koffja/Beanlens/docs/hardware/revision-v4.11/README.md

# BeanLens V4.11：MVP对射与电源选型、连续PP槽体

2026-10-17。用户确认：**前壁连续，铝闸片从后方关闭，闭合前缘进入前壁内侧承接槽**。本次在V4.10机械方案上改用DFRobot SEN0503对射和YU2405主适配器；保留5V侧TPS5450候选与6V侧UBEC5A/6V。它是样机结构方案，尚未实物或电气验收。

## 文件与版本

- [六页图和闸片开合演示](beanlens-hopper-gate-v4.11.html)：固定、板厚、连续前壁/槽内刷、TPS比较、接线拓扑。
- [采购表](../procurement-v4.11/beanlens-procurement-v4.11.html) / [改动物料尺寸](changed-cuts-v4.11.csv) / [结构数据](design-v4.11.json)。
- [六页A3图册](../../../output/pdf/beanlens-hopper-gate-v4.11-20261017.pdf)。
- 原V4.8机架、9木板与双屏位置不变。V4.9四片主斗外面尺寸、Z440上口和Z298.3底口不变；新增刷孔/分道片，旧V4.8八片模板仍不可混用。V4.9的POM下座被本版PP连续槽体主方案替换。

## 本次MVP选型（2026-10-17）

- **PH01改DFRobot SEN0503，50cm对射，一组收发对**。原厂3–5V，50cm是在5V下的距离，3.3V下标称20cm；本机取5V供电。外形20×10×9、线250mm、响应约2ms。国内官方商城参考15元/对（检索日2026-10-17），不是用户成交价。
- 输出原厂写NPN常开；没有完整内部输出图和本机实测，**遮挡有效电平暂记null**，不能照搬原2167的遮挡LOW。按NPN下拉接口拟定10k上拉3.3V、1k串GPIO20；先断开GPIO，测A节点两状态，确认在3.3V输入域并记录极性后再接板。若出现5V，停止接板、核查实际输出，1k不是降压器。
- **A07改YU2405，24V/5A/120W**，按用户指定为MVP主方案。厂牌、批次、插头/极性、交流入口/线是否随附、认证与保护实效尚无对应实物资料。不同卖家的同名型号不能互相替代证明，不把航嘉/明纬资料套到YU2405；不填虚构尺寸、证书或价格。5.5×2.5mm仅作P03母座候选，实际核后配。
- 不扩大工作范围：5V TPS5450整板仍待SKU，6V舵机仍为UBEC5A/6V；功率预算持续56.5W/短峰71.5W是按原负载和保守效率计算，24V容量相同所以数值不变，不等于YU2405已试载。
- 机械仍沿用V4.10，SEN0503头部外形资料更新；安装朝向/光轴、支架孔位与Z277光束仍需实物。不能仅按9mm厚度宣称光电/侧封片无干涉。
- 图6补逐线连接，图5更新主适配器和传感器标注。原Adafruit/Huntkey只留历史，不列当前主采购。

### TB端子对应

TB-A的1/2/3分别给灯、5V降压、6V UBEC正输入，各经过对应保险；3位桥只连1–2–3。4/5/6是其返回端，另一段3位桥只连4–5–6。TB-B的1=5V+、2=5V返回、3=6V+、4=6V返回、5/6空，不装桥。相邻格本来不通，同一格上下螺钉才通；不能6位整条短接。C6信号地共参考，舵机大电流仍从独立6V返回，不能经过C6板针。

## TPS5450是否比XL4016合理

**优先审核TPS5450成品板是合理的，不能只按芯片名字直接定型。** TPS5450推荐5.5–36V、芯片5A连续/6A峰值、500kHz，原厂明确软启动、欠压、过流、过压及过温保护。XL4016现行Rev1.6推荐8–36V、180kHz，列12A芯片能力及过流/短路/过温等。两者40V都是绝对上限，不是允许长期工作电压。TPS5450不是因为型号而自动具备更大输出电流，500kHz也不等于实际板的纹波必然更低。

逻辑侧需要24→5V、4A连续预算；TPS5450芯片理论范围覆盖，整板温升和压降必须过关。**舵机侧已由用户确认用UBEC5A/6V，不再列TPS5450为主方案。** 推荐可核原厂型号：好盈HOBBYWING UBEC5A / 30607000 / 2–8S版，50×17×10mm，原厂标称持续5A，设置6.0V。24V在2–8S锂电池对应电压范围内；核所购标签一致，不能换成仅支持2–3S的同名BEC。实际负载仍按6V/3A持续目标、5A短峰预算验收，不因原厂15A瞬间标称提高本机预算。TPS的5A能力不能替代外置二极管、电感、电容、铜皮与PowerPAD散热焊接的设计。按TI简化公式及典型0.11Ω导通参数，24→5V/4A芯片损耗约1.57W，尚未算外部损耗；小板密闭安装不能套用参考板热阻。计算为4²×0.11×5/24 +24×4×0.01 +24×0.01≈1.57W，不是实测。

TPS的OVP主要通过关闭高侧开关限制正常调节过程的过冲；如果功率开关本身短路，它不是一道独立断开故障电压的屏障。不能承诺“TPS一定不烧主板”。两个方案都是非隔离降压。反接保护、保险、接地与接口区分按整板和外部接线检查。没有模块原理图、完整型号和测试数据前，A08标为**5V TPS5450优选候选/暂缓整板定型**；A17主方案改为**UBEC5A/6V，好盈30607000候选**；XL4016另列备选。主适配器按本次MVP改YU2405，24V容量与保险（主4A、灯2A、5V输入2A、6V输入3A）、分路返回与信号电压不变。

采购询问模板（仅5V逻辑板）：需要成品TPS5450模块一块，输入24V，输出5.00V、4A连续预算；请提供整板品牌/SKU、输出设定方式、尺寸与孔位、24V输入工况温升及纹波、负载阶跃、芯片来源和保护说明。不要购买裸TPS5450DDA芯片代替模块。新电源总价待5V板及UBEC报价，旧200–370估价不直接沿用。

UBEC接法：TB-A 3经3A输入保险 → UBEC IN+；TB-A 6 → UBEC IN−。UBEC OUT+/OUT− → TB-B 3/4 → 舵机6V/GND；舵机PWM仍来自C6 GPIO2。先断电，按原厂说明把远离电容的两插针用跳帽设为6.0V，上电实测再接舵机；此跳帽位置只适用该好盈型号，其他型号不能照抄。不得选7.4V；UBEC输出插头是供电，不是PWM，不能接GPIO或5V主板电源。原厂线径与插头额定另外核对，新增0.75mm²线段不能证明原线/触点已能承载全5A；不要用杜邦线作舵机电源转接。

UBEC具有过流、输出短路及过温保护，金属罩有助散热/降低干扰；保护恢复会重新供电，不等于硬件急停或保证关闸。仍与称重/相机线分开布线，按空载舵机、带载压降/温升与实际动作测试验收。原厂5A与15A分别为持续/瞬间标称，不是用户这只MG996R的实测电流。

## 料斗到底如何固定

四只F13金属角片先用M5/T螺母锁在顶框内侧槽。顶PP3托环外形176×196、136方孔，位置X22/Y22/Z440；PP2斗的四边顶端与托环下侧焊为一体。将整组从上方放到四托片上，托环底Z440，顶Z443；再用4颗M3×12、φ9大垫片和螺母固定，另2套备用。

四支承为25×25×2角铝裁宽20，竖外脚22、横外脚14；全局支承起点(20,75,438)/(20,145,438)/(186,75,438)/(186,145,438)。PP长孔中心(28.5,85)/(28.5,155)/(191.5,85)/(191.5,155)，孔3.5×7沿X。根部圆角按实物检查，PP支点处局部2×2倒角沿20长避R仅是候选修配，不能任意削薄大面积。

受力：上斗 → PP焊缝 → PP3托环 → 四金属托片 → M5/T螺母 → 黑2020；下方固定槽体还由G21接G11定位，不能假定所有重量只走顶托环。先把下槽盒/导轨共用底座装平，再让顶环坐实并锁紧，不能用上下螺钉硬拉焊件找平。托片竖脚M5孔建议5.5×8竖长孔，孔中心相对竖脚底12mm（名义Z450），约±1.25mm调节；M5加φ12大垫片，4用2备，按实物槽型核螺钉长度。木板不是料斗承力支座。PP2与PP3厚薄焊先试片；托环平整、焊缝拉脱、长期蠕变与托片单螺钉转动需静载验证。1kg为原载荷目标，不等于现有约1.22L料斗能装1kg生豆；用实际豆样验证容量，不能用板厚代替容量计算。

## “法向板厚”是什么

“法向”只是**垂直于板面**的方向。2mm PP板就是卡尺夹住两面读到2mm。板斜放后，从机器水平方向横着量，两面的截距会大于2mm；本斗前后壁约2.183mm。板没有变厚，只是量的方向变了。外口尺寸用实际板厚换算，不能在内口每边任意加2mm就把斜壁外形算对。图中的示意线加粗不代表购买更厚板。

## 为什么原来用了POM；现在改哪里

POM有较好的滑动、耐磨、刚性和加工稳定性，原来作为可拆滑座有理由。10mm指一块板沿落豆方向的厚度，5个14×12孔贯通这10mm，不是每槽宽10mm。厚板让孔缘有支承、容易加工，不等于更容易逐粒送料；原方案没有充分安排刷排。

连续焊接前壁优先采用PP-H固定槽体：上座仍PP6 140×30，下座改PP10 140×24，前脸均Y105，孔起点局部Y9。下座后端Y129，保持不碰从Y132起的导轨。两端隔距条10×24×2.3；前封片140×18.3×2位于Y103–105，跨过Z280–298.3；两侧封片32×15.3×2位于X38–40和180–182，Z283–298.3；底边高于原光电头名义顶Z282，仍按实物留间隙。固定件焊成前面/两侧连续的U形封闭体，只向后留闸片进出口。

关闭时闸片前缘Y112.5，进入Y105–114的前承接位，覆盖孔前缘1.5mm；打开时前缘Y127.5，退过孔尾126再多1.5mm。整片前缘同时横跨5槽。不能靠撞前壁当限位。闸片Z290–292，闸缝Z290–292.3，名义总隙0.3；按实物厚度和平整度试配。焊接固定件时闸片、滑轨和PBT都拆下，用量规控制间隙，冷却后才装。薄PP封片焊到PP10须先练厚薄件，防薄壁烧穿和上座翘曲。

PP滑动/磨损性能不能直接按POM算；先手推测阻，再空载舵机。手推不顺先修平整和间隙，不加大舵机力。POM保留为另一个可拆螺接槽盒版本备选，不能热风焊进当前PP框替换。固定槽体整体焊接后，可从后方退闸片清理孔与前盲承接位；若积屑不能彻底清除，应改为可拆槽盒再带豆联调。

## PBT刷：在闸片上方的五槽入口安装

保留原主斗形状，在斗底内加4片PP3短分道片，Z298.3–318.3，YZ面梯形上深29.502/下深12/高20，X厚3，起点X83/100/117/134。下端分别焊在五孔上座的4条肋上，前后端配斜斗面。这样五槽入口向上延伸20mm，不缩短主斗；上方外侧两槽随斗面略张开，孔口仍为14×12。

每槽前后各一段PBT，共10段；从原“左右塞进薄隔肋”的含糊表述改为**前后两排刷盒**。基条候选PP12×6×3，毛簇有效宽10，PBT丝径0.10–0.15，自由毛长14mm，向水平下方30°。毛根Z315，毛尖Z308，距闸缝顶约15.7mm。毛尖在各自Z高度的斜斗内面侵入先取1.5mm，不是把14mm毛长全塞进12mm孔深。

初始前毛根Y约99.13、后毛根Y约140.87，前后可调±2mm。前后斗面各5个11×4圆角毛槽，中心X76/93/110/127/144，装机中心Z310；4mm按斜面量。毛束实际散开、角度、PP厚度和焊筋需要样件修孔，不能凭尺寸直接批量开孔。圆角去毛刺，检查来回摩擦不刮断PBT。不能把裸毛直接粘在PP上或对着已安装刷毛热焊。

两条PP3载条110×10、两条PP2压条110×8夹持成品植毛小段，段间及两端设12块4×6×3 PP垫块（每排6），压条开5个11×3出毛窗；窗心X同毛簇，Z约314.4，孔口去毛刺，不夹死毛根。载条在基条背面，压条在出毛面；14mm毛长包含经窗穿出的部分。每排6个M2候选夹持点X59/84.5/101.5/118.5/135.5/161；M2×12起点，12用4备，实量堆叠后定。4只外置PP小托架给前后调节。刷盒外侧加可拆PP防豆背罩，候选包络110×20×16每排一只，按斜面纸样配形；螺母、端头、可能的植毛锚固均在豆路外且封闭。刷盒和盖的孔位不是已冻结加工图，先询价成品样刷再定。

先无刷通过豆样，再逐步加刷验证；取低侵入量，观察正常豆、碎豆、灰屑是否架桥、脱毛或增加破损。关闸扫过的平面不能碰到任何PBT毛尖。刷子不保证单豆分离，不能据此推导计数准确率或五槽吞吐量。

## 验证边界

本包有尺寸和几何一致性检查、网页与PDF排版检查，未做负载、焊接、脱毛、带豆、称重或光学实测。G10球头耳实际高度、G20后退片罩与后刷盒的窗口及全行程仍需纸样/实物联合试配；不要把简单方罩直接扣在球头上。原IR光束Z277与脚座避让仍未验收；此次刷排位于Z308以上，不以随意下移光电来腾位置。仍按无执行器→空载→单槽→五槽顺序验收，卡豆超时不持续加力。

## 原厂资料

- [TI TPS5450，Rev.E](https://www.ti.com/lit/ds/symlink/tps5450.pdf)：5A/6A、保护、布局及损耗简化公式；不是淘宝整板证明。
- [XLSEMI XL4016，Rev1.6](https://www.xlsemi.com/datasheet/XL4016-EN.pdf)：推荐8–36V、180kHz、芯片12A条目；整板另验。
- [好盈UBEC5A原厂中文说明书](https://oss.hobbywing.com/pdf/pdfcn/UBEC5Acn.pdf)：2–8S、5/6/7.4V设置、持续5A及保护；本机选6V档。
- [Ensinger材料目录](https://www.ensingerplastics.com/-/media/Ensinger/Files/Document%20Teaser%20Files/Brochures/Shapes/Stock%20Shapes-catalog-en-2024)：POM滑动、耐磨和加工特性。所购PP/POM/PBT的食品接触资料必须对应具体牌号，不能由材料简称推定。
