koffja/Beanlens/docs/hardware/PROCUREMENT-AUDIT-20261012.md

# V4.5采购核查与计算修订

2026-10-12。已核查原V4.4的35项采购记录，拆分为83项可查物料/备选；不是83项全部要买。当前状态仍是拟定选型，未采购、加工或实物验收。

主入口：[可筛选采购表](procurement-v4.5/beanlens-procurement-v4.5.html) · [CSV](procurement-v4.5/beanlens-bom-v4.5.csv) · [JSON数据源](procurement-v4.5/beanlens-bom-v4.5.json)。页面末尾有旧35项逐项处理与新编号对照。只改JSON，再运行同目录生成器即可同步HTML/CSV。

## 本次明确的修正

- 原对射器记录为用户提供的山大斯 **B3F-20C1**，不猜其输出。主方案推荐 **Adafruit 2167**，5V供电、10kΩ信号上拉3.3V；工业光耦路径列为互斥备选。详见[对射说明](BEAM-SENSOR-20261012.md)。
- 相机记录为用户提供的 **GC2093-M12-90度无畸变**。这还不是已核对的PCB完整料号；BOX兼容性、排线针数/方向、90°定义、近焦及IR-cut需确认，不能随意补一个排线型号。
- 称重候选改为 **Autoda HJ-AZ4-3kg、103元**。输出类型、内部敏感元件和包装内支架/平台未知，保留用户型号，不用猜测代替图纸。旧55元裸件/105元带架报价由此替代。
- 旧B09“薄POM闸片/M3连杆”改为2mm铝闸片、M4双球头、双导轨与封闭槽盒。**新增120×30×3mm滑架转接板**：10×10角铝的10mm脚宽无法覆盖MGN9H参考16mm前后孔距，不能独自完成滑块安装。角铝保留为加强及闸片连接件。
- 旧配电、灯罩、支架、限位、滤波和紧固件打包行拆开。给出实际厂商型号或可采购的材料/尺寸标准；PCB孔位、灯带SKU等未知项明确暂缓，避免“补齐型号”反而买错。

## 闸门复算

### 运动几何

舵臂半径r=16mm、球心距L=60mm。居中共面机构的滑块坐标为：

`b(θ)=r·sinθ+sqrt(L²−r²·cos²θ)`。

端点取±asin(15/32)=**±27.9531869°**，两端sqrt项相同，因此行程恰为15mm。总相对转角55.906°；这不是舵机PWM的绝对命令角。12mm净豆路＋关端1.5mm覆盖＋开端1.5mm退让＝15mm。槽深、防漏间隙及退片袋仍需纸样定型。

两只球头的球心至螺纹入口暂按h=24.4mm、30mm牙条：L=2h+30−2e，调到L60得到**每端旋入e=9.4mm、外露11.2mm**；小于参考13mm螺纹深。两个普通M4六角并紧螺母约需6.4mm，名义可容纳。网页标题24.1与图24.4不同，实际以收到批次量测，不能把60mm球心距误买成60mm牙条。

MGN9H参考长39.9mm；15mm行程、两端各10mm端部余量，最低几何轨长39.9+15+20=**74.9mm**，选择100mm。滑块孔距参考15×16mm、每块四孔，两轨各一块，勿重复另买两块。120×30×3mm转接毛坯可覆盖孔阵列，轨中心距约90mm起试。具体端孔、螺纹深、螺钉啮合与润滑隔离按供货图核验。

### 1kg装豆与板材

按全部1kg豆形成约9.81N竖向静载，闸片110×45×2mm，密度2700kg/m³、弹性模量70GPa（沿用配件文材料参考值）。把110mm跨度简化成宽45mm、厚2mm简支梁，I=bt³/12=30mm⁴：均布载荷挠度约**0.081mm**；跨中集中梁载挠度约**0.130mm**、名义弯曲应力约**9.0MPa**。板自重约**26.73g**。

这是名义梁模型，未计孔、装配翘曲、局部豆接触、动态冲击与夹豆。它支持“2mm铝板作首样候选”，不能作为整机承重合格证明。固定槽盒与POM支承框承担竖向支承，滑架约束偏摆；舵机、球头和牙条负责水平推拉，不悬吊料斗。总豆重乘摩擦系数不能代表夹豆推力，亦不能用MG996R堵转扭矩证明关闸一定成功。

MG996R先保留，50Hz下逐步改变目标脉宽，关闸2–4秒作为试样起点。更换高扭矩舵机仍不能解决左右偏摆或夹豆。若样机需要可确认的位置与阻力控制，再评估带反馈、限流的直线执行器；单用更强舵机可能更容易夹坏豆。详见[槽内缓关说明](GATE-ENCLOSED-SLOW-CLOSE-20261012.md)。

## 称重与电源纠错

[Zemic L6J1原厂表](https://www.zemiceurope.com/media/Documentation/L6J1_Datasheet.pdf)为0.9±0.1mV/V、推荐激励5–10V，C2综合误差±0.028%FS。1kg对应±0.28g，不能直接保证本项目净0–500g±0.1g目标；也不能把旧2mV/V、3V示例套此型号。NAU7802的24位只是转换分辨率，不是秤的误差证明。

当前拟定3.3V供电、内部VDDA约3.0V的ADC路径与L6J1推荐激励不一致，暂停把两件当作已匹配采购组合。也不要自行给桥接5V：必须同时核对ADC输入范围、参考和模块原理图。HJ-AZ4若是数字称重组件，可能不需要NAU7802；若是裸桥则还需核输出与激励，暂不重复下单。

料斗1kg装豆量、原称台1kg**毛载荷**、净500g误差验收是三个数。1kg豆＋平台/盒会超过1kg传感器额定容量。若改3kg称台，可容纳这部分重量但不能沿用1kg灵敏度或±0.1g结论；一次收1kg也超出当前净500g验收范围。暂按分批收集，容量和精度选择待组件资料确定。

170×180×2mm铝活动台板名义165.24g，若活动件总目标≤250g，只留约84.8g给盒与连接件，实物须称。参考砝码补100/200/50/500g四件，350g由前三件的校准质量组合，组合参考不确定度建议≤0.03g；不能用待测秤给砝码自证质量。

电源候选具体化为GST120A24-P1M（24V5A120W）、Pololu D36V50F5（#4091，5V）与D36V50F6（#4092，6V）。功率预算仍为灯8W＋传感器预留1W＋20W/0.85＋18W/0.85＝**53.7W**；舵机短时5A时约**67.8W**。2167在5V支路内，1W另保留作保守余量，不重复声称实际耗电。模块持续电流受输入压差、散热影响，4A/3A/短时5A目标未测；120W适配器不证明下游模块达标。

## 采购和加工顺序

1. 先买/核验板卡、相机、舵机及参考标准件，收到后量花键、球头、导轨孔位和排线。
2. 用1:1纸样摆放五槽、转接板、两轨、连杆、舵机支架，同时核后摄视锥。槽宽合计5×14=70mm，四隔板若3mm另占12mm，外宽110mm剩28mm分配侧壁/结构区；旧6mm两侧边不能直接闭合此尺寸链。
3. 纸样通过后加工毛坯轮廓、槽缝与孔位。板材尺寸是毛坯，不是最终开孔图；导轨底座不能整片挡住落豆口，封闭退片袋须留可拆清洁结构。
4. 手推全行程应顺滑，再空载舵机、单槽带豆、五槽联调。验证1kg载荷变形、缓关卡豆、限位超时及失联撤销送料，记录证据。无法顺滑则先调平行/支承，不能用舵机硬拉矫正。

型材18段净长合计4.4m，未含锯缝/损耗。紧固件数量为首样估量，孔位冻结后再核。

## 金额与版本

只保留三项用户已报价：BOX257元＋两套相机114.32元＋MG996R15.58元＝**386.90元**，不表示已经付款或收货。Autoda候选103元另列；若最终选它，已知报价合计489.90元，仍缺大量报价。

旧790.90元混合了旧打包规划额度，**不作为新方案总价**。未知价格保持空值，不能当0元；也未按海外美元报价折算人民币。新增导轨、加工、转接板、封闭槽盒、运费工具等均需询价，因此新总价未确定。

旧PDF、独立SVG/PNG、V4.4 BOM和ZIP保留为历史快照；当前手册、基线、动画与V4.5采购入口已同步新增决定，不能按旧图直接下单加工。

## 本次文档检查

已检查83行JSON/CSV一致、35项旧表映射、报价小计、计算复算和本地链接；浏览器验证采购搜索/筛选/重置、手机横向滚动、手册主题/组装勾选/图纸放大、动画开关端点/恒定杆长/模拟故障。结果见[验证记录](procurement-v4.5/validation-20261012.json)。这是文档与浏览器检查，没有上板、加工或带豆验收。

## 2026-10-13 装配图增量

原83项记录是2026-10-12快照，当前新增F08后为84项。装配图保留18段/4.40m型材与一张600方海洋板，补F02为28角码使用、32购买含备；F03有净裁切排版、托耳修为40×30×6；F06明确三片托板毛坯；F07明确遮光底板；G08轨距94为布局提案。新增F08面板/托耳穿板螺钉及小角片，详见[图册与说明](assembly-v4.5/README.md)。旧验证记录仅覆盖记录时的旧字节，新图检查另留记录。
