koffja/Beanlens/docs/hardware/frame-v4.6/IMAGE-PROMPT-BLACK.md

# 黑色欧标效果图生成记录

2026-10-15，内置 image_gen。结构参考是由同一套坐标生成的[成品/裸框对照](black-frame-comparison-v4.6.svg)，不再使用原银色概念图作为比例依据。

输出：[黑色外观参考](beanlens-frame-v4.6-black-concept.png)。AI图用于材料与外观，准确尺寸、料斗高度及梁数由共享模型和尺寸图控制。旧银色图保留为历史参考，当前页面已撤下。

```text
Use case: sketch-to-render / industrial product mockup. The attached engineering comparison is the STRUCTURAL AUTHORITY, not a loose style reference. Create a refined studio 3D materials rendering of these exact TWO views side-by-side: left the assembled BeanLens device, right its bare extrusion frame. CRITICAL: preserve the same camera, identical model scale, overall silhouettes, vertical beam levels, and top/bottom alignment from the reference. Do not independently resize the two machines. This image is intended to correct a previous image whose paired views were inconsistent.

Geometry in millimeters: outer frame220 wide240 deep460 high, four UNINTERRUPTED black anodized European2020 T-slot vertical posts fromZ0 to460. Top horizontal rails Z440..460, bottom railsZ0..20, intermediate hopper frameZ304..324, two camera support crossbarsZ221.25..241.25.18 extrusion members exactly. Black compact standard INTERNAL90degree L brackets only, not corner cubes. Frame-only view must show these same exact rail heights and should keep a subtle amber dashed transparent box marking the hopper footprint154×154 and its height110 fromZ330 to440 (this box is a reference outline, not extra beams). Hopper support relation: midbeam top324 +6mm plywood ears =hopperbottom330, hopperheight110 =top440, then20mm upper extrusion reaches460. Do not show a hopper130/150mm tall or an enlarged top compartment. Both left and right show the same Z440 and Z324 locations.

Assembled machine: follow the reference's actual exterior6mm marine plywood panel construction. ONE uninterrupted pale birch front fascia fromZ200 to440 and ONE right panel same heights; these exterior panels overlay the front/right post faces in that height region. NO invented horizontal black bar across the front wooden fascia at midframe height: that midbeam is INSIDE behind the panel. Do not invent a separate upper wooden band or taller hopper. The154mm square wood hopper is inset within the outer frame, PP liner top opening140 square atZ440, leaving small gaps around the hopper. Small amount of green coffee beans only inside white PP liner; do not fill entire220×240 frame top with beans. Small black2.4inch front screen case64mmwide centered atZ370, two16mm round silver buttons centeredZ310, small side black status display. Lower open bay has translucent PP collection bin160×170×125 atZ45 on a thin independently supported metal weighing plate; no bathroom scale. Four very short black rubber feet outside the460mm frame height may be shown; match both views. Fine black T-slot channels visible, natural pale plywood grain, accurate fitted appearance, warm-neutral off-white studio background. Realistic engineering product rendering, similar orthographic isometric projection as reference, not dramatic perspective. Minimal labels only 'BeanLens' and 'V4.6 / BLACK2020'. Preserve background whitespace and machine size/alignment of reference. No dimensions added or fake measurement readouts. No image reference title/footer text needs to be reproduced.
```
