koffja/Beanlens/docs/handoff/HANDOFF-20261012.md

> **2026-10-22增量：H3-P4打印件整机装配**。新增`docs/hardware/hackathon-h3/assembly-p4/`整机组装／爆炸／14连接特写、10页A3 PDF、78行BOM／采购／紧固／裁切／孔位CSV、18份1:1 SVG、机械参考STEP和独立P4基线。9打印实体及P3切片不变；顶环／底板用平片，底板Z22，屏承板Y20，角铝分别连接木板／柱槽；保留P2后梁与承托避让窗。前U片贴盖外缘，去旧上PP管；遮光片开木条槽，右侧／后背景避舵机。13段型材库存足够，M3总79／M5总60，M2相机／开关另列；原料、加工子件和备件不重购。425旧文件哈希保留，未改固件、训练、用户Excel或提交推送。当前比赛机械优先P4，电气GPIO／供电沿用H3；实物孔、承载、限位和双摄仍未验收。

> **2026-10-22增量：H3拓竹专用打印P3**。用户确认A1／X2D／X1 Carbon／P2S／H2D，0.4mm标准喷嘴、Bambu PETG HF、纹理PEI。新增`printing-bambu-p3/`离线选盘总览、30个实际切片`.gcode.3mf`（5机型×6盘）、排产／估时／用料CSV、配置／源与日志、原P1/P2 ZIP。9主件＋试片尺寸不变，优化摆盘、5–6墙、速度／10mm³/s流量、下斗外侧贴合普通支撑、舵机架承梁支撑；00先试配，分机交叉试插。Studio 02.08.02.61主机检查，未实际打印／目标固件验证，也未发送或启动设备。P1/P2共148文件哈希保留；P2承托片／铝板／后横梁装配修订仍必需；未动固件、训练环境或提交推送。

> **2026-10-22增量：H3-P2支架打印与装配修订**。新增`docs/hardware/hackathon-h3/printing-p2/`：舵机架、双摄座、开关限位座5件＋小旗片1件，STL/3MF/STEP、CAD源、1:1孔图、采购修配差异与离线3D预览。实体检查发现旧铝板碰后立柱、旧承托片穿舵机；P2将60方铝板移至X153/Y159，承托片改PP3 68×80并开20×30移动紧固件窗，新增180mm黑2020后横梁（可裁库存400余料），后闸盒螺栓候选M3×25。舵机轴心与双摄光轴不变；旗片替换旧件，SS-01GL按原厂9.5孔距配M2。实物舵机耳孔／PCB孔距／开关触发仍待纸样与手动实配；CAD检查不代表实打／承载。H3/P1原件保留，未动固件、训练环境、用户bringup或提交推送。

> **2026-10-22增量：H3-P1漏斗打印文件**。用户要求上/下漏斗3D打印，确认平台220×220mm或更大。新增`docs/hardware/hackathon-h3/printing-p1/`：上斗身、上接座、下接豆斗3件STL/3MF/STEP，试配片、参数化CadQuery源、装配STEP与预览/ZIP。保留原H3滑闸、下短管及相机位置；P1仅新增可拆安装，见README孔位/紧固件差异。仅主机CAD/网格检查，未实打；CAD依赖安装在/tmp独立环境，未动用户训练环境/固件或PP焊接版原件。

> **2026-10-21增量：H3恢复原豆路**。用户否定H2上下摄透片方向，要求顶入豆、水平相向双摄，只简化五槽和闸门。新增`docs/hardware/hackathon-h3/`独立拟真运行/整机/拆解HTML、剖面、36组BOM/差异/裁切、接线、`config/hardware-hackathon-h3.json`。单槽铝抽拉闸29.4×82×2，R16单舵臂＋50mm球心距双球头杆；仍人工单颗，先采集再开闸，下方落豆窗抓拍。短曝光/双流/漏拍/配对均待实机；本轮只改设计资料。H1/H2/完整版保留，用户firmware/k230d/bringup不动。入口与验收见H3 README，旧PDF不称H3图册。

> **2026-10-21 增量：双摄比赛版H2**：用户要求另给双摄版本，新增 `docs/hardware/hackathon-h2/`（拟真离线HTML/GIF、中线光路剖面、接线SVG、34组BOM/16组差异、裁切表、设计数据）及独立H2基线。保留单槽/人工单颗/静拍/BOX控制MG996R，无C6/称重/IR/PBT/第二屏。PP短导豆口＋可拆7101玻璃托片，上下垂直两摄，工作板/PP底座开窗；出口后接豆斜槽与防撞片避开下摄。静止先A后B绑定一颗cycle_id，不宣称同步或全表面。型材仍足够，灯2增4，49.25W持续/64.25W短峰为预算。20项设计/18项浏览器检查通过，H1及完整版字节保留；真实透片成像、像素密度、双CSI运行/内存/配对模型/机械/供电未验。没有改固件、训练、用户bringup或提交推送。

> **2026-10-21 增量：H1拟真教学动画**：新增 `docs/hardware/hackathon-h1/beanlens-realistic-h1.html`（离线单文件）与 `realistic/` 源文件，按可辨认外形重建MG996R、25T直臂、PP槽/挡片、GC2093、BOX、黑2020及木平台；有特写/整机/分件、时间轴与动画预览。外形不是厂商CAD，关限位示意移到舵机侧避开ROI，转接板叠放及垫片示意避免重合；这些孔位/触发接触仍待实配，未更新旧加工图或采购项。预设分类/时长不代表实机，未改固件或用户bringup，未提交推送。

> **2026-10-19 增量：比赛精简版H1**：用户确认单摄/单槽/单K230D BOX，人工逐颗、停豆拍照、MG996R开闸放走。另建`docs/hardware/hackathon-h1/`：30组精简BOM/CSV、裁切表、50对象交互爆炸、6页接线/尺寸PDF及HTML流程动画。采用短固定PP斜槽＋轻侧摆挡片，删长滑闸/导轨/球头杆；无C6/称重/IR/PBT/第二屏/网络。新`config/hardware-hackathon-h1.json`从BOX原理图核候选GPIO25/PWM5（J10-1）、GPIO24/23限位、GPIO22经NPN控AHCT125使能；KEY0/1为34/35。供电保留YU2405/TPS5V候选/UBEC6V，5V单向缓冲与舵机独立回流。完整版目录/基线保留原样；新用户`firmware/k230d/bringup/`未修改。资料与模拟不代表模型上板、固件或机械验收；未提交推送。先做固定ROI真实kmodel推理，再空载与10次手投循环。

> **2026-10-17 增量 V4.12（当前整机入口）**：新增`docs/hardware/assembly-v4.12/`整机组装/爆炸109对象、12页A3 PDF、型材/木板CSV与完整流程`beanlens-operation-v4.12.html`。整机移除V4.8旧小过渡斗/双法兰/叠片，集成V4.11连续PP/PBT、SEN0503、机外YU2405及低压配电盒；双屏固定/9木板/黑框保留。双屏净空用连续斗重算前15.44/侧14.44名义mm。BOM仍V4.11共114项，无新增采购。流程含握手/人工放盒去皮/有限GRANT/开闸/双摄配对去重/缓关/尾流/静态称重/本地记录及停止、卡豆、失联未完成分支；示例24颗/4.8g和时长不代表实测。旧整机入口加最新链接；未修改固件、用户Excel或厂商原件，未提交推送。

> **2026-10-17 增量 V4.11（优先于下文旧选型）**：用户为MVP指定DFRobot 50cm对射，核对为SEN0503（50cm@5V/20cm@3.3V），主电源改YU2405 24V5A/120W。新版[六页图/接线](../hardware/revision-v4.11/beanlens-hopper-gate-v4.11.html)、[114项BOM](../hardware/procurement-v4.11/beanlens-procurement-v4.11.html)及CSV/A3 PDF已更新；基线、对射指南、BRINGUP同步。SEN0503供5V，拟10k上拉3.3V/1k串GPIO20；遮挡电平暂null，先断开GPIO测两状态，不能沿用2167的LOW。YU2405厂牌/插头/极性/随附AC线待实物，不套航嘉认证/尺寸。5V TPS整板候选、6V UBEC5A/6V及原机械/框架/双屏保留；未电气或实物验收，未提交/推送。

> **2026-10-16 增量 V4.10（优先于下文V4.9）**：用户确认“前壁连续、闸片从后方关闭”，并重申6V舵机已选UBEC5A/6V。已新增 `docs/hardware/revision-v4.10/beanlens-hopper-gate-v4.10.html` 五页图/开合演示、README/数据/改动CSV，`procurement-v4.10` 114项BOM与A3图册。顶部PP3环坐4只F13金属角片锁黑2020。PP6上座保留，PP10下座140×24/Y105–129，加PP2前封片140×18.3、两侧32×15.3/Z283起，固定焊成连续U槽，前缘闭合覆盖1.5。主斗外形不变，4片PP3分道向上延20；前后10段PBT毛长14/向下30°初试，毛尖Z308距闸缝15.7，外置可拆夹盒/出毛窗/防豆罩，先样刷再定孔。5V TPS5450整板仍待SKU；6V推荐可核好盈UBEC5A 30607000/2–8S/跳帽6.0V，原厂持续5A，不扩大本机3A持续/5A短峰预算。所有连接/焊接/脱毛/温升未实测；G10/G20/后刷盒窗口和光束/底脚仍需试配。机架/木板/双屏沿用V4.8，未提交/推送，用户Excel不改。

> **2026-10-16 增量 V4.9**：用户要求电源便宜易购、给出电力接线图，并简化PP叠片/双法兰。已新增 `docs/hardware/revision-v4.9/beanlens-power-and-feed-v4.9.html`（四页可放大接线/端子/连续斗/电源盒）、同目录README与数据、`procurement-v4.9` 107项BOM、`output/pdf/beanlens-power-and-feed-v4.9-20261016.pdf`。航嘉HKA12024050-7B 24V5A＋两XL4016 CC/CV（5V/6V），TB1506两条，独立200×150×80低压盒；原进口电源件保留备选。PP2四片连续斗内136方→82×12/H141.7，焊PP6上座；POM10下座140×18，可拆闸片2mm/间隙2.3/行程15。取消中间双法兰和PP五窗叠层。框架、9木片、双屏位置沿用V4.8，旧PP模板不可混用。前/侧名义净空15.4/14.4（含外焊筋横向4）。未实物验收；G10/G20/光束Z277避让、CNC/PP焊接、模块整板SKU/热性能/线端压降仍待试配。V4.9是替换包，没有重画完整十页整机图。电源估价约200–370非报价，不含工具/运费/可选风扇。未提交/推送；用户Excel保留。

# BeanLens 双板固件开发交接

日期：2026-10-12（Asia/Shanghai）。用户指定新项目根目录`~/Projects/Beanlens`，要求把之前规划放到这里并准备K230D BOX与ESP32-C6两套固件。本交接按用户指定保存在项目内。

## 下一会话先做什么

先读根`AGENTS.md`和`docs/README.md`。硬件设计、尺寸、采购、流程与信息流都已在`docs/hardware/v4.4/`，不要重新从头选题或重复整套研究。分阶段开发按`docs/firmware/BRINGUP.md`推进。

本次只配置文档和目录入口；没有写产品固件、安装ESP-IDF、升级环境、刷机或发起新训练。用户尚未指定串口设备或确认实机固件版本。

## 会话形成的方向

- 主题确定为豆鉴BeanLens：可复核的咖啡生豆可见瑕疵初筛，与已有杯测项目关联。目标是独立机器运行，不依赖现场电脑。
- 目前采用五槽重力送料、MG996R控制滑闸、短落差前后双摄；刷条与光电不保证逐粒分离/计数，硬同步和稳定五槽吞吐均未实测。
- 两板分工固定：BOX负责视觉、模型、证据和正面主屏；已有C6负责机械、称重、侧面小屏和联网。最新引脚与电气起点见`config/hardware-baseline.json`，全部仍待上板核验。
- YOLO26是用户希望采用的训练方向。分类路径优先，YOLO11n作对照；新版本不自动代表更高实际准确率。
- 视觉结果不替代完整SCA等级或杯测；拒判不能算正常，总质量不能推算每类瑕疵质量。比赛价值以真实问题、运行原型和可复核证据为主，不给无依据获奖概率。

## 最新用户选择与未决项

已选硬件、报价、灯带6000K/Ra98判断、1kg称重目标与旧55/105元Autoda候选曾在V4.4手册/BOM；现以后续V4.5采购增量为准，不在这里重复明细。上一版外伸BOX、堵豆路灰板、低价称重估价已经修正；不能拿V4.3图纸重新实施。

最先消除的未知项：BOX实际CanMV/nncase版本与双摄兼容；C6官方ESP-IDF/显示组件版本；实际灯型号/功率/切点与短曝光；传感器型号、接口、激励和±0.1g验收；舵机PWM门槛、实测电流、限位与失联动作。

## 新目录的既有工作，必须保留

这里不是空项目：用户已经放入数据集、训练脚本、`.venv`、YOLO权重/ONNX、两次训练run及完整正点原子资料盘。详情和观察到的环境版本见`docs/ml/TRAINING-BASELINE.md`；厂商资料位置见`docs/README.md`。

两次run各有100行训练结果和best.pt，本次未重算指标，也未证明能部署到KPU。资料盘含CanMV v1.3/nncase2.9.0镜像，但设备当前版本未知。训练环境与转换环境应分开。

## 本次已准备

- 根`AGENTS.md`与两套固件目录规则、README。
- 硬件基线、协议v0.1草案、分阶段验收路线和训练现状。
- V4.4全套文件与历史研究/审查的迁入副本，清单见`MIGRATION-20261012.json`。
- `.gitignore`、`.cbmignore`避免把巨量数据、SDK和产物当作源码。没有初始化Git或提交。

协议草案仍需字段表、测试向量、超时标定与双方实现；不要把GRANT等示例当作已有稳定通信。

## 验证边界

原V4.4验证了网页交互、预算计算、12张图的文本边界、28页手册PDF和12页图纸PDF；不是硬件测试。迁移验证记录见本目录清单。实际固件构建、双摄、KPU、闸门、称重、供电与网络仍待完成。

后续先让两块板各自显示、UART握手与限位模拟，再空载舵机、静态模型对照和单槽；不要一次把模型、五槽、称重和网络全部接入。

## 2026-10-12 后续增量：五槽滑闸

用户提出靠近舵机的槽可能先开合，希望水平同步。核对V4.4后，明确原文字已要求前后平移，但第03图没有完整说明居中推力与防偏转导向。新增建议：[五槽同步滑闸修正](../hardware/GATE-REVISION-20261012.md)：先保留一个MG996R，通过居中连杆推拉后部刚性横梁，左右导向约束整片平移；不把闸片直接固定在舵盘上旋转，不沿槽列左右抽拉。手册第03章及硬件基线已注明建议与待核验状态。原轴高/23mm偏置、±37°与15mm行程须联合复核；未加工、未上板、未验收，未指定替换电机。PDF/PNG/SVG/ZIP及原验证记录仍为旧快照。下一步先做全宽导向手推样板，验证中途偏转，再空载舵机、单槽和五槽。

用户随后补充料斗最多1kg豆量并要求配件型号，新增 [滑闸配件建议](../hardware/GATE-PARTS-20261012.md)：核对25T舵臂、M4双金属球头/30mm牙条组成约60mm球心距短杆，建议2mm6061-T6闸片、后角铝横梁及两套100mm MGN9H导向。原厂参考型号、尺寸图差异和简化挠度计算见该文。16mm力臂改用约±28°相对角起点；未采购、未冻结支架孔位、未验1kg承载/带豆开合，不将1kg装豆量等同原称重系统1kg毛载荷。

## 2026-10-12 后续增量：槽内缓关动画

用户看不懂静态示意，要求HTML/JavaScript动画，明确挡豆位置须在沟槽内、希望缓关。新增[离线动画](../hardware/illustrations/beanlens-gate-motion-20261012.html)与[结构/控制说明](../hardware/GATE-ENCLOSED-SLOW-CLOSE-20261012.md)：16mm曲柄、60mm球心距、15mm平移，俯视与单槽侧剖面同步；后壁窄缝＋封闭退片袋＋前壁接收槽，下方沿用z292至z280约12mm围挡起点。缓关拟由固定50Hz PWM下逐步改变目标实现，2–4秒仅实验范围；慢关不能当作限力或无夹豆保证，真实检测/卸力、上电位置、超时/授权预算和尾流均待验证。动画不连接硬件、未写固件；手册/基线/验收路线同步，旧图及PDF快照未重绘。

## 2026-10-12 后续增量：采购与对射核查

当前采购入口改为[可筛选V4.5采购表](../hardware/procurement-v4.5/beanlens-procurement-v4.5.html)，对应CSV/JSON同目录；旧35项逐项映射到83项（含备选、已有及加工件，不全部购买）。用户补充B3F-20C1、GC2093-M12-90度无畸变、Autoda HJ-AZ4-3kg/103元已录入。确切B3F输出、HJ内部元件/接口及包含支架仍未知，未据型号猜接线。

[对射说明](../hardware/BEAM-SENSOR-20261012.md)建议Adafruit2167低压方案，5V供电、输出10kΩ上拉3.3V至GPIO20路径，无需工业光耦；它仅作豆流提示。工业接口作为互斥备选。闸门新增120×30×3mm转接板，解决10mm角铝脚宽无法覆盖MGN9H前后孔距的问题；动画、手册、配件文和基线已同步。

[复核说明](../hardware/PROCUREMENT-AUDIT-20261012.md)记录15mm/±27.953°、60mm球心距/30mm牙条、1kg载荷挠度和电源复算。旧L6J1为0.9mV/V、推荐5–10V，不按现拟定3V激励默认采购；HJ-3kg有容量余量但精度未验。1kg装豆与1kg毛载荷不能混同。旧790.90不作新总价；三项用户报价386.90，103候选另列，新物料价待询。新表仍需花键/供货图/纸样后冻结孔位，无采购、加工、固件或上板验收；PDF/独立SVG/PNG/ZIP保留历史快照。

本轮文档/浏览器检查见[采购验证记录](../hardware/procurement-v4.5/validation-20261012.json)：83行与35项映射、复算、本地链接、采购筛选/手机、手册交互及更新动画检查通过；不代表实物验收。

## 2026-10-13 后续增量：尺寸爆炸图与组装图

用户要求对照BOM装配铝型材、海洋板和各部件。新增[尺寸图册](../hardware/assembly-v4.5/beanlens-assembly-v4.5.html)、[装配说明](../hardware/assembly-v4.5/README.md)、裁切CSV/布局JSON/七张SVG及[7页A3 PDF](../../output/pdf/beanlens-assembly-v4.5-20261013.pdf)。交互可切换组装/爆炸、分组、隐藏外壳、点零件看BOM；PDF含整机、型材、木板排版、滑闸、光学称重、装配顺序、连接放大图。

18段型材净长4.40m不变；明确T01–T18位置，海洋板600方一张可按3mm间隔提案排10片。布局补料斗中框顶Z324＋托耳6到Z330，托耳由旧约25宽修40宽；外壳P01/P02 220×240、P03/P04 240×240，厚6，下部开放。F02角码28用/32购，新增F08穿板及木壳固定件，当前BOM84项；F06/F07细化托板/遮光底板，G08轨距94提案。主手册、索引和基线已同步，原快照不重绘。

新尺寸均保持拟定/未实物状态：HJ-AZ4外形/孔距/高度未知，PCB、舵机共面高度、视锥/行程净空、槽盒缺口和最终孔位需收到标准件后纸样。未采购、加工、烧录或验硬件。

新装配图文档/几何/浏览器/PDF检查见[验证记录](../hardware/assembly-v4.5/validation-20261013.json)，仅图纸层面通过，未实物验收。

## 2026-10-15 后续增量：可采购连接件与现有型材优化

用户指出旧效果图角部方块无对应可确认四通件，提供已有460mm×7、400mm×2。新增[V4.6机架页面](../hardware/frame-v4.6/beanlens-frame-v4.6.html)及[说明](../hardware/frame-v4.6/README.md)：四根连续460立柱，上下横梁夹柱间，宽深仍220×240、总高460；用常规两孔内角码，不依赖三通/四通块。成品460×4、200×6、180×8，净4480mm；按每刀3mm，现有四根460留整、另三根各切200+200、两根400各切180+180，只补购180成品四根。锯屑30、余料230，逐根配料见CSV/JSON。中框宽梁继续向内缩20，避免改到前面后碰按钮。

内置image_gen生成[新概念效果图](../hardware/frame-v4.6/beanlens-frame-v4.6-concept.png)，另有按数值绘制的尺寸SVG；渲染不作孔位/数量依据。F01/F02、硬件基线、主手册与索引同步；新增F09顶端盖/F10外套橡胶脚套，当前采购86项。角码仍用28/购32，具体螺钉长度与T螺母按用户现有槽型匹配；item槽5套件仅原厂参照，非盲购适配承诺。W06称台固定底板四角约25×25为净空核对区；紧凑角码在梁宽内可不切角，按实物/固定孔决定，不冻结缺口、不改变称台高度硬凑。

V4.5图册及原PDF保留440高历史快照，并标注新入口；木板净尺寸和内部Z高度暂沿用。未采购、切料、实装、承重或验收称重。文档检查见V4.6目录validation-20261015.json；未提交或推送本轮变更。

## 2026-10-15 后续增量：黑色欧标与完整三项交付更新

用户指出AI成品/裸框比例和料斗高度不一致，并确认已有460×7、400×2均为黑色欧标2020。现已用同一份frame-plan-v4.6.json统一18根型材与料斗坐标；中框顶324＋托耳6＝斗底330，斗高110到440，顶框440→460。新增[同尺寸对照](../hardware/frame-v4.6/black-frame-comparison-v4.6.svg)及[黑色外观参考](../hardware/frame-v4.6/beanlens-frame-v4.6-black-concept.png)，精确对照只水平平移750px，两图不分别缩放。AI外观只作材质参考。

用户指定的[交互组装/爆炸HTML](../hardware/assembly-v4.5/beanlens-assembly-v4.5.html)、[7页A3 PDF](../../output/pdf/beanlens-assembly-v4.5-20261013.pdf)、[型材/海洋板CSV](../hardware/assembly-v4.5/cut-list-v4.5.csv)均在原路径更新为V4.6-black，旧文件名为兼容链接；不再把这三项称作440高历史快照。独立七张SVG、布局JSON、PNG和README同时更新，V4.4 PDF/ZIP仍不动。交互在隐藏外壳/切骨架时锁定尺度；18根共享投影逐面检查一致。BOM/主手册/基线/索引同步黑色欧标，仍补同规格黑色180四根；槽宽未凭“欧标”擅填，撤下item槽5作为默认采购参照。

检查见[本版记录](../hardware/assembly-v4.5/validation-20261015.json)与[browser-check](../hardware/assembly-v4.5/browser-check-20261015.json)：图纸及浏览器/PDF检查，不是角码实配、刚度、带豆动作或称重验收。未提交/推送本轮改动。

## 2026-10-16 后续增量：PP热焊制作与三面内嵌板下延

用户要求详细F04/五槽制作，并指出下部三面应有木板、型材应外露；确认有可控温热风焊枪。新增[V4.7图文指南](../hardware/fabrication-v4.7/beanlens-fabrication-v4.7.html)及六页A4内面控制模板（非免试装坡口刀模）、PP/木料裁片表。主斗改PP-H2，净136方→110×30、高110；木壳外158方内146，平口圈158方顶442。焊材须配可焊性/食品接触资料，先废料试焊；工业300–340°C不能当任意枪的固定配方。

五槽不再用50高整隔板横穿闸片：下PP3×2（280–286）＋POM4（286–290）＋2.3闸缝＋上PP3×2（292.3–298.3），以28.7高小过渡110×30→82×12接3mm环到330。140宽五窗X29/46/63/80/97，各14×12；隔距在闸片110扫掠外侧。后防护G13/G20仍须避开10mm加强角梁、滑架及润滑区，未完成纸样不带豆电动，不能把延长平盖当完整封闭袋。

外板改9块内嵌，左/右/后三面下延到Z22，前下开放；按中腰梁/后相机梁分块，板面约内凹1、边缝2，F11角片/隔距背托。中框前后180梁移到Y0/220外露，按钮中心改Z273。后电控托板移Y207、Z50–180，盒向前5mm留后间隙约7；模块朝后厚度目标≤21，实物高件须重排。灯槽移X24/182避槽盒和底座。型材切长/补购仍不变：补黑色欧标180×4。

F03主排版800×600×6一张；已买600方可追加一张用双板备选，不重复买800。F04/F05/G12/F08/F07更新，新增F11/F12/G21，BOM89项。原交互HTML、七页A3 PDF和裁切CSV继续原路径更新为V4.7，配置、主手册、索引同步；V4.4原独立PDF/ZIP仍历史。图纸/浏览器/PDF检查见20261016记录；无实物焊接/强度/刚度/带豆/称重验收，未提交/推送本轮变更。

## suggested skills

- `handoff`：结束阶段时更新交接，只写增量并引用主文档。路径：`~/.agents/skills/handoff/SKILL.md`。
- `debug`：双摄、内存、串口、时序或模型转换失败时按证据排查。路径：`~/.codex/skills/debug/SKILL.md`。
- `code-quality-review`：固件形成后检查协议、状态机、边界和资源释放。路径：`~/.codex/skills/code-quality-review/SKILL.md`。
- `deep-research`：只有具体硬件/SDK兼容性仍缺资料时，核对原厂证据；不重复全量研究。路径：`~/.codex/skills/deep-research/SKILL.md`。
- `html`：需要更新图文手册时，保留离线、深色模式和交互。路径：`~/.agents/skills/html/SKILL.md`。

调用前先读对应SKILL.md；用户本会话对交接保存位置的明确要求优先于技能默认临时目录。

## 2026-10-16 后续增量：V4.8板厚、双屏和料斗支承

当前入口改为[assembly-v4.8](../hardware/assembly-v4.8/beanlens-assembly-v4.8.html)与[fabrication-v4.8](../hardware/fabrication-v4.8/beanlens-fabrication-v4.8.html)，独立版本保存，旧V4.7模板历史保留。取消H01–H06木斗壳/托耳，PP3顶法兰176×196由4金属托片挂顶框；外面9片木板仍三面下延，现600方一张即可。两屏拆出整机、内置显示面、外压框、后承托与接线腔，按原厂BOX64.3×47.6×15.4、C6非Touch板20.32×36.37/包深7.6重画。扣PP法向2mm板厚及水平4mm焊筋储备后，服务腔名义最小净空前17.09、右10.49；插线/天线/散热仍需实物。

主斗内口不变，外上口140.028×140.440；角部对称斜接离直切43.540°，端面水平，8个闭合STL/外面模板取代旧内面刀模。双法兰146×66各PP3＋1mm硅胶名义压0.8，占6.8；小过渡斗改高24.9，连同五窗/闸缝18.3保持总高50。主要外焊但必须检查根部熔合与内面；未实焊。G09角梁/G10耳单独画，G20后防护仍为待纸样接口，不误称封闭罩验收。

当前采购[94项V4.8](../hardware/procurement-v4.8/beanlens-procurement-v4.8.html)，新增F13–F17，F08旧木斗件0件不采购；相机/称重/电源模块实际尺寸与孔仍待核。型材仍补同槽型黑色180成品四根。硬件基线/索引/手册入口同步，无固件/训练/采购/加工/上板/承重验收，不提交或推送。
