koffja/Beanlens/docs/hardware/illustrations/beanlens-gate-motion-20261012.html

当前完整运作见V4.12整机流程动画；本页保留早期滑闸原理演示。

BEANLENS / MECHANISM STUDY 01

# 舵机转动，闸片怎样平着开关？

先点「开闸」，再点「缓关」。左图看传动，右图看同一时刻的槽内剖面。橙色只转动，蓝色连杆推拉，绿色闸片只前后平移。

开闸 · 1 秒缓关暂停

半开 · 等待操作

网页演示无电机连接；打开页面不会自动播放。

完整 15 mm 行程的关闸时间3.0 秒

0.5 秒5 秒

关闸运动

手动拖动开度 · 可观察球头 A / B50%

全关：闸片向前插入全开：闸片向后退回

01 / 俯视

## 用导轨把“转”变成“滑”

从上往下看；五个落豆槽的位置固定，绿色前缘不旋转。

小屏可在图内横向滑动，查看完整机构。

舵臂转动短杆推拉滑架＋闸片平移

0°舵臂相对横向角度

7.5 mm从全开位置向前推进

60 mmA ↔ B 球心距恒定

02 / 单槽侧剖面

## 挡豆前缘在沟槽里面

局部放大；后方在左、前方在右。槽壁剖开给你看内部。

小屏可在图内横向滑动，查看完整机构。

豆子只标示豆路，不做碰撞仿真。闸门位于原规划 z292，出口 z280；下方约 12 mm 围挡需联合豆形、尾流和视野验证。

6.0 mm每槽前后方向剩余开口

槽内闸片工作前缘的位置

15 mm含两端各 1.5 mm 余量

① 舵臂绕 O 转舵机固定在机架上，输出轴竖直。用舵臂离轴 16 mm 的孔连接球头 A。 ② 双球头允许杆子摆角A 随舵臂走圆弧，B 连接横梁中心。球头让两端转角，60 mm 短杆传递推、拉力。 ③ 导轨决定闸片只能平移B 不能跟着绕圈。左右滑块＋转接板/横梁限制偏转，带着整片闸片前后滑动。

## 你要的缓关：可以做，开与关分别设时间

建议先从全程 3 秒试起。本页可设 0.5–5 秒；有豆实验先用 2–4 秒范围，观察残流、夹豆和温升。中途开始的动作按剩余行程缩短时间；本次运动开始后使用当时的时间设置。

“轻启，末段更慢”让闸片先柔和启动，再慢慢接近关闭位置。这个曲线是拟定指令轨迹，实际舵机可能因齿隙、死区或摩擦出现小跳。

慢关有利于降低冲击，但不等于自动找豆缝。被夹住的豆子仍可能承受较大的力。前缘应平直、去毛刺、钝边，不能靠刀口或增大扭矩硬剪。

槽内关闸时，豆路四周仍有槽壁和下游围挡。外部连杆、导轨与润滑区要隔开；壁缝和退片袋仍需验证碎屑回带、清洁与夹豆。

模拟收到卡豆信号清除模拟故障

点此只演示“停止继续推进、保留未完成”，不会自动退让。MG996R自身没有给控制板提供夹豆检测；真实系统需要验证阻力或位移检测、超时和卸力策略。两端限位不能识别所有中途卡豆，暂停 PWM 也不保证立即卸力。

控制原理、候选配件与演示边界

控制板保持拟定 50 Hz PWM 周期，通过逐步改变脉宽来给出连续的小目标位置，例如每 20 ms 更新一次轨迹目标。这样放慢指令；不用降低 PWM 频率或供电电压。实际脉宽端点、3.3V信号兼容性和动作超时需要空载实测标定。舵机没有外部位置反馈，动画位置不代表实际到位。上电位置未知时也不能直接保证首个动作缓慢。

本页几何：曲柄半径 r=16 mm，连杆球心距 L=60 mm；居中、共面曲柄滑块，角度范围约 ±27.953°，行程恰为 15 mm。θ 按闸片位移反解，连杆长度保持不变。相对角度不是舵机 PWM 命令角；旧轴高与闸片的 23 mm 偏置需重做支架/连接耳复核。

候选：goBILDA 1900-0025-0104 舵臂（使用 16 mm 孔）＋2913-0004-0241 球头两只＋2808-0004-0030 牙条一只，调到约 60 mm 球心距；6061-T6 闸片 110×45×2 mm，120×30×3 mm 滑架转接板＋10×10×2 mm 后角铝加强梁，左右 MGN9H＋100 mm 导轨。形状与安装包络为教学示意，最终支架、封闭结构与加工孔位未冻结。

当前采购表 · 完整配件与承重计算 · 槽内关闸与缓关说明 · Pololu：逐步改变舵机目标与速度限制原理 (https://www.pololu.com/docs/0J40/5.e) · TowerPro MG996R 原厂参数 (https://towerpro.com.tw/product/mg996r/)

上述 Pololu 资料用于解释脉宽变化限速的原则；本项目拟由 ESP32-C6 生成轨迹，无需因此增购该控制器。本页不是固件，也没有模拟真实受力、豆子碰撞、实际流量或无损关闸。

2026-10-12 · 机构与控制建议，待样机验证。此文件完全离线运行，无第三方脚本；浏览器菜单可直接保存。已独立于旧生成式示意图重画。
