koffja/Beanlens/shared/protocol/README.md

# 两板协议入口

共同契约主源：[PROTOCOL-v0.1-DRAFT.md](../../docs/firmware/PROTOCOL-v0.1-DRAFT.md)。

当前为草案，没有共享编解码器或已通过的双方实现。今后放置与硬件无关的消息样例、协议测试向量和版本化 schema；修改契约时两端同步验证。
