koffja/Beanlens/docs/hardware/hackathon-h2/README.md

# BeanLens 比赛双摄版 H2 · 2026-10-21

用户要求在比赛精简版保留双摄。本版仍为单槽、人工逐颗、停豆拍照、MG996R开闸；K230D BOX负责识别/显示/控制，不装C6、称重、红外、PBT、第二屏或联网。单摄H1和完整版保留。本次为设计/动画，未改固件或用户bringup。

## 先看这些

- [拟真三维动画](beanlens-realistic-h2.html)：上下两摄、透明托片、短导豆口、后接豆斜槽；可看整机/光路/分件，含预设A/B主屏。
- [GIF直接预览](realistic/beanlens-h2-motion.gif)：同一模型导出，右侧显示两摄预设图；三维HTML可自行旋转/缩放。
- [中线剖面与光路图](side-section-h2.svg)：最容易理解下相机为什么需要开窗、接豆斗为什么要往后放。
- [接线示意](wiring-h2.svg)、[34组完整BOM](bom-h2.html)、[完整CSV](bom-h2.csv)、[相对H1改动CSV](delta-h1-to-h2.csv)、[裁切CSV](cut-list-h2.csv)。
- [结构数据](design-h2.json)、[独立电气基线](../../../config/hardware-hackathon-h2.json)。[保留的单摄H1](../hackathon-h1/beanlens-realistic-h1.html)。

## 为什么这样改漏斗

| 方案 | 拍照条件 | 比赛取舍 |
|---|---|---|
| 上下相机＋透明托片（本版） | 豆停稳，两次拍摄共享同一颗豆 | 机械改动小，不抓落豆瞬间；要处理玻璃反光、豆屑和接触区遮挡 |
| 两侧相机＋窄支承/夹持 | 可静拍，但豆姿态、夹持点影响可见面 | 无玻璃透拍；需要额外定位，不能承诺正反大面都看清 |
| 开放落豆窗＋两侧相机 | 自由落体连续取帧 | 无托片遮挡；增加短曝光/照明、时间窗、配对、漏拍与重拍难度 |

本版保留已确认的静拍流程。将原来的不透明PP槽底替换为可抽出的玻璃片，PP只做侧壁、边托和底座框。上相机垂直向下，下相机垂直向上透过玻璃。相机不用在豆滑落时追拍，也不增加翻豆机构。

**料斗分成三段，不包成一个封闭斗：**

1. 前端短导豆口，45mm宽入口收至25.8mm，人工一次放一颗，不承储豆载荷。
2. 中段玻璃拍摄槽，底下必须通光。两侧PP支承与玻璃边托固定；挡片仍从侧面摆开。
3. 出口后方独立接豆斜槽，把豆引向Y165，再落进同一杯。下相机前方另有防撞挡板；不能把相机放在豆的直接落点。

## 名义尺寸与配合

单位mm，坐标沿用H1：X左右、Y前后、Z向上。所有孔位及摄影质量仍待实配，并非加工放行图。

- 框架仍220×240×460；460×4、180×4、200×4。已有460×7和400×2足够，不增加型材订货。
- 工作海洋板176×196×6：通孔改为70×110，全局X75/Y55，距板左前角53/33。板外圈与四个固定点保留；可以在H1工作板上扩孔。
- PP3底座框100×130，起点X60/Y50/Z186；开48×105孔，起点X86/Y60。下摄光轴穿过孔，孔上方不能留PP底板。
- 玻璃指定25.4×76.2×1.0–1.2，绘图按1.1。内宽25.8，玻璃两侧各约0.2余隙；每侧承托宽3，中央名义通光约19.8。它只承单颗豆，不作为储豆漏斗底，不承手按压力。
- 玻璃板面76.2、坡35°：水平长62.419、高差43.707。下游Y124/Z220；上游Y61.581/Z263.707。两PP侧支承底Z189，上游高88.707、下游高45；边壁高于玻璃约14。
- 原图的侧支承底部落在底座开口内，必须用两只向外的角铝支脚落到实体边框，螺钉中心参考X80/140。不能把侧支承悬在孔里。
- 玻璃边托位于玻璃下面外缘，4只可拆压扣固定在外侧。压扣不压住中央拍摄带；松开后从前端抽出清洁/更换，不把玻璃粘死，不向玻璃施作PP焊接。买到实物后再定夹持厚度，普通7101也有25×75/26×76，不能混规格。
- 停豆中心起试X110/Y116.5/Z228.05。上镜头Z318.05朝下，下镜头Z138.05朝上，名义工作距离各90。试调80–110，根据实际近焦与豆粒像素密度决定，不保证原90°镜头可直接拍清细小瑕疵。
- 上下相机垂直对看，玻璃倾35°，因此下摄透玻璃有折射/反光；两摄分别调焦、曝光/白平衡、ROI和必要的几何校正，不照抄上摄参数。不要靠把低像素豆图放大到224来冒充有效细节。
- 上、下灯都从侧面斜照豆，避免灯带直接射入对面的镜头。镜头周围可用黑PP背景片遮掉杂乱反射，但不能堵住相机孔或两条视线。
- 下相机PCB按40方占位、最靠后Y136.5；防撞板Y145，名义间隙8.5。相机PP3载板60×40，起点X80/Y96.5/Z111.5，后缘Y136.5，距防撞板8.5。**这些名义间隙仍是样机必须实配的点**：如实物板/接头/螺母更大，应把下支架往前移并复核光路，不能硬塞。
- 后接豆底板内宽46，斜面长63.286，水平33、下降54；起点Y132/Z197，末端Y165/Z143，边高18。防撞片PP2 60×55，X80–140/Y145/Z110–165。出口投影进入杯口Y95–195；需手放实豆试不反弹、不积豆、不碰下相机。
- 挡片仍PP3 46×18，舵机竖轴目标X140/Y126/Z240，开0→90°仅为几何。仍只有一只25T直臂。长舵臂尾端、角片、旗片必须避开上摄ROI；动画不能代替实际视场检查。

## 怎样先拼样机

1. 先买玻璃实物并量宽、长、厚。拿一颗豆、两相机和常亮灯做台面样：上面能拍清、下面透玻璃也能拍清后再裁大板。下视图若被反光覆盖或近焦失败，先调灯角、遮光与镜头；无法解决则保留H1，不用动画预设图冒充通过。
2. 工作板扩孔，底座开窗，暂用可拆支架装侧壁与边托。先纸样核玻璃、挡片和两镜头视线；玻璃先拿开，再练PP焊缝，不在玻璃旁直接热风焊。
3. 固定上下相机，先不装舵机挡片，用标尺检查ROI、豆粒原始像素和对焦。支架承重，排线留弯曲余量，不能穿过挡片扫掠区。
4. 放回玻璃，仅轻夹边缘；装一只舵臂与挡片，舵机6V断开先手动确认全行程。关限位放舵机侧，避开拍摄带。连接角片防转孔位按实物处理。
5. 装后接豆斜槽、防撞板和杯，手动放豆观察路径。下相机用纸板占位先试，确认豆不撞纸板后才装镜头。再空载通电标定限位与舵机脉宽，最后逐颗联调。

## 运行与失败处理

两摄先连续预览；启动不自动开闸。关位明确、两路图像可用后，人工放一颗并按KEY0。停稳后依次取A上视和B透托片图，两图绑定同一cycle_id，检查是否新帧、对焦/曝光可用，再推理/保存。无需宣称硬件同步；帧新鲜度阈值尚待标定。

任何一路缺图、模糊或低置信，整颗记拒判/待复核，不算正常。任一有效视图疑似，整颗标疑似；两路均有效且满足正常门槛才报正常。两张图只计一颗豆，不能报告两摄覆盖全部表面。图像、模型或保存失败时不自动放走；人工确认/处理后再操作。

结果与两图保存完成，开闸放豆；通过空槽图像＋人工可见确认后缓关，关位确认再允许下一颗。限位矛盾、卡豆/超时先停止新增动作，不持续加力；KEY1是软件停止，非硬急停，断电不保证自动关闸。H2动画中的结果、曝光提示和时长都是预设演示。

## 电源与接线变化

- 主电源YU2405 24V5A保留；BOX仍由TPS5450候选成品板供5V，MG996R仍独立好盈UBEC5A设6V。H1缓冲/限位/按键引脚原样保留，不借用C6引脚。
- 两只GC2093分别接BOX的CSI1/CSI2兼容口，排线方向按实物核。CSI供电来自板卡，不能给摄像头接24V/6V。
- 灯从2段增至4段，按每段100有效长/≤20W每米起算8W。持续预算5×3/0.8＋6×3/0.8＋8=49.25W；舵机短峰按5A为64.25W。只是预算，双摄主板5V电流/纹波/温升、灯亮度和保险仍须实测，不因此宣布供电验收。
- BOX官方说明确有两个GC2093 CSI接口；具体CanMV版本、Sensor(id)映射、双摄＋显示＋KPU内存尚未在本机验证。先双路低分辨率预览确认，再按需要验证原分辨率裁图与内存上限，不套别家K230例程的引脚或镜像。

## 原厂参考

- [BOX两CSI接口及外形](https://wiki.alientek.com/docs/Boards/Kendryte/DNK230D/start-guide/k230d-box-introduction/)。
- [CanMV双摄示例（开发分支）](https://www.kendryte.com/k230_canmv/en/main/example/media/sensor.html)：只作API参考，不证明BOX现有固件兼容；不照搬HDMI显示配置。
- [HINOTEK 7101磨边普通载玻片规格](https://www.hinotek.com/lab/microscope-slide/)：25.4×76.2，厚1.0–1.2等变体，买前核完整规格。

## 验证状态

2026-10-21：20项设计资料检查通过（含H1及68份完整版文件字节保留），18项离线浏览器检查通过（含上下中心视线无遮挡、A/B期间同一豆静止、后导豆/空槽缓关、无网络请求、手机布局）。结果见`validation-h2.json`与`realistic/browser-check.json`。中心线检查不等于整个镜头视场无遮挡，更不能证明实际光学质量。

摄影可用性、玻璃洁净与眩光、近焦/像素密度、豆路防撞、夹持/支架、双摄固件/模型与供电均未实机验收。没有新训练、刷机、提交或推送。
