koffja/Beanlens/docs/research/coffee-industry-hardware-primary-sources-20261008.md

# 咖啡产业 AI 硬件方向：第一手需求与竞争证据

核查日期：2026-10-08。为 TasterMatrix 四天黑客松选题做只读外部研究。事实、厂商产品主张与方案推断分开；不估算需求发生频率、节省金额或获奖概率。产品存在不等于已证明新团队能接入其设备协议，也不等于证明市场尚未满足。

## 1. 杯测实验室：杯位、操作条件与结果一起追溯

**具体用户/问题。** 样品烘焙师、杯测主持人需知道某条感官记录对应哪一实际杯、哪一阶段，以及制样是否可比。SCA 当前官方 102-2024 要求控制制样与品尝操作：逐杯称量、独立研磨，同规格容器；破渣前静置 3–5 分钟；约 70°C 开始品尝，随冷却至少三轮。它区分 affective 每样五杯和 descriptive 杯测每样三至五杯。由此可提出的可验证痛点是：数字评分有样品代码，却可能缺少实际杯位与操作时刻的对应证据。**“现场经常拿错杯”尚无本轮第一手数据，必须访谈验证，不能当作已证实高频问题。** [SCA-102 官方 PDF，§5.2、§5.3、§6.2、§6.3](https://sca.coffee/s/AW_SCA-102_Sample-Preparation_281024_Secured.pdf)

**已有解决方案。** Cropster 双盲流程已有不可更改的样品 ID、代码标签和揭盲结果；其流程需要两人分工，从样品 ID 标签换成盲码标签。因此“二维码＋盲测表单”已有成熟竞争者，不能宣称是新发明。[Cropster 双盲设置官方说明](https://help.cropster.com/en_US/how-to-set-up-a-double-blind-cupping-session)

**建议概念：CupTrace 过程证据杯测桌（方案推断）。** 杯底耐水盲码／固定杯位标记→摄像头读码或 NFC 识别→称重杯垫检测杯子移走、放回和注水时刻→一支可清洁食品接触温度探头记录一处温度→口语感官记录绑定样品、杯位和轮次→TasterMatrix 表单/复测分析。AI 将“第二杯冷后变酸”拆成待确认记录，并追问是感知强度还是喜好；杯号映射、时间和重量由确定性逻辑处理。杯壁/杯垫温度不能未经标定就冒充液体温度。

**四天边界。** 做三个杯位的过程辅助演示、一个实际温度测点、拿走/换位/放回三种状态、盲测后记录核对；完整 affective 测试须扩至每样五杯，否则明确是技术演示。不要用取杯动作推断“已经品尝”，需口语或按钮确认。摄像头只识别杯位标签，不凭画面自动断言破渣完成。验收可让主持人故意换位，检查记录是否仍对应原杯；两次同样注水测试确认时间记录；录入口语后逐项核对，防 AI 偷改评分。主问题是过程可追溯，AI 是减少输入负担的辅助。

## 2. 门店冲煮：将本杯实测与本杯感官连接成一次可验证调整

**具体用户/问题。** 值班咖啡师和门店品质负责人需要同时判断配方是否执行，以及客人/团队实际怎么评价。SCA 发布的冲煮研究指出，描述性属性与消费者喜好应分开，不能用一个“理想萃取区”代替每个人的喜好；TDS、萃取率与感官不是同一件事。故硬件不能只凭重量/流速宣布“这杯好喝”。[SCA 冲煮研究说明，由研究者解释](https://sca.coffee/sca-news/25/issue-13/towards-a-new-brewing-chart-xpj8t)

**已有解决方案。** Cropster Cafe 已经监测配方参数区间，并把 brew score 与门店反馈连接到烘焙团队；Acaia Lunar 已有重量、流量指示及蓝牙，Brewmaster 能自动保存冲煮曲线。基础遥测、曲线及反馈闭环均有强竞争者。[Cropster Cafe Intelligence](https://www.cropster.com/solutions/cafe-intelligence/)／[Acaia Lunar](https://acaia.co/collections/coffee-scales/products/lunar_2021)／[Acaia 官方 Apps](https://acaia.co/pages/apps)

**建议概念：ShiftDial 班次试冲助手（方案推断）。** 在不改咖啡机内部的前提下，以现有秤或自制负载传感器得到时间—出液重量→扫码关联豆批/当班目标配方→咖啡师按键说“今天这杯偏薄、尾段干”→AI 整理为待确认的感官项→显示相同豆批最近记录→提出一项人工确认的对照试冲任务→第二杯实测及盲评录入 TasterMatrix。AI 可生成试验候选、询问缺失信息，不能把一个传感器偏差自动解释成研磨/烘焙原因。消费者喜好和咖啡师描述分字段保存。

**四天边界。** 一台机器、一个豆批、一个班次；优先把自有秤/自制称重模块联通，不把兼容所有蓝牙秤作为目标。只采出液重量与时间；粉量手动或称量输入；没有折射仪就不显示 TDS/萃取率。完成基线杯→人为改变一个配方变量→第二杯→盲评差异与原始曲线并排，证明记录和建议链路，而不是证明自动诊断有效。先验证咖啡师愿不愿在忙班说一句话、是否能正确绑定本杯，以及对照任务有无用处。不要自动修改咖啡机设定。

**差异化边界。** 厂商资料已经覆盖“机器数据＋感官反馈”。潜在区别只能收窄到低接入成本、口语/脚踏免手操作、个人判断核对和可执行对照任务；是否有购买价值需店方验证。若仅做 AI 总结＋曲线仪表盘，竞争定位薄弱。

## 3. 咖啡发酵：把连续过程证据绑定到最终杯测样本

**具体用户/问题。** 处理厂、庄园试验负责人需记录批次过程并与后续杯测对应。一项作者原始实验每 12 小时测温度/pH，随后干燥、烘焙并由五位 Q Grader 杯测；作者观察到环境温度影响反应器，提出需进一步研究温控条件。这支持“过程变量值得测与对齐”，不证明单靠 pH 就能预测精品评分。[Araújo 等：Temperature and pH Monitoring during the Coffee Fermenting Process，作者全文](https://proceedings.science/sites/default/files/callforpapers/fulltext_file/submission-146208-1194812-field_submission_fulltext_file1.pdf)

**已有解决方案。** Lallemand 的 LalCafe Tool 已有成熟度、Brix、pH、温度等批次记录和基于输入的终止建议。Cafelium/Nebula 厂商提供温度、pH、ORP 等连续传感及过程记录，明确面向批间复现。[Lallemand 官方工具公告](https://www.lalcafebylallemand.com/en/about-us/news/your-new-fermentation-companion-new-tool-available/)／[Cafelium 咖啡产品页](https://www.cafelium.com/en/cafe)。Cafelium 页面下方收益与评分案例明确标成 illustrative projection，本研究不把它们当作真实客户结果，也不采用它的价格提升/ROI 数字。

**建议概念：FermentLink 批次记录夹（方案推断）。** 批次二维码→带校准记录的 pH 探头＋温度探头→ESP32 连续采集与本地缓存→人工记录加菌/搅动/开罐事件→AI 将口述事件结构化，生成“哪些测量/事件需要核对”的报告→干燥样/烘焙样继承批次 ID→TasterMatrix 杯测结果回连原过程。AI 优先做事件记录、比较与不确定性解释，终止建议必须由处理厂既有规则和人工确认约束。传感器测到的 pH 不等于感知酸度，不能替代最终杯测。

**四天边界。** 只做开放/泄压的小规模记录示范与探头校准、断网缓存、批次样品关联；不造耐压自动发酵罐、不承诺食品生产用途。必须提前有生咖啡果/处理厂伙伴及已有杯测样；仅四天一般无法覆盖发酵→干燥→烘焙→风味验证。若无可用原料，展示活体记录硬件和明确标为模拟的曲线回放，不能宣称验证了咖啡品质改善。pH 校准液切换与热水降温可以检查测量链路，但不代表咖啡发酵验证。至少比较一个已知温度点及两点 pH 校准，记录探头漂移与清洗；廉价探头耐用性/食品接触材料、真实产区网络及维护仍待验证。

## 选题取舍提示

- 最接近 TasterMatrix 现有专业感官资产的是 CupTrace：硬件解决过程对应，现有表单承担结果；产业痛点有标准依据，但发生频率仍需实验室用户访谈。
- 门店 ShiftDial 最容易形成短时现场演示、店方易理解；成熟競争者较多，需把免手交互与单变量对照做实。
- FermentLink 与真实处理厂合作后产业深度强；原料、时间及风味验证限制最大。没有伙伴时应降低优先级。

以上排序是研究推断，不是商业需求强度或获奖概率统计。TasterMatrix 的现有实现由主代理单独核对，本文件没有把拟新增的硬件或 AI 功能描述成已存在能力。

## 主代理综合：五个具体参赛概念

以下为产品提案，不是已实现功能。综合产业场景、项目关联与四天可验证性排序：

| 优先级 | 概念与具体问题 | 实体原型 | AI 与 TasterMatrix 增量 | 现场验证 |
| --- | --- | --- | --- | --- |
| 1 | 杯证 CupProof：批次验收有分歧，怎样安排一次条件可比的复测？ | 带杯身份、称重与实际液温测点的三杯试验托盘 | 根据已提交感官记录提出复测问题；人确认测试方案；杯位/条件/结果关联原验收记录 | 改变杯位或注水量仍正确对应；完成一次盲测并保存结果 |
| 2 | 焙镜 RoastMirror：同款咖啡的新批次，是否出现值得复杯的焙后变化？ | 固定光箱、相机、色参照块、批次标签 | 把相对色差/分布、ArtisanZ 曲线和实际杯测并列；建议人工确认的复测，不自动判废 | 重复装样检验测量稳定性；比较参照样与偏离样 |
| 3 | 首杯 BrewFix：值班咖啡师如何把本杯实测、口语反馈和下一次试冲连起来？ | 秤、计时、按钮/脚踏输入；实际温度测量可选  | 感官输入经确认后归档；只提出一项对照调整；记录第二杯结果 | 同一豆批两次试冲，完整追踪变量和反馈 |
| 4 | 磨准 GrindCheck：不同磨豆机/不同天的刻度，是否产生可比的研磨结果？ | 固定时长筛分台、可称量分级收集盘、ESP32 | 实际筛分质量比例与杯测关联；提出试验候选，积累每豆批经验 | 同一咖啡不同研磨设置，重复筛分并检查回收质量 |
| 5 | 酵记 FermentLink：发酵记录如何可靠对应到最后被杯测的样品？ | 温度/pH 批次记录模块 | 时间事件与样品继承关系、后续杯测关联 | 校准/连续记录/断网恢复；完整风味验证须后续进行 |

CupProof 的三杯可演示差异复测，不等于完整 SCA affective 杯测。选测试法需先确认业务问题；[ISO 4120:2021 官方摘要](https://www.iso.org/standard/76666.html)说明三角测试用于可感知差异/相似，不能说明差异方向、大小或优劣。未检出显著差异不自动等于相同；统计规则和样本量须预先确定。

RoastMirror、GrindCheck 已有测量设备竞争者：[Lighttells CM-200](https://lighttells.com/CM200.html)提供焙度/均匀度/粒度功能，[KRUVE Sifter](https://www.kruveinc.com/products/sifter-base)提供筛分。RGB 原型先报告同设备同条件下的相对变化，不能未经参考仪器标定就显示 Agtron。图像颗粒的数量分布与筛分质量比例是不同指标，不可直接互换。上述原型价值须落到操作成本与复测工作流，不能只靠测量看板或 AI 文案。

主代理已按项目索引定位并读取 `vps-backend/src/services/tm-artisanz/roast-profile-normalizer.ts`、`roast-sync-service.ts`：现有逻辑处理 ArtisanZ profile、BT/ET/RoR 曲线、烘焙事件与批次同步，支持 RoastMirror 作为拟新增业务接入点。这是代码层证据，不是本轮远端生产状态或硬件接入验收。图谱未返回相关符号，降级到 TM-Index 已定位路径的直接源码核对；覆盖元数据为 metadata_match/no_recorded_issue。

总体建议：项目结合与四天可完成性优先选 CupProof；能取得真实烘焙批次与参照设备时选 RoastMirror；面向普通评委的即时可体验性优先 BrewFix。BeanLens 仍是强候选，不因为增加新方向就降低其价值。最终选题须由目标用户愿意共同测试、实际可取得设备/样本来决定。
