koffja/Beanlens/docs/research/wtcc-2026-tastermatrix-ai-hardware-strategy.md

# TasterMatrix × WTCC 2026：AI 硬件参赛选题建议

研究日期：2026-10-08。依据用户提供的五张赛事海报、当前仓库的图索引及源码、公开赛事资料和第一手获奖案例。本文是选题与验证规划，不是实施授权、器件报价或获奖概率预测。本次未重新运行产品、核实生产开关或开展真机验收。

## 1. 建议结论

建议参加，首选 LIVE 赛道，主题为 **TasteBridge 味觉搭子——让每个人都能说出自己喝到的风味**。参赛作品聚焦一套桌面风味学习装置，TasterMatrix 提供专业词汇、记录、练习与结果分析。

先用香气瓶完成“盲闻—描述—反馈—下一次练习”，再接入咖啡或茶的真实品鉴。硬件负责呈现实物、检测拿取、引导操作；AI 负责理解口语、追问和安排练习；人负责真实感知。设备不宣称测出主观风味，也不替代专业评委。

如果更重视现有专业业务，选 **Cupping Copilot 无手操作评测桌**；如果现场观察发现银发用户的明确兴趣与操作障碍，可调整为 **茶友桌**。不建议同时开发多赛道作品。

## 2. 赛事要求及其对选题的影响

用户海报明确：10 月 22—25 日四天；首日观察真实场景后选题；允许已有设备、代码、设计或半成品；需要可运行、可触摸、能接受现场测试的实体原型。四赛道各产生一个 Track Winner，再进入 Grand Prize 总评。

评审关注真实问题、核心功能运行、AI/硬件/交互完整体验、赛中有效增量和继续验证价值。因此，已有软件能减少基础开发，但必须如实说明赛前完成范围，把参赛贡献放在新装置、新交互和用户验证上。四天内应验证一个具体问题。

公开报名正文/FAQ 补充每队 2—4 人、可个人报名后组队、已有原型须披露。成熟产品评奖资格仍保留正式规则口径。页面显示报名截止 10 月 17 日 15:59，未标时区；确切路演分钟数与核心器件清单未核到。以上细节报名时以正式通知确认。[公开活动资料](https://ai.builderlab.cn/)

## 3. 项目当前能力：哪些可复用，哪些要新增

| 能力 | 本次证据 | 对参赛的价值与边界 |
| --- | --- | --- |
| 多类专业杯测表、记录、活动与导出 | `.planning/PROJECT.md` 的产品基线；本次进一步核查三角测试与事件分析代码 | 可复用专业工作流，不能把旧里程碑文字当作当前所有平台运行证明 |
| CATA 风味词汇及本体 | CATA 服务图索引、FlavorQuizzz 的 PG-CATA 题库来源 | 能将自然语言反馈连接到可解释的风味词汇；具体素材使用范围需按现有授权 |
| 三角测试 | `pages/forms-tool/composables/useTriangleTest.ts`，包含编码、选择答案、差异笔记和保存 | 已有真实盲测流程，可扩展实物操作 |
| FlavorQuizzz | `quiz-generator-service.ts:805`，基于节点和关系生成题目 | 可复用题库和练习；该函数是规则/数据驱动出题，不能称为已具备大模型自适应教练 |
| 多人统计及复测信号 | `event-workspace-service.ts:250/336/390`，离散程度、ICC/alpha、覆盖缺口和复测项 | 可为教师/主持人提供客观统计；统计分析本身不等于生成式 AI |
| 实际生成式 AI 接口 | `coffee-copy-service.ts:104/173`，MiniMax 文案生成；入站调用经 `coffee-copy` 路由与路由注册链 | 已有模型接入与计量框架；目前核实的是基于品鉴资料生成文案，不是已经运行的实体教练 |
| Cotrix / ArtisanZ 数据连接 | `roast-sync-service.ts:222`，同步烘焙参数与 profile | 说明能连接生产过程与品鉴记录；不能据此声称已有现场设备实时控制 |
| 硬件及语音闭环 | 本次未定位到可直接复用的成品接入流程 | 作为新增工作估算；这是有限范围查询结果，不是全仓不存在硬件代码的证明 |

源码证据：

- [产品基线](../../.planning/PROJECT.md)
- [三角测试](../../pages/forms-tool/composables/useTriangleTest.ts)
- [词库出题](../../vps-backend/src/services/flavor-quizzz/quiz-generator-service.ts)
- [事件分析](../../vps-backend/src/services/event-analytics/event-workspace-service.ts)
- [AI 文案](../../vps-backend/src/services/ai/coffee-copy-service.ts)
- [ArtisanZ 同步](../../vps-backend/src/services/tm-artisanz/roast-sync-service.ts)

以上代码路径已通过图索引覆盖检查，无记录缺口，仍是 best-effort 信号。业务定位补充使用 TM-Index，未对大范围检索作穷尽结论。

## 4. 五个可选主题

下列排序是结合本项目复用程度、四天实现与赛事体验要求的判断，不是客观评分或预测获奖率。

| 顺位 / 主题 | 赛道与具体用户 | 硬件与 AI 的分工 | 现场演示 | 商业延续与主要不确定性 |
| --- | --- | --- | --- | --- |
| 1. TasteBridge 味觉搭子 | LIVE：第一次学品鉴的成年人、咖啡/茶兴趣用户 | 三槽盲闻底座、拿取检测、灯光和按钮；AI 将口语对应到词汇候选并给反馈、选择下一次对比 | 评委拿起三个瓶子、盲选、说出感受；提交后 AI 解释，装置指向下一组练习 | 先验证培训机构、门店体验；表达困难与付费需求仍需实测 |
| 2. Cupping Copilot 无手操作评测桌 | LIVE：培训教师、杯测主持人与专业评测人员 | 采样/温度模块、脚踏或桌面确认键、话筒；AI 将口述变为待确认记录，解释已有复测统计 | 用户持杯口述，核对后入表；主持人看到哪组样品需要复测 | 与现有业务最接近；展馆噪音和样品归属识别是实现重点 |
| 3. 茶友桌 | BLOOM：退休后参加茶社与兴趣学习的老人 | 大按钮、杯位检测、明确语音反馈；AI 把生活化描述变成交流与学习内容 | 不操作手机，拿杯、说“像小时候的炒米”、完成一次同桌比较 | 社区茶社和活动机构试点；需要真实银发用户参与，定位兴趣和社交，不宣称治疗 |
| 4. 风味记忆馆 | BEYOND：想保存家庭饮食记忆的人 | 带标识的实体茶罐/香气盒、读卡底座、扬声器；AI 整理本人授权的访谈、风味描述和故事 | 放上一罐茶，播放本人录音与经确认的故事，再记录后辈反馈 | 茶文化、家庭档案或展陈；硬件与原始感官评测的联系较弱，不能声称重建本人味觉或人格 |
| 5. 小小风味探险家 | BEGIN：亲子科普与嗅觉词汇学习 | 盲闻盒、图案按钮、拿取检测；AI 用年龄适合的语言生成分类/比较问题 | 比较柑橘、可可等样品，用生活词描述，再点选图案 | 科普馆与亲子机构；儿童材料与授权需求增加，现有成人咖啡产品复用较少 |

如果没有硬件队友，首选三个固定槽位的被动香气瓶装置。不要把自动配香、机械臂、电子鼻识别和语音教练一起塞进 MVP。有工程师时，可用低速舵机翻盖让系统实际呈现下一份样本；先验证气味串扰和机构重复性，再决定是否作为正式 Demo。

## 5. 首选方案具体设计

### 5.1 一句话问题

**第一次参加品鉴的人，能感到区别，却常常不知道如何表达，也不知道下一步该练什么。** 这是待验证的用户假设。赛前访谈与首日观察必须检验它，不能把它当作已证明的普遍需求。

### 5.2 最小装置

- 三个外观相同、编号随机的香气瓶，槽位固定。
- ESP32-S3 或现成同类开发板，槽位拿取检测，提示灯，确认按钮。
- 手机/电脑承担语音采集、显示与模型调用；装置承担实物状态检测和操作反馈。
- 有硬件队友时选做舵机开盖；温度、称重、RFID 为后续扩展，不全部加入首版。
- 电子与外壳预算先预留约 500—1500 元，属于规划估算，未核供应商报价；专业香气样品、手机和电脑另计。采购以具体清单为准。

ESP32-S3 的 Wi-Fi/BLE 能力可用于通信；称重扩展可参考 HX711 的现有模块和校准流程。[Espressif 官方资料](https://documentation.espressif.com/esp32-s3_datasheet_en.html)、[SparkFun 接线与校准资料](https://learn.sparkfun.com/tutorials/load-cell-amplifier-hx711-breakout-hookup-guide/all/)

比赛中允许 API 接入模型，因此无需为了概念把完整大模型塞进开发板。建议先验证开发板经网络发送事件、后端处理、灯光反馈的最短链路，再按实际终端决定 BLE；不能假定 H5 原生支持所有设备通信方式。量产端侧推理属于后续成本与隐私评估。

### 5.3 AI 的实际责任

1. 用户说“像果酱，但不知道叫什么”，AI 给出词库内的候选和追问；用户确认后入库，保留原话。
2. 在提交盲测答案后，结合真实答案和用户回答给出简短比较说明。
3. 在当下可用样本、已完成练习和混淆记录范围内，选择下一组练习并解释原因。
4. 输出允许的动作，如提示某槽位或请求下一组样本；确定性程序检查状态后执行。

设备是否拿起、瓶号和正确答案由传感器/试题配置确定。阈值提醒、统计量和正确率由程序计算。AI 不改写原始评分，不在盲测前泄露答案，不把无证据词汇作为测得事实。不确定时允许回答“还不能确定”。

偏好表达没有统一正确答案；三角测试只核对哪份样本不同；标准香气样本练习可以核对材料身份，但不能把一次差异归为用户能力缺陷。

### 5.4 两到三分钟展示脚本

这是建议排练时长，非赛事规定。

1. 20 秒：说明新手的表达困难，请评委尝试一组三份实物。
2. 40 秒：评委拿起样品，硬件检测拿取；评委盲选并确认。
3. 30 秒：评委说出自己的感觉，AI 整理词汇候选并由其确认。
4. 30 秒：提交后揭晓差异，解释本轮可证实的结果。
5. 30 秒：针对这一轮的混淆，系统选择下一组练习，装置提示目标槽位；操作者按明确流程更换材料。
6. 20 秒：展示已保存记录、用户验证结果和清晰的赛中增量。

需要人工更换样品就明示人工更换，不包装成自动配香。现场网络失败时可继续完成规则型盲测并保存；模型反馈标为暂不可用。备用录像展示真实运行，不把缓存或预录内容称为实时模型结果。

## 6. 获奖案例能支持什么判断

| 第一手案例 | 已核奖项与做法 | 可借鉴点 |
| --- | --- | --- |
| [A Printer… for Smell](https://devpost.com/software/a-printer-for-smell-ai-scent-songs) | 2025 OpenAI Open Model Hackathon：Best in Robotics；文字转配方/时序，硬件投料与释放气味 | 感官主题有清晰的硬件表现空间；受限计划与实体体验相连。VOC/气流闭环在作者未来计划中 |
| [RoboChef](https://devpost.com/software/robochef-gpt-oss-powered-kitchen-assistant) | 同赛事 Best Overall；模型规划、机械臂执行、界面显示进展 | 下一步决策必须被实际执行，状态反馈清楚 |
| [Steam Print](https://devpost.com/software/steam-deck-3d-printing) | 同赛事 Weirdest Hardware；语音输入、已有掌机和实体打印机 | 可以重组成熟硬件；整体体验比是否自研电路更有参考价值 |
| [AdventureX 2025 的 BeYourEyes](https://www.minimax.cn/news/adventurex-2025minimax%E5%92%8C44%E6%94%AF%E5%B9%B4%E8%BD%BB%E9%98%9F%E4%BC%8D%E5%BA%A6%E8%BF%87%E6%9C%80%E7%96%AF%E7%8B%82%E7%9A%84%E4%B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) | MiniMax 官方列为该赛道七组优胜项目之一；具体人群、颈挂设备、语音与灯光 | 国内案例也支持“具体人群＋具体障碍＋实体交互”的选题；没有核到总冠军或独立名次 |

奖项由赛事平台标识或赛道赞助方公告核实；工程表现来自作者描述，未独立复现。以上是少量案例，不能证明某类主题统计上更容易获奖，更不能推导 WTCC 的获奖概率。

结合本赛公开评审，我的判断是：明确用户问题、评委亲自完成核心流程、AI 引起可见的下一步变化、可信的小规模用户证据，会比功能清单更有说服力。硬件复杂度只有在有助于体验且稳定运行时才有价值。

## 7. 不建议作为主线的方向

- 仅做“蓝牙秤＋App 曲线＋AI 推荐”。已有 [Beanconqueror](https://beanconqueror.com/) 支持智能秤、温度设备与冲煮记录；这类接入本身不足以解释项目的差异。可以复用成熟设备，但优势应放在感官表达与后续练习。
- 低价 VOC 模块直接识别“蓝莓、花香、坚果”。[Sensirion 官方资料](https://sensirion.com/media/documents/A6D12AD4/61644979/Sensirion_Gas_Sensors_Datasheet_GAS_AN_SGP40_VOC_Index_for_Experts_D.pdf)指出 SGP40 不能区分不同 VOC。特定样本分类需要独立采样、校准、跨批次验证，不能把人工标签或提示词当作传感器测量。
- AI 给咖啡自动打专业分。当前真实优势是帮助人记录、理解和复测。大模型文本能力不构成专业评分效度证据。
- 用银发叙事宣称改善认知或治疗嗅觉障碍。若选择茶友桌，本次验证兴趣参与、操作与交流；健康效果是另外一类验证问题。
- 四天完成复杂自动配香。清洗、残留、材料稳定性会占据时间；学习装置先用独立香气瓶更可控。

## 8. 赛前两周和现场四天

从 10 月 8 日到 10 月 22 日开赛约两周。以下是假设能组到硬件协作者的安排；具体以报名规则和现场观察调整。

| 日期 | 交付 / 验证 |
| --- | --- |
| 10/9—10/12  | 访谈 5—8 位新手与 2—3 位教师/门店人员；测试一轮现有软件品鉴，记录卡点；敲定团队和主线  |
| 10/13—10/17 | 完成报名、披露现有能力；确认规则及设备支持；准备关键器件和样品，验证单槽拿取检测与联网 |
| 10/18—10/21 | 固化赛前代码/原型快照与演示；列出赛中新增清单，准备备用器件、独立网络与样品更换流程 |
| 10/22 | 现场观察后确认用户问题，确定唯一主流程与可验证指标，必要时调整主题 |
| 10/23 | 完成实体事件→记录→AI 反馈→下一步提示闭环 |
| 10/24 | 邀请 8—12 名目标用户体验；修复失败点，做第二版；记录每次测试条件 |
| 10/25 | 连续演练与故障恢复，准备增量证据、用户观察与路演 |

建议团队三人：你负责领域与软件；一位硬件/Maker 负责结构、传感和联调；一位交互/用户研究成员负责现场测试和路演。2—4 人是公开 FAQ 口径，最终规则需确认。

至少记录首次独立完成率、完成时间、人工干预次数、用户对 AI 整理结果的修改/确认、是否愿意再体验。目标可设“多数用户能在三分钟内完成且无需代操作”；是待检验门槛，不是既成成绩。对照需使用相当难度的不同样本，简单平衡先后顺序，避免把熟悉流程的效果算成 AI 增益。小样本只支持继续验证，不支持长期学习效果。

赛中增量表必须区分：已有软件、赛前器件实验、赛中真正完成内容、仍未完成内容。用提交记录、装置视频和用户观察支持。

## 9. 赛后前景及验证顺序

最值得验证的商业假设是“专业感官数据与教学内容，能否通过实物交互成为可复制的培训体验”。TasterMatrix 已有词汇、样品、评价与多人分析的结构基础，比重新做一个通用语音玩具更容易持续迭代。

建议客户顺序：咖啡/茶培训机构 → 门店体验活动 → 组织内质量/评委校准。先争取一个愿意反复试用的机构，核算单次布置时间、维护成本、教师省下的工作和愿付价格，再决定卖设备、租赁或订阅组合。消费者硬件、银发机构和数字记忆属于另行验证的扩展，不因参赛成功就自动成立。

数据积累只有在正确答案/材料身份可核查、用户表达可追溯、授权明确、跨人群验证有效时才形成持续优势。当前代码规模和数据模型可以支撑这个方向，但本次没有用户量、留存或收入证据，不能声称商业模式已经验证。
