koffja/Beanlens/docs/research/beanlens-patent-screen-20261013.md

# BeanLens设计公开专利初筛

日期：2026-10-13（Asia/Shanghai）。范围假定为中国大陆制造、使用和销售；境外权利单独提示。依据当前V4.4设计、V4.5采购修订和槽内滑闸补充文件。技术方案尚未冻结、固件未完整实现。

结论：本次公开检索未发现足以认定当前BeanLens方案已落入某件专利权利要求的证据，也未形成排除侵权的结论。可以继续样机验证；商业制造、提供检测服务或销售前，应按最终结构和算法做中国有效权利及同族的自由实施分析（FTO）。本记录是技术比对线索，不是律师或专利代理师出具的法律意见。

## 被比较的当前方案

- 五槽重力送料，固定槽盒；一个MG996R通过曲柄、M4双球头杆和导向滑架，驱动全宽闸片前后平移。
- 闸片工作前缘在沟槽内，后壁窄缝、封闭退片袋、前壁接收槽；PWM逐步目标缓关，尚无实测限力功能。
- 前后两摄观察短距离自由落豆，当前固定色温白光；相机连续采集，单组光电只作经过提示。
- 图像候选跟踪、裁图、分类、双面配对及证据/批次记录；当前不做逐豆物理剔除，不设分类转盘。
- 单个收豆盒称总质量，不对瑕疵各类实物分别称重。称重误差目标未验。

## 判断规则

判断对象是具体权利要求的全部技术特征及可能的等同特征，不是专利标题、摘要或“都用了相机/舵机”。功能相似也不自动等于侵权。增加屏幕、换控制板、改连杆尺寸或独立开发，都不能单独作为排除侵权的依据。[最高法院2023年案件中对全面覆盖与等同的说明](https://ipc.court.gov.cn/zh-cn/news/view-4248.html)。

专利法第11条涉及生产经营目的的制造、使用、许诺销售、销售、进口等；第64条规定权利要求确定保护范围。第75条有专为科学研究和实验的例外，不能仅凭“样机”“比赛”“开源”标签判定适用。[国家知识产权局：专利法2020年修正](https://www.cnipa.gov.cn/art/2020/11/23/art_97_155167.html)。

以下中国B/U号是已公布的授权文本，不等于本次已经核实其当前有效性。Google Patents的Active/Withdrawn等仅作检索线索；年费、无效、终止、恢复、权利转移与现行权利要求未通过官方登记簿核验。境外公开号不自动构成中国大陆排他权，同族和分案仍需检索。

## 已读权利要求的相关文献

| 文献与阅读范围 | 与本项目的关联 | 当前重要差异及后续触发点 |
|---|---|---|
| [CN103917305B：利用交替侧向照明的检查仪](https://patents.google.com/patent/CN103917305B/zh)，权利要求1–11 | 自由飞行产品流、两侧照明及扫描；属于本次较值得关注的通用检测组合，不限咖啡 | 权利要求1还限定交替扫描和随输入电流变化的光谱/幅值安排。当前固定白光未采用该时序。将来为了抑制对侧灯干扰而改交替闪光/多光谱，应重新逐项核查；不能只拿“自由落豆”判断 |
| [CN112474387B：一种原粮不完善粒的图像识别和自动分拣装置](https://patents.google.com/patent/CN112474387B/zh)，授权权利要求1 | 双侧摄像、CNN识别、通道内控制粮粒 | 授权项包含振动筛、透明玻璃通道、上下阀针联杆及七格分类转盘等限制。当前全宽平移闸片、自由落豆和单盒收集存在多处差异。将来加入双针逐豆截留及分类转盘时优先复核；不能用其申请公开时的宽摘要代替授权项 |
| [CN109261527B：一种咖啡豆分级机及分级方法](https://patents.google.com/patent/CN109261527B/zh)，权利要求1–9 | 咖啡豆多路送料、摄像判断与分级 | 装置项限定振动筛分、S形轨道、透明分级板及气吹等组合；方法项依赖所述装置。当前没有这一整套结构。若增加气吹与振动分级，需复核，不能认为“换成咖啡生豆”就有区别 |
| [CN222968399U：一种磨豆机豆箱组件](https://patents.google.com/patent/CN222968399U/zh)，权利要求1–8 | 出豆口滑动门封及导向结构，与闸门外观概念相近 | 独立项还要求豆箱底座相对筒体可转动，并由底座牵引门封。当前固定槽盒、独立舵机曲柄驱动不是同一组合。未来设计旋转快拆豆箱联动关门时重新核查；此对比并未覆盖全部槽内密封/防夹豆专利 |
| [TWI796111B：咖啡瑕疵豆筛选机及其筛选方法](https://patents.google.com/patent/TWI796111B/zh)，权利要求1–10 | 双面拍照、匹配、裁图、CNN分类，视觉流程接近 | 方法及装置包含透明输送带与分选器等限制；当前自由落豆且无物理分选器。公开页面本次仅列台湾地区，但不能据此断言不存在其他申请。出口台湾地区时需核当地有效权利 |
| [TWI818865B：咖啡生豆辨识方法以及系统](https://patents.google.com/patent/TWI818865B/zh)，独立项1、8及相关从属项 | 说明纯识别算法/系统也可能有权利，不必附带物理剔除 | 核心为色灰阶均值、标准差、加权评分及阈值判断，与当前拟定神经网络分类有区别。页面还列美国相关文献US12561786B2；国外范围未开展正式分析。不能以“无分拣器”排除所有算法权利 |
| [EP4517320A2：Automatic food inspection device](https://patents.google.com/patent/EP4517320A2/en)，公开权利要求1–7 | 食物双侧摄像、双侧照明 | 独立项包含输送装置和分离的透明轨道；当前自由落豆没有该透明轨道。是申请公开文本，页面状态及同族不能当有效权利结论。将来改透明斜滑道稳定姿态时重新核查 |
| [CN111940305A：具有转盘的咖啡豆筛选系统](https://patents.google.com/patent/CN111940305A/zh)，公开权利要求1–16 | 咖啡豆识别与双面成像相关背景 | 公开独立项包含旋转转盘和剔除机构，当前不采用。未成功取得相应授权文本或核实本案现行状态，不能把A号当成有效授权范围 |

上述差异是技术初筛结果，未完成等同、功能性特征解释或审查档案分析。并非“只要缺这个零件就一定安全”的法律结论。

## 对当前设计的建议

1. 继续验证现有固定槽盒、全宽平移闸片、固定白光、连续成像和单盒收集，无充分依据为了专利问题先更换MG996R或放弃双摄。
2. 不复制其他产品的具体机构、外壳造型或专利算法细节。独立设计记录有助于解释开发来源，但不自动排除专利侵权。
3. 双面配对/计数、槽内封闭退片结构及缓关/异常处理仍需专项检索；本轮未证明它们不存在有效权利。通用球头、导轨与舵机采购也不等于整机组合获得许可。
4. 商业化前冻结CAD和控制流程，再由熟悉机械与视觉算法的专利代理师/律师，对中国有效独立权利要求、同族、分案与等同做逐项表格。增加透明输送带、透明斜道、双针截留、交替光源、气吹或分类转盘时，更新检索。

## “能自己申请”是另一个问题

现有文献已经涉及双面咖啡豆识别、CNN分类与粮粒视觉检测，因此“相机＋AI＋称重”不能直接认定为可获专利的创新。槽内防飞豆、可清洁退片结构、异常控制或证据配对的具体改进可以成为进一步评估对象，但要有区别特征和实验依据，不能预判授权。

自己取得专利也不自动获得实施别人在先基础专利的许可。若计划申请，公开比赛、视频或开源详细结构前先安排申请；专利法第24条的六个月不丧失新颖性情形有特定条件，不是任何比赛或自发公开均适用。依据仍为上述专利法第22、24条。

## 检索边界与待核事项

检索了咖啡豆/粮粒缺陷检测、双面取像、自由落体、滑动出豆门、舵机连杆、称重及通用光学分选关键词，并阅读以上文献列明的权利要求。专利原文通过Google Patents转载检索；未依赖商品宣传或AI生成摘要认定保护范围。

没有访问完整付费专利数据库、没有完成分类号/申请人全量检索，没有官方法律状态证明，也没有覆盖尚未公开的申请。CN120525807A（孪生神经网络咖啡豆检测）仅找到检索线索、未取得可核原始权利要求，未据摘要给出侵权结论；CN109513640相关原粮检测线索亦待核。

本文件不修改硬件基线、不意味着“专利检索通过”的产品门禁或许可。最终制造/销售地点、用途、结构和代码决定后续分析范围。
