koffja/Beanlens/docs/research/beanlens-local-training-primary-sources-20261009.md

# BeanLens：M5 MacBook Pro 本地训练路线与一手资料

核对日期：2026-10-09。范围为固定槽位、逐颗生豆的外观瑕疵分类。这里是资料核对与实施建议，尚未安装训练环境、下载数据或在用户设备上训练；本次主代理读取到设备为 Apple M5、32GB 内存，实际可用内存、训练速度与运行兼容性仍需实测。

## 建议结论

首选 **固定相机与光源 → 网格定位 → 每格裁出一颗豆 → MobileNetV3-Small 迁移学习 → 人工复核低把握结果 → 确定性统计计数**。EfficientNet-B0 作为第二个对照。先使用 ImageNet 预训练权重，再用用户自己拍摄、专家确认的生豆图片调整分类器。

这条路线适合几天内形成可检验的模型原型。固定槽位已提供位置，第一版无须额外训练目标检测器。一个格子有多颗豆、空格、遮挡或模糊时应先拒绝分类并要求重拍；“模型不确定”应是处理状态，不必当作一个视觉缺陷类别训练。软件计数针对独立 bean_id，同一颗豆翻面、重拍不能增加统计样本数。

## 官方确认的训练能力

| 路线 | 核实内容 | 对本次项目的意义 |
| --- | --- | --- |
| PyTorch MPS | 官方说明可把 Tensor 和 Module 移到 `mps`；提供 `is_available()` 与 `is_built()` 检查 | 在 Apple silicon 本机使用 GPU 训练的基础；先通过环境检查与一个小批次的训练/验证冒烟测试 |
| torchvision MobileNetV3-Small | 官方提供 ImageNet 预训练权重，约 254 万参数 | 首个轻量迁移学习基线；“轻量”并不意味着能直接塞进 ESP32 |
| torchvision EfficientNet-B0 | 官方提供 ImageNet 权重，约 529 万参数 | 用相同独立测试集比较细小瑕疵的识别表现 |
| Ultralytics classification | 官方支持图片分类训练；训练文档支持 `device="mps"`；默认裁剪变换可能丢掉图像边缘 | 更少训练代码的备选，须保证整颗豆保留；部署前核对官方 AGPL/Enterprise 许可选项 |
| MLX-VLM Qwen3-VL | 项目维护者提供 Qwen3-VL-2B LoRA 与 4bit QLoRA 示例；也列出训练视觉模块的配置 | Mac 可以探索 VLM 微调；但当前没有本项目/M5/32GB 的速度与内存测试，不能保证几天内获得更好的分类器 |

来源：[PyTorch MPS](https://docs.pytorch.org/docs/stable/notes/mps.html)、[MobileNetV3-Small](https://docs.pytorch.org/vision/stable/models/generated/torchvision.models.mobilenet_v3_small.html)、[EfficientNet-B0](https://docs.pytorch.org/vision/stable/models/generated/torchvision.models.efficientnet_b0.html)、[Ultralytics 分类](https://docs.ultralytics.com/tasks/classify/)、[MPS 训练](https://docs.ultralytics.com/modes/train/)、[Ultralytics 许可选项](https://www.ultralytics.com/license)、[MLX-VLM LoRA 文档](https://github.com/Blaizzy/mlx-vlm/blob/main/mlx_vlm/LORA.MD)。

MLX-VLM 文档中的普通 LoRA 示例使用 `train_vision=False`，不能把“已运行 LoRA”直接等同于“视觉编码器已学会新的细微瑕疵”。即使对视觉模块训练，也仍须依靠独立样本证明改进。此处建议优先小型分类模型，是项目成本与可验证性的选择，并非声称大模型不能训练。

## 数据应该怎样准备

先选真正能通过现有相机观察、且能得到专家可靠标签的 4–6 类。例如正常、黑豆、可见虫蛀、破损/切伤、壳豆，以及实际能收集到且定义明确的其他类。酸豆、霉菌损伤等需要分清“可见外观疑似”与已经人工确认的专业标签，不能从模型输出推导气味、内部状态或食品安全结论。一颗豆可能同时有多个瑕疵，第一版可以限定为专家裁决的主类别，并保留其他标签；扩展时再采用多标签分类。

建议目标为每类 100–200 颗独立实物豆，多个批次/来源，并拍摄两面；这是几天原型的数据采集目标，不是保证准确率的最低门槛。稀有瑕疵若只有十几颗，不应通过反复旋转图片宣称样本已经足够。正常豆也应覆盖不同颜色、品种、处理法和批次，避免模型把正常批次差异当瑕疵。

为每张图保存 bean_id、lot_id、capture_session、side/view、expert_label 和来源。先按独立豆、最好按批次划分训练/验证/测试，再做增强。同一豆的正反面、旋转、重拍、同一原图裁剪都必须留在同一分组。小数据可先用约 70/15/15 的分组比例，但应优先保证每类测试有足够独立豆；另留一批从未用于调参的新批次检查泛化。

增强优先小角度旋转、翻转、有限位置变化。颜色是识别信号，强色偏、灰度转换或大幅色彩抖动需要特别谨慎。裁图应把完整豆体加少量背景装进方形画布，避免切掉虫孔或破损边缘。建议先以 224×224 跑基线，再对细小虫孔比较更高分辨率；放大低分辨率原图不会增加细节。

## 可参考的咖啡数据：用途与边界

| 数据/论文 | 已核实事实 | 对 BeanLens 的用途与限制 |
| --- | --- | --- |
| Thai Arabica 17 defects，Arwatchananukul 等，2024 | 作者论文记录 979 张原始图，经旋转扩展至 6,853；比较多种 CNN，包含 MobileNetV3；未见数据测试准确率为 88.63% | 与瑕疵类型较接近。论文正文提供作者 Kaggle 数据链接，但本次 Kaggle 详情页未能打开，数据许可、下载可用性和原始实体数量尚未确认。先核对，再决定是否用来预训练；不能把增强后图片数当独立豆数 |
| USK-Coffee，作者 cvitlab 仓库 | 四类：peaberry、longberry、defect、premium；README 描述共 8,000 张，每类 2,000 张 | 类别更偏品种/形态与粗质量分类，不等同完整 SCA 瑕疵。仓库页面未显示明确数据许可，不能假定可用于商业产品 |
| Swin-HSSAM，Jiao 等，2025 | PLOS 论文提供作者代码/数据仓库链接，并说明自建与公开数据集 | 可作为后续研究线索；本次未逐个下载检查文件、标签及数据许可证，不能承诺是可立即使用的 SCA 分类数据包 |
| RoastedCoffeeDefectDataset，作者仓库 | 2,786 张，Apache-2.0；包含烘焙后豆的破片、quaker、烧焦等标签 | 主要是熟豆，领域与标签明显不同，不建议直接混入生豆分类训练后报告生豆准确率 |

一手来源：[Thai Arabica 论文](https://www.sciencedirect.com/science/article/pii/S2772375524002855)、[作者数据地址](https://www.kaggle.com/datasets/sujitraarw/coffee-green-bean-with-17defects-original)、[USK-Coffee 作者仓库](https://github.com/cvitlab/USK-COFFEE-DATASET-A-multi-class-dataset-composed-of-the-various-green-bean-arabica)、[Swin-HSSAM 论文](https://journals.plos.org/plosone/article?id=10.1371/journal.pone.0322198)、[Swin-HSSAM 作者仓库](https://github.com/tonyalice77/Papers-related-to-swin-transformer-improvements)、[熟豆数据作者仓库](https://github.com/dont-text-me/RoastedCoffeeDefectDataset)。

上述高交叉验证准确率并不直接证明本项目能复现。对经过旋转增强的数据，若增强图跨分组会发生泄漏；这是一项需要审计的风险，本次未检查论文代码，不能断言作者已经泄漏。用户设备与公开图的背景、镜头、光源、豆来源不同，也会产生领域偏移。因此外部数据宜辅助训练，最终验收必须使用自己装置拍摄的独立测试样本。

## 四日实施计划

1. **第 1 日：定义和采集。** 固定光源、曝光、白平衡与焦点；人工确认 4–6 类标签，收集独立豆并赋 ID。拍正反面，制作同源分组。用少量图验证每格裁剪、空格与双豆拒绝规则；先不追求自动翻面结构。
2. **第 2 日：本地基线。** 安装原生 arm64 Python 与匹配的 PyTorch/torchvision，确认 MPS。加载 MobileNetV3-Small 权重，替换分类头，先冻结主体训练头，再小学习率解冻末端。以 batch 16/32、224 像素、小规模短训练作为起点；具体批量与轮数按显存、验证曲线调整，不预设“跑满多少轮就成功”。
3. **第 3 日：检查错误与补样。** 与 EfficientNet-B0 对照；看逐类召回率、精确率、混淆矩阵、正常豆误报率，报告自动覆盖率与人工复核率。只从训练来源补样；验证集定阈值，测试集不能用于反复调参。给“疑似缺陷”保留人工复核流程，概率分数不应直接称为经校准的置信度。
4. **第 4 日：完整盲测。** 选未进入训练的新豆/新批次，整盘拍摄、翻面、合并同一豆证据、人工复核、计数、输出批次记录。记录真实每盘时间、换盘时间、网络/本地推理时间和失败率。抽样误差与识别误差分开呈现，模型测试准确率不能直接当成瑕疵率估计精度。

四天的可交付目标是“在限定类型和固定装置条件下运行、能展示真实独立测试结果的原型”，不是完整专业分级仪。若还没收集到足够、可信的实物标签，优先交付人工确认驱动的标注与计数闭环，同时保留 API few-shot 对照；这比用公开图片得到漂亮但不可迁移的准确率更有验证价值。

## 本次核对方法与未完成事项

仅使用框架官方文档、项目维护者仓库、原始论文与作者数据仓库。完成了能力与来源核对；未实际检查原始数据许可证文件、同豆/增强图分组、图像分辨率、模型训练耗时、MPS 算子兼容性、分类准确率及跨批次表现。这些必须由实施阶段完成。
