koffja/Beanlens/docs/hardware/hackathon-h1/beanlens-realistic-h1.html

BeanLens 豆鉴H1 比赛原型 ／ 拟真教学动画对照采购表 ↗

机构特写整机装配部件拆解

恢复视角 ↺

正在准备三维模型…

槽体固定 · 只有一只舵臂带挡片转动

＋−

拖动旋转 · 滚轮缩放 · 点击部件看说明

0°挡片相对打开角

元件名称 显示遮光片 线束走向沿用 H1 相对尺寸

▶ 播放演示↺ 重播速度 00.0 / 18.0 s

演示进度

01 / 06预设流程演示

# 等你放入一颗豆

人工从短槽上方放入一颗生豆。这里没有大料斗，也没有自动逐豆送料器。

K230D BOX 主屏画面示意

H03 · H10 · H11 · H12

## 先看清这四件东西

黑色舵机机身锁在固定支架上；银色直舵臂套在输出轴上，再经小L角片带动白色PP挡片。固定架不转，舵臂只用一只。

聚焦舵机与挡片 →

外形重建 ≠ 原厂CAD。相机板、支架孔位及防转连接待实配；动画时长与角度不代表实测。

本页显示了什么？

黑2020框架、三层海洋板、单GC2093、两条常亮灯、MG996R、固定架、单舵臂、L角片、PP单槽/挡片、两个限位、BOX与收豆杯。机外电源沿用原接线图。

特写隐藏上部框架和相机平台，以便看清内部。展示的分类为预设结果；自动播放代演人工投豆与按KEY0。真实机器须先确认关位，再允许投豆。

外形依据与验证范围 ↗ · 信号接线 ↗

单摄 / 单槽 / 人工逐颗 / 静止拍照 / 侧摆放走H1 · 2026.10.21
