koffja/Beanlens/docs/hardware/hackathon-h2/beanlens-realistic-h2.html

BeanLens 豆鉴H2 比赛原型 ／ 拟真教学动画对照采购表 ↗

双摄光路整机装配部件拆解

恢复视角 ↺

正在准备三维模型…

槽体固定 · 只有一只舵臂带挡片转动

＋−

拖动旋转 · 滚轮缩放 · 点击部件看说明

0°挡片相对打开角

元件名称 显示遮光片 线束走向 透视侧壁沿用 H2 相对尺寸

▶ 播放演示↺ 重播速度 00.0 / 18.0 s

演示进度

01 / 06预设流程演示

# 等你放入一颗豆

人工从短槽上方放入一颗生豆。这里没有大料斗，也没有自动逐豆送料器。

K230D BOX 主屏画面示意

H02 ×2 · H31 · H33

## 为什么下面必须留空？

上相机直接拍上面，下相机透过玻璃拍另一面。PP只托玻璃边缘；后接豆斜槽把豆引到镜头后方。两张图配成一颗豆，仍只用一只舵臂。

查看中线剖面 →

外形重建 ≠ 原厂CAD。透明托片光学质量、两摄近焦/像素密度、净空与触发位置待实配；分类与时间为预设。

双摄怎样保留比赛简化？

上下两只GC2093、可拆透明托片、短PP导豆口、后接豆斜槽、下摄防撞板，及黑框/木平台、BOX、舵机与同一收豆杯。上下各两条常亮灯。

光路视图暂隐木台与遮光片；整机模式恢复木台。展示的分类为预设结果；自动播放代演人工投豆与按KEY0。真实机器须先确认关位，再允许投豆。

外形依据与验证范围 ↗ · 信号接线 ↗

双摄 / 透明托片 / 单槽 / 静止配对 / 侧摆放走H2 · 2026.10.21
