koffja/Beanlens/docs/hardware/hackathon-h3/beanlens-realistic-h3.html

BeanLens 豆鉴H3 比赛原型 ／ 拟真教学动画对照采购表 ↗

豆路与双摄整机装配部件拆解

恢复视角 ↺

正在准备三维模型…

顶入豆 → 单槽抽拉闸 → 水平双摄 → 下接豆斗

＋−

拖动旋转 · 滚轮缩放 · 点击部件看说明

0°闸片后退行程

元件名称 显示遮光片 线束走向 透视斗壁落豆段慢放12× · 非实测速度

▶ 播放演示↺ 重播速度 00.0 / 18.0 s

演示进度

01 / 06预设流程演示

# 从上方放入一颗豆

保留原本竖直豆路与水平双摄，只将五槽缩成单槽、长闸片改成小抽拉片。比赛仍人工一次一颗。

K230D BOX 主屏画面示意

H11 ×1 · H37 ×1 · H36

## 一只舵臂，怎样拉直线？

固定MG996R带一只R16直臂；两颗球头和一根50mm球心距短杆，拉动铝闸片后退约20mm。两块PP盖板与侧垫条导向，前方外壳封闭。

聚焦抽拉闸与双球头 →

外形重建 ≠ 原厂CAD。连杆、支架、短曝光和漏拍均待实测；落豆段慢放12×，分类画面为预设。

先看原豆路与H3差异

黑2020框架、顶入豆PP斗、单槽小抽拉闸、水平前后两摄、两面常亮灯、下接豆斗、主屏与普通杯。没有透明托片；不做自动逐豆送料、称重或分选。

相机先采集，闸门再放豆，不能等豆落进窗内才启动相机。局部视图隐藏框架便于看豆路；整机恢复框架和支承。自动播放代演人工动作。

豆路 / 闸门剖面 ↗ · 外形依据与验证范围 ↗ · 电源与信号接线 ↗

顶入豆 / 单槽抽拉闸 / 水平双摄 / 人工单颗 / 落豆抓拍H3 · 2026.10.21
