koffja/Beanlens/docs/hardware/revision-v4.11/beanlens-hopper-gate-v4.11.html

最新整机装配与运作演示：V4.12。 整机组装／爆炸及12页接线图 · 整个运作流程动画。本页保留历史参考，旧小过渡斗、双法兰和叠片不用于当前装配。BEANLENS · V4.11 · 2026-10-17

# 让固定方式、连续前壁和刷排都看得清楚

本版MVP改为DFRobot SEN0503 50cm对射及YU2405 24V5A主适配器。机械沿用V4.10：前壁和两侧固定封闭，闸片从后方进出。刷排位于闸片上方的五槽入口；固定槽体改PP，POM保留可拆版本备选。

5V逻辑侧TPS5450优先审核整板；6V舵机已选UBEC5A/6V，好盈30607000为可核候选。刷盒、后退片罩和球头仍需样件联合试配；这里的名义尺寸不能代替实物承重、焊接、脱毛与电气验收。机架、9块木板、双屏和四片主斗外形保留原尺寸。

闸片开度 关闭 · 前缘Y112.5缓慢开关放大 100%复原看固定看关闸看刷盒

## “法向”就是垂直板面

## 料斗怎样固定

## 连续前壁 / 开合演示

## PBT刷盒

## TPS5450 与 XL4016

## 电源接线候选

## SEN0503与YU2405 MVP接线

原厂资料：TI TPS5450 (https://www.ti.com/lit/ds/symlink/tps5450.pdf) · XL4016 (https://www.xlsemi.com/datasheet/XL4016-EN.pdf) · 好盈UBEC5A (https://oss.hobbywing.com/pdf/pdfcn/UBEC5Acn.pdf) · Ensinger材料目录 (https://www.ensingerplastics.com/-/media/Ensinger/Files/Document%20Teaser%20Files/Brochures/Shapes/Stock%20Shapes-catalog-en-2024) · DFRobot SEN0503 (https://www.dfrobot.com.cn/goods-3274.html)。资料比较不等于所购整板、PP/PBT牌号已经认证或通过验收。
