koffja/Beanlens/output/pdf/beanlens-pp-templates-v4.8-20261016.pdf

## A 主斗前/后：外面实料1:1

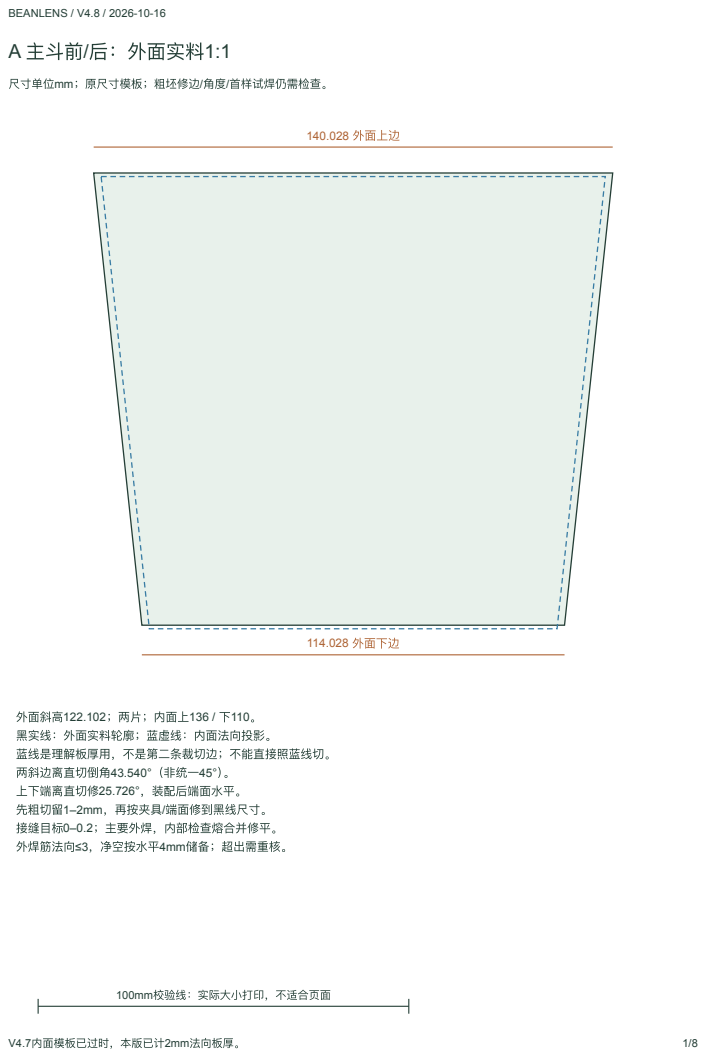
[picture p2: page 1]
BEANLENS / V4.8 / 2026-10-16; 140.028 外面上边; 114.028 外面下边; 100mm校验线：实际大小打印，不适合页面; V4.7内面模板已过时，本版已计2mm法向板厚。

尺寸单位mm；原尺寸模板；粗坯修边/角度/首样试焊仍需检查。

外面斜高122.102；两片；内面上136 / 下110。
黑实线：外面实料轮廓；蓝虚线：内面法向投影。
蓝线是理解板厚用，不是第二条裁切边；不能直接照蓝线切。
两斜边离直切倒角43.540°（非统一45°）。
上下端离直切修25.726°，装配后端面水平。
先粗切留1–2mm，再按夹具/端面修到黑线尺寸。
接缝目标0–0.2；主要外焊，内部检查熔合并修平。
外焊筋法向≤3，净空按水平4mm储备；超出需重核。

## B 主斗左/右：外面实料1:1

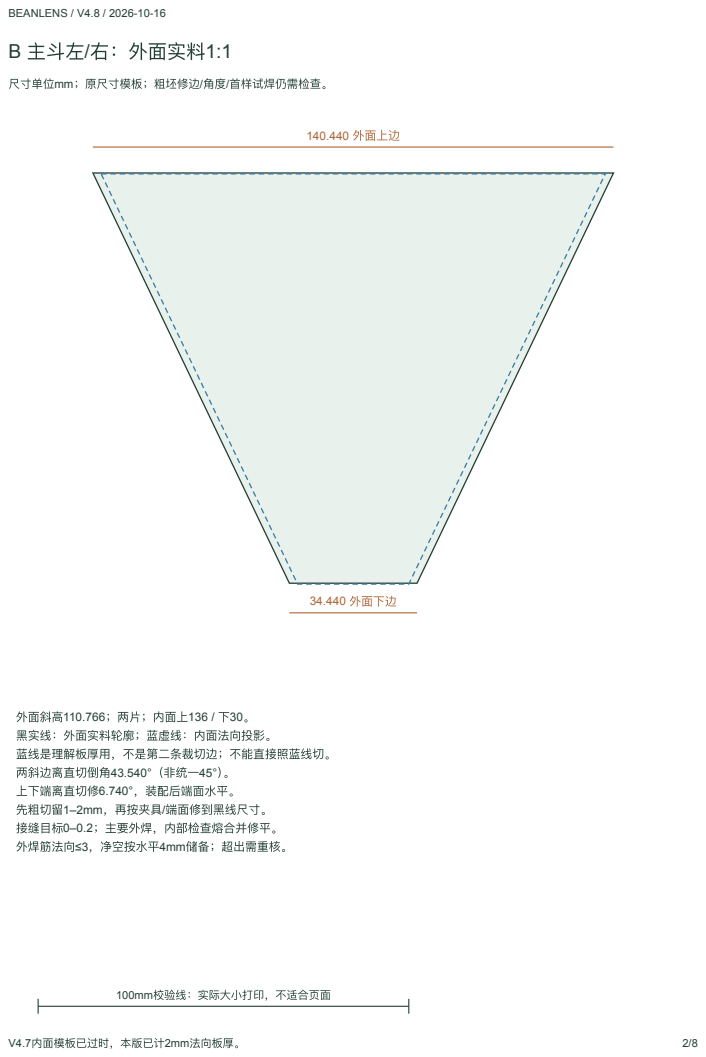
[picture p3: page 2]
140.440 外面上边; 34.440 外面下边

尺寸单位mm；原尺寸模板；粗坯修边/角度/首样试焊仍需检查。

外面斜高110.766；两片；内面上136 / 下30。
黑实线：外面实料轮廓；蓝虚线：内面法向投影。
蓝线是理解板厚用，不是第二条裁切边；不能直接照蓝线切。
两斜边离直切倒角43.540°（非统一45°）。
上下端离直切修6.740°，装配后端面水平。
先粗切留1–2mm，再按夹具/端面修到黑线尺寸。
接缝目标0–0.2；主要外焊，内部检查熔合并修平。
外焊筋法向≤3，净空按水平4mm储备；超出需重核。

## C/D 小过渡斗：2mm实料外面

尺寸单位mm；原尺寸模板；粗坯修边/角度/首样试焊仍需检查。

C 外上114.589

C 外上114.589

D 外上34.253 | D 外上34.253

C外斜高26.477；D外斜高28.566，各两片。 侧边倒角40.205°；端部C 19.872° / D 29.347°。 内口110×30→82×12；垂直高24.9，不能用旧28.7模板。
黑线只控制外面；端面和斜接须先试夹，STL含完整名义实体。

## 顶部承托法兰：PP3 / 1:1

尺寸单位mm；原尺寸模板；粗坯修边/角度/首样试焊仍需检查。

### PP3：176×196，孔136方

槽孔3.5×7径向；金属脚圆孔3.5，脚顶Z440。 孔中心全局X28.5/191.5、Y85/155；法兰顶443。
橙虚线带仅底面2×2倒角避角铝根R，不切穿。
25×25×2角铝修竖外脚22/横14，宽20，先试配。

## 可拆双法兰与密封圈：1:1

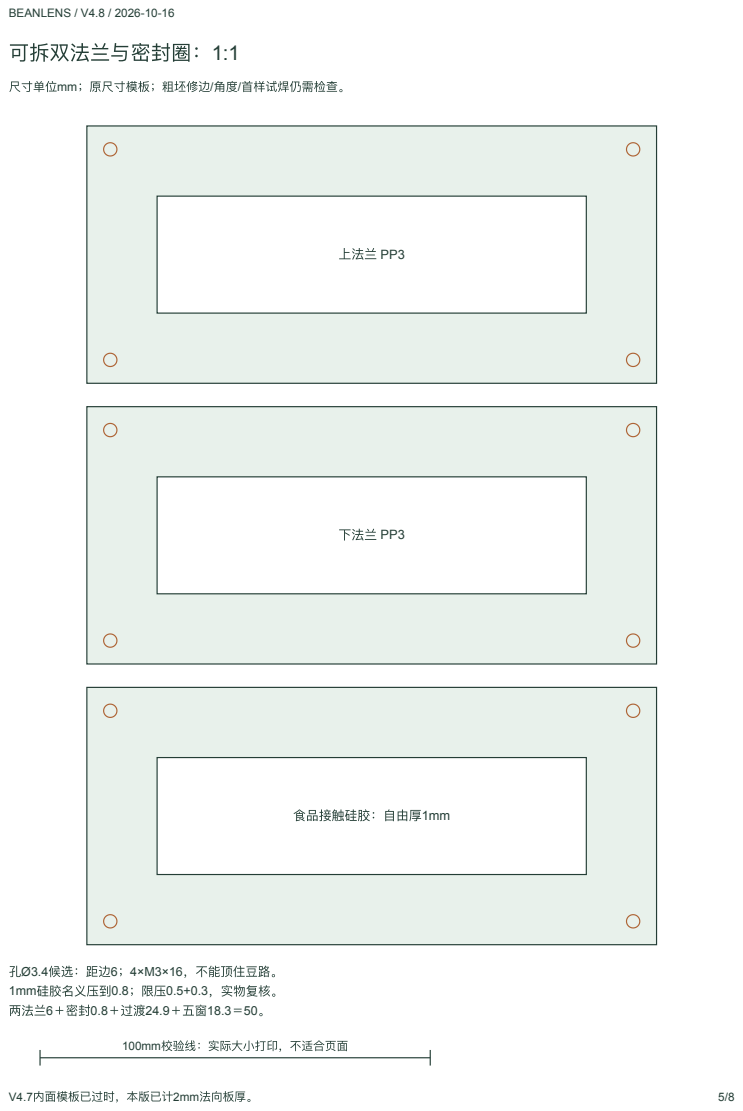
[picture p4: page 5]
上法兰 PP3; 下法兰 PP3; 食品接触硅胶：自由厚1mm; 孔Ø3.4候选：距边6；4×M3×16，不能顶住豆路。 1mm硅胶名义压到0.8；限压0.5+0.3，实物复核。 两法兰6＋密封0.8＋过渡24.9＋五窗18.3＝50。

尺寸单位mm；原尺寸模板；粗坯修边/角度/首样试焊仍需检查。

## 五窗叠片：PP3 / 1:1

尺寸单位mm；原尺寸模板；粗坯修边/角度/首样试焊仍需检查。

U1/U2：PP3，140×30，做两片

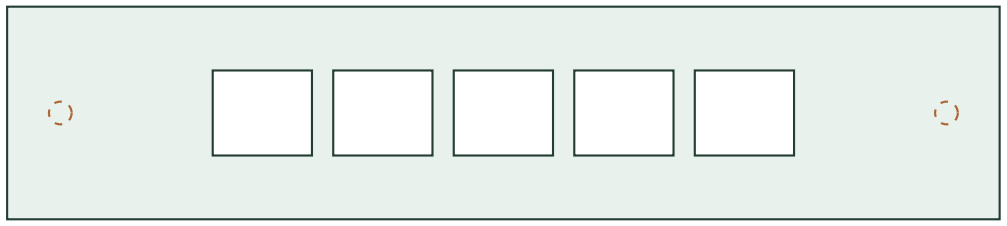
[picture p5: figure]

L1/L2：PP3，140×18，做两片

每窗14×12，筋3；X29/46/63/80/97。 上窗Y9，下窗Y3；装后全在全局Y114→126。
小斗先焊U2，完全冷却校平再叠装；不在闸片旁热焊。
红孔是候选，先量隔距与滑闸路径；做单槽再扩五槽。

## POM支承与隔距：1:1

尺寸单位mm；原尺寸模板；粗坯修边/角度/首样试焊仍需检查。

POM4：140×30，仅一 片，不焊PP

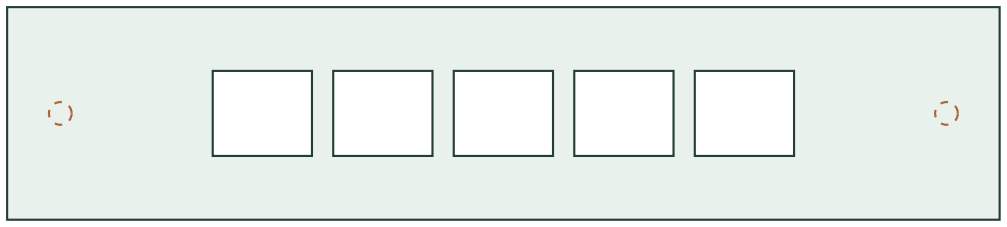
[picture p6: figure]

闸片110×45×2位于两侧隔距件之间；行程15。
名义缝2.3＝闸片2＋总余量0.3，按实测厚调。
隔距10×30×2两条＋0.3薄垫，放局部X0–10/130–140。
螺钉不穿闸片；手推不卡再接舵机；防护未冻结先不带豆。

## 双屏框/过件孔：装配参考1:1

尺寸单位mm；原尺寸模板；粗坯修边/角度/首样试焊仍需检查。

前框80×64×2

框视窗61×44候选

木板过件65.3×48.6

侧面木板过件孔40×24

外框56×38，孔先实配

前孔原点整机X77.35/Z345.7；主屏朝前。
侧孔原点整机Y68.185/Z348.16；小屏朝右，长边沿Y。
侧压框视窗33.4×18.4是候选，按有效区实物找正。
C6 M2参考孔距13.08×32；原图2.5H，不盲用M3。
这页不替代厂家孔位基准；先做纸面罩，不直接批量钻孔。
