koffja/Beanlens/docs/hardware/hackathon-h1/cut-list-h1.csv

BOM | 材料 | 裁切mm | 数量 | 说明
H14 | 黑欧标2020 | 460 | 4 | 原料460×4保留
H14 | 黑欧标2020 | 200 | 4 | 460×3各出1，400×1出1
H14 | 黑欧标2020 | 180 | 4 | 同上；另1根400不切
H16 | 海洋板6 | 176×196 | 3 | 工作台另开50×45孔
H13 | PP-H3 | 24×60 | 1 | 斜槽底板面尺寸，35°
H13 | PP-H3 | 梯形：底49.149/前高79.415/后高45 | 2 | 竖直侧支承，两片对称
H13 | PP-H3 | 80×110 | 1 | X75/Y65，开40×40落豆孔
H13 | PP-H3 | 46×18 | 1 | 侧摆挡片；厚3；圆角去毛刺
H13 | PP-H3 | 30×16 | 1 | 限位旗片毛坯，实配
H12 | 6061角铝20×20×2 | 宽12×1；宽15×2 | 3 | 挡片角件1＋固定槽底脚2
H18 | PP-H3 | 60×60 | 1 | 相机载板，孔实配
H20 | 黑PP2 | 120×100 | 2 | 侧遮光
H20 | 黑PP2 | 110×100 | 1 | 后遮光
H19 | 木/PP余料 | 176×112 | 1 | BOX固定承板，必要时裁88高
