koffja/Beanlens/docs/hardware/revision-v4.9/README.md

> 本文件为V4.9历史方案。当前连续前壁/槽内PBT/5V TPS候选与6V UBEC见 [V4.10](../revision-v4.10/README.md)，旧POM分离座不按当前主方案采购。

# BeanLens V4.9：低成本供电与连续 PP 豆路

2026-10-16，样机方案。此包替代 V4.8 的电源选型、主/过渡斗、双法兰及五窗叠片；机架、9 块木外壳、双屏及型材采购沿用 V4.8。不是整机已经完成实物验收的新加工图。

## 打开图纸

- [四页可放大接线/豆路示意](beanlens-power-and-feed-v4.9.html)
- [完整采购表](../procurement-v4.9/beanlens-procurement-v4.9.html)
- [PP 四片外面控制尺寸 CSV](pp-panel-cuts-v4.9.csv)
- [数据与验算基线](design-v4.9.json)
- [A3 打印图册](../../../output/pdf/beanlens-power-and-feed-v4.9-20261016.pdf)

## 电源推荐：常见器件，留出调试与散热空间

外置航嘉 HKA12024050-7B，24V/5A/120W。厂商已核电压电流，插头尺寸、极性、交流入口形式与包装电源线仍按所购 SKU 核实，不能从型号尾缀猜。优先购买正规全新、适用当地认证与成品电源线的完整适配器；电源自身的外壳不拆。

两块 XL4016E1 恒流恒压双散热降压板分别调 5.00V / 6.00V。XL4016E1 是芯片型号，淘宝整板没有统一型号；询价必须带工况、尺寸、散热与电容要求，而非只搜“8A”。选输入电容 50V、适配 24V 输入、端子接受 0.75mm² 铜线的板，采购包络先按每块不大于 65×55×30mm。卖家须确认连续目标 24→5V/4A 与 24→6V/3A；6V/5A 短峰另验。CC 电流限值必须依整板说明和负载测试设定，不能用舵机堵转当电子负载。

原 Pololu D36V50F5/F6 更紧凑、原厂规格更完整，可作已购/高预算备选。廉价大板需要独立低压电源盒；不按原机背 21mm 深度硬塞。建议 ABS 外形 200×150×80 起点、约 170×120 安装板，外形并不保证实际可用内腔；按到货盒柱、端子与线弯曲复核。预留通风，必要时 5V 40×40×10 风扇；风扇计入逻辑 4A 总预算。外置适配器也在机外。成品插排开关作总电源，取消默认购买 NKK S1A；这不是硬件急停，也不保证失电自闭。

P05 改德力西 TB-1506 / DHATB1506N 两条。每条 73.5×22×17.5mm，原厂载流规格 15A、导线 0.5–1.5mm²、M3 螺钉。TB-A 仅安装两段配套 3 位短接片：1–3 正、4–6 负；两个组之间不连。TB-B 不装桥，1=5V+、2=5V返回、3=6V+、4=6V返回、5/6空。每个负载回各自降压输出，不额外桥输出负极。两个非隔离模块已有共同参考，不能称电源隔离。不要在一个螺钉下堆三四根线。

TB 配 M3 叉形/环形压接端子（如 UT0.75-3 / OT0.75-3，按供货尺寸）；模块笼式端子用合适管形端头，两种端头不能混为一谈。24V 输入、降压、舵机回路用 0.75mm² 铜线起点。5V 被动配电板要有双 USB-A 与独立辅助 5V/GND 焊盘或端子；总承载至少 4A，不是 PD 诱骗模块。辅助口供低压对射，电容用配电焊盘，不能把无关电压正极并接。

保险：主 4A、灯支路 2A、5V 降压输入 2A、6V 降压输入 3A，均 MINI 32VDC 配匹配座；灯支路改2A以便统一常见规格，仍是保护0.75mm²线路。安装在正线靠近支路起点，保险和线材配合仍要试验，不负责舵机卡豆停止。1000µF/16V 电解在舵机近端，470µF/10V 在逻辑 5V 端，极性正确；100nF 作旁路。电源端 XT30 方向按实物保证导体不裸露。24V 灯线与 6V 舵机线用不同接口并贴电压标签。

图 2 的 W01–W17 是逐线端到端表。GPIO2 / 50Hz 来自项目拟定基线，3.3V PWM 接受能力待测；需要时用 O01 单向缓冲。舵机电流不经过 C6 地针、5V 引脚或杜邦线。称重 NAU7802 仍用 C6 的3.3V/GND（新增外设35mA预算待测），不接5V/6V；传感器激励从称重模块按原基线连接。两板 UART 仅 TX/RX/GND，绝不互接 5V；短信号地不是负载回流线。电脑调试时先断开该板外部 5V，避免两路 USB VBUS 并供。

预算按降压效率 80%：5V×4A /0.8 + 6V×3A /0.8 + 灯8W + 其他24V预留1W = 56.5W。舵机短峰 5A 时 71.5W，24V 输入约 2.98A。120W 适配器有预算余量，但廉价板的热性能、短峰、压降都未验收。输入保险 3A 与短峰时长及上电浪涌须配合实测，不能只凭计算宣布通过。

### 淘宝搜索与估价（非卖家报价）

|物料|搜索关键词|估价人民币|
|---|---|---|
|24V适配器|航嘉 HKA12024050-7B 24V5A|100–150|
|降压板×2|XL4016 恒流恒压 双散热 50V电容|共24–50|
|端子排×2及桥条|德力西 TB1506 配套3位短接片|共10–25|
|保险及座|32V MINI 插片保险座|15–25|
|电线/压接/接口|0.75平方铜线 UT0.75-3 XT30|15–35|
|5V配电/短USB线|双USB母座 被动配电 辅助焊盘|10–25|
|电容|1000uF16V 470uF10V 低ESR|2–6|
|盒/板/支柱|ABS接线盒 200 150 80|20–45|
|可选风扇|5V 4010|5–12|

总包粗估约 200–370，不含工具、运费及选购风扇，为逐项估价范围取整；不是已核实的淘宝购物车总价。BOM 未报价项仍为 null，不能按 0 元相加。若适配器不含交流线或需新购插排则另计。若已有明纬/Pololu 则优先复用，不能假定再买一套更省钱。

## PP：建议焊一个连续漏斗，闸门保持可拆

旧方案叠片是为了薄片易裁、分层调间隙，双法兰是为了分段制作/拆洗；都不是五槽结构的必需功能。若能获得 PP6 与 POM10 的 CNC 加工，建议上斗与小过渡斗合并，四片 PP2 连续斜板焊为一体，底端外侧围焊到一块 PP6 上座。取消中间双法兰、硅胶垫和连接螺栓。顶 PP3 承托法兰仍保留，它承担悬挂，不是多余的豆路接头。

新内口 136×136，Z440；底口 82×12，Z298.3；垂直高 141.7。法向板厚 2，外顶口 140.072×140.366，外底口 86.072×16.366。前后片外面梯形：上140.072/下86.072/斜高154.670，各1；左右片：上140.366/下16.366/斜高144.249，各1。CSV 是外面控制尺寸，不是四边直切后直接对接的净料模板。斜边需配合相邻面的坡口，端边切至水平端面；焊缝收缩不是通用固定加量。

先用边角料做相同2mm坡口试片，确认枪嘴、流量、温度和焊条相容性；采用同牌号 PP-H 焊条，温度以材料/焊枪资料和试片为准。用 136口/82×12底口及141.7高的胎具定位；对角点焊、复测两口和扭曲，再分段交替外焊。底部在同样定位下焊到 PP6 上座，冷却后量上座平整度，整组放入机框试配。避免内侧留焊瘤挂豆；焊枪显示温度不代表焊缝已熔合。没有试片与实测收缩前，不直接按 CSV 批量加工。V4.8 的八片 STL/A4 模板不再用于此连续斗。

PP6 上座外形 140×30×6，底Z292.3；POM10 下座140×18×10，顶Z290。两者各加工5个14×12通孔，隔肋3，内角R1.5暂定；全局孔起点X69/86/103/120/137，Y114。闸片110×45×2，15行程，拟定闸缝2.3。POM下座18深是为避开后导轨，不能随手改成30深的全厚矩形。下座、闸片、两条隔距块用螺栓可拆，不能把移动槽和润滑导向焊死；POM也不能直接与PP热风熔焊。

G21 两端隔距块先按10×18×2加0.3调垫；下支脚候选3mm。夹紧螺栓M3×30只是25.3mm名义堆叠的起点，孔位/螺母/垫片/脚座实量后定。PP6先焊后量平整，不能带着闸片焊。安装后须验证整段行程不夹紧、所有五孔同开同关；2.3mm是初试间隙，不是已验证公差。厚料CNC可能有最低加工费，减少零件不等于首台一定更便宜。

以原双屏服务包络与外焊筋横向4mm限界重算：前约15.4、侧约14.4mm。不是完整线缆碰撞审查。新斗名义容积约1.222L，实际1kg豆所需容积必须用用户豆样验证。大斗压向82×12五窗处仍可能架桥，先做单槽带豆样机，不依据空载动画宣布送料成功。

## 保留与未完成项

- 黑欧标2020仍460×4、200×6、180×8；已有460×7/400×2时仍补净长180×4。9片6mm木外壳、双屏安装位置沿用V4.8。
- G10连杆耳共面高度、G20退片全行程防护仍需实物试配。光束Z277与底座/下脚/螺栓避让仍未完成验收；不要据本页宣布无干涉。
- 本包不重新发布完整十页整机爆炸图；旧图中的电源/双斗/叠片按本包替换，框架与屏幕尺寸可继续查旧图。不得混用旧PP模板。
- 关闭速度可以由PWM目标角分步缓慢变化实现；缓关不等于限力。限位/超时/卡豆退出必须单独验证，不能持续堵转。

## 原厂资料

- [航嘉24V/5A型号](https://en.huntkey.com/erp-information/huntkey/hka12024050-6b-hka12024050-7b/)
- [XL4016数据手册](https://www.xlsemi.com/datasheet/XL4016-EN.pdf)：芯片资料，不是淘宝整板认证。
- [德力西TB端子目录](https://www.delixi-electric.com/u/cms/delixi/201805/09095528ac23.pdf)：TB-1506 / DHATB1506N。
- [TI缓冲器](https://www.ti.com/product/SN74AHCT1G125)
