koffja/Beanlens/docs/hardware/procurement-v4.5/beanlens-procurement-v4.5.html

历史版本：当前设计已升级V4.8。取消木斗壳、重算PP板厚/斜接并拆清双屏。打开V4.8组装与双屏净空；旧模板不作当前下料。

BEANLENS / PROCUREMENT REVISION · 2026-10-12

# 把规格写清，再下单

采购修订 V4.5：逐项复核旧表35项，拆出新闸门与接线小件。型号参照、用户报价、毛坯规格和未冻结孔位分别注明。它是样机询价/采购清单，不是已验收加工图。

## 2026-10-16：V4.7内嵌木板与可热焊PP料斗

左/右/后三面木板下延，板块内嵌，四角与腰线露出黑色2020。F03改800×600一张，或两张600方二选一；新增F11背托。F04改PP-H2，净136方到110×30；F05为小过渡斗和上下五窗，G12改POM140×30×4，新增F12焊材和G21隔距。型材补料仍为同规格黑色180×4。

详细裁切/热焊/五槽步骤与6页A4模板 · 完整组装与7页A3尺寸图。新孔位、焊缝和后罩仍需纸样/实物确认。

¥386.90主方案已知用户报价小计

¥103.00HJ-AZ4-3kg 候选报价，另列

89项全表含备选、已有与加工件

总价未定缺价未按0元计算；旧790.90不是新总价

### 红外：低压接口更简单

首样建议 Adafruit 2167 一组：5V供电，接收信号经10kΩ上拉至C6的3.3V，再接GPIO20。山大斯 B3F-20C1保留备选；未取得确切接线资料，不能按相似型号认定输出。

### 闸门：补齐完整滑架

16mm曲柄＋60mm双球头杆＋15mm行程；增加120×30×3滑架转接板，左右MGN9H、封闭槽盒、支承框和限位。10×10角铝作为加强/连接件，不能独自代替转接板。

### 称重：型号有了，适配还需确认

用户提供 HJ-AZ4-3kg、103元，列为待核候选。确认含哪些支架、实际敏感元件型号、输出与激励。原L6J1参考是0.9mV/V、推荐5–10V；不直接接现拟定3V激励。

## 完整采购明细

“主方案”表示本次建议的采购路径，不表示已购或验收；“暂缓下单”须先补齐对应资料。“标准规格待报价”也应先核供应商规格。所有数量为首台起点，紧固件含少量备件。图表可横向滚动。

清除筛选

编号 / 旧项 | 物料 / 方案 | 型号、规格与来源 | 数量 | 下单状态与核对事项 | 单价依据
A01旧：A01 | 视觉主套件板卡与相机 · 主方案 | 正点原子 DNK230D / K230D BOX BOX＋2.4英寸屏＋32GB TF；以257元订单包装为准 资料1 (https://wiki.alientek.com/docs/Boards/Kendryte/DNK230D/start-guide/k230d-box-introduction/) | 1 件 | 按订单核对 只买BOX套件；附送普通相机不抵扣另选双摄。 | ¥257.00用户报价：整套257元
E01旧：E01 | 控制板（已有）板卡与相机 · 已有 | Waveshare ESP32-C6-LCD-1.47 非Touch 已有1.47英寸LCD板，不能换成Touch/S3同名近似板 资料1 (https://www.waveshare.com/wiki/ESP32-C6-LCD-1.47) | 1 件 | 复用，不重复购买 | ¥0.00用户已有
E02旧：E02 | BOX屏幕与TF板卡与相机 · 套件包含 | 随A01套件 2.4英寸屏＋32GB TF，包含在A01中 资料1 (https://wiki.alientek.com/docs/Boards/Kendryte/DNK230D/start-guide/k230d-box-introduction/) | 1 件 | 确认套件包装 | ¥0.00计入A01，不代表已经收货
B01旧：B01 | 两只视觉相机板卡与相机 · 主方案 | GC2093-M12-90度无畸变（用户型号） 同批两只，M12镜头；90°定义、IR-cut、近焦及CSI线序未核 资料1 (https://wiki.alientek.com/docs/Boards/Kendryte/DNK230D/start-guide/k230d-box-introduction/) | 1 两套合包 | 兼容确认后下单 两套合计114.32元；传感器+镜头描述不是完整PCB料号。先让卖家确认BOX双路同时工作及约75mm近焦。 | ¥114.32用户报价：两套合计
B02旧：B02 | 双摄排线板卡与相机 · 主方案 | BOX专用CSI/MIPI排线（原厂配套） 150–200mm仅询价起点；针数、间距、同/异面、线序按BOX与模组图 资料1 (https://wiki.alientek.com/docs/Boards/Kendryte/DNK230D/start-guide/k230d-box-introduction/) | 2 件 | 暂缓：线序/长度待核 先纸样量实际路径；若B01含匹配线，取消本项，绝不凭通用15/22pin购买。 | 待询价待询价；不沿用旧打包额度
A03旧：A03 | 位置舵机滑闸标准件 · 主方案 | MG996R 角度/位置版 独立6.0V；原厂外形约40.7×19.7×42.9mm仅参照；兼容件实量 资料1 (https://towerpro.com.tw/product/mg996r/) | 1 件 | 花键/电流待试装 不要连续旋转版。25T舵臂必须和用户实物试装；禁止套原厂性能给廉价兼容件。 | ¥15.58用户报价
PH01旧：A04 | 首样红外对射光电与信号 · 主方案 | Adafruit 2167，3mm IR break-beam 3.3–5.5V；约250mm距离；响应<2ms；开集电极；每头约20×10×8mm；线230mm 资料1 (https://www.adafruit.com/product/2167) · 资料2 (https://learn.adafruit.com/ir-breakbeam-sensors/arduino) | 1 收发对 | 标准规格待报价 建议5V支路供电；信号单独上拉3.3V。用于豆流提示，不是逐豆计数；需测光束覆盖与IR干扰。 | 待询价待询价；不沿用旧打包额度
PH02旧：A15 | 对射信号上拉光电与信号 · 主方案 | 金属膜电阻10kΩ，1%，0.25W 一只使用、一只备用；信号节点拉到C6 3.3V 资料1 (https://www.adafruit.com/product/2167) | 2 件 | 标准规格待报价 不能按5V Arduino图把上拉接到红线5V。开集电极没有主动输出5V。 | 待询价待询价；不沿用旧打包额度
PH03旧：A15 | GPIO串联电阻光电与信号 · 主方案 | 金属膜电阻1kΩ，1%，0.25W 信号至GPIO20串联；与PH02同一3.3V输入节点 工程规格 / 用户输入 | 2 件 | 标准规格待报价 一只用一只备用；不是24V工业输出的降压替代。 | 待询价待询价；不沿用旧打包额度
PH04旧：B14 | 红外可调安装耳光电与信号 · 主方案 | 6061角铝30×20×2，切长30mm 两头各一只；安装孔按2167实物；带可调长孔/遮光罩 工程规格 / 用户输入 | 2 件 | 纸样后加工 放在出口下、主视野上方，主体避开相机视野；不能被五槽隔板挡住。 | 待询价待询价；不沿用旧打包额度
I01旧：A04 | 原工业对射器工业光电备选 · 备选 | 山大斯 B3F-20C1（用户提供，未核原厂资料） 旧商品图6–36V/M12×1/约52.5mm仅待复核；收发一组的组成待核 工程规格 / 用户输入 | 1 组 | 暂缓：确切接线资料缺失 不擅改成E3F或推断NPN/PNP/激光/红外。若已购可保留，接口确认后再选转换方案。 | 待询价待询价；不沿用旧打包额度
I02旧：A15 | 24V NPN转换光耦工业光电备选 · 备选 | LITEON LTV-817，DIP-4；分档按供货图 输入LED与24V限流电阻串联；输出集电极上拉3.3V、发射极接C6地 资料1 (https://optoelectronics.liteon.com/upload/download/ds-70-96-0016/ltv-8x7%20series%20201610%20.pdf) | 1 件 | 暂缓：先确认NPN低端输出 此为代焊小板用料，不是现成合格模块。PNP不能照接；漏电、动作逻辑、总延迟须台架测。 | 待询价待询价；不沿用旧打包额度
I03旧：A15 | 光耦输入限流工业光电备选 · 备选 | 4.7kΩ 1% 0.5W电阻 24V下约4.8mA，电阻约0.11W；按真实传感器残压/漏电复核 工程规格 / 用户输入 | 1 件 | 随I02接口复核 仅24V已确认NPN低端输入设计；不能拿GPIO上拉电阻代替。 | 待询价待询价；不沿用旧打包额度
I04旧：A15 | 光耦LED反向保护工业光电备选 · 备选 | 1N4148，DO-35 与光耦输入LED反并联 工程规格 / 用户输入 | 1 件 | 随I02代焊 极性和光耦引脚按所购器件数据表；输出上拉见I06、代焊绝缘安装见I07。 | 待询价待询价；不沿用旧打包额度
I05旧：B14 | 工业光电固定件工业光电备选 · 备选 | M12×1螺母＋可调L形支架 收发各1支架、每头2螺母；不与PH04重复 工程规格 / 用户输入 | 2 套 | 暂缓：安装尺寸待核 B3F-20C1标签、机身与出线尺寸核对后采购。 | 待询价待询价；不沿用旧打包额度
B03旧：B03 | 称重ADC模块称重 · 主方案 | SparkFun Qwiic Scale NAU7802，SEN-15242 3.3V模块；I²C地址0x2A；芯片24bit；拟定VDDA约3.0V/10SPS 资料1 (https://www.sparkfun.com/sparkfun-qwiic-scale-nau7802.html) | 1 件 | 暂缓：需与称重桥配套 不是把裸NAU7802芯片直接接线。若HJ-AZ4为数字输出，本项不买；若桥要求5V激励，需另审ADC参考/激励，不直接外接5V到此模块。 | 待询价待询价；不沿用旧打包额度
W01旧：B04, O05 | 用户提供称重候选称重 · 备选 | Autoda HJ-AZ4-3kg 额定3kg；103元；输出、敏感元件料号、支架/平台包含范围均待核 资料1 (https://www.autoda.com.cn/jishuzhich/) | 1 件 | 暂缓：接口/图纸待核 当前用户候选，不把3kg改称1kg。HJ-AZ4可能是组件/安装规格，需敏感元件铭牌；未查到可确认此SKU的原厂数据表，不能承诺±0.1g。 | ¥103.00用户最新报价103元；替代旧55/105元记录
W02旧：B04 | 旧1kg外形参照（不默认购买）称重 · 备选 | Zemic L6J1-C2-1kg 0.9±0.1mV/V；推荐5–10V；综合误差≤±0.028%FS 资料1 (https://www.zemiceurope.com/media/Documentation/L6J1_Datasheet.pdf) | 1 件 | 暂缓：激励与精度不匹配 原3V/2mV/V示例不能套此型号；0.028%×1kg=0.28g，不能据此保证±0.1g。1kg毛载荷也不能收1kg豆+平台。 | 待询价待询价；不沿用旧打包额度
W03旧：B05 | 参考砝码100g称重 · 主方案 | OIML R111 F1不锈钢，100g 有修正值/可核查证书；参考质量扩展不确定度≤0.03g 资料1 (https://www.oiml.org/en/files/pdf_r/r111-1-e04.pdf) | 1 件 | 标准规格待报价 等级标签不是校准证据；与500g分别询价。 | 待询价待询价；不沿用旧打包额度
W04旧：B05 | 参考砝码500g称重 · 主方案 | OIML R111 F1不锈钢，500g 与W03同要求；带盒/镊子或手套 资料1 (https://www.oiml.org/en/files/pdf_r/r111-1-e04.pdf) | 1 件 | 标准规格待报价 检查点0/100/350/500g；350g由W03、W08、W09的校准质量组合，不用待测秤证明参考质量。 | 待询价待询价；不沿用旧打包额度
W05旧：B06 | 轻称台板称重 · 主方案 | 6061-T6，170×180×2mm毛坯 约165.24g；载荷端连接孔按所选组件图 工程规格 / 用户输入 | 1 件 | 暂缓：称重组件定后加工 盒+活动支承总目标≤250g；本板留下约84.8g给盒与活动连接件。若HJ套件含合适平台，本项取消。 | 待询价待询价；不沿用旧打包额度
W06旧：B06 | 称台刚性底板称重 · 主方案 | 6061，180×190×4mm毛坯 固定到2020底梁；固定端孔距按称重件图 工程规格 / 用户输入 | 1 件 | 暂缓：称重组件定后加工 固定底板不计入秤的活动毛载荷；若套件包含合适底板，不重复购买。 V4.6先核底角码净空：四角约25×25mm为纸样核对区，紧凑角码完全在梁宽内可不切角；超出梁内缘再按固定孔决定避让，不是冻结缺口。不得顶住活动称台/传感器自由端。 | 待询价待询价；不沿用旧打包额度
W07旧：B06, O06 | 安装垫块/过载限位称重 · 主方案 | M4×20调节螺钉4只＋M4螺母8只；硬质垫块按图 限位正常不接触活动称台；间隙依传感器额定位移 工程规格 / 用户输入 | 1 组 | 暂缓：所购组件图待核 若103元套件已经含此结构则取消；旧另加50元差价作废，不推算103元包装内容。 | 待询价待询价；不沿用旧打包额度
A05旧：A05 | 同批固定色温灯带照明 · 主方案 | 用户普瑞Ra98灯带：完整SKU待提供 24V，6000K/Ra≥98询价目标；4×100mm有效段，总0.4m；≤20W/m预算 工程规格 / 用户输入 | 1 件 | 暂缓：功率/宽度/切点待核 普瑞/Ra98不是完整型号；要每米功率、实际PCB宽、切点及短曝光实拍。不可擅换5000K并沿用原色温记录。 | 待询价待询价；不沿用旧打包额度
L02旧：A06 | 灯铝散热槽照明 · 主方案 | 6063 U型铝槽，4×100mm起点 内宽≥实测灯带宽；候选外宽14×高8mm，带扩散片 工程规格 / 用户输入 | 4 件 | 灯带尺寸定后切割 100mm必须是灯带切点整数倍；如果需125mm段，先重算总长功率。扩散/遮光不能接触豆路。 V4.7灯槽X24/182候选，避开140宽槽盒/导轨底座，光向中心调整后复测。 | 待询价待询价；不沿用旧打包额度
L03旧：A06 | 遮光边与灯固定照明 · 主方案 | 0.5–1mm哑黑PP片＋M3夹持件 遮光条约100×15mm，4条纸样起点 工程规格 / 用户输入 | 1 组 | 按光路纸样加工 防止LED直射镜头；不靠木板给灯散热，胶/夹具不进入豆路。 | 待询价待询价；不沿用旧打包额度
A07旧：A07 | 外置主适配器电源与配电 · 主方案 | MEAN WELL GST120A24-P1M 24V/5A/120W；P1M 5.5外径×2.5内径×11mm，中心正 资料1 (https://www.meanwell.com/Upload/PDF/GST120A/GST120A-SPEC.PDF) | 1 件 | 接头/渠道核对后采购 满足原≥24V4A预算的具体候选，不是已购；必须配原厂图确认极性、插座DC额定。 | 待询价待询价；不沿用旧打包额度
P02旧：A07 | 适配器交流线电源与配电 · 主方案 | 中国三插→IEC C13成品电源线 3×0.75mm²或以上，1.5m起点，额定≥250V/10A 工程规格 / 用户输入 | 1 件 | 标准规格待报价 只接外置适配器，机箱内不布交流；若适配器已含则取消。 | 待询价待询价；不沿用旧打包额度
P03旧：A09 | 24V输入插座/转接线电源与配电 · 主方案 | 5.5×2.5mm母座，DC≥30V/5A 与P1M匹配；带0.75mm²短线，中心正 工程规格 / 用户输入 | 1 件 | 与A07接头配套 不能用5.5×2.1mm母座或仅标交流额定的小插座替代。 | 待询价待询价；不沿用旧打包额度
A08旧：A08 | 固定5V降压电源与配电 · 主方案 | Pololu D36V50F5，#4091 24V输入→5V；25.4×25.4×9.5mm；标称等级5.5A，实际按热曲线 资料1 (https://www.pololu.com/product/4091) | 1 件 | 标准规格待报价 首样目标带载4A；5V输出公差4%仍需测板端压降/瞬态。不能照旧18元XL4015额度核价。 | 待询价待询价；不沿用旧打包额度
A17旧：A17 | 固定6V舵机降压电源与配电 · 主方案 | Pololu D36V50F6，#4092 24V输入→6V；25.4×25.4×9.5mm；输出公差4% 资料1 (https://www.pololu.com/product/4092) | 1 件 | 标准规格待报价 持续3A/短时5A是验收预算；与5V模块不能插错，高电流直焊粗线不经面包板。 | 待询价待询价；不沿用旧打包额度
P04旧：A09 | 主低压开关电源与配电 · 主方案 | NKK S1A，SPST ON-OFF 原厂DC30V/20A等级；面板安装尺寸依原厂图 资料1 (https://www.nkkswitches.com/pdf/Toggles.pdf) | 1 件 | 标准规格待报价 只断24V低压正极；面板6mm需安装衬板/确认螺纹夹紧范围，不盲买开孔尺寸。 | 待询价待询价；不沿用旧打包额度
P05旧：A09 | 分线端子电源与配电 · 主方案 | WAGO 221-415 五路弹簧端子 0.75mm²铜线适配；24V+/返回、5V+/返回、6V+/返回各一组 资料1 (https://www.wago.com/global/installation-terminal-blocks-and-connectors/compact-splicing-connector/p/221-415) | 6 件 | 标准规格待报价 6组分别标电压与返回，不短接5V和6V；大电流回路星形，端子固定座另配。 | 待询价待询价；不沿用旧打包额度
P06旧：A09 | DC保险与座电源与配电 · 主方案 | MINI车用插片保险，32VDC；匹配保险座 主4A、灯1A、5V降压输入2A、6V降压输入3A各1；同规格各1备用 工程规格 / 用户输入 | 1 4座+8保险 | 标准规格待报价 DC额定≥32V，座/引线≥5A；按浪涌线径验后调整，不称夹豆保护，不沿用旧2.5A到不兼容规格。 | 待询价待询价；不沿用旧打包额度
P07旧：A09 | 电源铜线电源与配电 · 主方案 | 多股铜0.75mm²，红/黑 红3m＋黑3m起点；24V主回路和6V舵机回路 工程规格 / 用户输入 | 1 6m | 标准规格待报价 按实际裁切、留压接余量；不以杜邦信号线承载舵机电流。 | 待询价待询价；不沿用旧打包额度
P08旧：A09 | 压接/绝缘固定小件电源与配电 · 主方案 | 0.75mm²管形端头＋热缩管＋扎带/固定座 端头20只、φ3/φ6热缩各1m、扎带20只起点 工程规格 / 用户输入 | 1 组 | 标准规格待报价 端头口径按铜线与端子匹配；与电源采购不可漏列。 | 待询价待询价；不沿用旧打包额度
C01旧：A10 | 6V近端电容电源与配电 · 主方案 | 铝电解1000µF/16V，105℃低ESR 径向，优先直径≤10mm、高≤20mm；实际按供货图 工程规格 / 用户输入 | 1 件 | 标准规格待报价 并在6V/GND，极性正确；电容和降压启动稳定性需配套测试。 | 待询价待询价；不沿用旧打包额度
C02旧：A10 | 5V近端电容电源与配电 · 主方案 | 铝电解470µF/10V，105℃低ESR 实际封装/脚距按供货图；并在5V/GND 工程规格 / 用户输入 | 1 件 | 标准规格待报价 电容不补足电源容量，不接24V侧。 | 待询价待询价；不沿用旧打包额度
C03旧：A10 | 去耦电容电源与配电 · 主方案 | 100nF，X7R，≥50V，直插或带板焊接 10只小包；6V/5V近端、红外、可选缓冲按布局分配 工程规格 / 用户输入 | 10 件 | 标准规格待报价 数量是整机公用库存，其他模块不要再重复按包计价。 | 待询价待询价；不沿用旧打包额度
P09旧：A11 | USB供电转接电源与配电 · 主方案 | 双USB-A母口被动5V配电板 输入5V，铜线与端子总承载≥4A；每口至少所接板要求 工程规格 / 用户输入 | 1 件 | 暂缓：具体板/走线载流需核 不是24V车充/快充触发板。不能仅凭双口就宣称4A；也可用经确认的两条独立板卡电源线替代。 | 待询价待询价；不沿用旧打包额度
P10旧：A11 | 两板USB电源线电源与配电 · 主方案 | USB-A→USB-C成品短线 约0.3m、每线≥3A标称，实测压降；BOX与C6各1根 工程规格 / 用户输入 | 2 件 | 标准规格待报价 电脑调试时避免双电源反灌，保留原厂规定的供电口。 | 待询价待询价；不沿用旧打包额度
F01旧：B07 | 黑色欧标2020型材：连续立柱V4.6机架与外壳 · 主方案 | 黑色阳极氧化欧标2020，与已有型材同截面/槽型/壁厚 黑色欧标2020：最终460×4、200×6、180×8mm，18根净4.48m；已有黑色460×7/400×2，补购同规格黑色净长180×4 工程规格 / 用户输入 | 1 18段 | 量现有净长/槽型后配套下单 按frame-v4.6切料：460×4留整，460×3各切200+200，400×2各切180+180；每刀3mm时共锯屑30、余料230mm。只补180×4成品；或750原料切4×180二选一。旧440高切单废止，不混用。 用户已确认现有型材为黑色欧标2020；不要补银色或其他槽系。 | 待询价待询价；不沿用旧打包额度
F02旧：B07 | 型材连接件机架与外壳 · 主方案 | 欧标2020配套两孔90°带筋角码（黑色优先）＋配套M5螺钉/T螺母 28角码使用＋4备用＝32套；每套螺钉2/T螺母2，各64只；螺钉M5，长度按配套图 工程规格 / 用户输入 | 1 组 | 先核槽口与角码实物图 上下框16、中框8、相机梁4；内侧装，不需要三通/四通方块。配用户已有黑色欧标2020；槽宽/定位凸起实量，优先原卖家配成套。不要按此前item槽5参照盲买；M5长度按角码厚度/槽深确定。F08穿板件另列。 V4.7中框前后180梁改在外侧柱面Y0/220，按钮移到Z273；角码数量仍28用32购。 | 待询价待询价；不沿用旧打包额度
F03旧：B08, B10 | 木质支架与外壳板料机架与外壳 · 主方案 | 6mm海洋板，800×600mm主排版；或2张600×600 9片内嵌外壳：176×112×2、196×112×2、196×280×2、176×197×1、176×58×2；木斗158×110×2、146×110×2；托耳40×30×2，均厚6 工程规格 / 用户输入 | 1 件 | 暂缓：最终开孔未冻结 800×600一张有保守排版；若已买600方，追加一张600方走双板备选，不重复买800板。内嵌留边缝约2、板面内凹1；最终孔先角样。见制作V4.7/装配第03页。 | 待询价待询价；不沿用旧打包额度
F04旧：B08 | 热焊PP主斗与上口圈机架与外壳 · 主方案 | 自然色可焊PP-H，2mm，A3 297×420；食品接触资料可核 2张含试片；净上136×136、净下110×30、高110；前后上136下110斜高122.102×2；左右上136下30斜高110.766×2；口圈158方开136方孔 资料1 (https://www.simona.de/fileadmin/user_upload/Medien/Mediacenter/Verarbeitungshinweise/202310_SIM52001EN_WI_Schweissen_web.pdf) | 2 张 | 纸样后裁切 替代原0.5mm薄内衬，不以宽嘴热风枪直接吹薄片。模板是内面控制线，2mm坡口/焊筋先试夹。四片热焊，口圈坐木壁顶Z440、圈顶442；木壳改158方内146，给焊缝留量。 | 待询价待询价；不沿用旧打包额度
F05旧：B08 | 五窗叠片与小过渡斗板料机架与外壳 · 主方案 | 可焊PP-H3mm 300×300一张；PP2过渡片用F04余料 上五窗140×30×3两片；下五窗140×18×3两片；接环124×44×3开110×30；小过渡净110×30→82×12，高28.7，四片PP2 工程规格 / 用户输入 | 1 张 | 暂缓：新槽盒开缝定后加工 5×14＋4×3＝82；不是4条50mm高整隔板横穿闸片。窗口X29/46/63/80/97，宽14深12；上片Y9、下片Y3。先单片/单槽试装，焊接固定斗，叠片用螺栓；见V4.7原尺寸模板。 | 待询价待询价；不沿用旧打包额度
F06旧：B10 | 屏与板卡托架机架与外壳 · 主方案 | 6061板，200×200×2mm毛坯＋尼龙柱/外侧夹持件 同一毛坯裁电控160×130×2、BOX夹持板80×60×2、C6夹持板60×35×2各1；均先不钻孔 工程规格 / 用户输入 | 1 两套 | 暂缓：实物孔位待核 三个尺寸是托板毛坯，不是PCB孔距；后托板经绝缘柱装后检修木板，断电检修。BOX服务深度约35；C6避天线。按实物摆模块后冻结孔。 V4.7后电控托板移下部Y207、Z50→180，模块朝后高度目标≤21；实际超出先重排，不压豆盒。 | 待询价待询价；不沿用旧打包额度
F07旧：B10 | 遮光隔舱/快拆件机架与外壳 · 主方案 | 哑黑PP1mm 300×300mm＋M3手拧螺钉/嵌件 PP1mm 300×300一张：遮光底板180×200开130×50；余料做BOX背光罩，M3手拧4只及螺母4只；余料切前遮光条176×22×1，位置Z197→219，支点2另计F11 工程规格 / 用户输入 | 1 组 | 纸样后加工 底板顶Z195，孔与豆流对齐；背光罩分片拼装，不能放整块不透明背景板在前后相机之间。按纸样修边。 | 待询价待询价；不沿用旧打包额度
B11旧：B11 | 可拆轻刷（可选实验）机架与外壳 · 备选 | PBT软毛丝径0.10–0.15mm＋可拆夹座 每槽两侧轻触、侵入1–2mm起点，刷条总长按5槽纸样 工程规格 / 用户输入 | 1 件 | 无刷基线完成后再购 默认首样不装刷；不脱毛、不偏留碎豆且无新增破损才保留。 | 待询价待询价；不沿用旧打包额度
B12旧：B12 | 收豆盒称重 · 主方案 | 食品接触PP，外尺寸≤160×170×130mm 实际容量≥500g样本；轻量化，当前活动总重预算≤250g 工程规格 / 用户输入 | 1 件 | 实测容积/质量后下单 1kg整批收集必须另核容积和称台毛载荷；不把外形尺寸直接等于豆子容量。 V4.7盒向前移5mm至Y30，后留约7mm固定托板间隙，仍只压称台。 | 待询价待询价；不沿用旧打包额度
A14旧：A14 | 颜色/背景参考块板卡与相机 · 主方案 | 哑光中性灰，约30×30×1mm可换片 放在豆路两侧；配批次记录、光照重复性 工程规格 / 用户输入 | 1 件 | 标准规格待报价 只是重复性参照，不代替专业色卡校准；不放整块板挡落豆。 | 待询价待询价；不沿用旧打包额度
B13旧：B13 | 相机独立支架板卡与相机 · 主方案 | 6061角铝30×30×2，切长40mm；载板2mm 两套；每套30×30×2长40角铝＋40×40×2载板毛坯；配M5 T螺母2/螺钉2，尼龙柱按PCB孔 工程规格 / 用户输入 | 2 套 | 暂缓：相机PCB孔位待核 载板毛坯40×40mm仅起点；相机固定在独立型材梁，不由排线承重。 | 待询价待询价；不沿用旧打包额度
A16旧：A16 | 开始与停止按钮控制与接线 · 主方案 | φ16mm无灯金属，自复位，1NO1NC 两只；开始接NO、停止接NC；需低电平微负载触点 工程规格 / 用户输入 | 2 件 | 触点/夹紧范围核对后采购 需适配6mm面板或加薄衬板；未核具体厂家SKU，不买带灯锁定按钮。此为软件停止输入。 | 待询价待询价；不沿用旧打包额度
S01旧：A13 | 开/关滑架限位控制与接线 · 主方案 | OMRON SS-01GL 微负载金合金触点 每端1只；19.8×约6.4mm壳体、孔距9.5mm参照；端子COM/NO 资料1 (https://omronfs.omron.com/en_US/ecb/products/pdf/en-ss.pdf) | 2 件 | 安装/微负载验证后采购 不能用SS-5银触点的5A额定代替微负载要求。3.3V下动作可靠性须实测；装在滑架而非舵盘上。 | 待询价待询价；不沿用旧打包额度
S02旧：A13 | 限位/按键外上拉控制与接线 · 主方案 | 2.2kΩ金属膜，1%，0.25W GPIO0/1/3/23各1只，另2只备用；上拉3.3V 工程规格 / 用户输入 | 6 件 | 标准规格待报价 闭合电流约1.5mA；不自动宣称满足所有开关微负载规格，按所购触点资料与实测核验。 | 待询价待询价；不沿用旧打包额度
S03旧：A13 | BOX UART转接线控制与接线 · 主方案 | 匹配BOX PH2.0接口1的插壳/端子线 按原厂针数/顺序配；只连接TX、RX、GND，5V端独立绝缘 资料1 (https://wiki.alientek.com/docs/Boards/Kendryte/DNK230D/start-guide/k230d-box-introduction/) | 1 件 | 暂缓：原厂接口方向待核 PH2.0只表示间距系列；不能凭4针同外形认定线序。目标约200mm，实际走线定长。 | 待询价待询价；不沿用旧打包额度
S04旧：A13 | 控制信号线与端接控制与接线 · 主方案 | 多股铜0.14mm²（约AWG26）信号线 约2m总用量＋匹配2.54排针/插壳/热缩；短UART和开关信号 工程规格 / 用户输入 | 1 组 | 标准规格待报价 只用于信号；称重桥线按厂商屏蔽双绞要求，舵机大电流另走0.75mm²。 | 待询价待询价；不沿用旧打包额度
O01旧：O01 | 可选PWM单向缓冲控制与接线 · 备选 | TI SN74AHCT1G125DBVR＋SOT23-5转接板 5V VCC；/OE接GND，输入GPIO2，输出仅给舵机；旁路100nF取C03 资料1 (https://www.ti.com/product/SN74AHCT1G125) | 1 件 | 3.3V PWM不可靠才装 输入加10k下拉、输出串100Ω各1；绝不6V供电，绝不把5V输出回接C6。请代焊不手悬裸芯片。 | 待询价待询价；不沿用旧打包额度
O04旧：O04 | 可选独立3.3V模块控制与接线 · 备选 | Pololu D24V5F3，#2842，候选 24V→3.3V，典型500mA等级；按噪声/热需求核 资料1 (https://www.pololu.com/product/2842) | 1 件 | 余量/称重噪声不足再设计 不能与C6板载3.3V直接并联；须重审I²C供电先后和上拉，不默认购买。 | 待询价待询价；不沿用旧打包额度
G01旧：B09 | 25T金属舵臂滑闸标准件 · 主方案 | goBILDA 1900-0025-0104 H25T；厚4mm、φ4孔；8/16/24/32mm孔半径，使用16mm 资料1 (https://www.gobilda.com/1900-series-single-servo-arm-25-tooth-spline-32mm-length/) | 1 件 | 花键试装后下单 32mm是商品长度级别，不能当本设计力臂。仅匹配实物25T；中心螺钉用舵机匹配件。 | 待询价待询价；不沿用旧打包额度
G02旧：B09 | 双球头杆端滑闸标准件 · 主方案 | goBILDA 2913-0004-0241 M4×0.7内螺纹、球孔φ4；h约24.4mm、总长31.3mm、螺纹深13mm按图 资料1 (https://www.gobilda.com/2913-series-steel-ball-linkage-female-m4-x-0-7mm-24-1mm-length-2-pack/) | 2 件 | 标准规格待报价 两只=原厂1个2-pack，不重复买2包；网页标题24.1与图24.4不同，收到后量h。 | 待询价待询价；不沿用旧打包额度
G03旧：B09 | 连杆中间牙条滑闸标准件 · 主方案 | goBILDA 2808-0004-0030 / 等效不锈钢 M4×0.7、30mm长；与2球头组成约60mm球心距 资料1 (https://www.gobilda.com/2808-series-stainless-steel-threaded-rod-m4-x-0-7mm-30mm-length-2-pack/) | 1 件 | 标准规格待报价 一根使用，原厂2-pack另一根备用；不是60mm牙条。两端右牙，调长需拆一头。 | 待询价待询价；不沿用旧打包额度
G04旧：B09 | 杆端并紧螺母滑闸标准件 · 主方案 | ISO 4032 / GB6170 M4×0.7 两只用、两只备用，普通六角并紧螺母 工程规格 / 用户输入 | 4 件 | 标准规格待报价 裸露牙条11.2mm须装下两只螺母；不可把厚尼龙锁紧螺母当同尺寸。 | 待询价待询价；不沿用旧打包额度
G05旧：B09 | 球头轴与防松件滑闸标准件 · 主方案 | φ4光杆/肩轴段＋M4螺纹；M4防松螺母 两组；轴向堆叠=舵臂/耳板+球内圈+隔套+螺母；长度按实物 工程规格 / 用户输入 | 2 组 | 暂缓：球内圈/堆叠待量 夹持球内圈，不压外壳；不能直接指定M4×16而未知内圈宽度。带小径隔套，球头全角度不干涉。 | 待询价待询价；不沿用旧打包额度
G06旧：B09 | 左右直线导向滑闸标准件 · 主方案 | MGN9导轨100mm＋MGN9H长滑块 两轨各1块；HIWIN参考块高10、宽20、长39.9mm；孔距15×16mm参考 资料1 (https://www.hiwin.com/wp-content/uploads/Linear_Guideway-E-1.pdf) | 2 轨块套 | 供货图/纸样核对后采购 兼容件不继承原厂额定值；每套明确含轨和H块，不再重复列买2只滑块。两轨平行不强行夹紧。 | 待询价待询价；不沿用旧打包额度
G07旧：B09 | 全宽铝闸片滑闸加工件 · 主方案 | GATE-PLATE-01 / 6061-T6 110×45×2mm毛坯；直线钝前缘、去毛刺、平整 工程规格 / 用户输入 | 1 件 | 先纸样，后加工 封口边/螺孔由新槽盒定；不是0.8mm薄POM。载荷模型尚不覆盖局部接触/安装翘曲。 | 待询价待询价；不沿用旧打包额度
G08旧：B09 | 滑架转接板（本次补漏）滑闸加工件 · 主方案 | GATE-CARRIAGE-01 / 6061-T6 120×30×3mm毛坯；桥接左右MGN9H；轨中心距94mm布局提案（原约90起点） 工程规格 / 用户输入 | 1 件 | 暂缓：收到导轨后开孔 覆盖前后16mm孔距；10mm角铝脚宽不足以代替此板。参考四孔位置每块±7.5、±8mm；最终按供货图。 | 待询价待询价；不沿用旧打包额度
G09旧：B09 | 横梁加强/连接角铝滑闸加工件 · 主方案 | 6061/6063，10×10×2mm，长110mm 装在转接板/闸片后部、豆路外，至少两处间隔连接 工程规格 / 用户输入 | 1 件 | 纸样后加工 保留为加强与闸片连接件，不直接把两滑块只锁在10mm角铝脚上。 | 待询价待询价；不沿用旧打包额度
G10旧：B09 | 中心连接耳滑闸加工件 · 主方案 | GATE-EAR-01 / 6061，30×20×3mm毛坯 中心孔φ4.2mm起点；高度/折弯连接按舵臂平面设计 工程规格 / 用户输入 | 1 件 | 暂缓：共面高度待纸样 宽度中心居中；不沿用z315−z292=23mm直接钻孔。耳板/隔套必须避开连杆摆角。 | 待询价待询价；不沿用旧打包额度
G11旧：B09 | 共同导轨底座滑闸加工件 · 主方案 | GATE-BASE-01 / 6061，140×140×4mm毛坯 两轨在同一平面；近槽盒侧裁切/开缺口，不能遮挡落豆通口 工程规格 / 用户输入 | 1 件 | 暂缓：布置/视锥待纸样 assembly第04图给前豆路/后舵机避空方向；140×140是毛坯，最终缺口/螺孔须纸样。实际轨块总高、100轨端余量和视锥未验。 | 待询价待询价；不沿用旧打包额度
G12旧：B09 | 槽内低摩擦支承框滑闸加工件 · 主方案 | 食品接触资料可核POM，140×30×4mm 五通口14×12；X29/46/63/80/97、Y9；支承顶Z290，底286 工程规格 / 用户输入 | 1 件 | 暂缓：槽盒纸样后开口 代替原110×30×3。四毫米厚用于两层PP3下围挡280→286后接至290；不能与PP热焊。孔需与上下叠片对齐；隔距件在140宽两外翼，避开110宽闸片扫掠。 | 待询价待询价；不沿用旧打包额度
G13旧：B08, B09 | 封闭槽盒与退片袋板料滑闸加工件 · 主方案 | PP五窗叠层＋可拆后防护/缝口条 模块Z280→330；140宽五窗夹层＋110×30→82×12过渡；闸片通道290→292.3为初试值 工程规格 / 用户输入 | 1 组 | 暂缓：必须纸样定型 板料用F05，不重复买整张；报价为后/侧罩及缝口加工。后部10mm加强角梁/滑块需完整扫掠纸样；不能用延长平板作完整后罩或承诺已封闭验收。缝宽按闸片实测＋约0.3总隙起试，清洁可拆。 | 待询价待询价；不沿用旧打包额度
G14旧：B09 | 舵机固定支架滑闸加工件 · 主方案 | MG996R专用金属支架＋6061 3mm转接毛坯 毛坯约60×60×3mm；轴竖直，连杆与滑架连接点共面起点 工程规格 / 用户输入 | 1 件 | 暂缓：机身/高度待试装 支架与底座同一刚性机架；壳体/扫掠避后摄视锥，不将旧轴高当冻结孔位。 | 待询价待询价；不沿用旧打包额度
G15旧：B09, A13 | 滑块连接螺钉滑闸标准件 · 主方案 | M3×6内六角＋必要薄垫片 8只使用、2只备用；配3mm转接板 工程规格 / 用户输入 | 10 件 | 实际螺纹深度核对 先量块的有效螺纹深与板/垫片堆叠，既不顶底也不啮合不足；不按所有MGN9H兼容块同深度购买。 | 待询价待询价；不沿用旧打包额度
G16旧：B09 | 导轨底座连接螺钉滑闸标准件 · 主方案 | M3×8内六角＋M3螺母/底座螺纹 每轨按实际孔数，预留12只 工程规格 / 用户输入 | 12 件 | 导轨孔/底座堆叠核对 基座仅4mm厚，通孔+螺母或螺纹方案需先定；不得让下露螺杆顶框架。 | 待询价待询价；不沿用旧打包额度
G17旧：B09 | 闸片/横梁连接件滑闸标准件 · 主方案 | M3×10沉头＋M3螺母/压条 6只使用、2只备用；每连接层实量 工程规格 / 用户输入 | 8 件 | 纸样与板厚核对 2mm闸片不靠单孔受拉；豆路表面保持平顺，不留凸出螺帽。可把孔放后方完全避豆路。 | 待询价待询价；不沿用旧打包额度
G18旧：B09, A13 | 限位安装耳与保护挡块滑闸加工件 · 主方案 | 6061/POM毛坯，约20×15×3mm各件 两限位耳、两保护挡块；M2安装件按SS-01GL图 工程规格 / 用户输入 | 1 组 | 端点标定后定位 正常端点先触限位，机械挡块留在正常行程外；不能让舵机正常关闸时顶死。 | 待询价待询价；不沿用旧打包额度
G19旧：B08, B09 | 手动止料片滑闸加工件 · 主方案 | 食品接触PP/POM，110×40×1mm毛坯 独立可插入止料位置；片外保留手持区 工程规格 / 用户输入 | 1 件 | 槽盒纸样后制作 不作为自动急停或失电自闭。与运行中闸片不能干涉，取盒前先停料排空。 | 待询价待询价；不沿用旧打包额度
G20旧：B09 | 润滑区与豆路隔板滑闸加工件 · 主方案 | PP1mm毛坯140×110mm＋M3可拆固定 隔开轨块润滑、连杆与豆路；留检修清洁通道 工程规格 / 用户输入 | 1 件 | 纸样后裁切 薄片仅隔尘，不承担1kg豆重；不能在落豆口横跨挡豆。 | 待询价待询价；不沿用旧打包额度
I06旧：A15 | 光耦输出上拉工业光电备选 · 备选 | 4.7kΩ 1% 1/4W电阻 集电极至C6 3.3V；与24V输入限流I03不同 工程规格 / 用户输入 | 1 件 | 随I02接口复核 仅确认NPN后使用，输出不接24V或5V。 | 待询价待询价；不沿用旧打包额度
I07旧：A15 | 光耦代焊与绝缘安装工业光电备选 · 备选 | FR-4小板约30×20mm＋接线端子＋绝缘盒 输入/输出分区标识，禁止裸焊悬空 工程规格 / 用户输入 | 1 组 | 随I02代焊 报价含代焊和两侧端子；电路通断/极性/输出电压先台架核验。 | 待询价待询价；不沿用旧打包额度
W08旧：B05 | 350g检查用组合砝码之一称重 · 主方案 | OIML R111 F1不锈钢，200g 有修正值与可核查证书；和100g、50g组合参考 资料1 (https://www.oiml.org/en/files/pdf_r/r111-1-e04.pdf) | 1 件 | 标准规格待报价 三件实际修正质量相加，组合参考扩展不确定度≤0.03g；须考虑相关性，不能只复制单件证书数值。 | 待询价待询价；不沿用旧打包额度
W09旧：B05 | 350g检查用组合砝码之二称重 · 主方案 | OIML R111 F1不锈钢，50g 与W03 100g、W08 200g组成约350g独立检查点 资料1 (https://www.oiml.org/en/files/pdf_r/r111-1-e04.pdf) | 1 件 | 标准规格待报价 不依赖待测秤确定砝码质量；校准点与独立检查点分开使用。 | 待询价待询价；不沿用旧打包额度
F08旧：A09, B08, B10 | 料斗木壳与托耳固定件外壳固定 · 主方案 | M5×12/T螺母/垫片各4；小角片10；M3×12及螺母/垫片各28 托耳2点＋2备；木壳8小角片＋托耳2小角片；外面板固定独立移到F11 工程规格 / 用户输入 | 1 组 | 纸样后核板厚/孔深 M5×12穿6mm托耳按槽深试装；木壳内侧M3头齐平，不侵入PP/豆路。原外覆面板16点方案取消，不能重复按旧20套采购。 | 待询价新增材料待询价
F09旧：新增 | 上端防尘端盖机架与外壳 · 主方案 | 匹配已有黑色欧标2020端部的黑色塑料端盖 20×20型材用，4只；非承重连接件 工程规格 / 用户输入 | 4 只 | 核实2020端部后下单 按实物中心孔/槽型试配；端盖不承担框架连接。 | 待询价新增待询价
F10旧：新增 | 底部防滑脚套机架与外壳 · 主方案 | 黑色欧标2020端部外套式橡胶脚套 内腔匹配20×20端部，厚底≥3mm，4只；实物尺寸/硬度待核 工程规格 / 用户输入 | 4 只 | 核实2020端部后下单 无螺纹的外套式方案，不用把M5硬拧入型材中心孔。要求四点稳定；非调平脚、非已验承载件。若换调平脚另核安装座/攻牙。 | 待询价新增待询价
F11旧：新增 | 内嵌木面板背托套件外壳固定 · 主方案 | 20×20×2内角片＋配套M5/T螺母；M3×25黑沉头＋M3螺母/垫片＋隔距 购40套：木板32点、前黑PP条2点、6备；每套1角片/1M5/1T螺母/1M3螺栓螺母垫片/10mm尼龙隔套＋1mm调垫 工程规格 / 用户输入 | 1 组 | 先纸样/角样，后按实物下单 角片内侧背托。示意11mm隔距使6mm板面内凹1；按实物角片量，不盲买固定11。先做角样，32点不是沿用旧16点外覆直接穿T槽。 | 待询价V4.7新增待询价
F12旧：新增 | PP热焊耗材与上口压片料斗制作 · 主方案 | 同牌号PP-H焊条Ø2/Ø3；焊枪匹配4–5mm细嘴；20×10×1.5角铝压片 Ø2约5m、Ø3约2m含练习；细嘴1（已有匹配则不买）；角铝切长15×4；M3×12/螺母/外垫片各4 工程规格 / 用户输入 | 1 组 | 先纸样/角样，后按实物下单 2mm板先用废料练焊；工业参数有设备/风量/直径条件，不能当任意枪330°C配方。四压片只压158口圈外缘，长腿在木壁外，不伸入136口；角片孔按实物。 | 待询价V4.7新增待询价
G21旧：新增 | 五窗叠层隔距与夹紧件滑闸加工件 · 主方案 | 外翼隔距块10×30×2两条＋0.3mm薄垫；M3×35候选 2mm隔块×2、0.3薄垫×2；3mm下支承×2；M3×35/螺母/垫片各4（2用2备）；均先纸样 工程规格 / 用户输入 | 1 组 | 先纸样/角样，后按实物下单 隔片X0→10/130→140，避开闸片X15→125。间隙按板实厚＋约0.3总隙起试；不靠螺钉夹紧程度调滑动。后罩另按G13/G20避加强角梁，固定孔未冻结。 | 待询价V4.7新增待询价

## GPIO20 推荐连接

2167 发射红线 → 5V，黑线 → GND
2167 接收红线 → 5V，黑线 → C6 GND
接收白线信号节点 → 1kΩ串联 → GPIO20
白线信号节点 → 10kΩ → C6 3.3V

仅适用核验过的开集电极2167。信号上拉到3.3V，不接5V红线。原厂示例遮挡为低电平，仍要空载测量确认。廉价仿品若有内部5V上拉，须重新核验，不能照搬。

## 为什么不负责数豆？

一条光束只检测被遮挡：可以提示豆流出现、持续遮挡异常，并辅助核对关闸后的残流。五槽多颗豆同时经过会合并成一次遮挡，偏离光束也可能漏报。

相机仍连续采集，图像跟踪负责计数与双面配对。光电不能单独宣布“已空料”“卡豆”或“可以停相机”。第一阶段没有它也可做成像和空载闸门验证。

## 计算与装配要点

行程：12mm槽深＋1.5mm覆盖＋1.5mm退让＝15mm；r16mm对应±27.953°相对角。L60mm时两端球头入口至球心按24.4mm，每端牙条旋入9.4mm；裸露11.2mm。

板片：110×45×2mm的6061-T6毛坯约26.73g。全宽简支梁粗算，1kg均布挠度0.081mm，跨中集中梁载0.130mm；不代表局部接触/孔位/夹豆验收。

导轨：39.9mm滑块＋15mm行程＋两端各10mm余量＝74.9mm最低几何长度，100mm有余量；仍须按实际孔位、挡块、后摄视锥检查。120×30×3mm转接板给四孔安装留出空间。

电源：按灯8W、传感器1W、5V×4A与6V×3A、降压效率85%计算，持续预算53.71W；舵机短时5A时约67.82W。候选GST120A24-P1M为24V/5A/120W，尺寸、连接和温升仍需确认。

称重：原1kg毛载荷不能接收1kg豆＋盒＋平台；若全量一次收集，须采用经核验的更大量程组件。HJ-AZ4-3kg有容量余量但不自动满足±0.1g，且接口仍待核。新表没有默默改变原0–500g误差验收范围。

孔位：先买标准件和板料，再纸样试装，最后钻支架/槽盒孔。不能把动画或毛坯外形当最终开孔图。

旧BOM 35项如何处理（完整对照）

旧编号 | 旧名称 | 本次处理 | 新编号
A01 | 正点原子K230D BOX＋32GB TF卡 | 补材料/型号、数量与下单条件；打包规划金额不作新报价 | A01
E01 | ESP32-C6-LCD-1.47非Touch版 | 补材料/型号、数量与下单条件；打包规划金额不作新报价 | E01
E02 | BOX自带2.4英寸屏＋32GB TF | 套件内包含，不把尚未收到的套件标成已有 | E02
B01 | GC2093＋M12 90°无畸变镜头，两套 | 补用户GC2093-M12-90度描述，PCB/线序/近焦仍需核 | B01
B02 | BOX兼容MIPI排线，按实际路径 | 补材料/型号、数量与下单条件；打包规划金额不作新报价 | B02
A03 | MG996R位置舵机＋舵盘 | 补材料/型号、数量与下单条件；打包规划金额不作新报价 | A03
A04 | 山大斯M12对射收发一组 | 首样改低压2167建议，原B3F-20C1保留待核备选 | PH01, I01
B03 | NAU7802 I²C模块，3.3V兼容 | 补材料/型号、数量与下单条件；打包规划金额不作新报价 | B03
B04 | 1kg四线全桥、单点偏载补偿传感器 | 原1kg采购描述未闭合；用户3kg候选另列，L6J1不直接适配 | W01, W02
B05 | 100g/500g等可核查质量砝码 | 补材料/型号、数量与下单条件；打包规划金额不作新报价 | W03, W04, W08, W09
B06 | 轻平台＋刚性底座/支柱＋过载限位 | 补材料/型号、数量与下单条件；打包规划金额不作新报价 | W05, W06, W07
A05 | 24V普瑞Ra98同批固定色温灯带 | 补材料/型号、数量与下单条件；打包规划金额不作新报价 | A05
A06 | 4条铝散热槽＋扩散片＋遮光边 | 补材料/型号、数量与下单条件；打包规划金额不作新报价 | L02, L03
A07 | 24V/4A成品稳压适配器 | 补材料/型号、数量与下单条件；打包规划金额不作新报价 | A07, P02
A08 | XL4015类24V→5.0V带散热模块 | 补具体固定5V模块参考；旧18元不当新报价 | A08
A17 | 第二只24V→6.0V带散热模块 | 补具体固定6V模块参考；旧18元不当新报价 | A17
A09 | 24V DC开关、端子、保险座/保险、线材 | 补材料/型号、数量与下单条件；打包规划金额不作新报价 | P03, P04, P05, P06, P07, P08, F08
A10 | 1000µF16V＋470µF10V＋100nF | 补材料/型号、数量与下单条件；打包规划金额不作新报价 | C01, C02, C03
A11 | 双USB-A供电转接＋两根短A-to-C线 | 补材料/型号、数量与下单条件；打包规划金额不作新报价 | P09, P10
B07 | 2020银色型材4.40m＋角码/T螺母 | 核对净切割长度4.40m，连接件拆开 | F01, F02
B08 | 6mm海洋板支架＋0.5mm PP内衬/隔板 | 板料/槽盒展开拆分，宽度分配与开缝须纸样 | F03, F04, F05, G13, G19, F08
B09 | POM片＋导块/M3球头连杆＋MG996R金属支架 | 原25元打包行作废，拆分G01–G20；增加滑架转接板/封闭槽盒 | G01, G02, G03, G04, G05, G06, G07, G08, G09, G10, G11, G12, G13, G14, G15, G16, G17, G18, G19, G20
B10 | 6mm海洋板＋BOX内托架＋遮光隔舱/快拆 | 补材料/型号、数量与下单条件；打包规划金额不作新报价 | F03, F06, F07, F08
B11 | PBT软刷＋夹座 | 补材料/型号、数量与下单条件；打包规划金额不作新报价 | B11
A13 | 两限位＋PH2.0线/接头＋上拉 | 补材料/型号、数量与下单条件；打包规划金额不作新报价 | S01, S02, S03, S04, G15, G18
B12 | 食品接触PP盒，外≤160×170×130 | 补材料/型号、数量与下单条件；打包规划金额不作新报价 | B12
A14 | 哑光中性灰参考块 | 补材料/型号、数量与下单条件；打包规划金额不作新报价 | A14
B13 | 两套L架＋载板/尼龙柱＋固定夹 | 补材料/型号、数量与下单条件；打包规划金额不作新报价 | B13
A15 | 24V NPN输入→3.3V开集电极光耦模块 | 低压方案不用工业光耦；拆上拉/串阻，工业备选另列 | PH02, PH03, I02, I03, I04, I06, I07
B14 | M12可调L支架＋双螺母/遮光帽 | 补材料/型号、数量与下单条件；打包规划金额不作新报价 | PH04, I05
A16 | 16mm无灯金属自复位1NO1NC | 补材料/型号、数量与下单条件；打包规划金额不作新报价 | A16
O01 | 5V供电AHCT单向PWM缓冲 | 补材料/型号、数量与下单条件；打包规划金额不作新报价 | O01
O05 | 欧路达Autoda 3kg裸传感器（型号待核） | 更新用户型号HJ-AZ4-3kg与103元，不沿用55元 | W01
O06 | 欧路达配套铝支架增价 | 旧50元差价作废；103元是否含支架待核，避免重复买底座 | W07
O04 | 专用3.3V降压/低噪声后级 | 补材料/型号、数量与下单条件；打包规划金额不作新报价 | O04

价格均为人民币。国外原厂页面用于核规格，未按网页美元价折算，不含运费、工具和外协工时。旧V4.4 CSV/JSON/PDF/ZIP保留快照；本页为当前采购入口。尚未实物承重、带豆开合、电气联调或称重验收。
