koffja/Beanlens/docs/hardware/revision-v4.9/beanlens-power-and-feed-v4.9.html

当前送料/电源修订为V4.10。 打开连续前壁、固定与PBT刷盒图 · 114项新版BOM。6V舵机采用UBEC5A/6V；TPS5450只评估5V逻辑路。V4.9主斗外形、V4.8机架/木板/双屏保留，旧分离POM座和刷排表述已被替换。

最新整机装配与运作演示：V4.12。 整机组装／爆炸及12页接线图 · 整个运作流程动画。本页保留历史参考，旧小过渡斗、双法兰和叠片不用于当前装配。BEANLENS · 2026-10-16 · V4.9 样机修订

# 看清每条电线，减少豆路接缝

外置24V适配器 + 两块常见降压板。四片PP焊一个连续斗，五孔座与闸片保留拆洗。机架、三面木板与双屏沿用V4.8；这里替换旧版电源与料斗结构。

XL4016是芯片型号，不代表整板持续电流。先调电压、带负载检查，再接板卡与舵机。此包尚未实机/带豆验证，旧八片PP模板不可用于连续斗。

查看电路 放大 100%复原视图端子接哪格PP怎么简化

## 总接线

## 逐线端子表

## PP连续料斗 / 闸片分解

## 电源盒 / 上电顺序

原厂资料：航嘉 (https://en.huntkey.com/erp-information/huntkey/hka12024050-6b-hka12024050-7b/) · XLSEMI (https://www.xlsemi.com/datasheet/XL4016-EN.pdf) · 德力西 (https://www.delixi-electric.com/u/cms/delixi/201805/09095528ac23.pdf) · TI (https://www.ti.com/product/SN74AHCT1G125)。孔位、光束避让、退片全行程与带载温升仍待试配。
