koffja/Beanlens/output/pdf/beanlens-pp-templates-v4.7-20261016.pdf

BEANLENS / V4.7 / 2026-10-16

# A：主斗前后片 / 内面1:1

黑线为内表面控制线；外留修边量；先纸样，再试焊。

136

110

## A 前／后 ×2

122.10斜高

垂直高度110，不等于本片斜高。
下边相对上边每侧缩13；相邻斜接边约122.79。
本页打印两份。先在纸上闭合，确认底口110×30。
PP-H 2mm；控制线外留约1mm，试夹后刮修坡口。

100mm校验线：打印100%，关闭缩放

2mm板厚、坡口/焊筋/最终孔位须实物修配，非免试装刀模。 | 1/6

# B：主斗左右片 / 内面1:1

黑线为内表面控制线；外留修边量；先纸样，再试焊。

136

30

## B 左／右 ×2

110.77斜高

本片下边30，不是110；左右片与前后片不同。
每侧缩53，四片顶边均为136。
本页打印两份。用上下定位框维持垂直高度110。
角度由试夹得，不把所有接边统一切成45°。

## 口圈与下接环 / 平面1:1

黑线为内表面控制线；外留修边量；先纸样，再试焊。

## 口圈：PP2，外158 / 内136

158

口圈焊在斗顶；坐木壳Z440，上表面Z442。

### 接环：PP3 / 内110×30

接环在Z327→330；小过渡斗接其下方。

# 小过渡斗：四片 / 内面1:1

黑线为内表面控制线；外留修边量；先纸样，再试焊。

110

82

## C 前后片 ×2

110

82

## C 第二片

30

12

D

30

12

D

### C斜高30.08；D斜高31.93；均为PP-H2。 垂直高28.7，上110×30，下82×12，中心对齐。

上接环厚3另计，合计到主斗下口Z330。

# 五槽PP叠片 / 平面1:1

黑线为内表面控制线；外留修边量；先纸样，再试焊。

## U1/U2：PP3，140×30，做两片

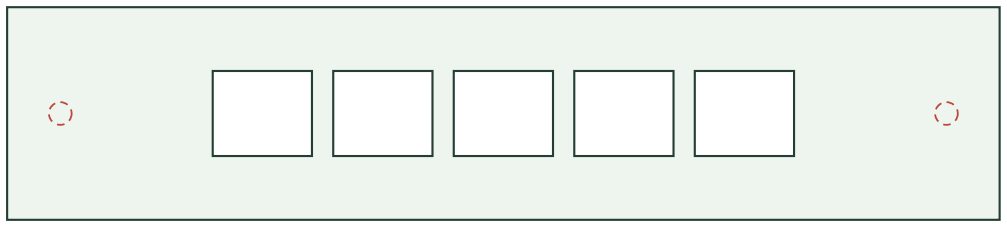
[picture p7: figure]

### 孔左边X＝29、46、63、80、97；每孔14×12。

上片孔Y9→21；后罩另做，不把平板伸到加强梁上方。

## L1/L2：PP3，140×18，做两片

### 下片孔Y3→15；装配后与上片同处整机Y114→126。

红圈Ø3.2只是候选安装孔，纸样避开滑轨后再钻。

本页打印两份，可分别转印上下两层。
3mm筋位于相邻窗口之间；不能把筋锯掉。
窗口先做一 片检查；同批CNC比手修更容易对齐。

# POM支承、隔距与闸片层次

黑线为内表面控制线；外留修边量；先纸样，再试焊。

## S：POM4，140×30，仅一 片

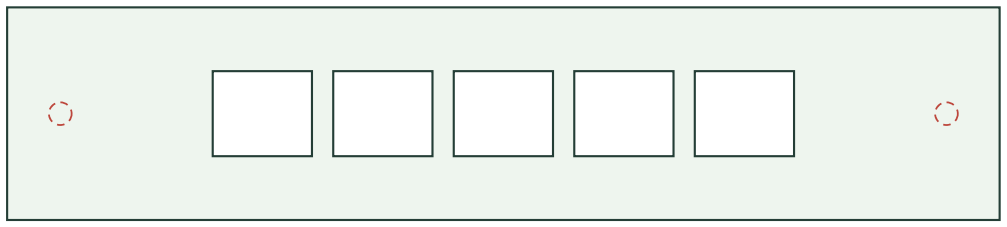
[picture p8: figure]

POM顶面Z290，上承闸片；五窗必须贯通。
不能与PP热焊；螺栓夹持在远离豆路的两翼。

### 隔片10×30，两处：2mm＋约0.3薄片

### 隔片在140宽板的X0→10、130→140。

闸片扫掠X15→125，不能被隔片或螺钉挡住。

上PP3＋PP3，Z292.3→298.3

间隙2.3：闸片实厚＋余量
POM4，Z286→290

下PP3＋PP3，Z280→286

剖面为2倍示意；只有上方平面和隔片为1:1。
上罩仍需配G13/G20后防护，不能直接加平底撞滑块。
