koffja/Beanlens/docs/hardware/assembly-v4.12/05-optics-weight.png

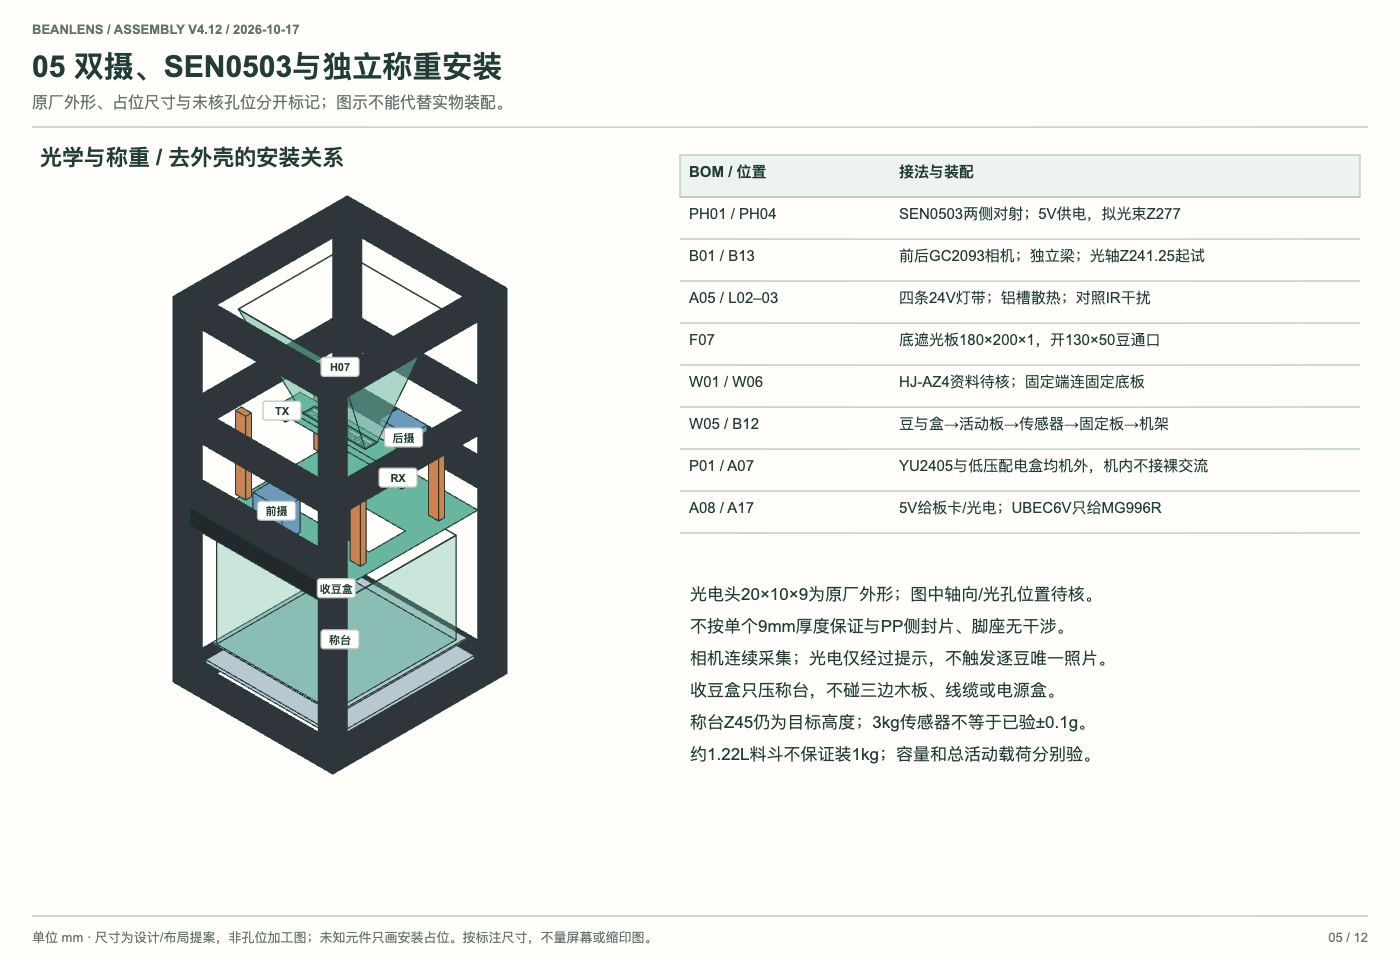
docs/hardware/assembly-v4.12/05-optics-weight.png
