koffja/Beanlens/docs/hardware/frame-v4.6/beanlens-frame-v4.6-concept.png

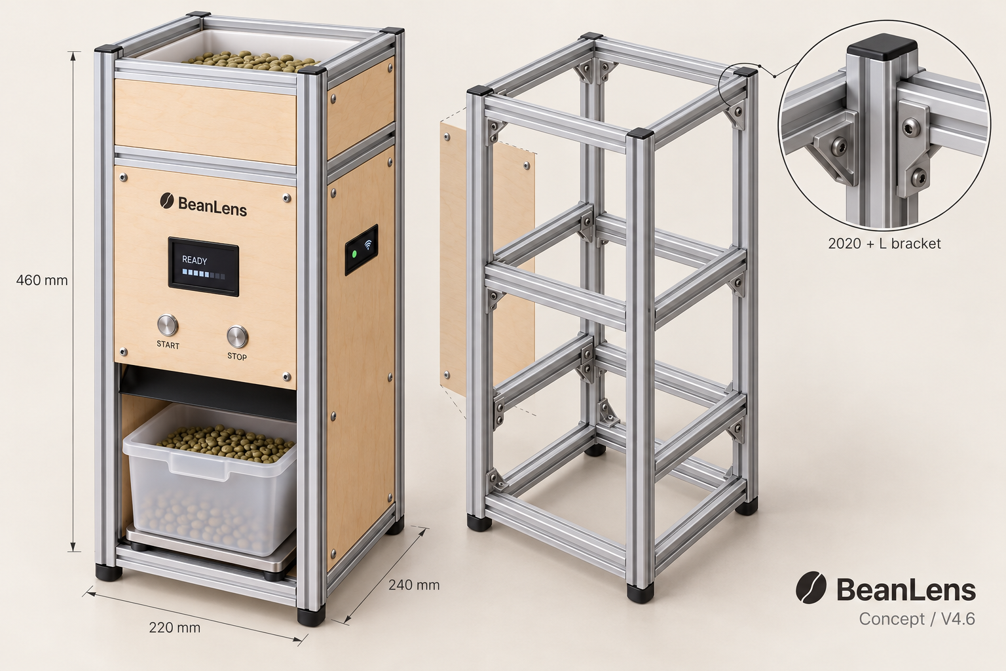
docs/hardware/frame-v4.6/beanlens-frame-v4.6-concept.png
