koffja/Beanlens/docs/hardware/frame-v4.6/black-frame-comparison-v4.6.png

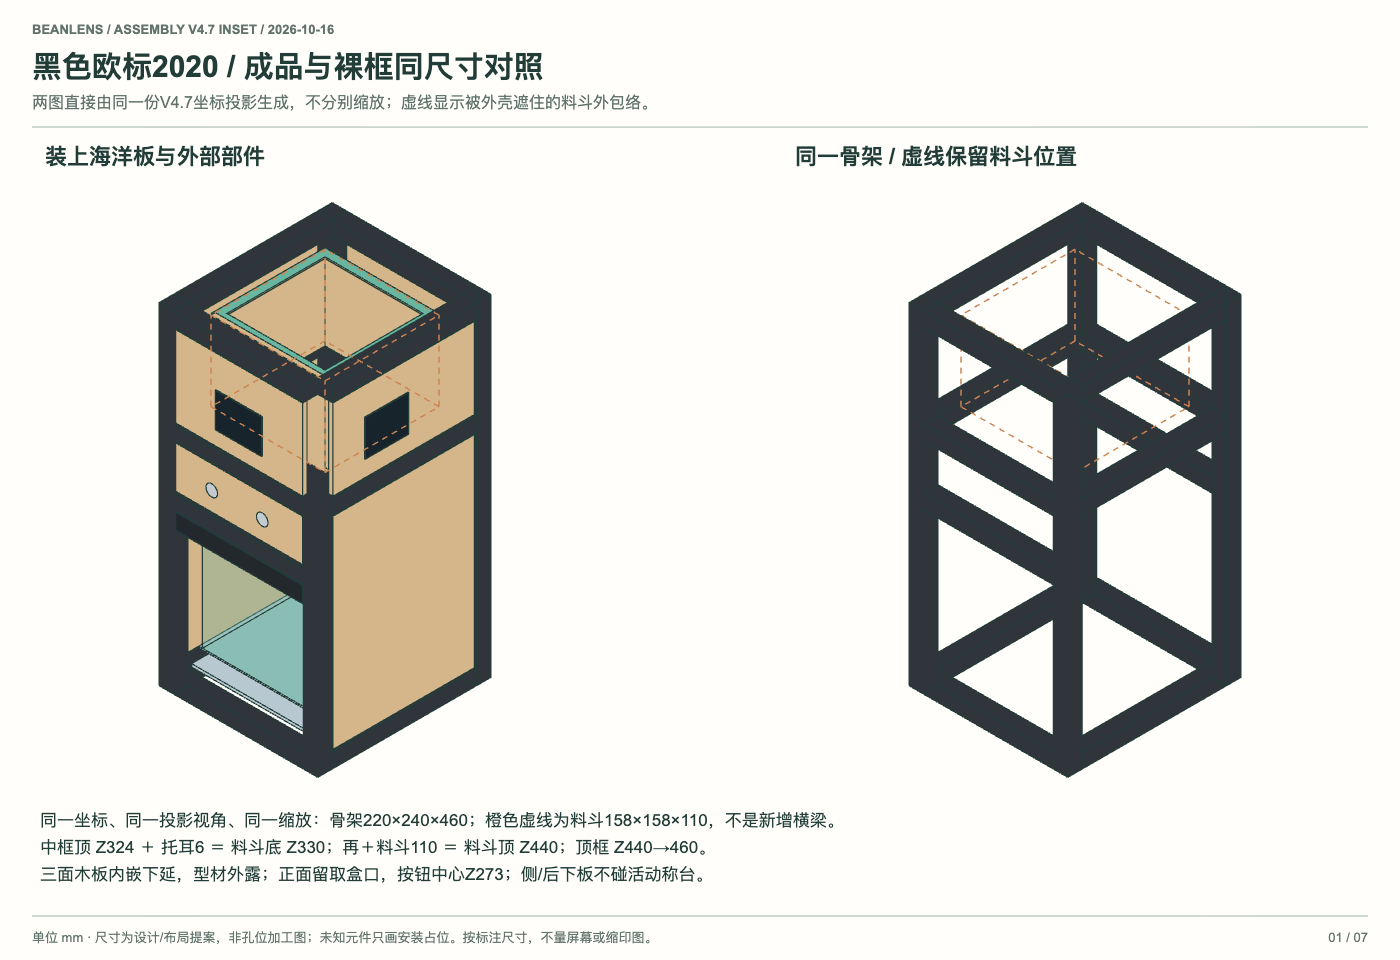
docs/hardware/frame-v4.6/black-frame-comparison-v4.6.png
