koffja/Beanlens/docs/hardware/frame-v4.6/page-dimensions-check.png

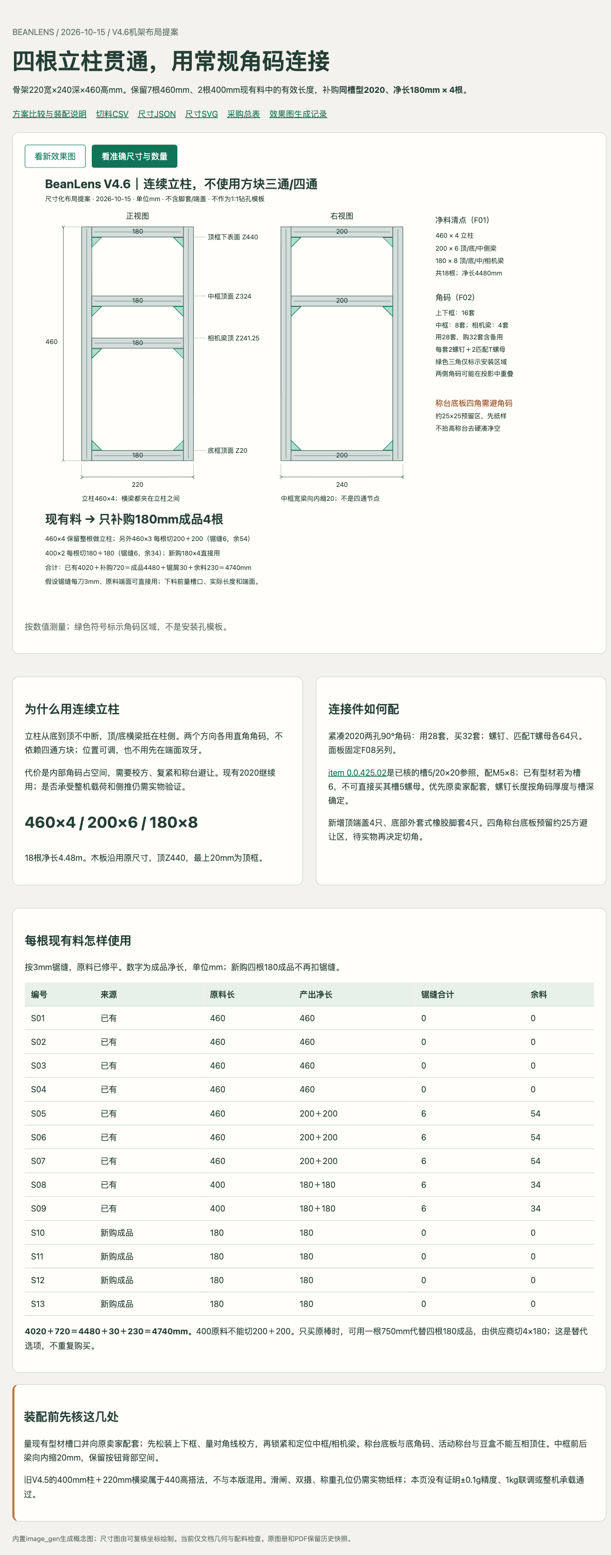
docs/hardware/frame-v4.6/page-dimensions-check.png
