koffja/Beanlens/docs/hardware/hackathon-h1/01-overall.png

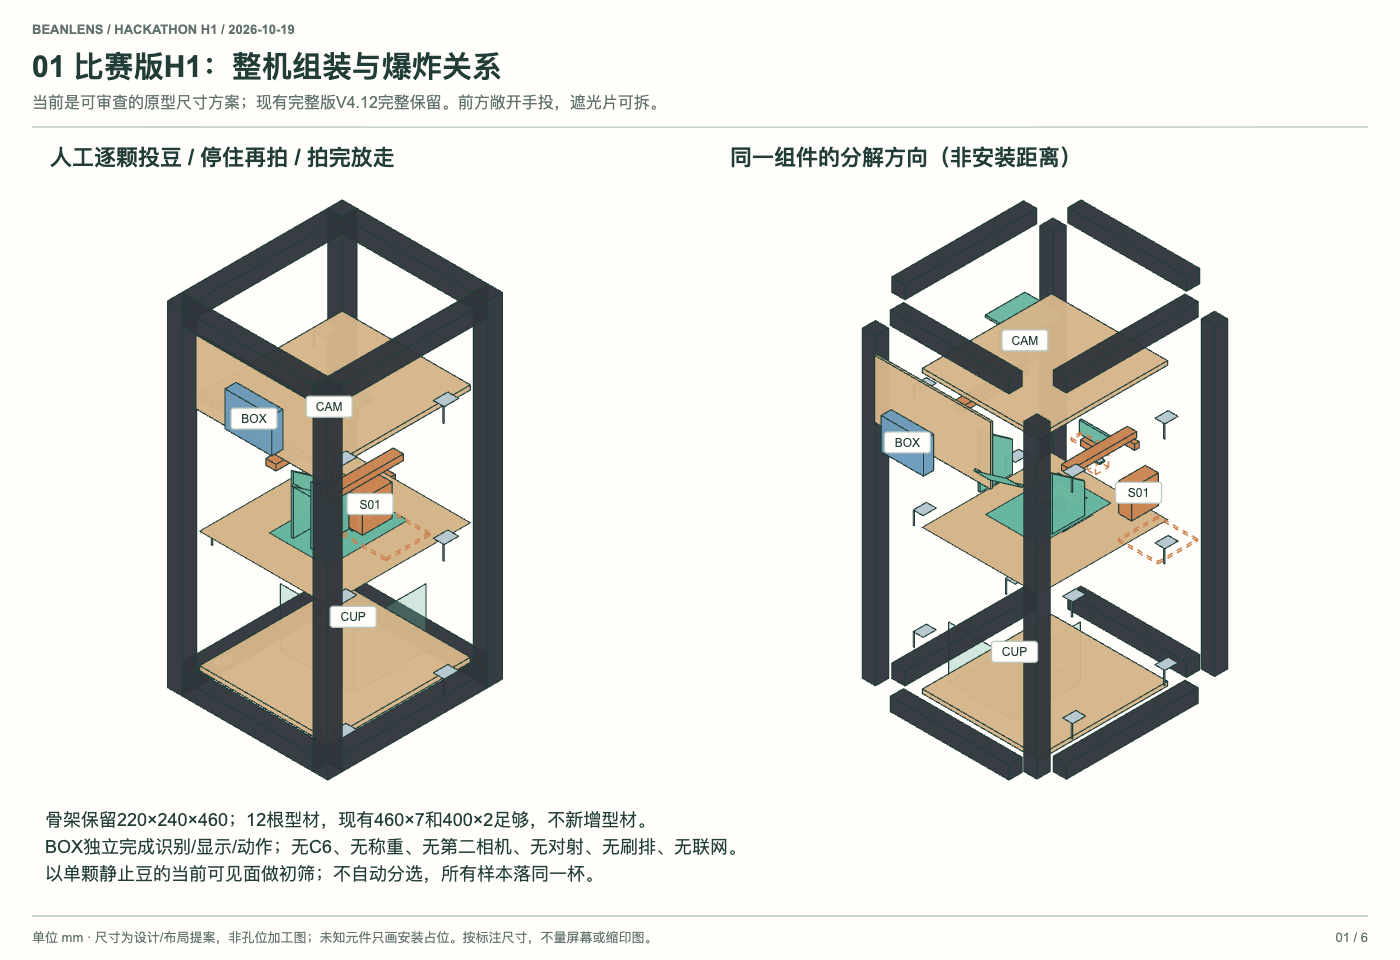
docs/hardware/hackathon-h1/01-overall.png
