koffja/Beanlens/docs/hardware/hackathon-h1/02-exploded.png

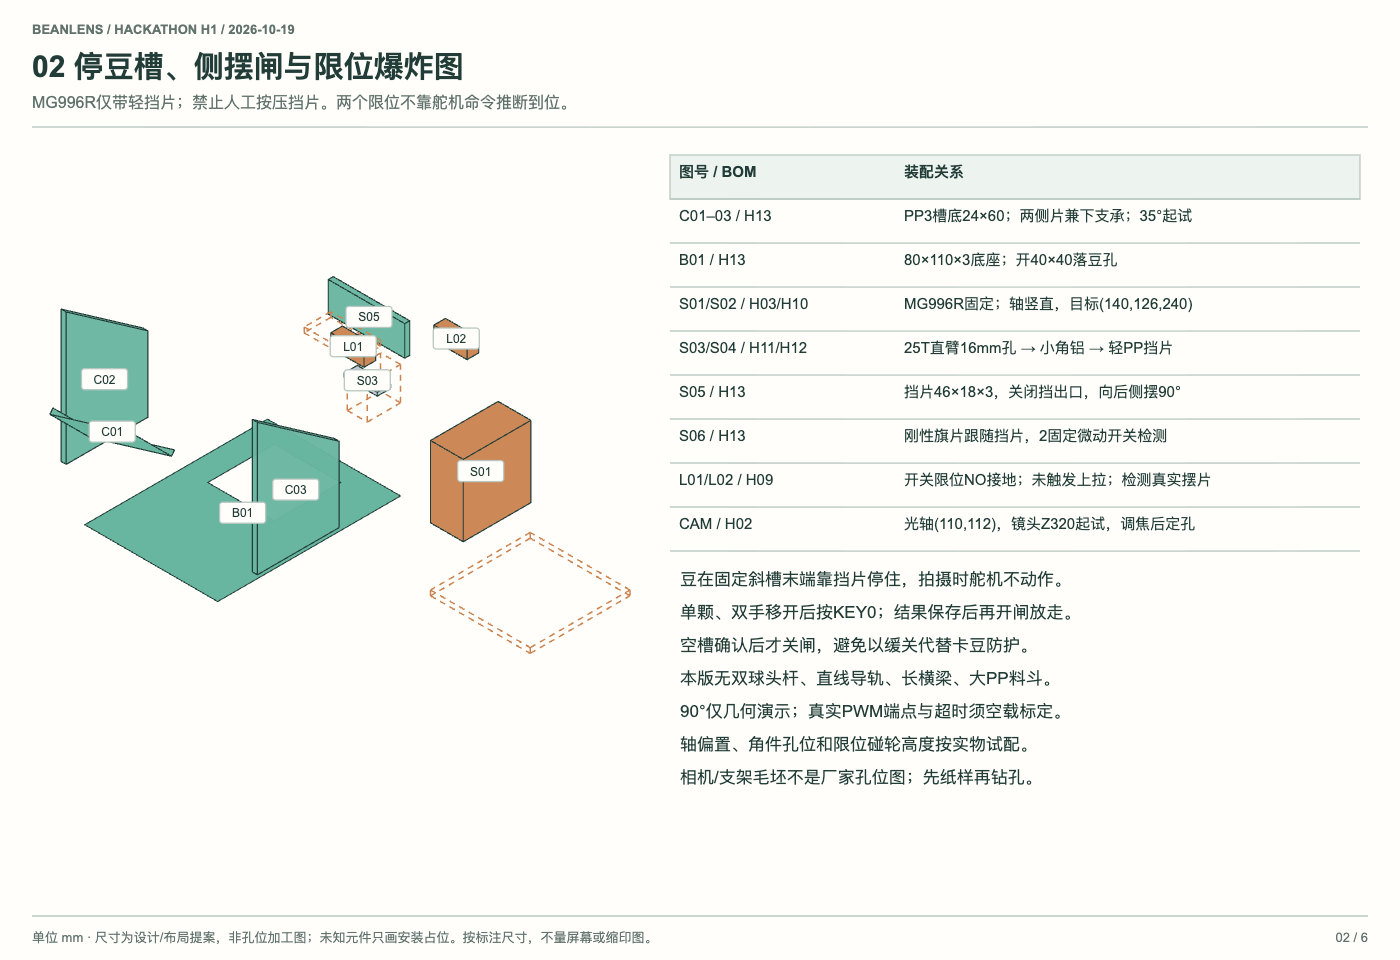
docs/hardware/hackathon-h1/02-exploded.png
