koffja/Beanlens/docs/hardware/hackathon-h1/03-cuts.png

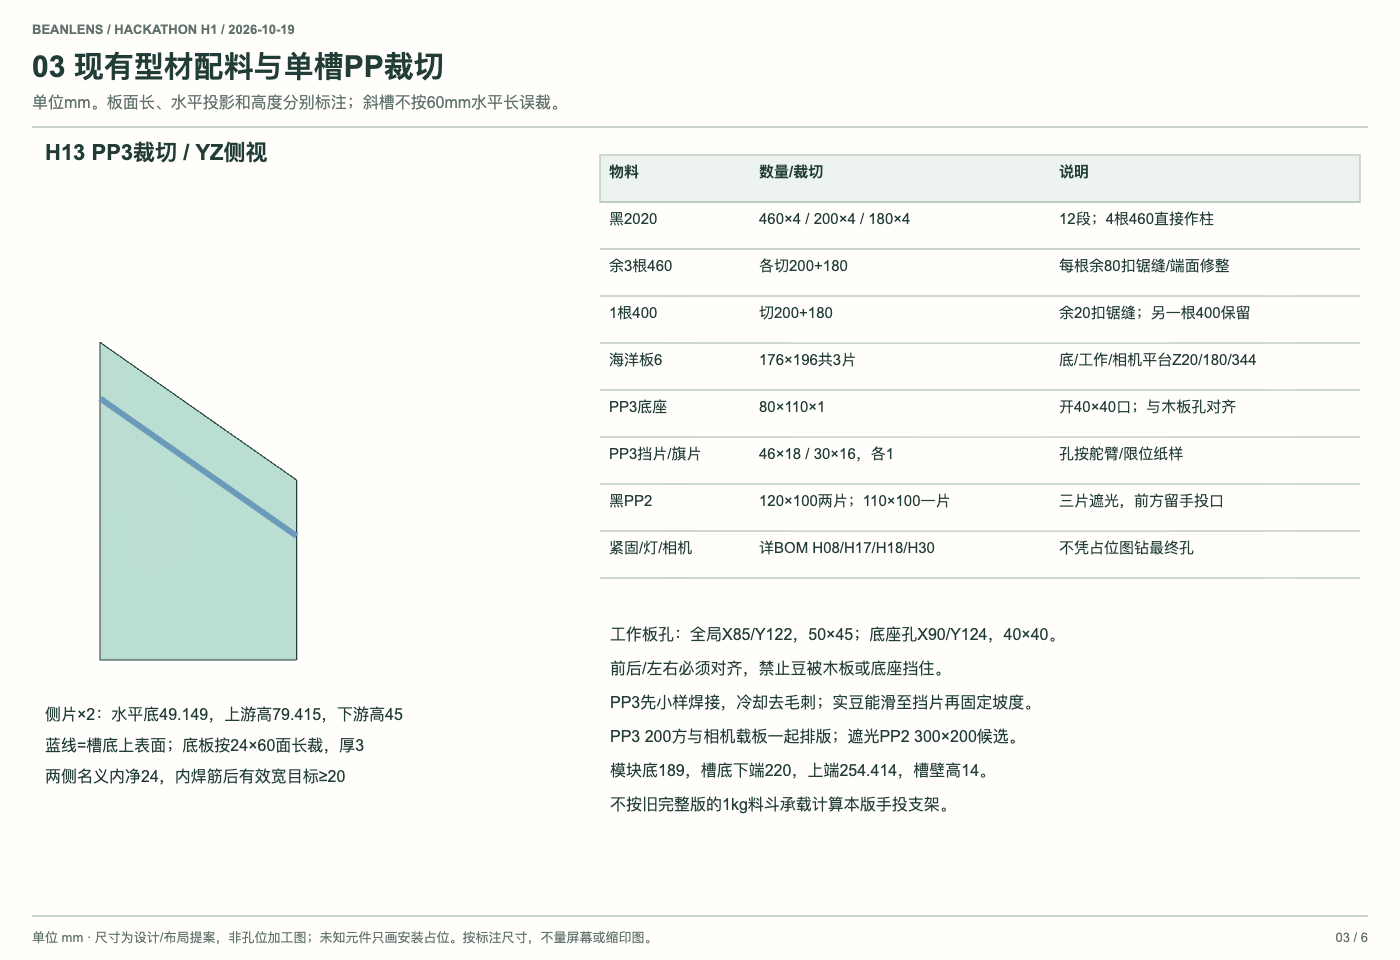
docs/hardware/hackathon-h1/03-cuts.png
