koffja/Beanlens/docs/hardware/hackathon-h1/04-power.png

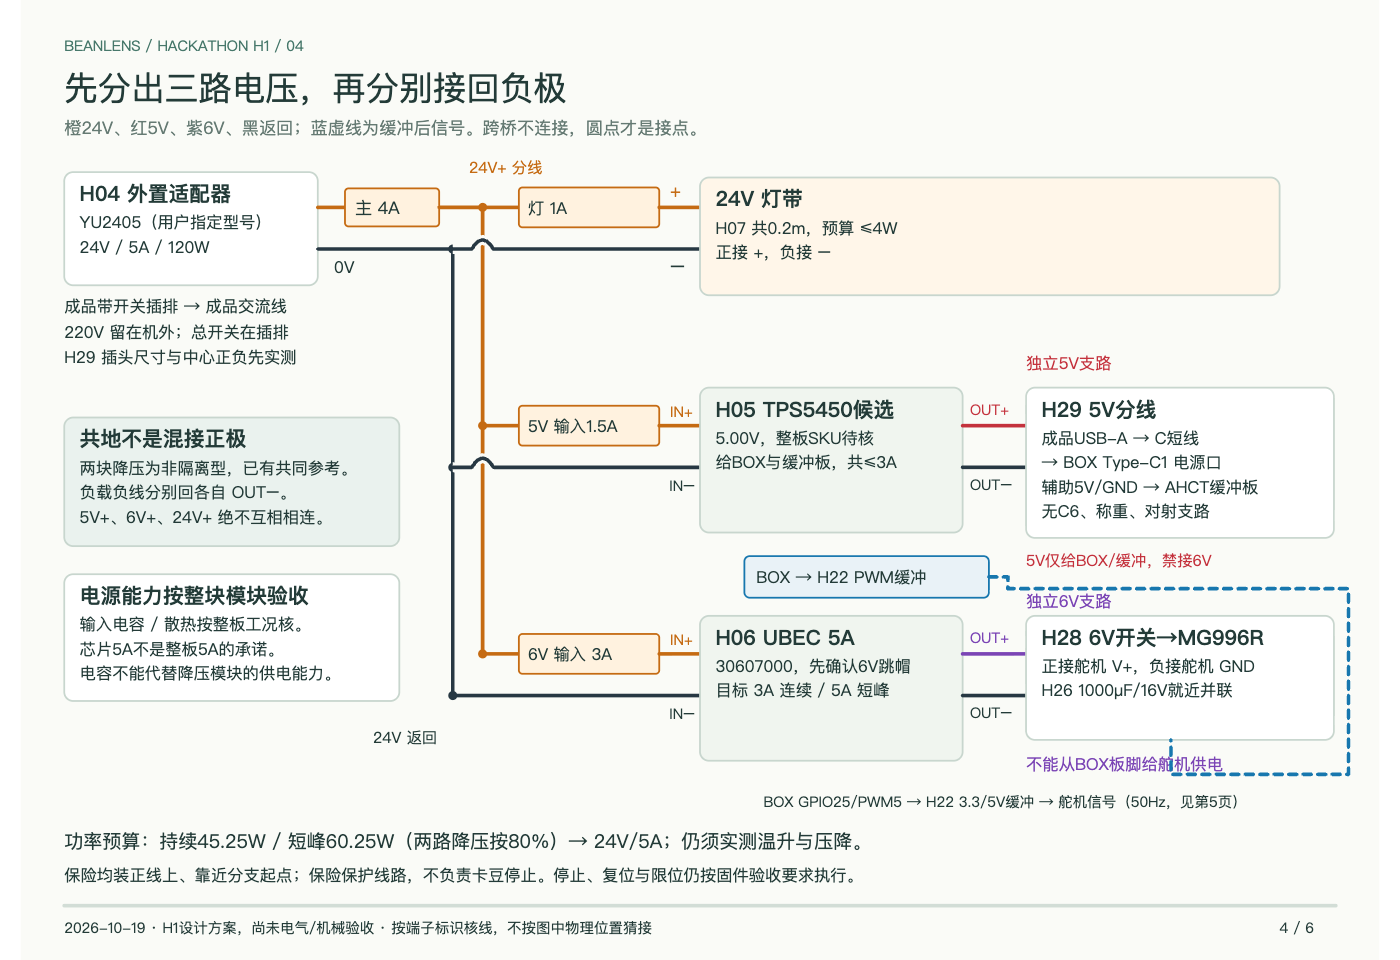
docs/hardware/hackathon-h1/04-power.png
