koffja/Beanlens/docs/hardware/hackathon-h1/05-signals.png

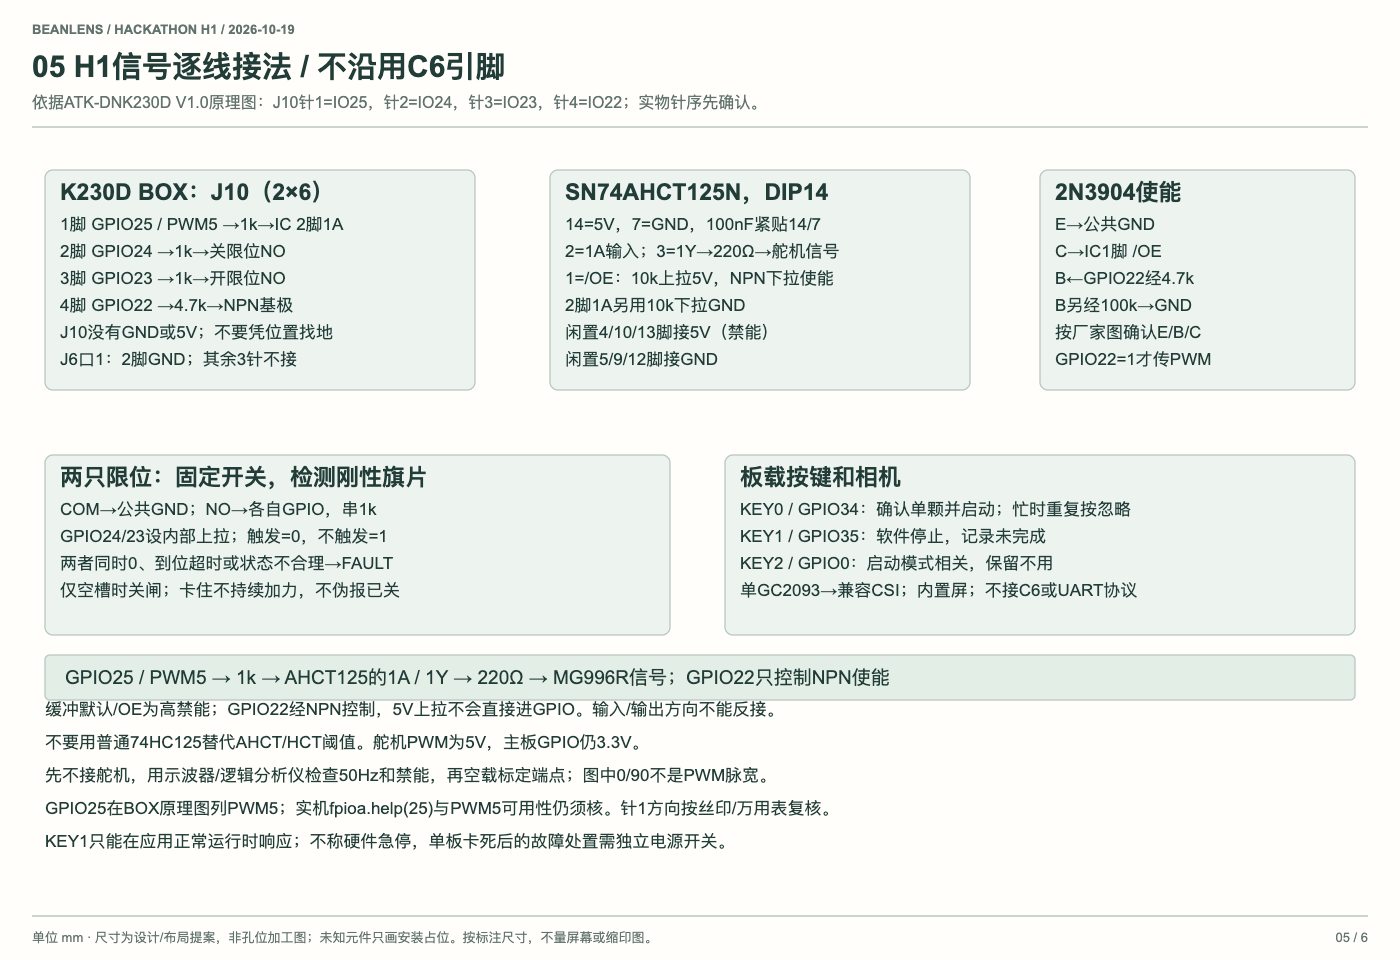
docs/hardware/hackathon-h1/05-signals.png
