koffja/Beanlens/docs/hardware/hackathon-h1/realistic/beanlens-h1-motion.gif

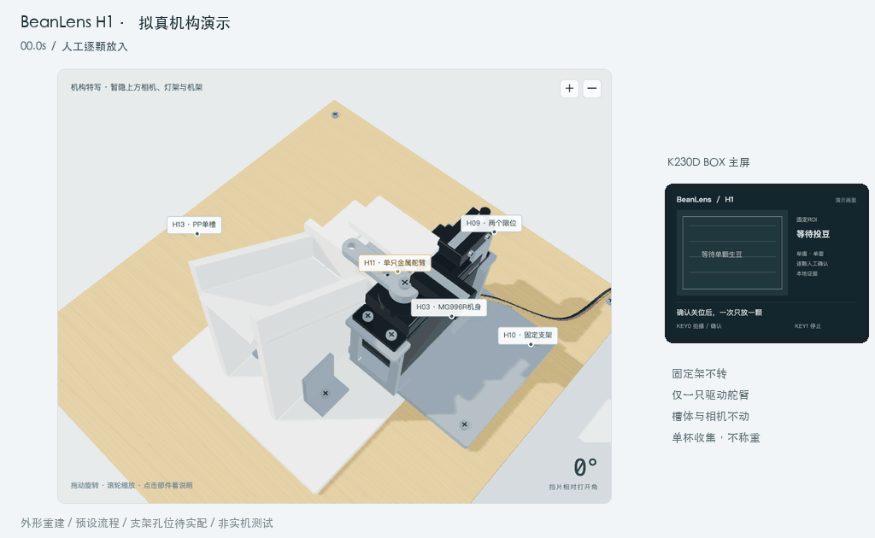
docs/hardware/hackathon-h1/realistic/beanlens-h1-motion.gif
