koffja/Beanlens/docs/hardware/hackathon-h1/realistic/preview-mechanism.png

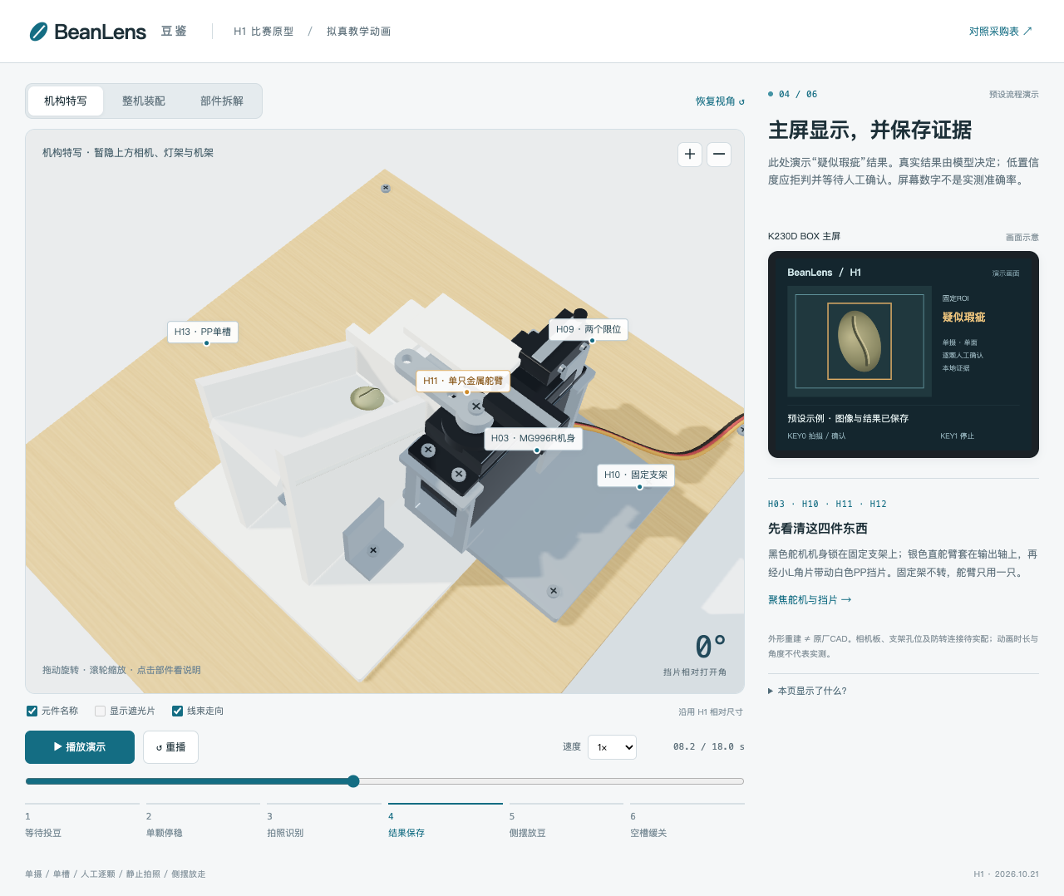
docs/hardware/hackathon-h1/realistic/preview-mechanism.png
