koffja/Beanlens/docs/hardware/hackathon-h1/realistic/preview-mobile.png

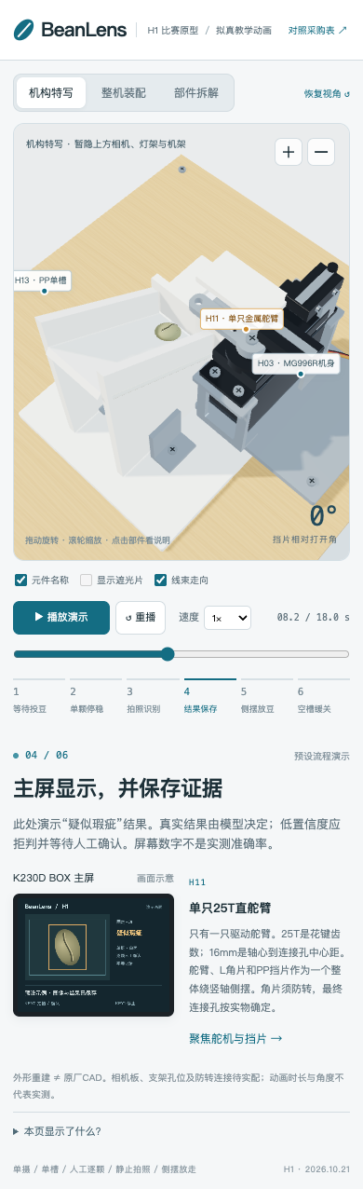
docs/hardware/hackathon-h1/realistic/preview-mobile.png
