koffja/Beanlens/docs/hardware/hackathon-h1/realistic/preview-whole.png

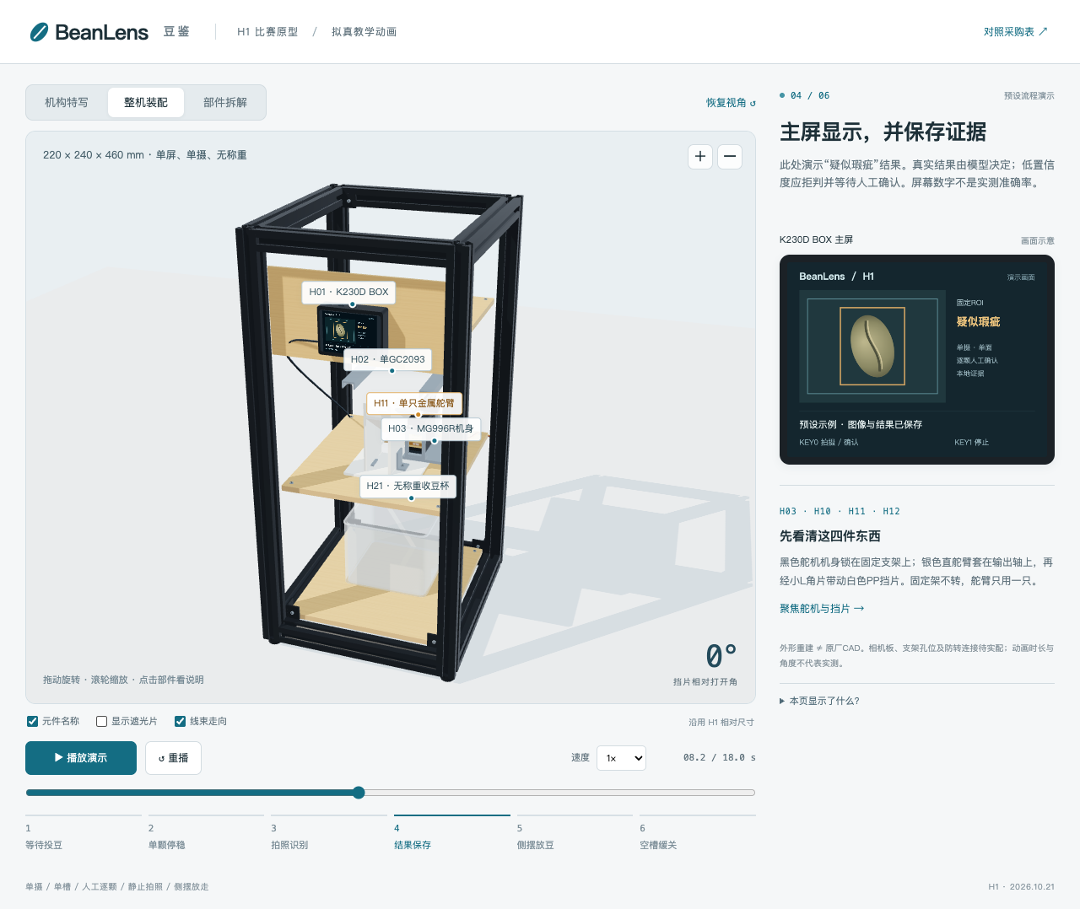
docs/hardware/hackathon-h1/realistic/preview-whole.png
