koffja/Beanlens/docs/hardware/hackathon-h2/realistic/beanlens-h2-motion.gif

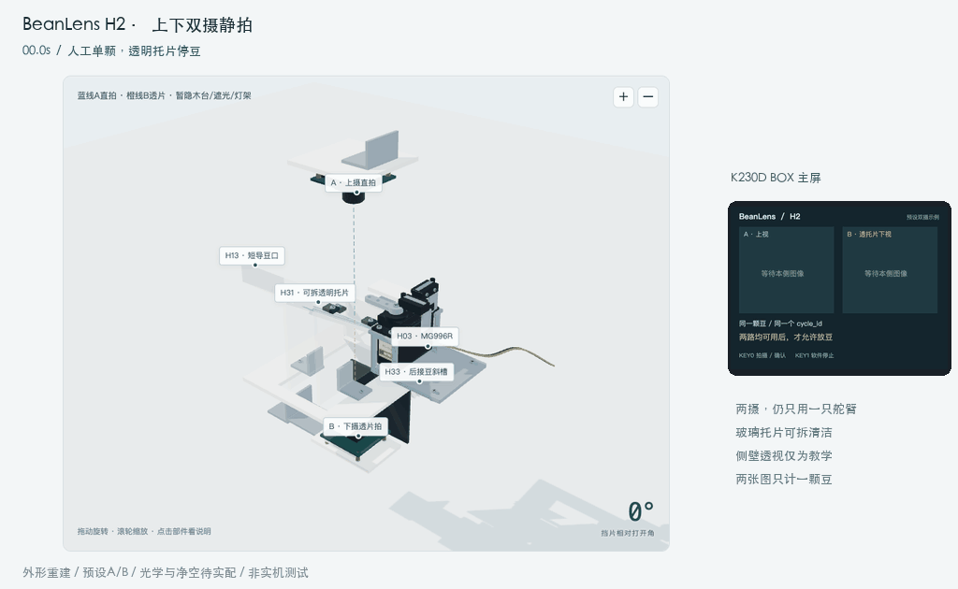
docs/hardware/hackathon-h2/realistic/beanlens-h2-motion.gif
