koffja/Beanlens/docs/hardware/hackathon-h2/realistic/preview-first.png

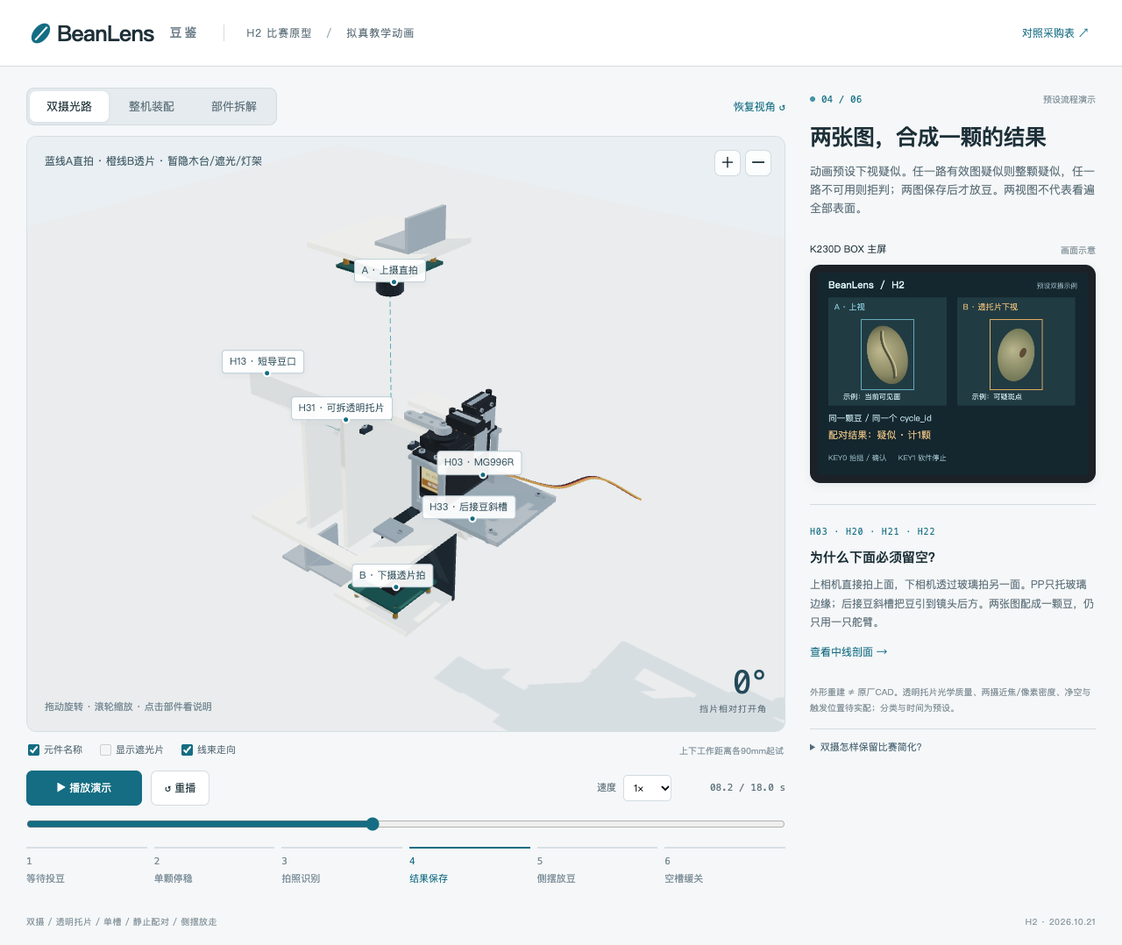
docs/hardware/hackathon-h2/realistic/preview-first.png
