koffja/Beanlens/docs/hardware/hackathon-h2/realistic/preview-mobile.png

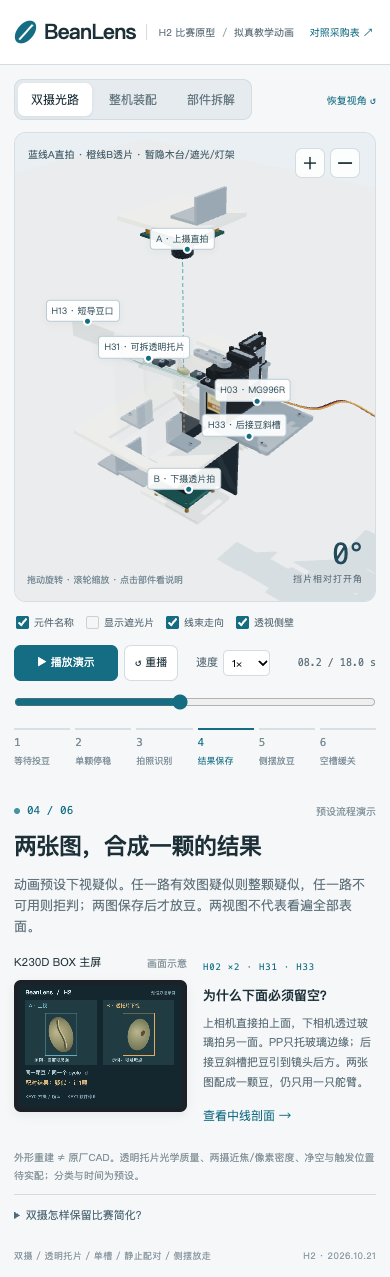
docs/hardware/hackathon-h2/realistic/preview-mobile.png
