koffja/Beanlens/docs/hardware/hackathon-h3/realistic/beanlens-h3-motion.gif

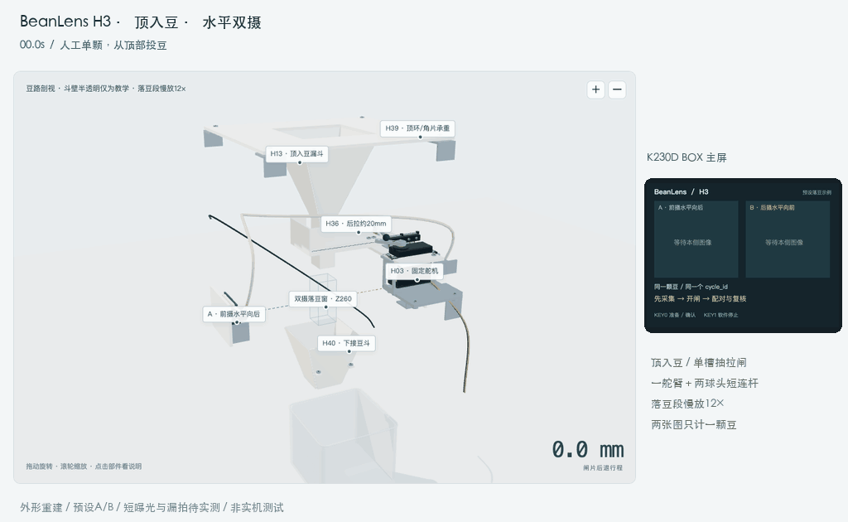
docs/hardware/hackathon-h3/realistic/beanlens-h3-motion.gif
