koffja/Beanlens/docs/hardware/hackathon-h3/realistic/preview-first.png

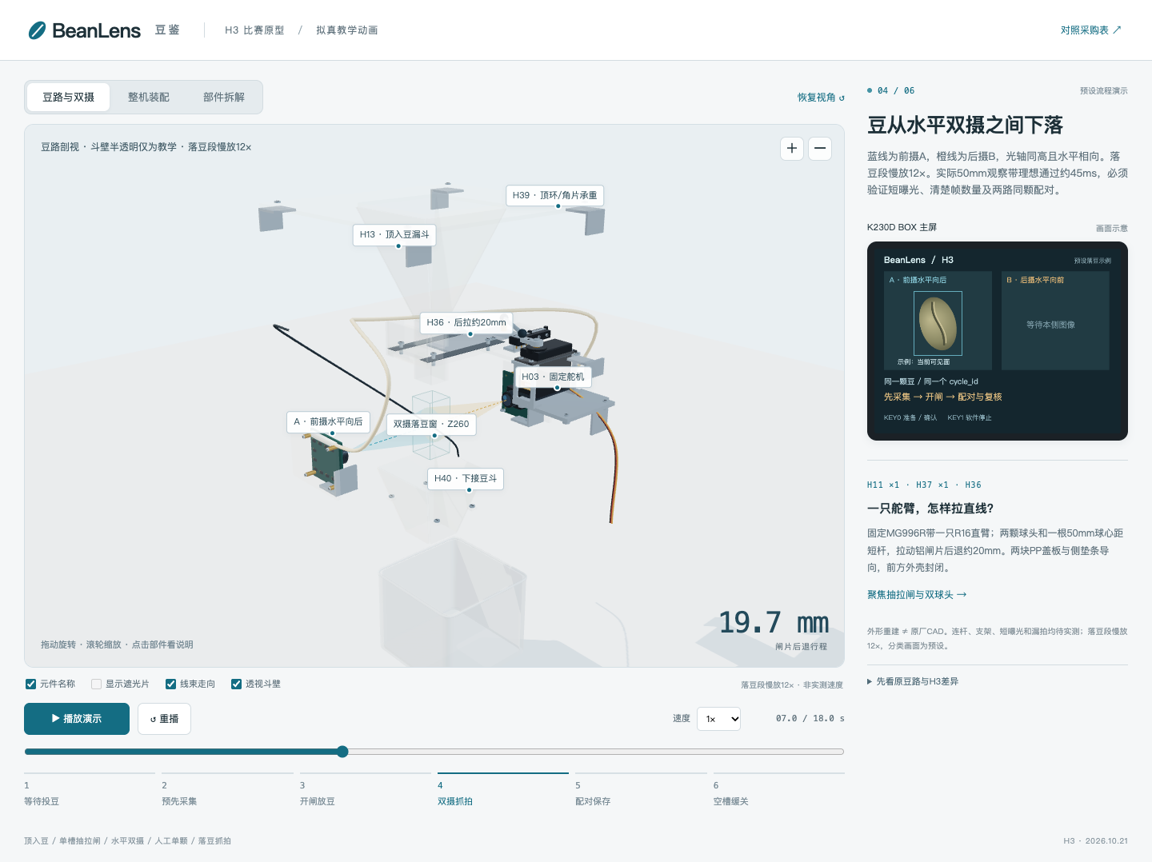
docs/hardware/hackathon-h3/realistic/preview-first.png
