koffja/Beanlens/docs/hardware/hackathon-h3/realistic/preview-gate.png

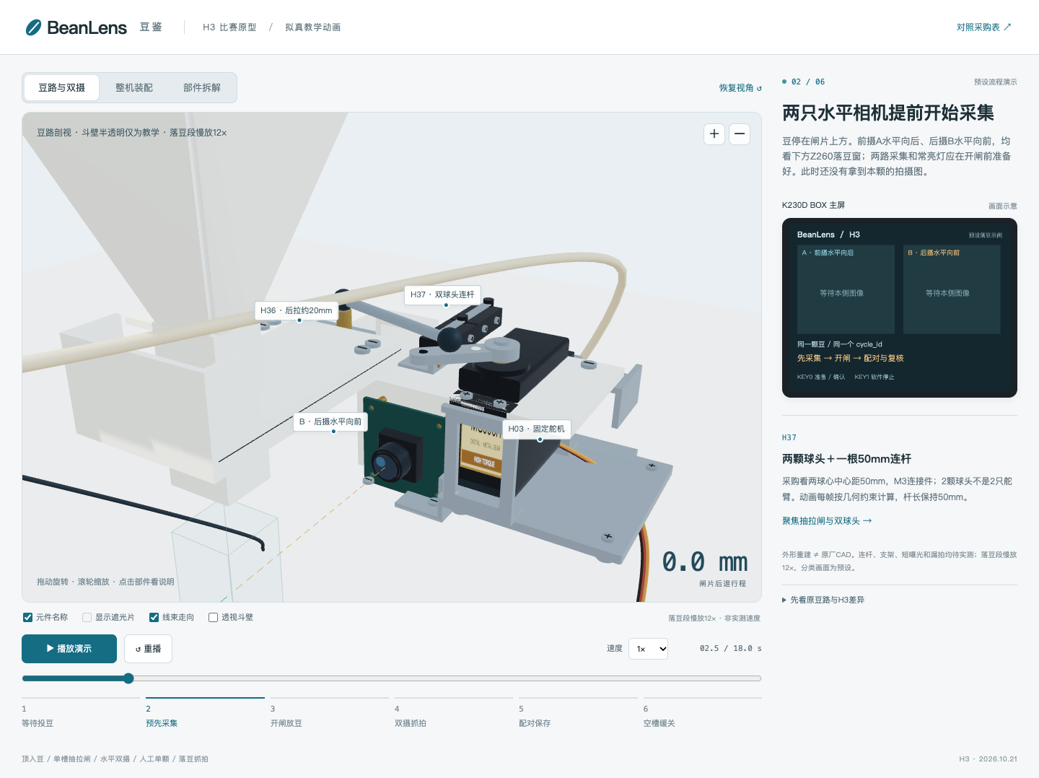
docs/hardware/hackathon-h3/realistic/preview-gate.png
