koffja/Beanlens/docs/hardware/hackathon-h3/realistic/preview-mobile.png

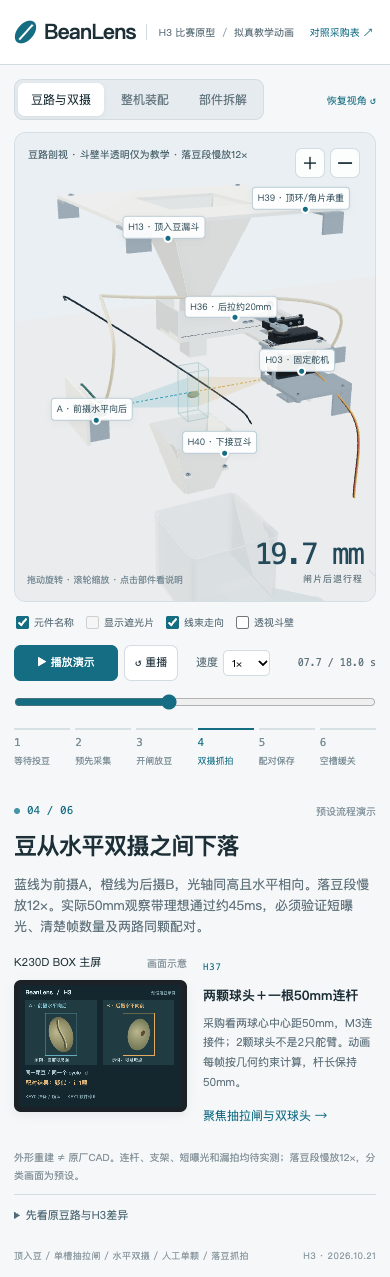
docs/hardware/hackathon-h3/realistic/preview-mobile.png
