koffja/Beanlens/docs/hardware/hackathon-h3/realistic/preview-whole.png

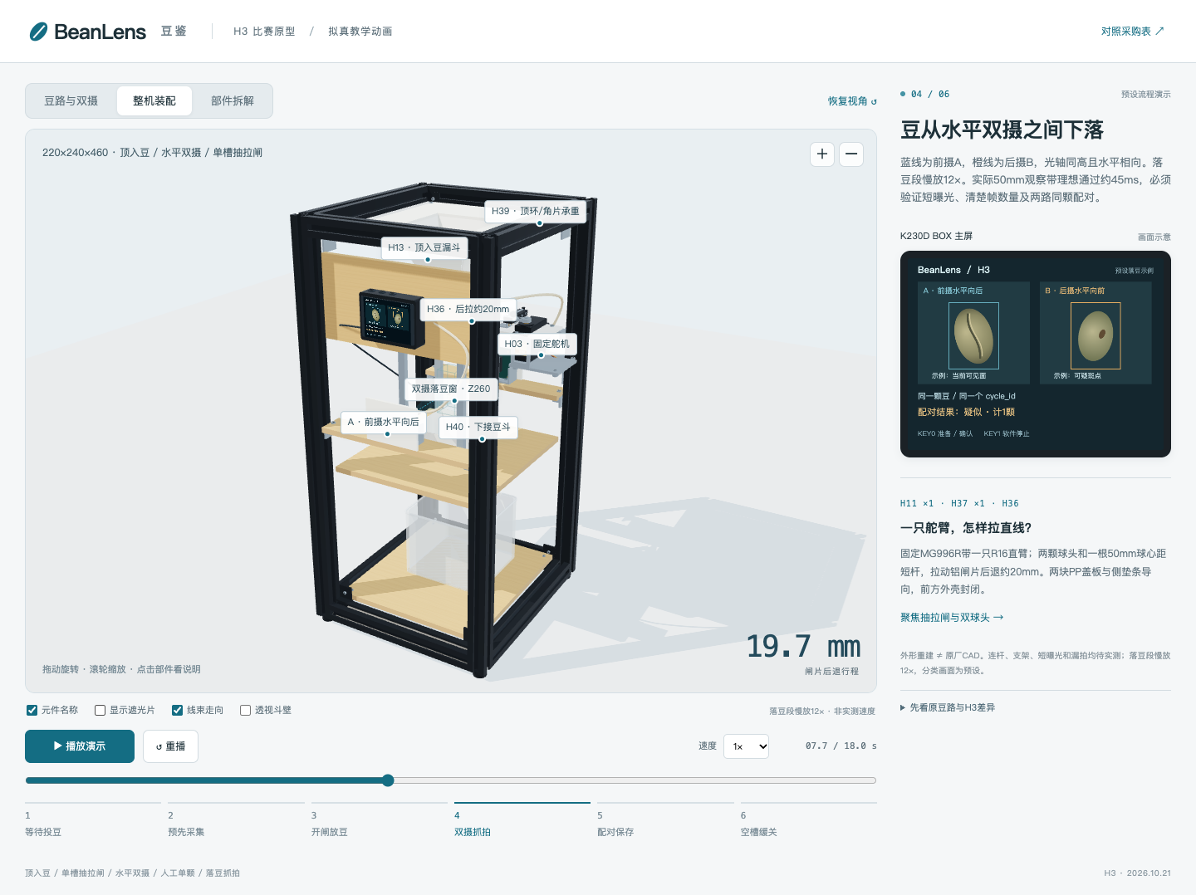
docs/hardware/hackathon-h3/realistic/preview-whole.png
