koffja/Beanlens/docs/hardware/hackathon-h3/side-section-h3.png

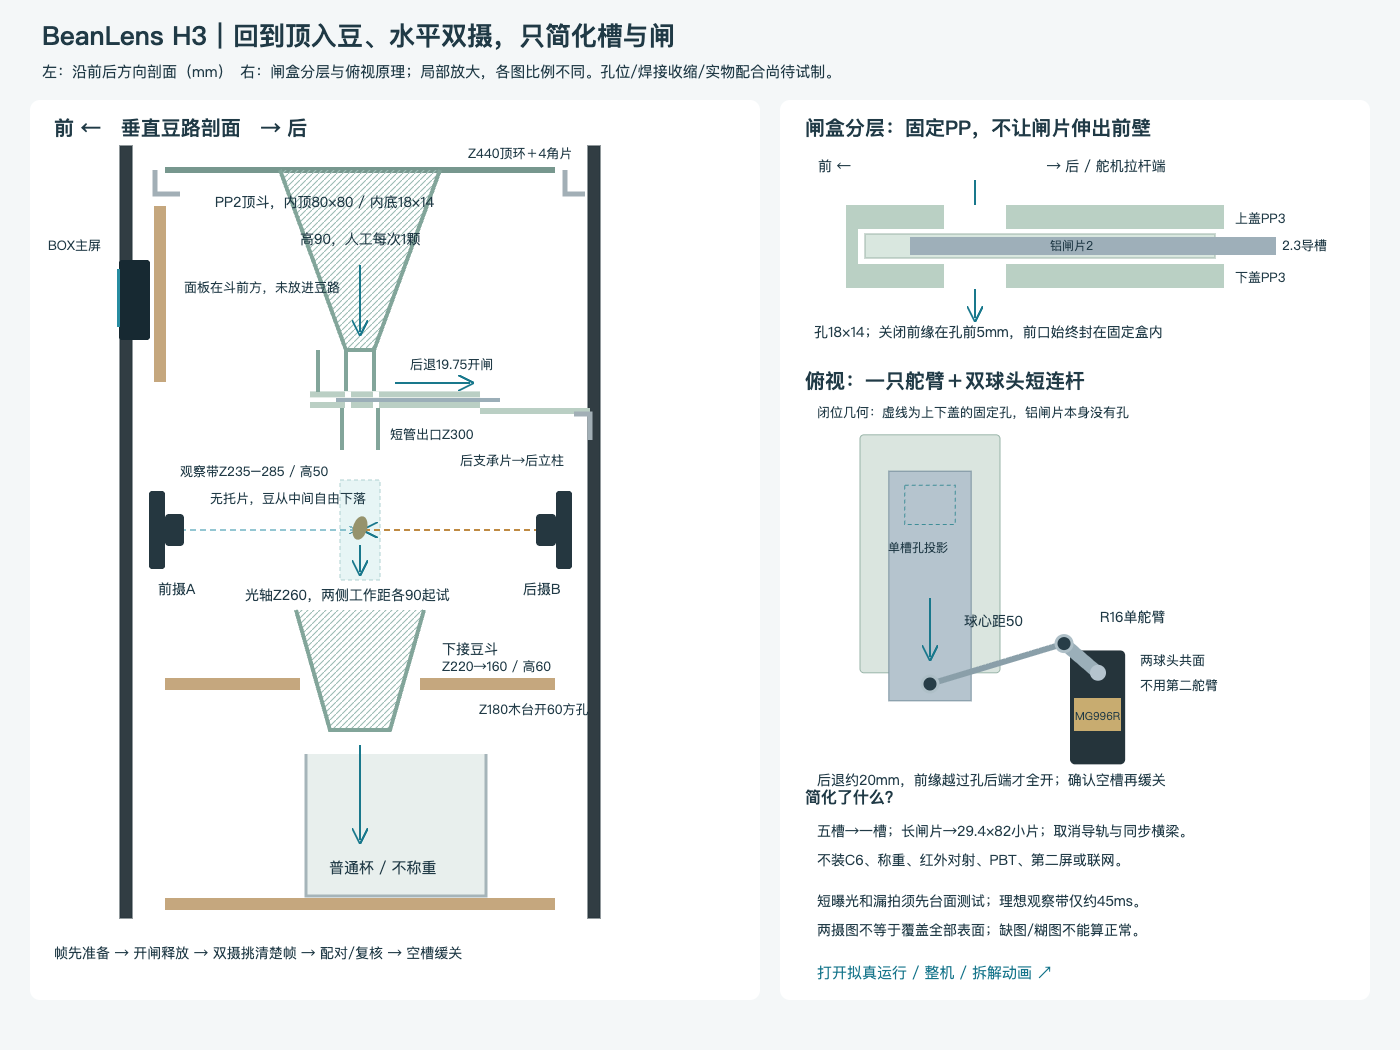
docs/hardware/hackathon-h3/side-section-h3.png
