koffja/Beanlens/docs/hardware/revision-v4.11/01-hopper-mount.png

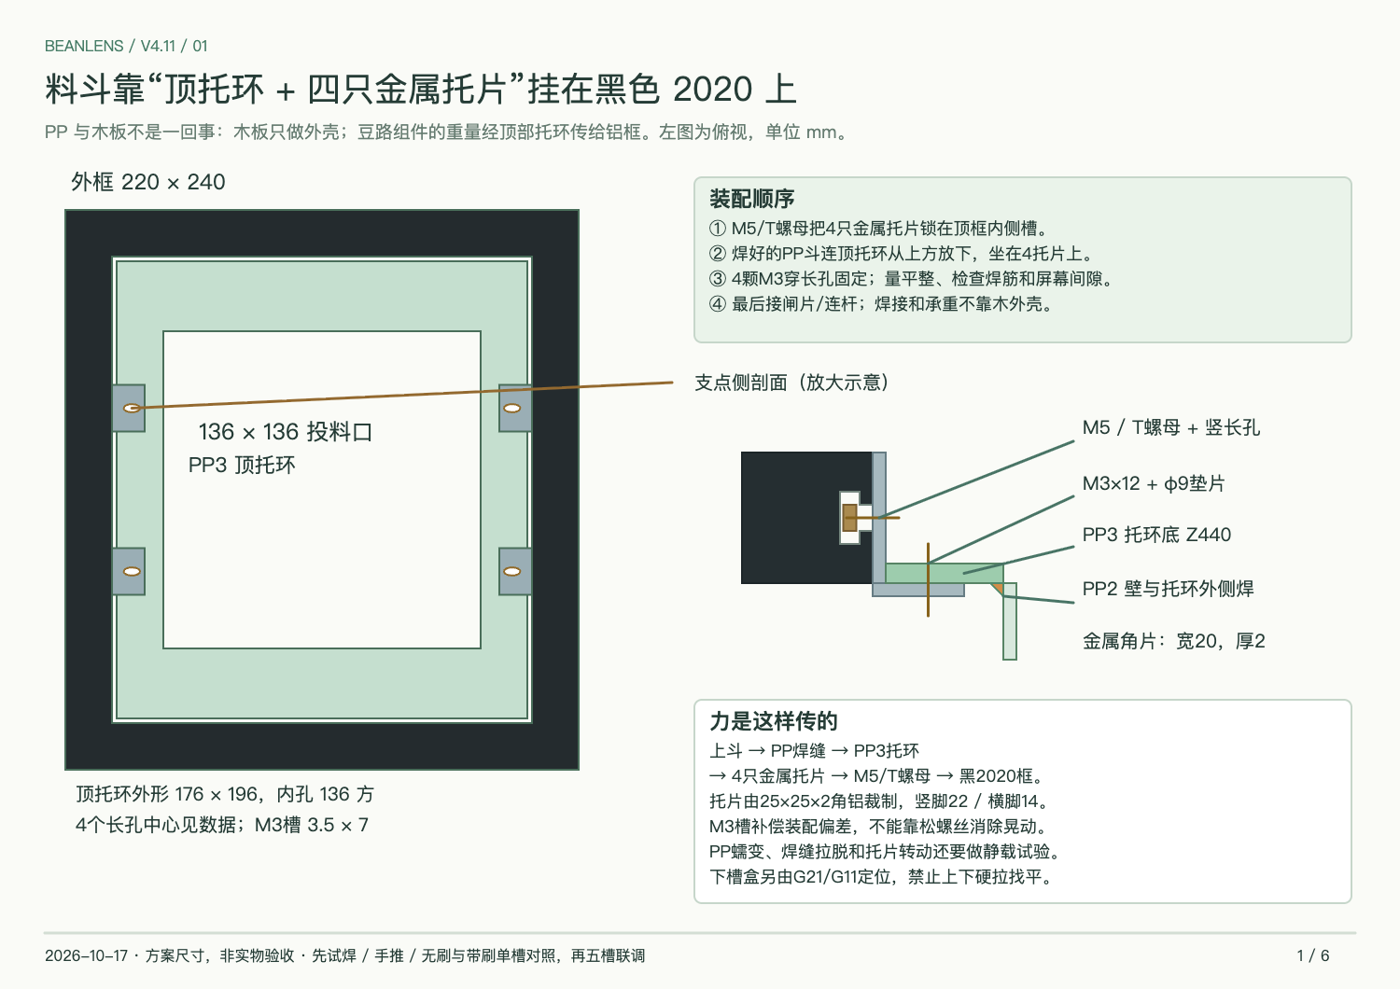
docs/hardware/revision-v4.11/01-hopper-mount.png
