koffja/Beanlens/docs/hardware/revision-v4.11/02-continuous-front-gate.png

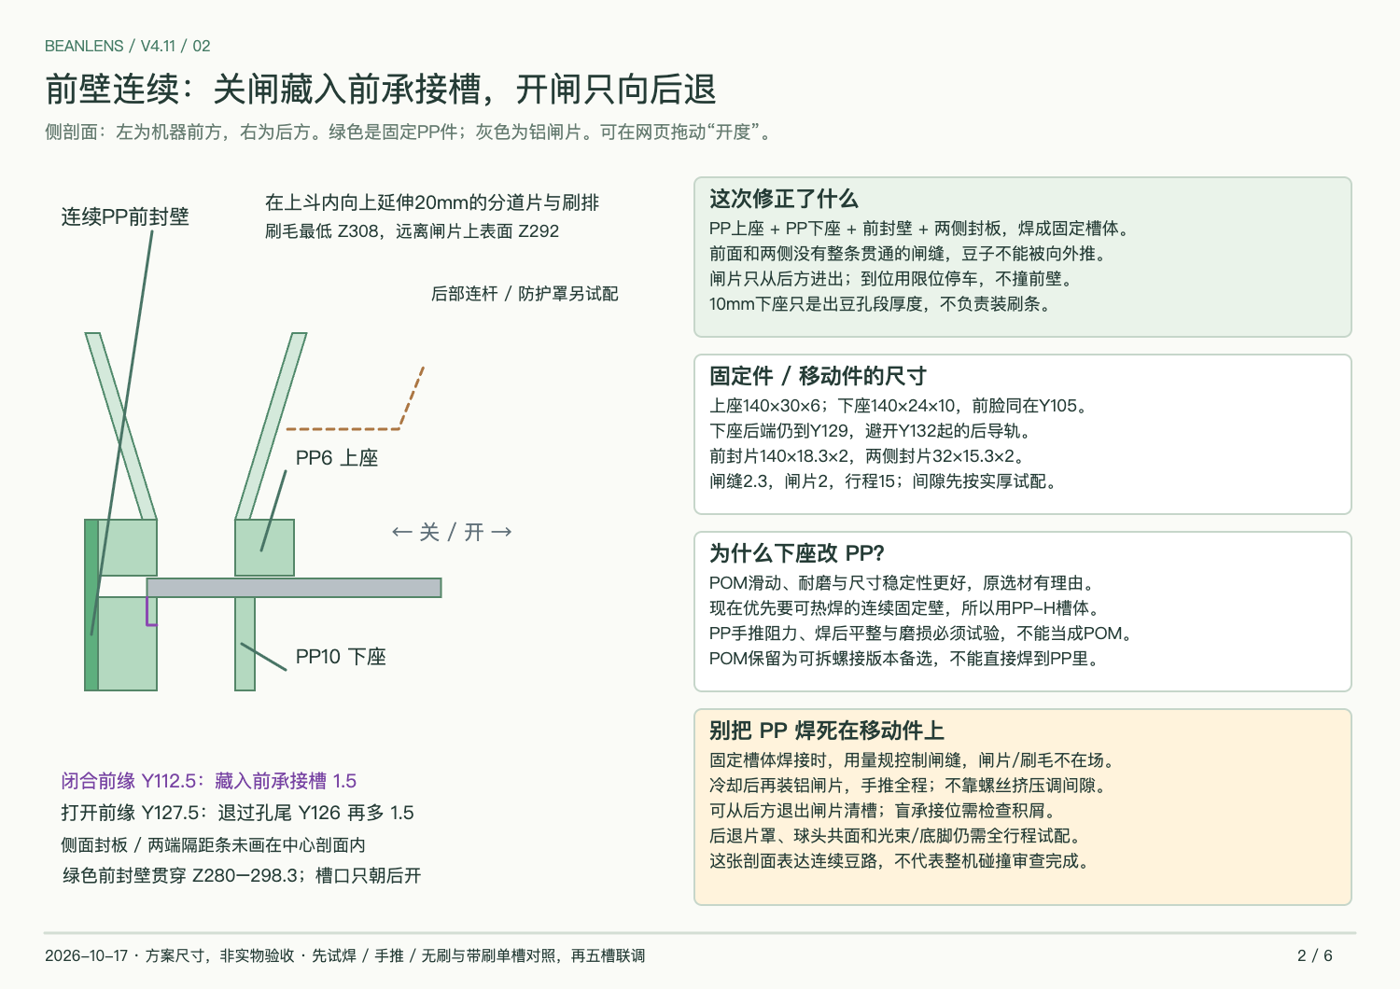
docs/hardware/revision-v4.11/02-continuous-front-gate.png
