koffja/Beanlens/docs/hardware/revision-v4.11/03-pbt-brush-cassette.png

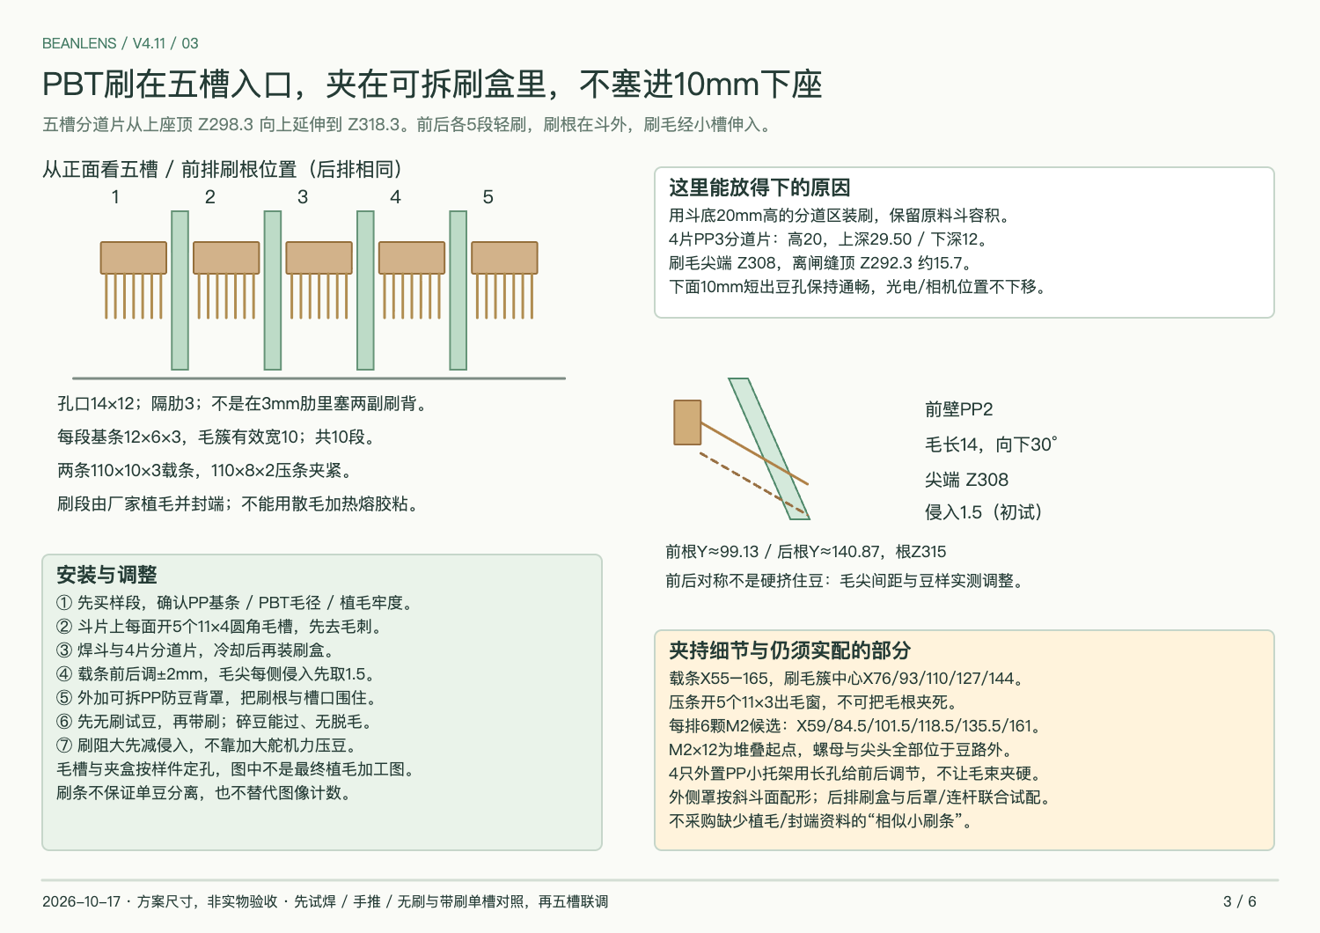
docs/hardware/revision-v4.11/03-pbt-brush-cassette.png
