koffja/Beanlens/docs/hardware/revision-v4.11/04-tps5450-comparison.png

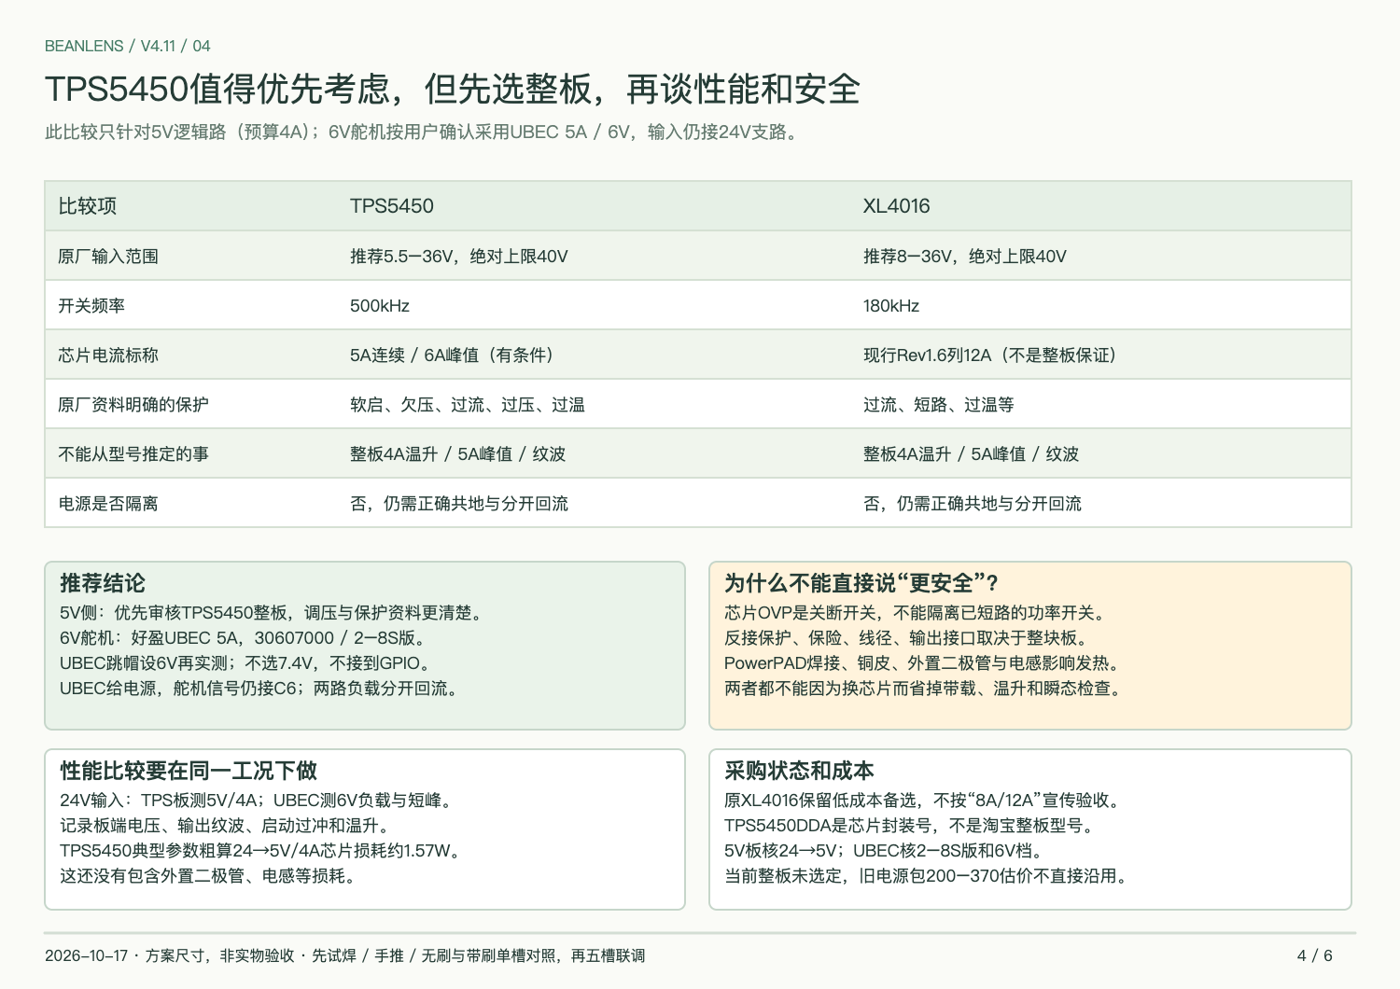
docs/hardware/revision-v4.11/04-tps5450-comparison.png
