koffja/Beanlens/docs/hardware/v4.4/beanlens-box-weighing-v4.4.png

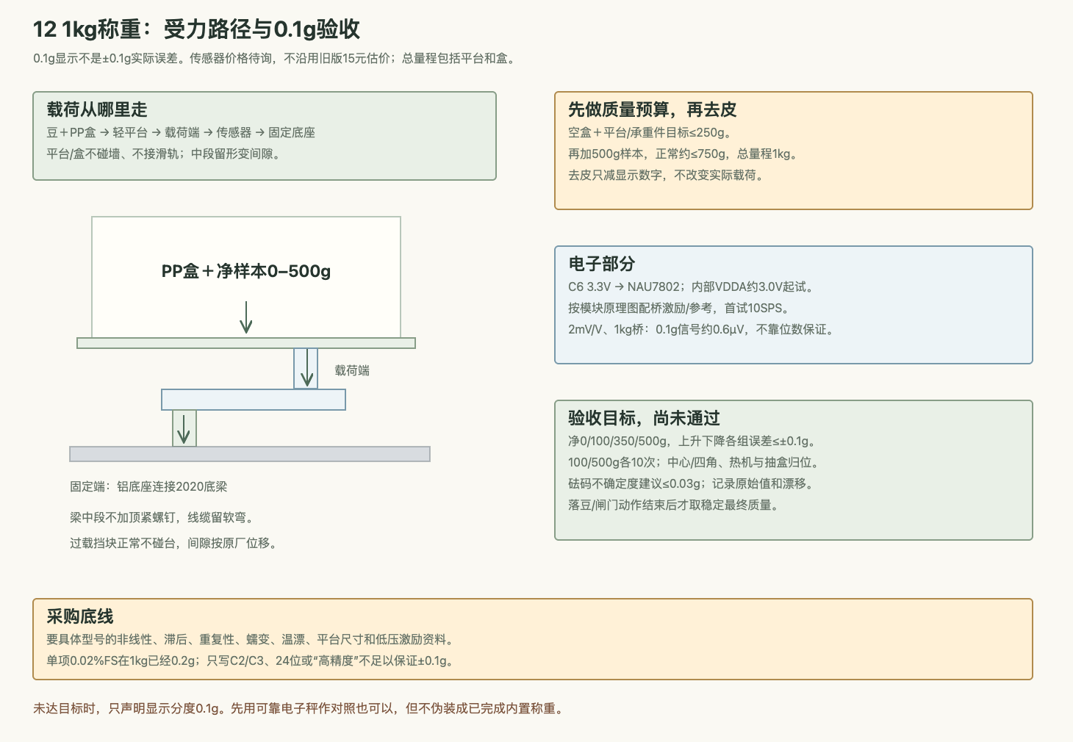
docs/hardware/v4.4/beanlens-box-weighing-v4.4.png
