koffja/Beanlens/docs/闸片改造-方案A-示意图.png

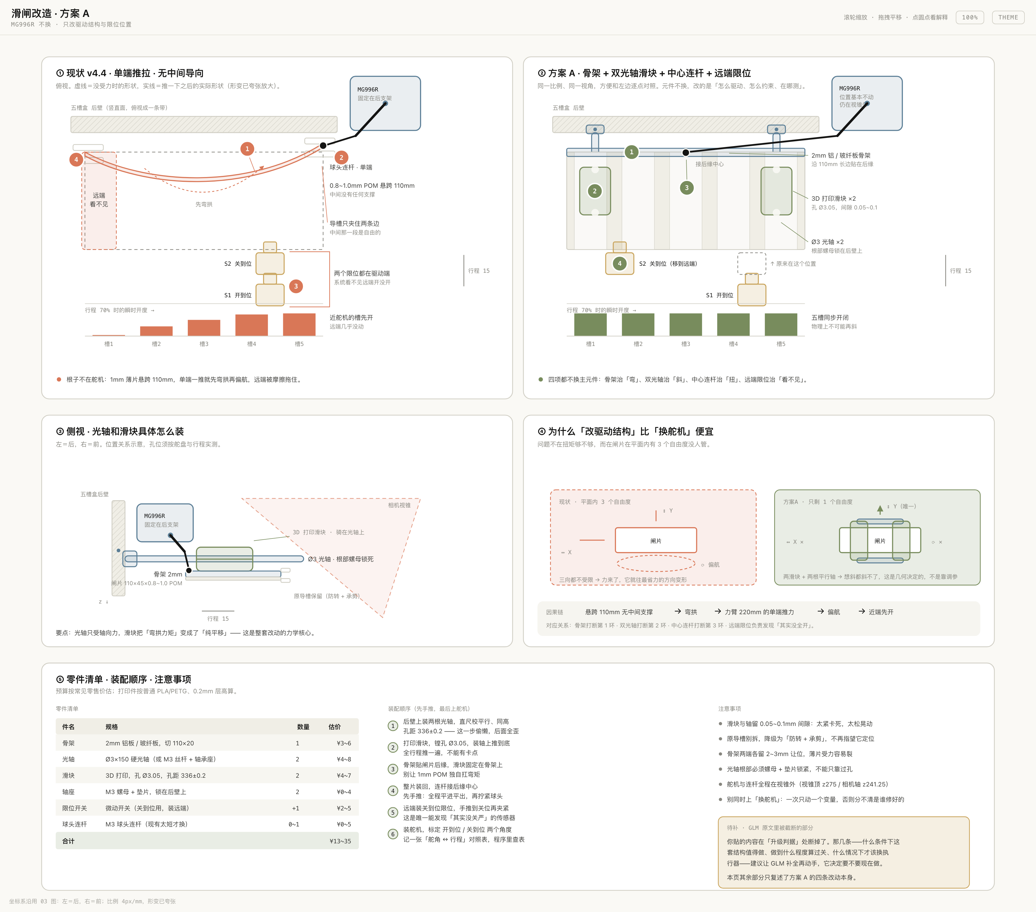
docs/闸片改造-方案A-示意图.png
