koffja/Beanlens/docs/闸片改造-现状vs方案A.png

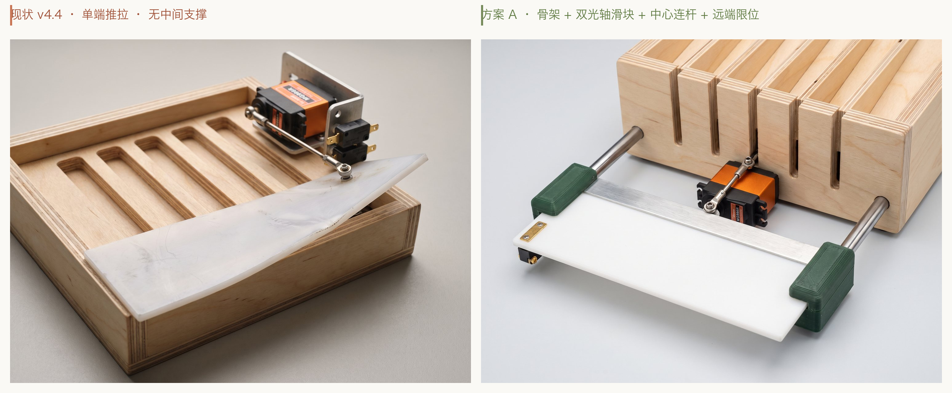
docs/闸片改造-现状vs方案A.png
