koffja/Beanlens/docs/闸片方案A-renders/01-现状-薄片单端推拉.png

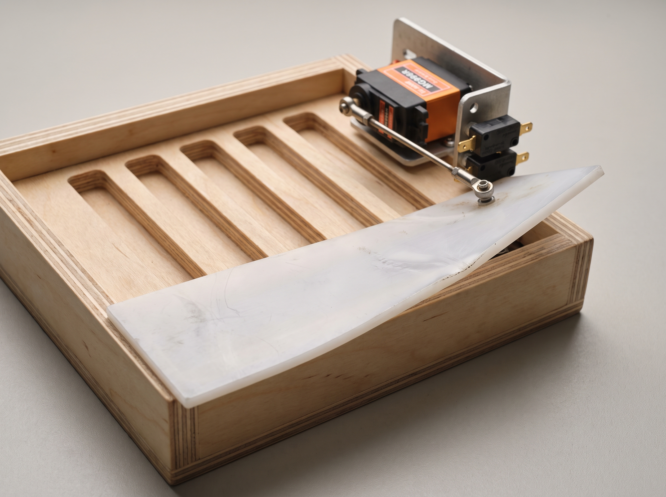
docs/闸片方案A-renders/01-现状-薄片单端推拉.png
