koffja/Beanlens/docs/闸片方案A-renders/02-方案A-双光轴.jpg

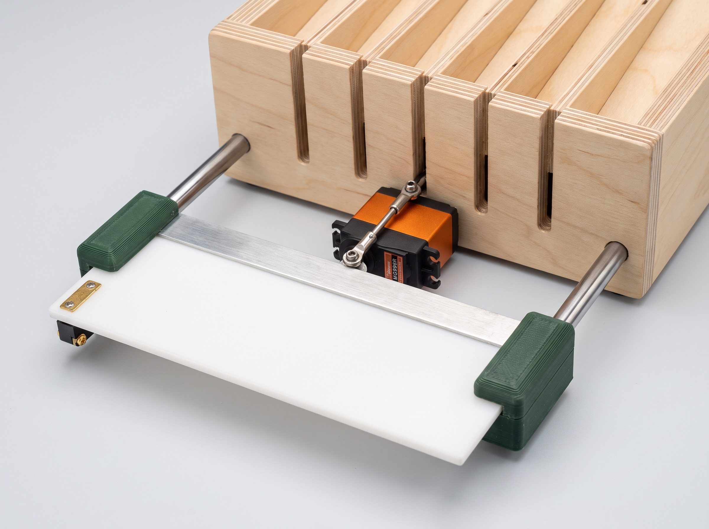
docs/闸片方案A-renders/02-方案A-双光轴.jpg
