koffja/Beanlens/docs/闸片方案A-renders/03-剖面-光轴悬臂.jpg

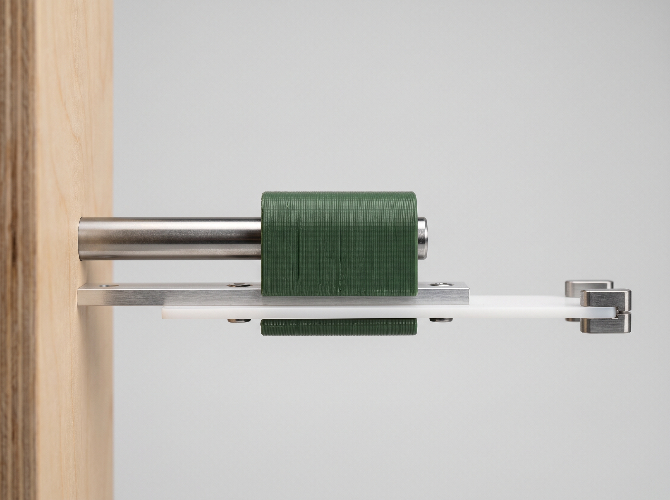
docs/闸片方案A-renders/03-剖面-光轴悬臂.jpg
