koffja/Beanlens/docs/闸片方案A-renders/04-特写-d1-spine.jpg

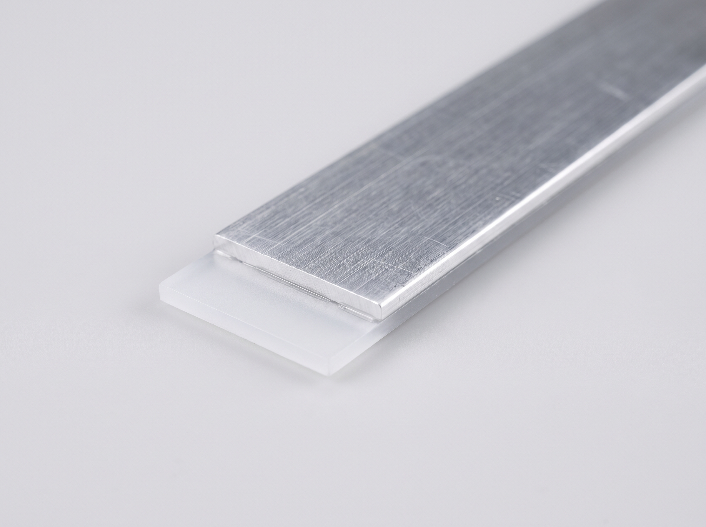
docs/闸片方案A-renders/04-特写-d1-spine.jpg
