koffja/Beanlens/docs/闸片方案A-renders/04-特写-d2-slider.jpg

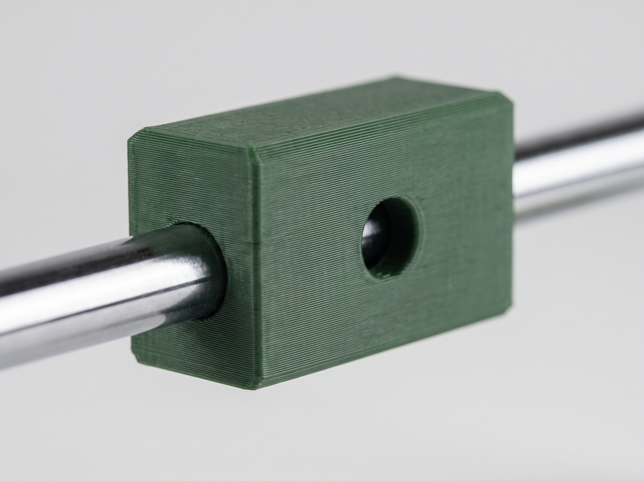
docs/闸片方案A-renders/04-特写-d2-slider.jpg
