koffja/Beanlens/docs/闸片方案A-renders/04-特写-d3-link.jpg

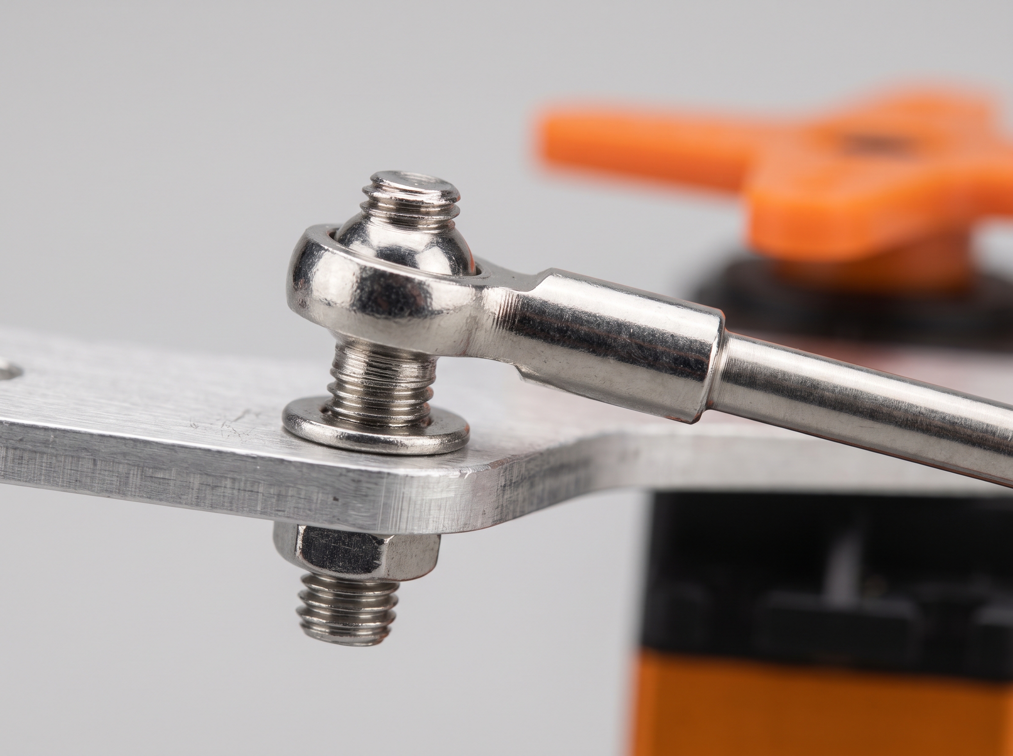
docs/闸片方案A-renders/04-特写-d3-link.jpg
