koffja/Beanlens/docs/闸片方案A-renders/04-特写-d4-limit.jpg

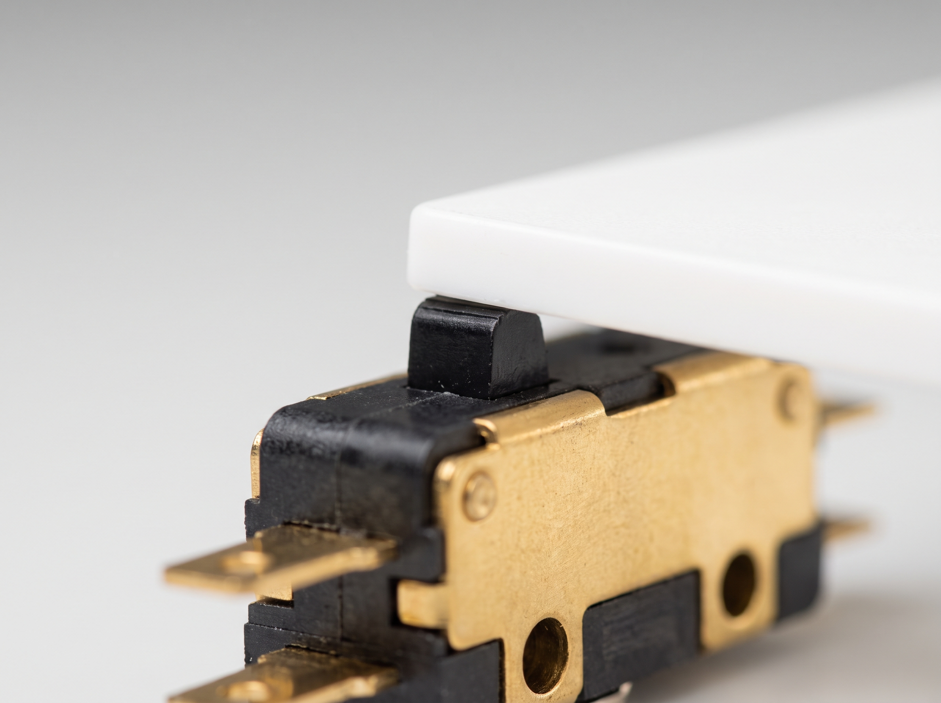
docs/闸片方案A-renders/04-特写-d4-limit.jpg
