koffja/Beanlens/docs/闸片方案A-图集/img/04b-滑块.jpg

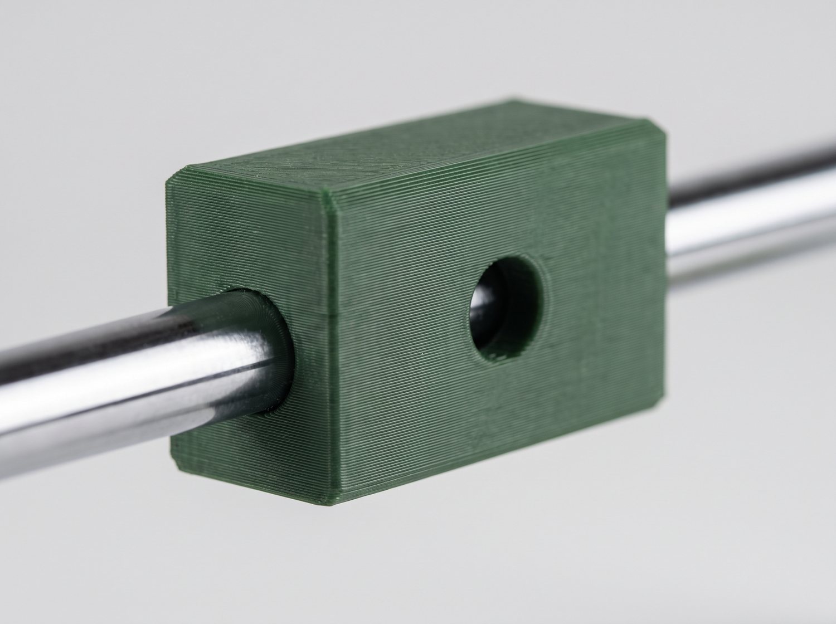
docs/闸片方案A-图集/img/04b-滑块.jpg
