koffja/Beanlens/docs/hardware/GATE-PARTS-20261012.md

> 当前机械入口已更新为[V4.8双屏/无木壳料斗/含板厚斜接](assembly-v4.8/beanlens-assembly-v4.8.html)。小过渡斗24.9mm＋可拆双法兰/密封6.8mm；旧V4.7等尺寸只作历史参考，控制原则另按实物标定。

# MG996R滑闸：1kg料斗载荷下的样机配件建议

> 2026-10-16更新：槽盒改为上下五窗叠层，G12为140×30×4 POM，模块总Z280→330；F04为PP-H2热焊136口主斗。详细尺寸与当前制作步骤见[V4.7制作指南](fabrication-v4.7/README.md)，采购以当前BOM为准。以下早期通用原理/试验计划仍有参考价值，不照旧支承毛坯下料。

日期：2026-10-12。状态：已核对下列原厂公开规格并做简化计算，尚未采购、加工、上板或实物承载验收。型号作为规格参照，未确认国内供应、报价或用户现有兼容MG996R的花键尺寸。机械总则见 [滑闸修正建议](GATE-REVISION-20261012.md)。

[装配概念示意图](illustrations/beanlens-gate-assembly-concept-20261012-v1.png)（生成式插图，非加工图；[生成说明与提示](illustrations/beanlens-gate-assembly-concept-20261012-v1.md)）。

后续用户明确槽内挡豆与缓关要求：优先看[俯视＋槽内侧剖面离线动画](illustrations/beanlens-gate-motion-20261012.html)及[补充设计说明](GATE-ENCLOSED-SLOW-CLOSE-20261012.md)。旧生成式图未表达完整封闭退片袋/接收槽，不作为该新结构的装配依据。

## 本次输入与推荐组合

用户补充：料斗最多装1kg生豆。按闸门可能承受全部约9.81N竖向静载考虑，不把料斗壁的分担当作必要前提。料斗/槽盒本体必须独立固定，不能一起压在闸片上。此处1kg是装豆量；没有据此改变原称重系统的1kg毛载荷、净0–500g目标。

推荐样机：一个MG996R → 25齿铝舵臂的16mm半径孔 → M4双球头短拉杆（约60mm球心距） → 居中连接耳 → 120×30×3mm滑架转接板＋110mm后角铝加强梁 → 2mm铝闸片。两侧直线导向维持平移，竖向重量由固定支承/导向传至机架。球头不负责左右同步。

| 配件 | 数量 | 可核验型号或加工规格 | 选用说明 |
|---|---:|---|---|
| 舵臂 | 1 | goBILDA **1900-0025-0104**；H25T花键、铝、厚4mm、φ4通孔，孔半径8/16/24/32mm | 选16mm孔；型号的32mm不是本设计力臂。原厂MG996R说适配Futaba舵臂，用户兼容件仍须量花键并试装，不能硬压 |
| 金属球头 | 2 | goBILDA **2913-0004-0241**；杆端M4×0.7内螺纹，球孔φ4，钢制、镀锌 | 网页标题24.1mm与当前示意图标注不同；现图球心至螺纹入口24.4mm、总长31.3mm、螺纹深13mm。以收到批次图纸/实测为准，不把商品标题长度当球心距 |
| 中间牙条 | 1 | goBILDA **2808-0004-0030**，M4×0.7、长30mm、不锈钢；可用同规格有质量保证的牙条 | 两端均右旋，调长需拆下一端旋转；不是免拆正反牙花篮螺杆 |
| 杆端锁紧螺母 | 2 | M4×0.7金属锁紧/并紧螺母 | 调好长度后分别锁住牙条与球头；不让球头随振动转松 |
| 球头安装 | 2组 | M4穿轴螺钉＋合适垫片/小径隔套＋防松螺母 | 长度按实际舵臂/连接耳厚度、球内圈宽度选；夹持球内圈，不能夹住外壳妨碍摆动。优先匹配φ4内孔的光杆/肩轴段 |
| 闸片 | 1 | **6061-T6铝板，110×45×2mm**，平板切割、去毛刺、平直前缘 | 名义尺寸供首样；支承、封口余量和实际槽盒决定最终外形。先不做锐利刃口，不用刀口硬剪豆 |
| 滑架转接板（补漏） | 1 | **6061-T6，120×30×3mm毛坯**，左右轨中心距约90mm起点 | 跨接两侧MGN9H，参考每块四孔15×16mm；收到导轨后按图开孔。10mm角铝脚宽不能代替此板 |
| 后横梁 | 1 | 6061/6063角铝，**10×10×2mm，切长约110mm** | 安装于闸片后端、豆路之外；用至少两处间隔固定点连接闸片；与转接板共同装配，不独自承担滑块四孔安装。不要把横梁放进5槽出口 |
| 中心连接耳 | 1 | **3mm厚铝耳板，φ4安装孔** | 孔位在宽度中心线；高度按舵臂运动平面定，竖向偏置力矩由导向承担。不可按旧23mm落差直接钻定 |
| 标准直线导向 | 2套 | **MGN9H滑块＋MGN9导轨，轨长100mm，每轨1滑块**；原厂参考HIWIN MGN9H-0/MGN9-0 | 左右对称、前后方向安装；HIWIN参考高10mm、块宽20mm、块长39.9mm，具体版本孔位按供货图纸。兼容件不自动继承原厂额定值 |
| 导向安装底座 | 1 | 平整铝底座，建议从**4mm厚**起试，外形/孔位按空间设计 | 两轨放在同一刚性平面，轨中心距约90mm作布局起点，滑块横跨总宽约110mm；长孔留给第二轨调整，手推顺后锁定 |
| 闸片下方低摩擦支承 | 1组 | 可拆POM支承条/带5个通口的支承框 | 布置在槽盒实体壁和侧边下方，通口与5槽对齐，不挡落豆。供垂直承载，兼顾排屑；金属导轨润滑不接触豆路 |

预算较紧时，导向可以改成可调POM导槽，但要加工和调间隙。若用户希望尽量用成品来保证平移，优先上述MGN9H两套；不是只买球头连杆就能省掉导向。

## 拉杆长度和运动匹配

采用当前goBILDA球头示意图的入口至球心h=24.4mm，牙条长a=30mm，两端各旋入e，则球心距：

`L = 2h + a − 2e`。

L=60mm时，每端约旋入9.4mm，小于公开13mm螺纹深度；中间露出的牙条约11.2mm，可容纳两只普通M4并紧螺母。约56–62mm可作为初调范围，但必须逐端确认有效啮合、不顶底和螺母占位。整根总外形长约74mm，不能把球心距、球头总长和牙条长度混用。

原厂图与标题存在长度差异，最终应根据收到的球头重新量h并计算。不要买“60mm牙条”来代替“60mm组装球心距”；否则连杆会明显过长。

采用16mm曲柄半径后，原±37°起点改为相对横向基准约±28°，理想共面居中机构行程：`2×16×sin28°≈15.02mm`。对于60mm连杆，整个行程无须接近共线死点。实际PWM端点仍用滑架限位标定，不能把±28°直接当舵机命令角。

杆件无需盲目加粗：钢M4短牙条适合这套小型机构的样机配置，中间自由段很短；其强度、螺纹、球头间隙和固定方式一起决定可靠性。若偏斜/摩擦造成推力过大，先处理导向与夹豆，不靠更粗牙条或更强舵机硬顶。

希望直接购买成套可调杆，可按以下规格询价：**双金属球头、杆端M4×0.7、球孔φ4、球心距约60mm且可调、带并紧螺母**。若选φ6mm铝合金主体＋M4端螺纹，也可作为备选，但须供应商提供完整球心距范围和螺纹啮合图；本次未核验某个成套国产SKU的载荷/间隙，不虚构型号。

工业备选为 **THK NHS4T**两只：M4×0.7内螺纹、φ4球孔、自润滑衬层；官方入口到球心24mm、整体长31mm。采用它时重新计算牙条长度和球心距，不沿用goBILDA的24.4mm。THK尺寸表给静径向载荷2250N，但这不是整套滑闸可用推力或舵机承载许可。

## 铝闸片是否适合1kg

建议2mm6061-T6作为样机起点，原因是刚度比原0.8–1.0mm薄POM更容易控制。厚度不能直接塞进原1.3–1.6mm导槽。若仍用POM槽，槽高先按**实测片厚＋总余隙0.2–0.4mm**试做，横向定位间隙另调；这不是最终验收公差。标准导轨方案也需设置防抬/封口余隙，避免把闸片刚性夹在两套约束之间。

用铝板作全宽简支梁粗算（跨度110mm、有效梁宽45mm、厚2mm、E=70GPa、总静载9.81N）：均布载荷挠度约0.081mm；以梁宽方向已分配的跨中集中载荷计算约0.130mm、弯曲应力约9.0MPa。板坯质量约26.7g。计算采用thyssenkrupp的材料参考数据，T6板材强度级别远高于该简化应力。

上述模型只说明全局弯曲的量级，**不是局部豆体点接触、边缘悬臂、螺孔、加工翘曲、安装应力或实物承重验收**。实际增加与槽壁对齐的下支承，可以减少悬空跨度；承重还受支承框、机架和固定件限制。3mm板不作为默认，先避免增加闸口台阶和改造空间。

表面要求：去毛刺、平直、无掉屑，滑动接触采用可拆POM支承；不让铝对铝干磨。可向加工商询问合适的清洁/表面处理，不用“铝合金”或“阳极氧化”名称自动宣称具体成品符合食品接触要求。

## 舵机适配与首样验证

1. 量用户MG996R输出花键并与所购25T舵臂对照，先不通电试装；保留与实际舵机匹配的中心固定螺钉。禁止套用其他舵机的中心螺钉长度或锁紧扭矩。
2. 将两轨固定在共同底座，装横梁/闸片，不接舵机。满行程手推不应卡滞；第二轨尚可调整时，让滑架自己找平行位置，再逐步锁紧。封闭/半开/全开分别量左右前缘差值。
3. 先空载，再0.25/0.5/1.0kg分级加载；载荷施加在实际豆路范围，检查挠曲、滑动阻力、封口和残流。用拉力计沿实际推拉方向量启动力和运动阻力。
4. 装60mm球心距短杆，检查全行程球头与舵臂、横梁、螺钉无干涉。独立6V供电，小角度标定，记录动作时间、电流和温升。
5. 原厂MG996R的6V堵转扭矩11kgf·cm不是连续工作扭矩，也不是用户兼容件能力证明。竖向重力9.81N不是所需水平驱动力；实际还包括支承摩擦、导向阻力与豆体挤压。仅凭1kg豆量不能宣布舵机已足够。卡豆时停机排障，不持续硬关。

纸样必须包含两套100mm导轨、约74mm拉杆总包络、舵机壳体与全行程扫掠，检查原后摄视锥；当前不冻结舵机支架高度和最终加工孔位。

## 原厂来源

- [goBILDA舵臂1900-0025-0104](https://www.gobilda.com/1900-series-single-servo-arm-25-tooth-spline-32mm-length/)；本次查看其REV1尺寸图：4mm厚、φ4通孔、8mm孔距、H25T。
- [goBILDA球头2913-0004-0241](https://www.gobilda.com/2913-series-steel-ball-linkage-female-m4-x-0-7mm-24-1mm-length-2-pack/)；查看页面原厂Schematic，记录标题与图纸差异。
- [goBILDA牙条2808-0004-0030](https://www.gobilda.com/2808-series-stainless-steel-threaded-rod-m4-x-0-7mm-30mm-length-2-pack/)。
- [THK NHS-T官方尺寸表](https://tech.thk.com/ct/products/pdf/tc_a23_006.pdf)，PDF第3–4页，NHS4T。
- [HIWIN MG系列官方尺寸表](https://www.hiwin.com/wp-content/uploads/Linear_Guideway-E-2.pdf)，MGN9H-0；型号/版本按供货图复核。
- [6061官方材料数据表（thyssenkrupp）](https://ucpcdn.thyssenkrupp.com/_legacy/UCPthyssenkruppBAMXUK/assets.files/material-data-sheets/aluminium/aluminium-6061.pdf)，T6板材、密度2.70g/cm³、E=70000MPa。
- [TowerPro MG996R](https://towerpro.com.tw/product/mg996r/)，原厂Futaba舵臂适配说明与堵转参数。

本次仅形成候选采购规格与计算。没有把国外标价计入BOM，不将兼容件称为原厂件，不改变既有总预算，不重绘V4.4 PDF/PNG/SVG/ZIP。

## 采购复核增量

[当前V4.5采购表](procurement-v4.5/beanlens-procurement-v4.5.html)已拆分G01–G20，明确两轨各含一块、不重复买块；新增转接板、封闭槽盒、底座、支承框、限位耳与紧固件。复算角度为±27.953°，均布挠度0.081mm、跨中集中梁载0.130mm，结论仍是首样候选。完整[采购核查与计算修订](PROCUREMENT-AUDIT-20261012.md)。毛坯不是最终孔位图。

## 2026-10-13 尺寸图增量

[装配图册第04页](assembly-v4.5/beanlens-assembly-v4.5.html#sheet4)将导轨中心距画为94mm（替代前述约90起点），给82mm净槽列与侧结构留布局量；不是验收公差。图示底座避空方向、轨块/转接板/闸片叠高，舵机与后视锥仍需实物纸样。其他原厂配件型号不变。
