koffja/Beanlens/docs/hardware/hackathon-h1/bom-h1.csv

编号 | 名称 | 型号 | 规格 | 数量 | 单位 | 采购状态 | 完整版对应 | 说明 | 单价CNY
H01 | 识别/显示/控制板 | 正点原子 K230D BOX | 含内置2.4屏/用户按键，64.3×47.6×15.4外壳参考；TF按原套件 | 1 | 件 | 复用优先，实物核对 | A01 | Type-C1供5V；Type-C2不供电，不拆原壳。已有套件257报价不重计。
H02 | 唯一相机 | GC2093-M12-90度无畸变（用户型号） | 单只兼容BOX CSI的完整模组＋配套排线；近焦/PCB孔距待核 | 1 | 件 | 复用优先，实物核对 | B01 | 从原双摄取一只；114.32为两套历史包价，不擅填单价。镜头到豆约80–140mm起试。
H03 | 舵机 | MG996R 位置版 | 1只，独立6V；外形40.7×19.7×42.9参考，轴竖直 | 1 | 件 | 复用优先，实物核对 | A03 | 非连续旋转版。输出轴只带轻挡片；不承人工按压力。
H04 | 主电源 | YU2405（用户指定） | 机外24V/5A/120W；实际厂牌/插头/极性/AC线另核 | 1 | 件 | 复用优先，实物核对 | A07
H05 | 逻辑降压 | TPS5450成品板候选，整板SKU未定 | 24V→5.00V；H1只给BOX和缓冲板，3A连续预算待验 | 1 | 件 | 复用优先，实物核对 | A08 | 不是裸DDA芯片；先空载量5V再接BOX，不选未证实供电板。
H06 | 舵机降压 | HOBBYWING UBEC5A / 30607000 / 2–8S | 设6.0V；原厂5A持续，本机3A持续/5A短峰预算 | 1 | 件 | 复用优先，实物核对 | A17 | 断电设跳帽，量6V后接舵机；不能给GPIO或主板。
H07 | 固定照明 | 复用原24V 6000K/Ra98灯带，完整SKU待核 | 2段各100mm有效长，合计0.2m；≤20W/m预算 | 2 | 段 | 复用优先，实物核对 | A05 | 100只是目标有效长，按实际切点改支架；选同批不混色温，不做PWM调光。
H08 | 灯铝槽 | U形铝槽，候选外14×8×100mm | 配实际灯带PCB宽，2条固定斜照 | 2 | 条 | 复用优先，实物核对 | L02 / L03
H09 | 开/关限位 | OMRON SS-01GL 微负载金合金触点 | 每端1只，COM/NO，低电平有效；19.8×6.4壳体/9.5孔距参考 | 2 | 件 | 复用优先，实物核对 | S01 | 限位检测挡片/支架旗片而非仅检测PWM命令；3.3V内部上拉条件实测接触可靠性。
H10 | 舵机专用安装件 | MG996R金属固定支架＋60×60×3铝转接毛坯 | 固定到工作台，轴心目标X140/Y126/Z240，长孔/垫高按实物 | 1 | 件 | 复用优先，实物核对 | G14 | 机身安装孔和输出轴偏置收到后定，不能凭包络钻最终孔。
H11 | 舵臂 | MG996R匹配25T金属直臂，16mm孔半径 | 只用16mm孔；孔径优先M3，若现有goBILDAφ4加适配套 | 1 | 件 | 复用优先，实物核对 | G01 | 中心紧固螺钉用舵机原配；兼容件先试25T，不能靠螺钉硬拉花键。
H12 | 挡片/槽脚角铝加工套件 | 6061角铝20×20×2，宽12×1、宽15×2 | 宽12接舵臂/PP挡片；宽15两只固定槽壁到底座 | 1 | 套 | 复用优先，实物核对 |  | 孔位按舵臂/挡片共面实配；两颗M3×8带防松，螺母在豆路外。
H13 | PP停豆槽/挡片/旗片 | PP-H 3mm 板，候选200×200mm一片 | 槽底24×60；侧支承梯形×2；底座80×110；挡片46×18；限位旗片30×16 | 1 | 片 | 复用优先，实物核对 |  | 详见cut-list-h1.csv。35°为起试坡度；焊筋后有效宽≥20，先实豆滑落测试；不再做大漏斗。 另含相机PP3 60×60载板，排版后核够料。
H14 | 机架型材 | 已有黑色欧标2020，同槽型 | 460×4立柱、180×4宽梁、200×4深梁；共12段 | 12 | 段 | 复用优先，实物核对 | F01 | 4根460留整；另3根460各切200+180；1根400切200+180；剩1根400保留。无需新增型材。
H15 | 框架角码/M5/T螺母 | 欧标2020配套两孔90°角码，黑色优先 | 16角码使用+4备用；M5螺钉/T螺母各40只 | 20 | 套 | 复用优先，实物核对 | F02 | 含4套备用，长度按槽型配；不使用三通/四通方块。
H16 | 固定木平台 | 6mm海洋板，按已有余料裁 | 176×196×6共3片：底座、工作台、相机平台 | 3 | 片 | 复用优先，实物核对 | F03 | 工作台Z180–186开50×45落豆孔，孔全局X85/Y122；其余平台不装称重。原有木件裁好则先排版再下刀。
H17 | 平台支承角片 | 2020配套内角片＋M5/T螺母＋M3×16/φ9垫片螺母 | 3平台×4点=12用，16套购含4备 | 16 | 套 | 复用优先，实物核对 | F11 | 承托底面Z20/180/344；松装找平，不能用螺钉拉弯木片。
H18 | 相机可调安装 | 30×30×2角铝长40＋PP3 60×60载板＋M2隔柱 | 单套，目标光轴X110/Y112、镜头Z320起试 | 1 | 件 | 复用优先，实物核对 | B13 | 相机40方只画占位；按实际模组孔距/排线定孔，镜头对准下游停豆位，先标尺调焦。
H19 | BOX固定框 | 复用80×64外压框/背托与软垫夹片 | 原壳整机固定在前框，保留KEY0/KEY1及TF/Type-C可达；配M5/T螺母4套与软垫夹片 | 1 | 件 | 复用优先，实物核对 | F15 | 不另买屏，不钻原壳；用一块176×112木余料或小PP承板，按原壳实配。
H20 | 局部遮光片 | 黑PP2板，候选300×200mm | 左右120×100各1，后110×100×1；前方敞开手投 | 3 | 片 | 复用优先，实物核对 | F07 | 左X65/右X175，后Y190；板底Z225/顶325；与摆片后扫掠保持名义≥18mm，实物另验。
H21 | 普通收豆杯 | PP杯/盒，约100×100×80mm | 固定底板上，覆盖出口下方；不装传感器 | 1 | 件 | 复用优先，实物核对 | B12 | 底Z26；不是称台，不显示质量。所有正常/疑似/拒判进入同一杯。
H22 | PWM缓冲板 | SN74AHCT125N（DIP14）＋2N3904，洞洞板30×50mm | 代焊一块3.3→5V单向缓冲，默认/OE拉高禁能 | 1 | 件 | 复用优先，实物核对 |  | 器件H23–H27为本板构成，不另买两套整板；完整引脚见接线页。避免用74HC125替代AHCT/HCT阈值。
H23 | 缓冲IC与插座 | TI SN74AHCT125N + DIP14插座 | VCC5V，TTL输入，使用通道1；闲置输入接地、/OE拉高 | 1 | 件 | 复用优先，实物核对 |  | H22构成件；5V不能反接BOX GPIO。
H24 | 使能三极管 | 2N3904 NPN TO-92 | E→GND，C→/OE1，B经4.7k到GPIO22 | 1 | 件 | 复用优先，实物核对 |  | H22构成件，按所购厂家引脚图确认E/B/C。
H25 | 电阻包 | 金属膜1% 0.25W | 10k×2，4.7k×1，100k×1，1k×3，220Ω×1；各备1 | 1 | 包 | 复用优先，实物核对 |  | 10k：/OE上拉5V、PWM输入下拉；1k：PWM输入串联及2限位串联；100k基极下拉。
H26 | 去耦与近端电容 | 100nF/50V X7R×1；1000µF/16V 105℃低ESR×1 | 100nF紧贴IC14/7；1000µF并舵机6V/GND | 1 | 包 | 复用优先，实物核对 | C01 | 核极性；不以电容替代足够的降压和线径。
H27 | 信号接线辅料 | 30×50洞洞板、端子、2.54插座、热缩/绝缘柱 | 缓冲板与J10短线，标注GPIO编号及针脚号 | 1 | 包 | 复用优先，实物核对 |  | J10只12个GPIO，没有地或电源；GND从原理图J6（PH2.0口1）的2脚GND引出，以实物1脚方向核针序；J6的1脚5V及3/4脚不接。
H28 | 配电/保险/开关包 | 绝缘低压分线端子；DC保险座；舵机支路电源开关 | 主4A、灯1A、5V输入1.5A、UBEC输入3A；6V开关DC≥12V/5A | 1 | 包 | 复用优先，实物核对 | P01–P14 | 保险位在24V正输入；手动6V开关用于装配/排障，不称自动硬件急停。盒保留机外，不接裸交流。
H29 | 电源线/接口 | 0.75mm²多股铜线、压接端子、5V USB-A→C成品短线 | 24V/6V电流不走杜邦；DC母座按YU2405实物匹配 | 1 | 包 | 复用优先，实物核对 | P03 / P09 / P14 | 5V接BOX Type-C1；USB调试时禁止另一路5V反灌/并联。信号地与UBEC参考地相连，舵机返回独立走线。
H30 | 小件紧固包 | 304 M3×8/12/16、M2×6/8、垫片、防松螺母 | M3各10套，M2各10套，尼龙隔柱按实物高度选；20mm魔术贴0.5m与M3/φ4适配套1只 | 1 | 包 | 复用优先，实物核对 |  | 先用纸样试孔；螺纹不得进入相机/舵机壳过深；舵机中心螺钉单独用原配。
