koffja/Beanlens/docs/hardware/hackathon-h2/bom-h2.csv

id | name | model | spec | qty | unit | status | notes | unit_price_cny
H01 | 识别/显示/控制板 | 正点原子 K230D BOX | 含内置2.4屏/用户按键，64.3×47.6×15.4外壳参考；TF按原套件 | 1 | 件 | 复用优先，实物核对 | Type-C1供5V；Type-C2不供电，不拆原壳。已有套件257报价不重计。
H02 | 上下两只相机 | GC2093-M12-90度无畸变（用户型号） | 两只同批GC2093完整模组＋各自兼容CSI排线；独立调焦 | 2 | 件 | 复用优先，实物核对 | 优先复用原双摄套件。BOX两CSI口分别接，物理口与Sensor(id)映射须实测；静止状态先A后B，两个视角共享一颗豆的cycle_id。
H03 | 舵机 | MG996R 位置版 | 1只，独立6V；外形40.7×19.7×42.9参考，轴竖直 | 1 | 件 | 复用优先，实物核对 | 非连续旋转版。输出轴只带轻挡片；不承人工按压力。
H04 | 主电源 | YU2405（用户指定） | 机外24V/5A/120W；实际厂牌/插头/极性/AC线另核 | 1 | 件 | 复用优先，实物核对
H05 | 逻辑降压 | TPS5450成品板候选，整板SKU未定 | 24V→5.00V；H1只给BOX和缓冲板，3A连续预算待验 | 1 | 件 | 复用优先，实物核对 | 不是裸DDA芯片；先空载量5V再接BOX，不选未证实供电板。
H06 | 舵机降压 | HOBBYWING UBEC5A / 30607000 / 2–8S | 设6.0V；原厂5A持续，本机3A持续/5A短峰预算 | 1 | 件 | 复用优先，实物核对 | 断电设跳帽，量6V后接舵机；不能给GPIO或主板。
H07 | 固定照明 | 复用原24V 6000K/Ra98灯带，完整SKU待核 | 上方2段＋下方2段，各100mm有效长，合计0.4m、≤8W预算 | 4 | 段 | 复用优先，实物核对 | 先核实际剪切点；上下独立摆角。下灯从木台开口内侧斜照，防止托条/板边遮挡，不以动画证明照明合格。
H08 | 灯铝槽 | U形铝槽，候选外14×8×100mm | 配实际灯带PCB宽；上下各两条，候选外14×8×100mm | 4 | 条 | 复用优先，实物核对
H09 | 开/关限位 | OMRON SS-01GL 微负载金合金触点 | 每端1只，COM/NO，低电平有效；19.8×6.4壳体/9.5孔距参考 | 2 | 件 | 复用优先，实物核对 | 限位检测挡片/支架旗片而非仅检测PWM命令；3.3V内部上拉条件实测接触可靠性。
H10 | 舵机专用安装件 | MG996R固定架＋6061铝板60×60×3；固定架/垫高待实配 | 竖轴目标X140/Y126/Z240，转接板向右让开玻璃托座 | 1 | 件 | 复用优先，实物核对 | 支架不是已放行成品图。铝板在PP底座上方叠放，外侧垫片找平；限位放舵机侧，避开两条拍摄轴线。
H11 | 舵臂 | MG996R匹配25T金属直臂，16mm孔半径 | 只用16mm孔；孔径优先M3，若现有goBILDAφ4加适配套 | 1 | 件 | 复用优先，实物核对 | 仍只用一只驱动舵臂；长度/长孔与上摄ROI手动核避让。中心螺钉用舵机原配；先试25T配合，不能硬拉花键。
H12 | 挡片/槽脚角铝加工套件 | 6061角铝20×20×2，宽12×1、宽15×2 | 宽12连接挡片；宽15两只向外伸出固定玻璃槽侧支承 | 1 | 套 | 复用优先，实物核对 | 侧支承脚位于PP底座开口内，必须用向外的角铝落到实体边框；螺栓中心参考X80/140，不可悬空。挡片角件防转孔位仍待实配。
H13 | PP停豆槽/挡片/旗片 | PP-H 3mm 板，候选300×300mm一片 | 开窗底座100×130、玻璃槽侧支承×2、承托条/压扣、短导豆口、后接豆斜槽；包含相机载板 | 1 | 片 | 复用优先，实物核对 | H32/H33为本板加工子件，不另买同样板材；按裁切表及样板排版。透明拍摄底为H31玻璃，禁止焊回不透明PP底。
H14 | 机架型材 | 已有黑色欧标2020，同槽型 | 460×4立柱、180×4宽梁、200×4深梁；共12段 | 12 | 段 | 复用优先，实物核对 | 4根460留整；另3根460各切200+180；1根400切200+180；剩1根400保留。无需新增型材。
H15 | 框架角码/M5/T螺母 | 欧标2020配套两孔90°角码，黑色优先 | 16角码使用+4备用；M5螺钉/T螺母各40只 | 20 | 套 | 复用优先，实物核对 | 含4套备用，长度按槽型配；不使用三通/四通方块。
H16 | 固定木平台 | 6mm海洋板，按已有余料裁 | 176×196×6共3片；工作板开70×110通孔，孔全局X75/Y55 | 3 | 片 | 复用优先，实物核对 | 其余两片尺寸保留；已有H1工作板可扩孔，先确认未削到安装点。孔相对板左前角53/33，不可沿用H1的50×45孔。
H17 | 平台支承角片 | 2020配套内角片＋M5/T螺母＋M3×16/φ9垫片螺母 | 3平台×4点=12用，16套购含4备 | 16 | 套 | 复用优先，实物核对 | 承托底面Z20/180/344；松装找平，不能用螺钉拉弯木片。
H18 | 相机可调安装 | 30×30×2角铝长40＋PP3 60×60载板＋M2隔柱 | 上相机1套，镜头目标X110/Y116.5/Z318.05，垂直向下 | 1 | 件 | 复用优先，实物核对 | 沿用上层支架实配。相机外形包络不是孔位；手转挡片和旗片，核ROI不被遮挡。
H19 | BOX固定框 | 复用80×64外压框/背托与软垫夹片 | 原壳整机固定在前框，保留KEY0/KEY1及TF/Type-C可达；配M5/T螺母4套与软垫夹片 | 1 | 件 | 复用优先，实物核对 | 不另买屏，不钻原壳；用一块176×112木余料或小PP承板，按原壳实配。
H20 | 局部遮光片 | 黑PP2，候选300×300mm | 侧/后可拆遮光片＋镜头周围背景片＋下相机防撞挡板60×55 | 3 | 片 | 复用优先，实物核对 | 取放口和两个镜头光路不能封住；下方防撞挡板位于Y145/Z110–165，名义距PCB边8.5mm，实际PCB/线缆尺寸变化要重核。
H21 | 普通收豆杯 | PP杯/盒，约100×100×80mm | 固定底板上，覆盖出口下方；不装传感器 | 1 | 件 | 复用优先，实物核对 | 原普通收豆杯复用；后斜槽出口Y165落入同一杯。下相机载板在杯口前半区上方，取杯前断6V，不得顶碰镜头。
H22 | PWM缓冲板 | SN74AHCT125N（DIP14）＋2N3904，洞洞板30×50mm | 代焊一块3.3→5V单向缓冲，默认/OE拉高禁能 | 1 | 件 | 复用优先，实物核对 | 器件H23–H27为本板构成，不另买两套整板；完整引脚见接线页。避免用74HC125替代AHCT/HCT阈值。
H23 | 缓冲IC与插座 | TI SN74AHCT125N + DIP14插座 | VCC5V，TTL输入，使用通道1；闲置输入接地、/OE拉高 | 1 | 件 | 复用优先，实物核对 | H22构成件；5V不能反接BOX GPIO。
H24 | 使能三极管 | 2N3904 NPN TO-92 | E→GND，C→/OE1，B经4.7k到GPIO22 | 1 | 件 | 复用优先，实物核对 | H22构成件，按所购厂家引脚图确认E/B/C。
H25 | 电阻包 | 金属膜1% 0.25W | 10k×2，4.7k×1，100k×1，1k×3，220Ω×1；各备1 | 1 | 包 | 复用优先，实物核对 | 10k：/OE上拉5V、PWM输入下拉；1k：PWM输入串联及2限位串联；100k基极下拉。
H26 | 去耦与近端电容 | 100nF/50V X7R×1；1000µF/16V 105℃低ESR×1 | 100nF紧贴IC14/7；1000µF并舵机6V/GND | 1 | 包 | 复用优先，实物核对 | 核极性；不以电容替代足够的降压和线径。
H27 | 信号接线辅料 | 30×50洞洞板、端子、2.54插座、热缩/绝缘柱 | 缓冲板与J10短线，标注GPIO编号及针脚号 | 1 | 包 | 复用优先，实物核对 | J10只12个GPIO，没有地或电源；GND从原理图J6（PH2.0口1）的2脚GND引出，以实物1脚方向核针序；J6的1脚5V及3/4脚不接。
H28 | 配电/保险/开关包 | 绝缘低压分线端子；DC保险座；舵机支路电源开关 | 主4A、灯1A、5V输入1.5A、UBEC输入3A；6V开关DC≥12V/5A | 1 | 包 | 复用优先，实物核对 | 保险位在24V正输入；手动6V开关用于装配/排障，不称自动硬件急停。盒保留机外，不接裸交流。
H29 | 电源线/接口 | 0.75mm²多股铜线、压接端子、5V USB-A→C成品短线 | 24V/6V电流不走杜邦；DC母座按YU2405实物匹配 | 1 | 包 | 复用优先，实物核对 | 5V接BOX Type-C1；USB调试时禁止另一路5V反灌/并联。信号地与UBEC参考地相连，舵机返回独立走线。
H30 | 小件紧固包 | 304 M3×8/12/16、M2×6/8、垫片、防松螺母 | 沿用M3/M2小件包；增加玻璃压扣用M2螺钉/垫片4套、下相机隔柱4套 | 1 | 包 | 复用优先，实物核对 | 玻璃夹持只防滑，不拧弯；豆路内无裸露螺纹。所需隔柱高度按相机和支架实物选；毛坯/孔位先纸样，非正式加工图。
H31 | 透明拍摄托片 | 7101普通无磨砂磨边载玻片（品牌/订单确认） | 指定25.4×76.2×1.0–1.2mm；模型1.1mm；不买盖玻片/磨砂/凹槽/粘附涂层 | 3 | 片 | 新增/改制，待实配 | 1用2备；店铺可能按50/72片一盒卖。不同7101存在25×75、26×76等规格，先量实物再定托座，不能只认7101号。不是承1kg料斗的底。
H32 | 玻璃托座与压扣加工 | H13的PP3子件＋H30的M2紧固件 | 内宽25.8起试；每侧3mm承托，中央约19.8mm通光；压扣4只 | 1 | 套 | 新增/改制，待实配 | 已计入H13板材/H30紧固件，不重复买板；上下两面均可擦拭，玻璃可从前端抽出，不粘死。厚度范围1.0–1.2，压扣高度按实物配。
H33 | 后接豆斜槽加工 | H13 PP3子件＋H20 PP2防撞挡板 | 内宽46，斜底33mm水平/54mm落差，面长63.29；两侧挡边18高 | 1 | 套 | 新增/改制，待实配 | 斜槽上沿Y132/Z197，出口Y165/Z143；防撞片Y145。与摄影托片分离，不把下相机包进封闭漏斗；内焊筋修平，手放实豆确认不反弹到镜头。
H34 | 下相机可调安装 | 30×30×2角铝长40＋PP3开框载板60×40＋M2隔柱 | 1套；镜头X110/Y116.5/Z138.05向上；载板候选Z111.5–114.5 | 1 | 套 | 新增/改制，待实配 | 新增第二套角铝/M2隔柱；PP板料在H13内。载板后缘Y136.5，防撞片Y145，名义8.5mm间隙须实配放大；不能靠CSI排线承重。
