koffja/Beanlens/docs/hardware/hackathon-h3/bom-h3.csv

id | name | model | spec | qty | unit | notes | status | full_bom | unit_price_cny
H01 | 识别/显示/控制板 | 正点原子 K230D BOX | 含内置2.4屏/用户按键，64.3×47.6×15.4外壳参考；TF按原套件 | 1 | 件 | Type-C1供5V；Type-C2不供电，不拆原壳。已有套件257报价不重计。 | 复用优先，实物核对 | A01
H02 | 水平相向双摄 | GC2093-M12-90度无畸变（用户型号） | GC2093-M12-90度无畸变，两只完整模组＋兼容BOX排线 | 2 | 件 | 前镜头(110,30,260)向后；后镜头(110,210,260)向前，各约90mm工作距起试。两CSI映射、近焦/像素密度与短曝光待实机核验。 | 复用优先，实物核对 | B01
H03 | 舵机 | MG996R 位置版 | 1只，独立6V；外形40.7×19.7×42.9参考，轴竖直 | 1 | 件 | 位置版，独立6V。机身固定，轴目标(170,180,331)；只推拉轻闸片，不能用标称扭矩证明不卡豆。 | 复用优先，实物核对 | A03
H04 | 主电源 | YU2405（用户指定） | 机外24V/5A/120W；实际厂牌/插头/极性/AC线另核 | 1 | 件 |  | 复用优先，实物核对 | A07
H05 | 逻辑降压 | TPS5450成品板候选，整板SKU未定 | 24V→5.00V成品板；BOX双摄＋缓冲，3A连续预算待验 | 1 | 件 | 不是裸DDA芯片；先空载量5V再接BOX，不选未证实供电板。 | 复用优先，实物核对 | A08
H06 | 舵机降压 | HOBBYWING UBEC5A / 30607000 / 2–8S | 设6.0V；原厂5A持续，本机3A持续/5A短峰预算 | 1 | 件 | 断电设跳帽，量6V后接舵机；不能给GPIO或主板。 | 复用优先，实物核对 | A17
H07 | 固定照明 | 复用原24V 6000K/Ra98灯带，完整SKU待核 | 4段各100mm有效长，合计0.4m；≤8W预算 | 4 | 段 | 两面各两条，侧向常亮；先核实际剪切点。100–200µs仅曝光试验起点，亮度是否够必须实拍。 | 复用优先，实物核对 | A05
H08 | 灯铝槽 | U形铝槽，候选外14×8×100mm | 配实际灯带PCB宽；候选外14×8×100mm，4条 | 4 | 条 |  | 复用优先，实物核对 | L02 / L03
H09 | 开/关限位 | OMRON SS-01GL 微负载金合金触点 | 每端1只，COM/NO，低电平有效；19.8×6.4壳体/9.5孔距参考 | 2 | 件 | 两只检测闸片尾部旗片，闭位/开位分别确认；装在豆路之外。座位、触发余量按实物调；不可只检测舵臂角度。 | 复用优先，实物核对 | S01
H10 | 舵机专用安装件 | MG996R金属固定架＋6061 60×60×3毛坯＋2020加强角码 | 右后立柱悬臂固定；角码候选40×40×4、宽20，两孔固定；轴(170,180,331) | 1 | 件 | 转接板目标Z280.2–283.2，固定架抬到安装耳约Z320。加强角码一侧用两颗M5/T螺母固定右后立柱，一侧托铝板；另配M3连接件。非最终钻孔图，先量舵机偏轴/支架。 | 复用优先，实物核对 | G14
H11 | 舵臂 | MG996R匹配25T金属直臂，16mm孔半径 | 只用16mm孔；孔径优先M3，若现有goBILDAφ4加适配套 | 1 | 件 | 只有一只25T直臂，使用R16孔接连杆球头；不是双舵臂。中心螺钉用舵机原配，孔径M3优先；几何角度不等于PWM标定。 | 复用优先，实物核对 | G01
H12 | 闸片球头垫高件 | M3×8六角隔柱＋M3球头螺柱/垫片 | 1套；使闸片球心与舵臂球心同高，名义Z337.5 | 1 | 套 | 8mm隔柱是候选，须扣除实际球头中心高度后配垫。球心共面后再连接，禁止靠拧紧掰弯连杆。球头本体计H37，不重复买。 | 复用优先，实物核对
H13 | 上下PP豆路与导向板材 | PP-H 2mm 300×300一片＋PP-H 3mm 300×300一片 | PP2做上斗/短管/下斗；PP3做顶环、导向盖、后支承片176×50、相机载板；导向条PP2+PET0.3 | 1 | 组 | H38/H39/H40为加工子件，PP板在本项统一购买。漏斗外侧焊、内部修平；导向区用螺栓拆装，不把铝闸片焊死。先纸样与试焊；斜面给毛坯而非已补偿焊接的CNC尺寸。 | 复用优先，实物核对
H14 | 机架型材 | 已有黑色欧标2020，同槽型 | 460×4立柱、180×4宽梁、200×4深梁；共12段 | 12 | 段 | 4根460留整；另3根460各切200+180；1根400切200+180；剩1根400保留。无需新增型材。 | 复用优先，实物核对 | F01
H15 | 框架角码/M5/T螺母 | 欧标2020配套两孔90°角码，黑色优先 | 16角码使用+4备用；M5螺钉/T螺母各40只 | 20 | 套 | 含4套备用，长度按槽型配；不使用三通/四通方块。 | 复用优先，实物核对 | F02
H16 | 木平台/相机横条/BOX面板 | 6mm海洋板，按已有余料裁 | 176×196×6两片；176×88×6一片；176×30×6两条 | 5 | 片 | 共5成品，由原3片176×196×6裁出；第三片切88+30+30，留锯缝余量。工作板60×60孔全局X80/Y90；不再装Z344整层相机板，以免挡豆路。 | 复用优先，实物核对 | F03
H17 | 平台支承角片 | 2020配套内角片＋M5/T螺母＋M3×16/φ9垫片螺母 | 底/工作板8点＋相机横条4点=12用，16套购含4备 | 16 | 套 | 底面Z20/180；相机横条Z234–240；BOX固定框H19另计。不可把屏面板装入漏斗内部。 | 复用优先，实物核对 | F11
H18 | 前相机可调安装 | 30×30×2角铝长40＋PP3 60×60载板＋M2隔柱 | 前镜头(110,30,260)，水平向后；1套 | 1 | 件 | 角铝/PP3载板/4只M2隔柱承重，固定到前木横条；不靠排线承重。实际孔距和镜头突出量收到后定。 | 复用优先，实物核对 | B13
H19 | BOX固定框 | 复用80×64外压框/背托与软垫夹片 | 原壳整机固定在前框，保留KEY0/KEY1及TF/Type-C可达；配M5/T螺母4套与软垫夹片 | 1 | 件 | BOX原壳固定前面176×88×6承板，Z334–422；背后与料斗外壁最小约60mm名义净空（不含线缆），按实物核接口与弯曲半径。 | 复用优先，实物核对 | F15
H20 | 局部遮光片 | 黑PP2板，候选300×200mm | 侧遮光片＋前/后带镜头孔背景片；黑PP2 300×300候选 | 3 | 片 | 不能保留H1封死后摄光路的整后片。镜头孔φ24起试，中心Z260/X110；侧片不可侵入拍摄窗，亮度/反光再实配。 | 复用优先，实物核对 | F07
H21 | 普通收豆杯 | PP杯/盒，约100×100×80mm | 固定底板上，覆盖出口下方；不装传感器 | 1 | 件 | 下斗直落同一普通杯，所有分类都进同一杯；无称重、无分选。杯位置可调，使中心落点(110,120)在杯内。 | 复用优先，实物核对 | B12
H22 | PWM缓冲板 | SN74AHCT125N（DIP14）＋2N3904，洞洞板30×50mm | 代焊一块3.3→5V单向缓冲，默认/OE拉高禁能 | 1 | 件 | 器件H23–H27为本板构成，不另买两套整板；完整引脚见接线页。避免用74HC125替代AHCT/HCT阈值。 | 复用优先，实物核对
H23 | 缓冲IC与插座 | TI SN74AHCT125N + DIP14插座 | VCC5V，TTL输入，使用通道1；闲置输入接地、/OE拉高 | 1 | 件 | H22构成件；5V不能反接BOX GPIO。 | 复用优先，实物核对
H24 | 使能三极管 | 2N3904 NPN TO-92 | E→GND，C→/OE1，B经4.7k到GPIO22 | 1 | 件 | H22构成件，按所购厂家引脚图确认E/B/C。 | 复用优先，实物核对
H25 | 电阻包 | 金属膜1% 0.25W | 10k×2，4.7k×1，100k×1，1k×3，220Ω×1；各备1 | 1 | 包 | 10k：/OE上拉5V、PWM输入下拉；1k：PWM输入串联及2限位串联；100k基极下拉。 | 复用优先，实物核对
H26 | 去耦与近端电容 | 100nF/50V X7R×1；1000µF/16V 105℃低ESR×1 | 100nF紧贴IC14/7；1000µF并舵机6V/GND | 1 | 包 | 核极性；不以电容替代足够的降压和线径。 | 复用优先，实物核对 | C01
H27 | 信号接线辅料 | 30×50洞洞板、端子、2.54插座、热缩/绝缘柱 | 缓冲板与J10短线，标注GPIO编号及针脚号 | 1 | 包 | J10只12个GPIO，没有地或电源；GND从原理图J6（PH2.0口1）的2脚GND引出，以实物1脚方向核针序；J6的1脚5V及3/4脚不接。 | 复用优先，实物核对
H28 | 配电/保险/开关包 | 绝缘低压分线端子；DC保险座；舵机支路电源开关 | 主4A、灯1A、5V输入1.5A、UBEC输入3A；6V开关DC≥12V/5A | 1 | 包 | 保险位在24V正输入；手动6V开关用于装配/排障，不称自动硬件急停。盒保留机外，不接裸交流。 | 复用优先，实物核对 | P01–P14
H29 | 电源线/接口 | 0.75mm²多股铜线、压接端子、5V USB-A→C成品短线 | 24V/6V电流不走杜邦；DC母座按YU2405实物匹配 | 1 | 包 | 5V接BOX Type-C1；USB调试时禁止另一路5V反灌/并联。信号地与UBEC参考地相连，舵机返回独立走线。 | 复用优先，实物核对 | P03 / P09 / P14
H30 | 小件紧固包 | 304 M3×8/12/16、M2×6/8、垫片、防松螺母 | M3×16盖板连接4套、M3连接/防松件；M2相机隔柱与螺钉各8套 | 1 | 包 | H37球头和H12隔柱不重复计。盖板螺栓在X90/130，Y105/165外侧，避开闸片轨道。螺钉长度按实际垫片/螺母复核。 | 复用优先，实物核对
H34 | 后相机可调安装 | 30×30×2角铝长40＋PP3 60×60载板＋M2隔柱 | 后镜头(110,210,260)，水平向前；1套 | 1 | 套 | 角铝/M2件增加第二套；PP3板料计H13。后横条承重，后摄与前摄独立调焦。 | 新增/改制，待实配
H36 | 单槽铝闸片 | 6061-T6 29.4×82×2mm | 两面平整、倒钝去毛刺；球头孔中心距前缘76mm，横向居中 | 1 | 片 | 先裁毛坯试配；M3孔径按连接件，正式孔待球头确认。关闭前缘Y108，打开前缘127.749，行程19.749。不要带豆强关。 | 新增/改制，待实配
H37 | 双球头短连杆 | RC模型M3球头连杆，球心距50mm，可调约±3mm | 1根杆＋2颗球头；M3连接螺柱/孔；要求卖家注明球心距 | 1 | 套 | 淘宝搜索：M3 球头连杆 球心距50mm。不是50mm裸螺杆；不接受球心距不明的套件。无已验证专属SKU，收到量中心距后重算端点。 | 新增/改制，待实配
H38 | 简易导向间隔条 | H13 PP2余料＋PET0.3mm垫片 | 10×85×2.3两条；PET可买20×100×0.3mm | 1 | 套 | PP2已计H13；仅新增PET片。上下PP3盖板50×85，槽高2.3容纳2mm闸片。PET不与PP焊，固定区螺栓夹紧。 | 新增/改制，待实配
H39 | 顶斗承重环/角片 | H13 PP3顶环＋25×25×2角铝宽20mm | 顶环176×196×3，开80×80口；顶环4只＋闸盒后支承2只使用，另2只备用 | 8 | 只角片 | PP顶环不重复购。8只角片配M5螺钉/T螺母16套、M3连接件8套（含备用），螺长实配；角片锁到顶部2020，再托住顶环；PP斗外缘焊到环口，载荷走顶环/角片/框架。仅单颗人工投豆，不宣称1kg验证。 | 新增/改制，待实配
H40 | 下接豆斗加工 | H13 PP2板材子件 | 内顶64×64/Z220；内底30×30/Z160；高60 | 1 | 套 | 不另买PP板；经工作台60×60孔穿过，用4只PP外焊小耳与M3固定。观察区下缘235距斗上口15mm，镜头中心260不被斗沿遮挡。 | 新增/改制，待实配
