koffja/Beanlens/docs/hardware/procurement-v4.11/beanlens-bom-v4.11.csv

编号 | 分组 | 物料 | 型号/材料 | 规格尺寸 | 数量 | 单位 | 方案 | 下单状态 | 人民币单价 | 报价依据 | 核对事项 | 资料来源
A01 | 板卡与相机 | 视觉主套件 | 正点原子 DNK230D / K230D BOX | BOX＋2.4英寸屏＋32GB TF；以257元订单包装为准 | 1 | 件 | 主方案 | 按订单核对 | 257 | 用户报价：整套257元 | 只买BOX套件；附送普通相机不抵扣另选双摄。 | https://wiki.alientek.com/docs/Boards/Kendryte/DNK230D/start-guide/k230d-box-introduction/
E01 | 板卡与相机 | 控制板（已有） | Waveshare ESP32-C6-LCD-1.47 非Touch | 已有1.47英寸LCD板，不能换成Touch/S3同名近似板 | 1 | 件 | 已有 | 复用，不重复购买 | 0 | 用户已有 |  | https://www.waveshare.com/wiki/ESP32-C6-LCD-1.47
E02 | 板卡与相机 | BOX屏幕与TF | 随A01套件 | 2.4英寸屏＋32GB TF，包含在A01中 | 1 | 件 | 套件包含 | 确认套件包装 | 0 | 计入A01，不代表已经收货 |  | https://wiki.alientek.com/docs/Boards/Kendryte/DNK230D/start-guide/k230d-box-introduction/
B01 | 板卡与相机 | 两只视觉相机 | GC2093-M12-90度无畸变（用户型号） | 同批两只，M12镜头；90°定义、IR-cut、近焦及CSI线序未核 | 1 | 两套合包 | 主方案 | 兼容确认后下单 | 114.32 | 用户报价：两套合计 | 两套合计114.32元；传感器+镜头描述不是完整PCB料号。先让卖家确认BOX双路同时工作及约75mm近焦。 | https://wiki.alientek.com/docs/Boards/Kendryte/DNK230D/start-guide/k230d-box-introduction/
B02 | 板卡与相机 | 双摄排线 | BOX专用CSI/MIPI排线（原厂配套） | 150–200mm仅询价起点；针数、间距、同/异面、线序按BOX与模组图 | 2 | 件 | 主方案 | 暂缓：线序/长度待核 |  | 待询价；不沿用旧打包额度 | 先纸样量实际路径；若B01含匹配线，取消本项，绝不凭通用15/22pin购买。 | https://wiki.alientek.com/docs/Boards/Kendryte/DNK230D/start-guide/k230d-box-introduction/
A03 | 滑闸标准件 | 位置舵机 | MG996R 角度/位置版 | 独立6.0V；原厂外形约40.7×19.7×42.9mm仅参照；兼容件实量 | 1 | 件 | 主方案 | 花键/电流待试装 | 15.58 | 用户报价 | 不要连续旋转版。25T舵臂必须和用户实物试装；禁止套原厂性能给廉价兼容件。 | https://towerpro.com.tw/product/mg996r/
PH01 | 光电与信号 | MVP红外对射（50cm） | DFRobot SEN0503，50cm IR Break Beam Sensor | DC3–5V，本机5.0V；50cm@5V/20cm@3.3V；响应约2ms；NPN常开；20×10×9mm，线250mm；收发一对 | 1 | 收发对 | 主方案 | 按SEN0503采购；到货测输出再接GPIO | 15 | DFRobot国内官方商城2026-10-17参考价15元/对；非用户成交价，运费另计 | 两头红5V/黑GND，接收白OUT；10k拟上拉3.3V，经1k到GPIO20。先不连GPIO测遮挡/无遮挡电压及极性；原厂未给内部上拉图，不套2167逻辑。只作经过提示。 | https://www.dfrobot.com.cn/goods-3274.html | https://www.dfrobot.com/product-2388.html | ../revision-v4.11/README.md
PH02 | 光电与信号 | 对射信号上拉 | 金属膜电阻10kΩ，1%，0.25W | 一只使用、一只备用；信号节点拉到C6 3.3V | 2 | 件 | 主方案 | 标准规格待报价 |  | 待询价；不沿用旧打包额度 | 拟用于SEN0503 NPN输出的3.3V上拉；先测是否内部上拉到5V。1k串阻不负责降压，高电平不合3.3V域先停接板。 | https://www.dfrobot.com.cn/goods-3274.html | https://www.dfrobot.com/product-2388.html | ../revision-v4.11/README.md
PH03 | 光电与信号 | GPIO串联电阻 | 金属膜电阻1kΩ，1%，0.25W | 信号至GPIO20串联；与PH02同一3.3V输入节点 | 2 | 件 | 主方案 | 标准规格待报价 |  | 待询价；不沿用旧打包额度 | 一只用一只备；不是把5V/24V信号降至3.3V的器件。先测接收输出，再接GPIO20。
PH04 | 光电与信号 | 红外可调安装耳 | 6061角铝30×20×2，切长30mm | 两头各1；按SEN0503实物孔位/光轴定孔；20×10×9外形参考，线250mm，带长孔与遮光 | 2 | 件 | 主方案 | 纸样后加工 |  | 待询价；不沿用旧打包额度 | 安装包络、朝向与原Z277光束位置均先试配；不能只改型号就宣称与侧封片/底座无干涉。 | https://www.dfrobot.com.cn/goods-3274.html | https://www.dfrobot.com/product-2388.html
I01 | 工业光电备选 | 原工业对射器 | 山大斯 B3F-20C1（用户提供，未核原厂资料） | 旧商品图6–36V/M12×1/约52.5mm仅待复核；收发一组的组成待核 | 1 | 组 | 备选 | 暂缓：确切接线资料缺失 |  | 待询价；不沿用旧打包额度 | 不擅改成E3F或推断NPN/PNP/激光/红外。若已购可保留，接口确认后再选转换方案。
I02 | 工业光电备选 | 24V NPN转换光耦 | LITEON LTV-817，DIP-4；分档按供货图 | 输入LED与24V限流电阻串联；输出集电极上拉3.3V、发射极接C6地 | 1 | 件 | 备选 | 暂缓：先确认NPN低端输出 |  | 待询价；不沿用旧打包额度 | 此为代焊小板用料，不是现成合格模块。PNP不能照接；漏电、动作逻辑、总延迟须台架测。 | https://optoelectronics.liteon.com/upload/download/ds-70-96-0016/ltv-8x7%20series%20201610%20.pdf
I03 | 工业光电备选 | 光耦输入限流 | 4.7kΩ 1% 0.5W电阻 | 24V下约4.8mA，电阻约0.11W；按真实传感器残压/漏电复核 | 1 | 件 | 备选 | 随I02接口复核 |  | 待询价；不沿用旧打包额度 | 仅24V已确认NPN低端输入设计；不能拿GPIO上拉电阻代替。
I04 | 工业光电备选 | 光耦LED反向保护 | 1N4148，DO-35 | 与光耦输入LED反并联 | 1 | 件 | 备选 | 随I02代焊 |  | 待询价；不沿用旧打包额度 | 极性和光耦引脚按所购器件数据表；输出上拉见I06、代焊绝缘安装见I07。
I05 | 工业光电备选 | 工业光电固定件 | M12×1螺母＋可调L形支架 | 收发各1支架、每头2螺母；不与PH04重复 | 2 | 套 | 备选 | 暂缓：安装尺寸待核 |  | 待询价；不沿用旧打包额度 | B3F-20C1标签、机身与出线尺寸核对后采购。
B03 | 称重 | 称重ADC模块 | SparkFun Qwiic Scale NAU7802，SEN-15242 | 3.3V模块；I²C地址0x2A；芯片24bit；拟定VDDA约3.0V/10SPS | 1 | 件 | 主方案 | 暂缓：需与称重桥配套 |  | 待询价；不沿用旧打包额度 | 不是把裸NAU7802芯片直接接线。若HJ-AZ4为数字输出，本项不买；若桥要求5V激励，需另审ADC参考/激励，不直接外接5V到此模块。 | https://www.sparkfun.com/sparkfun-qwiic-scale-nau7802.html
W01 | 称重 | 用户提供称重候选 | Autoda HJ-AZ4-3kg | 额定3kg；103元；输出、敏感元件料号、支架/平台包含范围均待核 | 1 | 件 | 备选 | 暂缓：接口/图纸待核 | 103 | 用户最新报价103元；替代旧55/105元记录 | 当前用户候选，不把3kg改称1kg。HJ-AZ4可能是组件/安装规格，需敏感元件铭牌；未查到可确认此SKU的原厂数据表，不能承诺±0.1g。 | https://www.autoda.com.cn/jishuzhich/
W02 | 称重 | 旧1kg外形参照（不默认购买） | Zemic L6J1-C2-1kg | 0.9±0.1mV/V；推荐5–10V；综合误差≤±0.028%FS | 1 | 件 | 备选 | 暂缓：激励与精度不匹配 |  | 待询价；不沿用旧打包额度 | 原3V/2mV/V示例不能套此型号；0.028%×1kg=0.28g，不能据此保证±0.1g。1kg毛载荷也不能收1kg豆+平台。 | https://www.zemiceurope.com/media/Documentation/L6J1_Datasheet.pdf
W03 | 称重 | 参考砝码100g | OIML R111 F1不锈钢，100g | 有修正值/可核查证书；参考质量扩展不确定度≤0.03g | 1 | 件 | 主方案 | 标准规格待报价 |  | 待询价；不沿用旧打包额度 | 等级标签不是校准证据；与500g分别询价。 | https://www.oiml.org/en/files/pdf_r/r111-1-e04.pdf
W04 | 称重 | 参考砝码500g | OIML R111 F1不锈钢，500g | 与W03同要求；带盒/镊子或手套 | 1 | 件 | 主方案 | 标准规格待报价 |  | 待询价；不沿用旧打包额度 | 检查点0/100/350/500g；350g由W03、W08、W09的校准质量组合，不用待测秤证明参考质量。 | https://www.oiml.org/en/files/pdf_r/r111-1-e04.pdf
W05 | 称重 | 轻称台板 | 6061-T6，170×180×2mm毛坯 | 约165.24g；载荷端连接孔按所选组件图 | 1 | 件 | 主方案 | 暂缓：称重组件定后加工 |  | 待询价；不沿用旧打包额度 | 盒+活动支承总目标≤250g；本板留下约84.8g给盒与活动连接件。若HJ套件含合适平台，本项取消。
W06 | 称重 | 称台刚性底板 | 6061，180×190×4mm毛坯 | 固定到2020底梁；固定端孔距按称重件图 | 1 | 件 | 主方案 | 暂缓：称重组件定后加工 |  | 待询价；不沿用旧打包额度 | 固定底板不计入秤的活动毛载荷；若套件包含合适底板，不重复购买。 V4.6先核底角码净空：四角约25×25mm为纸样核对区，紧凑角码完全在梁宽内可不切角；超出梁内缘再按固定孔决定避让，不是冻结缺口。不得顶住活动称台/传感器自由端。
W07 | 称重 | 安装垫块/过载限位 | M4×20调节螺钉4只＋M4螺母8只；硬质垫块按图 | 限位正常不接触活动称台；间隙依传感器额定位移 | 1 | 组 | 主方案 | 暂缓：所购组件图待核 |  | 待询价；不沿用旧打包额度 | 若103元套件已经含此结构则取消；旧另加50元差价作废，不推算103元包装内容。
A05 | 照明 | 同批固定色温灯带 | 用户普瑞Ra98灯带：完整SKU待提供 | 24V，6000K/Ra≥98询价目标；4×100mm有效段，总0.4m；≤20W/m预算 | 1 | 件 | 主方案 | 暂缓：功率/宽度/切点待核 |  | 待询价；不沿用旧打包额度 | 普瑞/Ra98不是完整型号；要每米功率、实际PCB宽、切点及短曝光实拍。不可擅换5000K并沿用原色温记录。
L02 | 照明 | 灯铝散热槽 | 6063 U型铝槽，4×100mm起点 | 内宽≥实测灯带宽；候选外宽14×高8mm，带扩散片 | 4 | 件 | 主方案 | 灯带尺寸定后切割 |  | 待询价；不沿用旧打包额度 | 100mm必须是灯带切点整数倍；如果需125mm段，先重算总长功率。扩散/遮光不能接触豆路。 V4.7灯槽X24/182候选，避开140宽槽盒/导轨底座，光向中心调整后复测。
L03 | 照明 | 遮光边与灯固定 | 0.5–1mm哑黑PP片＋M3夹持件 | 遮光条约100×15mm，4条纸样起点 | 1 | 组 | 主方案 | 按光路纸样加工 |  | 待询价；不沿用旧打包额度 | 防止LED直射镜头；不靠木板给灯散热，胶/夹具不进入豆路。
A07 | 电源与配电 | MVP外置主适配器 | YU2405（用户指定） | 24V DC / 5A / 120W额定；厂牌/批次、交流入口、外形、DC接头及极性待所购实物核对 | 1 | 件 | 主方案 | 按用户指定型号采购；到货核铭牌/极性并试载 |  | 待用户订单/询价；不沿用航嘉估价 | 型号不能证明同厂家或相同认证/保护。确认24V稳压输出，插头匹配后试载压降/温升；适配器保持外置，不拆壳接裸交流。 | ../revision-v4.11/README.md
P02 | 电源与配电 | 适配器交流线 | 与所购适配器AC入口匹配的中国插头成品线 | 3×0.75mm²起点（若三芯入口）；实际入口形式/额定按适配器标签，不假定C13 | 1 | 件 | 主方案 | 标准规格待报价 |  | 待询价；不沿用旧打包额度 | 适配器含线时不重复买；不在机器内接裸220V。
P03 | 电源与配电 | 24V输入插座/转接线 | 匹配订购适配器DC头的成品母座/转接线 | DC≥30V/5A，0.75mm²短线；5.5×2.5只作为候选，按实物确认 | 1 | 件 | 主方案 | 与A07接头配套 |  | 待询价；不沿用旧打包额度 | 按YU2405所购实物量外径/内径/极性再配座；5.5×2.5仅候选，不把其他卖家的同名型号当定型证明。
A08 | 电源与配电 | 5V降压整板：TPS5450优先候选 | TPS5450DDA方案成品板；完整厂家/SKU待提供 | 24V→5.00V；连续预算4A；36V推荐输入上限；整板尺寸/温升/接线资料待核 | 1 | 件 | 主方案 | 暂缓整板定型；先询价拿资料 |  | 新模块待报价，不沿用XL4016估价 | DDA是芯片封装号，不是淘宝模块SKU；核PowerPAD散热、二极管、电感、端子及24V工况。固定5V板不能当6V舵机电源。 | https://www.ti.com/lit/ds/symlink/tps5450.pdf | ../revision-v4.10/README.md
A17 | 电源与配电 | 舵机独立6V：UBEC5A（用户确认） | HOBBYWING好盈 UBEC 5A / 30607000 / 2–8S版 | 原厂持续5A；5.0/6.0/7.4V跳帽可设，本机只用6.0V；50×17×10mm，21g；24V输入需核所购2–8S型号 | 1 | 件 | 主方案 | 按完整型号询价；到货先设6V并实测 |  | UBEC整件待报价，不沿用XL4016估价 | 先断电按该原厂说明设置6V跳帽，再上电量输出；输出仅给舵机电源，不接GPIO。厂线/插头额定与负载压降另验。原15A瞬间标称不改变本机5A短峰预算。 | https://www.hobbywing.com/products/ubec-5a93 | https://oss.hobbywing.com/pdf/pdfcn/UBEC5Acn.pdf | ../revision-v4.10/README.md
P04 | 电源与配电 | 外部总电源开关 | 成品带开关插排（已有优先） | 接成品适配器交流线；机内只布低压 | 1 | 件 | 备选 | 标准规格待报价 |  | 待询价；不沿用旧打包额度 | 没有则购当地适用认证成品；不作硬件急停，不保证失电关闸。
P05 | 电源与配电 | 分线端子 | 德力西 TB-1506 / DHATB1506N | 73.5×22×17.5mm；15A；0.5–1.5mm²；M3；一条输入分配一条5V/6V输出 | 2 | 条 | 主方案 | 标准规格待报价 |  | 待询价；不沿用旧打包额度 | TB-A 1–3/4–6分别由P16桥接；TB-B不装桥。每格两端互通、相邻不通，禁止整条6位全部短接。 | https://www.delixi-electric.com/u/cms/delixi/201805/09095528ac23.pdf
P06 | 电源与配电 | DC保险与座 | MINI 32VDC保险：Littelfuse 297系列或规格可核等效件，配同尺寸座 | 主4A、灯2A、5V输入2A、6V输入3A各1；同规格各1备用，共4A×2 / 2A×4 / 3A×2，4个保险座 | 1 | 4座+8保险 | 主方案 | 标准规格待报价 |  | 待询价；不沿用旧打包额度 | 297系列0297004._/0297002._/0297003._分别对应4/2/3A；灯支路由1A改常见2A。保险保护0.75mm²线路，浪涌/温升仍验。 | https://www.littelfuse.com/assetdocs/littelfuse_datasheet_297_mini32v.pdf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
P07 | 电源与配电 | 电源铜线 | 多股铜0.75mm²，红/黑 | 红3m＋黑3m起点；24V主回路和6V舵机回路 | 1 | 6m | 主方案 | 标准规格待报价 |  | 待询价；不沿用旧打包额度 | 按实际裁切、留压接余量；不以杜邦信号线承载舵机电流。
P08 | 电源与配电 | 压接/绝缘固定小件 | 0.75mm²管形端头＋热缩管＋扎带/固定座 | 0.75mm²管形端头20只；φ3/φ6热缩各1m；扎带20只起点；TB叉形端子另P17 | 1 | 组 | 主方案 | 标准规格待报价 |  | 待询价；不沿用旧打包额度 | 按所购降压板端子规格用管形端头，TB螺钉用P17，不堆多根裸绞线。
C01 | 电源与配电 | 6V近端电容 | 铝电解1000µF/16V，105℃低ESR | 径向，优先直径≤10mm、高≤20mm；实际按供货图 | 1 | 件 | 主方案 | 标准规格待报价 |  | 待询价；不沿用旧打包额度 | 并在6V/GND，极性正确；电容和降压启动稳定性需配套测试。
C02 | 电源与配电 | 5V近端电容 | 铝电解470µF/10V，105℃低ESR | 实际封装/脚距按供货图；并在5V/GND | 1 | 件 | 主方案 | 标准规格待报价 |  | 待询价；不沿用旧打包额度 | 电容不补足电源容量，不接24V侧。
C03 | 电源与配电 | 去耦电容 | 100nF，X7R，≥50V，直插或带板焊接 | 10只小包；6V/5V近端、红外、可选缓冲按布局分配 | 10 | 件 | 主方案 | 标准规格待报价 |  | 待询价；不沿用旧打包额度 | 数量是整机公用库存，其他模块不要再重复按包计价。
P09 | 电源与配电 | USB供电转接 | 双USB-A母口被动5V配电板，带独立辅助5V/GND焊盘或端子 | 输入5V，总承载≥4A；两个USB口各满足板卡；辅助口供SEN0503及小电容 | 1 | 件 | 主方案 | 暂缓：具体板/走线载流需核 |  | 待询价；不沿用旧打包额度 | 不是PD诱骗模块；检查铜箔、焊点、压降。辅助焊盘做可靠绝缘端接，不叠压多根线。
P10 | 电源与配电 | 两板USB电源线 | USB-A→USB-C成品短线 | 约0.3m、每线≥3A标称，实测压降；BOX与C6各1根 | 2 | 件 | 主方案 | 标准规格待报价 |  | 待询价；不沿用旧打包额度 | 电脑调试时避免双电源反灌，保留原厂规定的供电口。
F01 | 机架与外壳 | 黑色欧标2020型材：连续立柱V4.6 | 黑色阳极氧化欧标2020，与已有型材同截面/槽型/壁厚 | 黑色欧标2020：最终460×4、200×6、180×8mm，18根净4.48m；已有黑色460×7/400×2，补购同规格黑色净长180×4 | 1 | 18段 | 主方案 | 量现有净长/槽型后配套下单 |  | 待询价；不沿用旧打包额度 | 按frame-v4.6切料：460×4留整，460×3各切200+200，400×2各切180+180；每刀3mm时共锯屑30、余料230mm。只补180×4成品；或750原料切4×180二选一。旧440高切单废止，不混用。 用户已确认现有型材为黑色欧标2020；不要补银色或其他槽系。
F02 | 机架与外壳 | 型材连接件 | 欧标2020配套两孔90°带筋角码（黑色优先）＋配套M5螺钉/T螺母 | 28角码使用＋4备用＝32套；每套螺钉2/T螺母2，各64只；螺钉M5，长度按配套图 | 1 | 组 | 主方案 | 先核槽口与角码实物图 |  | 待询价；不沿用旧打包额度 | 上下框16、中框8、相机梁4；内侧装，不需要三通/四通方块。配用户已有黑色欧标2020；槽宽/定位凸起实量，优先原卖家配成套。不要按此前item槽5参照盲买；M5长度按角码厚度/槽深确定。F08穿板件另列。 V4.7中框前后180梁改在外侧柱面Y0/220，按钮移到Z273；角码数量仍28用32购。
F03 | 机架与外壳 | 三面内嵌木外壳（取消料斗木壳） | 6mm海洋板600×600mm | 仅9块P01–P09外壳；176×112×2、196×112×2、196×280×2、176×197×1、176×58×2；木斗及木托耳全部取消 | 1 | 件 | 主方案 | 暂缓：最终开孔未冻结 |  | 待询价；不沿用旧打包额度 | V4.8仅外壳装饰/检修；一张600方按3mm间隔排9块。已有800板可裁，不重复采购。
F04 | 机架与外壳 | 连续四片PP料斗 | 食品接触资料可核PP-H 2mm A3两张（含练习/可选盖） | 内顶136×136/Z440→底82×12/Z298.3，高141.7；外顶140.072×140.366/外底86.072×16.366；4片外面尺寸见V4.9 CSV；前后面各增5个11×4圆角出毛槽，中心Z310；先按样刷修孔 | 2 | 张 | 主方案 | 纸样后裁切 |  | 待询价；不沿用旧打包额度 | 原四片主斗外形保留；在闸片上方加B16分道片与B11刷盒。无刷毛时焊接，冷却后装刷，维持前/侧连续封闭。 | ../revision-v4.10/README.md | ../revision-v4.9/pp-panel-cuts-v4.9.csv
F05 | 机架与外壳 | 顶承托法兰与C6后框PP板料 | 可焊PP-H3mm，250×250一张 | PP3 250方：顶法兰176×196开136方、C6后框56×38开26×10、B16四片分道、B14两根110×10载条/小垫块用余料 | 1 | 张 | 主方案 | 暂缓：新槽盒开缝定后加工 |  | 待询价；不沿用旧打包额度 | 先排版再切，留锯缝。B16/B14只计加工/小件，不重复买整张PP板。 | ../revision-v4.9/README.md
F06 | 机架与外壳 | 屏与板卡托架 | 6061板，200×200×2mm毛坯＋尼龙柱/外侧夹持件 | 200×200×2铝板：后电控160×130、BOX承托框80×64各一，留3mm锯缝；C6后框改F05余料PP3，不用铝框 | 1 | 两套 | 主方案 | 暂缓：实物孔位待核 |  | 待询价；不沿用旧打包额度 | 必须开框/避口，不装实心板遮接口或天线。承托框用F15/F16固定；屏幕已随板卡，不另买两块LCD。后电控模块朝后厚度目标≤21，型号实物外形待核。
F07 | 机架与外壳 | 遮光隔舱/快拆件 | 哑黑PP1mm 300×300mm＋M3手拧螺钉/嵌件 | PP1mm 300×300一张：遮光底板180×200开130×50；余料做BOX背光罩，M3手拧4只及螺母4只；余料切前遮光条176×22×1，位置Z197→219，支点2另计F11 | 1 | 组 | 主方案 | 纸样后加工 |  | 待询价；不沿用旧打包额度 | 遮光底板与条仍按原尺寸；BOX背罩必须避散热和全部接口，按D90服务腔做可拆罩，不封死。
B11 | 机架与外壳 | 五槽前后轻刷成品段（需要定制/样段） | PBT毛径0.10–0.15mm；厂家植毛PP基条12×6×3 | 10段（每槽前后各1）；有效毛簇宽10，自由毛长14；向下30°初试；毛尖Z308 | 10 | 段 | 主方案 | 先拿样刷核植毛与封端，再定孔 |  | 定制/样段待报价 | 刷毛在闸片上方槽入口，非10mm下座里。侵入每侧1.5起试，前后可调；不使用散毛热熔胶粘，不保证逐豆。 | ../revision-v4.10/README.md
B12 | 称重 | 收豆盒 | 食品接触PP，外尺寸≤160×170×130mm | 实际容量≥500g样本；轻量化，当前活动总重预算≤250g | 1 | 件 | 主方案 | 实测容积/质量后下单 |  | 待询价；不沿用旧打包额度 | 1kg整批收集必须另核容积和称台毛载荷；不把外形尺寸直接等于豆子容量。 V4.7盒向前移5mm至Y30，后留约7mm固定托板间隙，仍只压称台。
A14 | 板卡与相机 | 颜色/背景参考块 | 哑光中性灰，约30×30×1mm可换片 | 放在豆路两侧；配批次记录、光照重复性 | 1 | 件 | 主方案 | 标准规格待报价 |  | 待询价；不沿用旧打包额度 | 只是重复性参照，不代替专业色卡校准；不放整块板挡落豆。
B13 | 板卡与相机 | 相机独立支架 | 6061角铝30×30×2，切长40mm；载板2mm | 两套；每套30×30×2长40角铝＋40×40×2载板毛坯；配M5 T螺母2/螺钉2，尼龙柱按PCB孔 | 2 | 套 | 主方案 | 暂缓：相机PCB孔位待核 |  | 待询价；不沿用旧打包额度 | 载板毛坯40×40mm仅起点；相机固定在独立型材梁，不由排线承重。
A16 | 控制与接线 | 开始与停止按钮 | φ16mm无灯金属，自复位，1NO1NC | 两只；开始接NO、停止接NC；需低电平微负载触点 | 2 | 件 | 主方案 | 触点/夹紧范围核对后采购 |  | 待询价；不沿用旧打包额度 | 需适配6mm面板或加薄衬板；未核具体厂家SKU，不买带灯锁定按钮。此为软件停止输入。
S01 | 控制与接线 | 开/关滑架限位 | OMRON SS-01GL 微负载金合金触点 | 每端1只；19.8×约6.4mm壳体、孔距9.5mm参照；端子COM/NO | 2 | 件 | 主方案 | 安装/微负载验证后采购 |  | 待询价；不沿用旧打包额度 | 不能用SS-5银触点的5A额定代替微负载要求。3.3V下动作可靠性须实测；装在滑架而非舵盘上。 | https://omronfs.omron.com/en_US/ecb/products/pdf/en-ss.pdf
S02 | 控制与接线 | 限位/按键外上拉 | 2.2kΩ金属膜，1%，0.25W | GPIO0/1/3/23各1只，另2只备用；上拉3.3V | 6 | 件 | 主方案 | 标准规格待报价 |  | 待询价；不沿用旧打包额度 | 闭合电流约1.5mA；不自动宣称满足所有开关微负载规格，按所购触点资料与实测核验。
S03 | 控制与接线 | BOX UART转接线 | 匹配BOX PH2.0接口1的插壳/端子线 | 按原厂针数/顺序配；只连接TX、RX、GND，5V端独立绝缘 | 1 | 件 | 主方案 | 暂缓：原厂接口方向待核 |  | 待询价；不沿用旧打包额度 | PH2.0只表示间距系列；不能凭4针同外形认定线序。目标约200mm，实际走线定长。 | https://wiki.alientek.com/docs/Boards/Kendryte/DNK230D/start-guide/k230d-box-introduction/
S04 | 控制与接线 | 控制信号线与端接 | 多股铜0.14mm²（约AWG26）信号线 | 约2m总用量＋匹配2.54排针/插壳/热缩；短UART和开关信号 | 1 | 组 | 主方案 | 标准规格待报价 |  | 待询价；不沿用旧打包额度 | 只用于信号；称重桥线按厂商屏蔽双绞要求，舵机大电流另走0.75mm²。
O01 | 控制与接线 | 可选PWM单向缓冲 | TI SN74AHCT1G125DBVR＋SOT23-5转接板 | 5V VCC；/OE接GND，输入GPIO2，输出仅给舵机；旁路100nF取C03 | 1 | 件 | 备选 | 3.3V PWM不可靠才装 |  | 待询价；不沿用旧打包额度 | 输入加10k下拉、输出串100Ω各1；绝不6V供电，绝不把5V输出回接C6。请代焊不手悬裸芯片。 | https://www.ti.com/product/SN74AHCT1G125
O04 | 控制与接线 | 可选独立3.3V模块 | Pololu D24V5F3，#2842，候选 | 24V→3.3V，典型500mA等级；按噪声/热需求核 | 1 | 件 | 备选 | 余量/称重噪声不足再设计 |  | 待询价；不沿用旧打包额度 | 不能与C6板载3.3V直接并联；须重审I²C供电先后和上拉，不默认购买。 | https://www.pololu.com/product/2842
G01 | 滑闸标准件 | 25T金属舵臂 | goBILDA 1900-0025-0104 | H25T；厚4mm、φ4孔；8/16/24/32mm孔半径，使用16mm | 1 | 件 | 主方案 | 花键试装后下单 |  | 待询价；不沿用旧打包额度 | 32mm是商品长度级别，不能当本设计力臂。仅匹配实物25T；中心螺钉用舵机匹配件。 | https://www.gobilda.com/1900-series-single-servo-arm-25-tooth-spline-32mm-length/
G02 | 滑闸标准件 | 双球头杆端 | goBILDA 2913-0004-0241 | M4×0.7内螺纹、球孔φ4；h约24.4mm、总长31.3mm、螺纹深13mm按图 | 2 | 件 | 主方案 | 标准规格待报价 |  | 待询价；不沿用旧打包额度 | 两只=原厂1个2-pack，不重复买2包；网页标题24.1与图24.4不同，收到后量h。 | https://www.gobilda.com/2913-series-steel-ball-linkage-female-m4-x-0-7mm-24-1mm-length-2-pack/
G03 | 滑闸标准件 | 连杆中间牙条 | goBILDA 2808-0004-0030 / 等效不锈钢 | M4×0.7、30mm长；与2球头组成约60mm球心距 | 1 | 件 | 主方案 | 标准规格待报价 |  | 待询价；不沿用旧打包额度 | 一根使用，原厂2-pack另一根备用；不是60mm牙条。两端右牙，调长需拆一头。 | https://www.gobilda.com/2808-series-stainless-steel-threaded-rod-m4-x-0-7mm-30mm-length-2-pack/
G04 | 滑闸标准件 | 杆端并紧螺母 | ISO 4032 / GB6170 M4×0.7 | 两只用、两只备用，普通六角并紧螺母 | 4 | 件 | 主方案 | 标准规格待报价 |  | 待询价；不沿用旧打包额度 | 裸露牙条11.2mm须装下两只螺母；不可把厚尼龙锁紧螺母当同尺寸。
G05 | 滑闸标准件 | 球头轴与防松件 | φ4光杆/肩轴段＋M4螺纹；M4防松螺母 | 两组；轴向堆叠=舵臂/耳板+球内圈+隔套+螺母；长度按实物 | 2 | 组 | 主方案 | 暂缓：球内圈/堆叠待量 |  | 待询价；不沿用旧打包额度 | 夹持球内圈，不压外壳；不能直接指定M4×16而未知内圈宽度。带小径隔套，球头全角度不干涉。
G06 | 滑闸标准件 | 左右直线导向 | MGN9导轨100mm＋MGN9H长滑块 | 两轨各1块；HIWIN参考块高10、宽20、长39.9mm；孔距15×16mm参考 | 2 | 轨块套 | 主方案 | 供货图/纸样核对后采购 |  | 待询价；不沿用旧打包额度 | 兼容件不继承原厂额定值；每套明确含轨和H块，不再重复列买2只滑块。两轨平行不强行夹紧。 | https://www.hiwin.com/wp-content/uploads/Linear_Guideway-E-1.pdf
G07 | 滑闸加工件 | 全宽铝闸片 | GATE-PLATE-01 / 6061-T6 | 110×45×2mm毛坯；直线钝前缘、去毛刺、平整 | 1 | 件 | 主方案 | 先纸样，后加工 |  | 待询价；不沿用旧打包额度 | 封口边/螺孔由新槽盒定；不是0.8mm薄POM。载荷模型尚不覆盖局部接触/安装翘曲。
G08 | 滑闸加工件 | 滑架转接板（本次补漏） | GATE-CARRIAGE-01 / 6061-T6 | 120×30×3mm毛坯；桥接左右MGN9H；轨中心距94mm布局提案（原约90起点） | 1 | 件 | 主方案 | 暂缓：收到导轨后开孔 |  | 待询价；不沿用旧打包额度 | 覆盖前后16mm孔距；10mm角铝脚宽不足以代替此板。参考四孔位置每块±7.5、±8mm；最终按供货图。
G09 | 滑闸加工件 | 横梁加强/连接角铝 | 6061/6063，10×10×2mm，长110mm | 装在转接板/闸片后部、豆路外，至少两处间隔连接 | 1 | 件 | 主方案 | 纸样后加工 |  | 待询价；不沿用旧打包额度 | 保留为加强与闸片连接件，不直接把两滑块只锁在10mm角铝脚上。
G10 | 滑闸加工件 | 中心连接耳 | GATE-EAR-01 / 6061，30×20×3mm毛坯 | 中心孔φ4.2mm起点；高度/折弯连接按舵臂平面设计 | 1 | 件 | 主方案 | 暂缓：共面高度待纸样 |  | 待询价；不沿用旧打包额度 | 宽度中心居中；不沿用z315−z292=23mm直接钻孔。耳板/隔套必须避开连杆摆角。
G11 | 滑闸加工件 | 共同导轨底座 | GATE-BASE-01 / 6061，140×140×4mm毛坯 | 两轨在同一平面；近槽盒侧裁切/开缺口，不能遮挡落豆通口 | 1 | 件 | 主方案 | 暂缓：布置/视锥待纸样 |  | 待询价；不沿用旧打包额度 | assembly第04图给前豆路/后舵机避空方向；140×140是毛坯，最终缺口/螺孔须纸样。实际轨块总高、100轨端余量和视锥未验。
G12 | 滑闸加工件 | PP一体固定槽体下座 | 食品接触资料可核PP-H10mm，140×24×10 CNC | 5孔14×12，肋3；局部孔Y9，全局Y114；固定件X40/Y105/Z280；顶Z290/后端Y129 | 1 | 件 | 主方案 | 暂缓：槽盒纸样后开口 |  | 待询价；不沿用旧打包额度 | 与PP上座/前壁/侧壁焊成固定U槽体；PP摩擦/焊后平整须试验，不套用POM性能。10mm只是短出豆孔段，不装刷条。 | ../revision-v4.10/README.md
G13 | 滑闸加工件 | 连续前壁PP固定槽体配置（板料分列） | PP6 F18上座 + PP10 G12下座 + F19前侧封壁 + G21隔距 | 前壁连续，仅从后方插G07；2.3闸缝、2mm片、15行程；闭合前缘Y112.5藏入前承接位1.5 | 1 | 组 | 套件包含 | 暂缓：必须纸样定型 | 0 | 板料/加工费用在F18和G12单列，不代表已购 | 固定PP件焊，铝闸片不焊；后方可退出清理盲承接位，后退片罩G20仍需全行程试配。 | ../revision-v4.10/README.md
G14 | 滑闸加工件 | 舵机固定支架 | MG996R专用金属支架＋6061 3mm转接毛坯 | 毛坯约60×60×3mm；轴竖直，连杆与滑架连接点共面起点 | 1 | 件 | 主方案 | 暂缓：机身/高度待试装 |  | 待询价；不沿用旧打包额度 | 支架与底座同一刚性机架；壳体/扫掠避后摄视锥，不将旧轴高当冻结孔位。
G15 | 滑闸标准件 | 滑块连接螺钉 | M3×6内六角＋必要薄垫片 | 8只使用、2只备用；配3mm转接板 | 10 | 件 | 主方案 | 实际螺纹深度核对 |  | 待询价；不沿用旧打包额度 | 先量块的有效螺纹深与板/垫片堆叠，既不顶底也不啮合不足；不按所有MGN9H兼容块同深度购买。
G16 | 滑闸标准件 | 导轨底座连接螺钉 | M3×8内六角＋M3螺母/底座螺纹 | 每轨按实际孔数，预留12只 | 12 | 件 | 主方案 | 导轨孔/底座堆叠核对 |  | 待询价；不沿用旧打包额度 | 基座仅4mm厚，通孔+螺母或螺纹方案需先定；不得让下露螺杆顶框架。
G17 | 滑闸标准件 | 闸片/横梁连接件 | M3×10沉头＋M3螺母/压条 | 6只使用、2只备用；每连接层实量 | 8 | 件 | 主方案 | 纸样与板厚核对 |  | 待询价；不沿用旧打包额度 | 2mm闸片不靠单孔受拉；豆路表面保持平顺，不留凸出螺帽。可把孔放后方完全避豆路。
G18 | 滑闸加工件 | 限位安装耳与保护挡块 | 6061/POM毛坯，约20×15×3mm各件 | 两限位耳、两保护挡块；M2安装件按SS-01GL图 | 1 | 组 | 主方案 | 端点标定后定位 |  | 待询价；不沿用旧打包额度 | 正常端点先触限位，机械挡块留在正常行程外；不能让舵机正常关闸时顶死。
G19 | 滑闸加工件 | 手动止料片 | 食品接触PP/POM，110×40×1mm毛坯 | 独立可插入止料位置；片外保留手持区 | 1 | 件 | 主方案 | 槽盒纸样后制作 |  | 待询价；不沿用旧打包额度 | 不作为自动急停或失电自闭。与运行中闸片不能干涉，取盒前先停料排空。
G20 | 滑闸加工件 | 润滑区与豆路隔板 | PP1mm毛坯140×110mm＋M3可拆固定 | 隔开轨块润滑、连杆与豆路；留检修清洁通道 | 1 | 件 | 主方案 | 纸样后裁切 |  | 待询价；不沿用旧打包额度 | 薄片仅隔尘，不承担1kg豆重；不能在落豆口横跨挡豆。
I06 | 工业光电备选 | 光耦输出上拉 | 4.7kΩ 1% 1/4W电阻 | 集电极至C6 3.3V；与24V输入限流I03不同 | 1 | 件 | 备选 | 随I02接口复核 |  | 待询价；不沿用旧打包额度 | 仅确认NPN后使用，输出不接24V或5V。
I07 | 工业光电备选 | 光耦代焊与绝缘安装 | FR-4小板约30×20mm＋接线端子＋绝缘盒 | 输入/输出分区标识，禁止裸焊悬空 | 1 | 组 | 备选 | 随I02代焊 |  | 待询价；不沿用旧打包额度 | 报价含代焊和两侧端子；电路通断/极性/输出电压先台架核验。
W08 | 称重 | 350g检查用组合砝码之一 | OIML R111 F1不锈钢，200g | 有修正值与可核查证书；和100g、50g组合参考 | 1 | 件 | 主方案 | 标准规格待报价 |  | 待询价；不沿用旧打包额度 | 三件实际修正质量相加，组合参考扩展不确定度≤0.03g；须考虑相关性，不能只复制单件证书数值。 | https://www.oiml.org/en/files/pdf_r/r111-1-e04.pdf
W09 | 称重 | 350g检查用组合砝码之二 | OIML R111 F1不锈钢，50g | 与W03 100g、W08 200g组成约350g独立检查点 | 1 | 件 | 主方案 | 标准规格待报价 |  | 待询价；不沿用旧打包额度 | 不依赖待测秤确定砝码质量；校准点与独立检查点分开使用。 | https://www.oiml.org/en/files/pdf_r/r111-1-e04.pdf
F08 | 外壳固定 | 历史木斗壳/托耳固定件（V4.8取消） | M5×12/T螺母/垫片各4；小角片10；M3×12及螺母/垫片各28 | 托耳2点＋2备；木壳8小角片＋托耳2小角片；外面板固定独立移到F11 | 0 | 组 | 历史不采购 | 取消：不下单 |  | 新增材料待询价 | 保留编号供旧图追溯；木斗H01–H06取消，不与新F13重复购买。
F09 | 机架与外壳 | 上端防尘端盖 | 匹配已有黑色欧标2020端部的黑色塑料端盖 | 20×20型材用，4只；非承重连接件 | 4 | 只 | 主方案 | 核实2020端部后下单 |  | 新增待询价 | 按实物中心孔/槽型试配；端盖不承担框架连接。
F10 | 机架与外壳 | 底部防滑脚套 | 黑色欧标2020端部外套式橡胶脚套 | 内腔匹配20×20端部，厚底≥3mm，4只；实物尺寸/硬度待核 | 4 | 只 | 主方案 | 核实2020端部后下单 |  | 新增待询价 | 无螺纹的外套式方案，不用把M5硬拧入型材中心孔。要求四点稳定；非调平脚、非已验承载件。若换调平脚另核安装座/攻牙。
F11 | 外壳固定 | 内嵌木面板背托套件 | 20×20×2内角片＋配套M5/T螺母；M3×25黑沉头＋M3螺母/垫片＋隔距 | 购40套：木板32点、前黑PP条2点、6备；每套1角片/1M5/1T螺母/1M3螺栓螺母垫片/10mm尼龙隔套＋1mm调垫 | 1 | 组 | 主方案 | 先纸样/角样，后按实物下单 |  | V4.7新增待询价 | 角片内侧背托。示意11mm隔距使6mm板面内凹1；按实物角片量，不盲买固定11。先做角样，32点不是沿用旧16点外覆直接穿T槽。
F12 | 料斗制作 | PP热焊耗材 | 同牌号PP-H焊条Ø2/Ø3；焊枪匹配4–5mm细嘴；20×10×1.5角铝压片 | 同牌号相容PP-H焊条Ø2约5m、Ø3约2m练习；匹配热风枪4–5mm细嘴1（已有不买） | 1 | 组 | 主方案 | 先纸样/角样，后按实物下单 |  | V4.7新增待询价 | 原木壳口圈4角铝压片取消。试焊需根部熔合，主要在外侧焊，内面检查修焊并光顺。
G21 | 滑闸加工件 | 五孔座隔距与可拆夹紧件 | PP3加工到名义2.30mm：10×24隔距2条；M3×30候选 | 隔距块2条、3mm脚座2、M3×30/螺母/垫片各4；6+2.3+10+3+4=25.3名义堆叠 | 1 | 组 | 主方案 | 先纸样/角样，后按实物下单 |  | V4.7新增待询价 | 两端X40–50/170–180；按实物片厚＋约0.3总隙试配。固定焊接时用量规，槽平后再装片。脚座/光束避让仍核。 | ../revision-v4.10/README.md
F13 | 外壳与料斗 | 顶框料斗悬挂支承 | 6061角铝25×25×2裁成宽20、竖外脚22/横外脚14；按实物根R修配 | 4只；M5及匹配T螺母各4＋备2；M3×12/螺母/大垫片各4＋备2；PP法兰径向槽3.5×7，托片圆孔3.5；M5孔候选5.5×8竖长孔/中心距脚底12；M5φ12大垫片6只 | 1 | 套 | 主方案 | 首样尺寸，实配后定孔 |  | 待询价 | 竖脚锁顶框内侧Z440–460，脚面Z440；外侧PP焊筋不碰角片。1kg承载需实测，不以计算代替验收。 四支点PP底边2×2局部倒角避约R2，实际R更大须重定，不能把板拉弯。 V4.10图1明确顶托关系：4金属托片锁黑2020内槽，PP托环坐上并M3固定，木板不承斗重。 下槽盒G21/G11先共面定位，再调顶托片坐实，不能硬拉焊件找平。 | ../revision-v4.10/README.md
F14 | 外壳与料斗 | 历史双法兰接头（V4.9取消） | PP-H3双法兰；食品接触硅胶板1mm；M3连接 | PP3 146×66×2片，孔110×30；硅胶同外/内尺寸×1；4×M3×16及螺母/垫片；每点0.5+0.3限压垫 | 0 | 套 | 历史不采购 | 取消，不下单 |  | 待询价 | 连续四片料斗替代，不买此处PP双法兰/硅胶垫/4个M3×16。 | ../revision-v4.9/README.md
F15 | 外壳与料斗 | BOX前主屏压框/夹持件 | 黑PP2 160×100一片，共裁BOX80×64和C6外框56×38；软垫四角夹片 | 1外框＋4软垫夹片＋4绝缘柱＋候选M3紧固；后框由F06裁 | 1 | 套 | 主方案 | 首样尺寸，实配后定孔 |  | 待询价 | 木板过件孔65.3×48.6。BOX原壳无已确认通用安装孔，不钻壳，不压玻璃；插头/TF/键均保留可达性。 外压框视窗小于原壳以挡住壳边，木板大孔用于从背面装入；必须实际确认不压玻璃/键。 | ../fabrication-v4.8/README.md
F16 | 外壳与料斗 | C6侧屏压框与M2安装件 | 黑PP2外框56×38；PP3绝缘后框56×38开26×10；非Touch | 1外框＋1 PP后框（F05余料）；4×M2×8候选＋3mm尼龙隔柱/垫片，孔距13.08×32参考 | 1 | 套 | 主方案 | 首样尺寸，实配后定孔 |  | 待询价 | 木板过件孔40×24含USB/侧按钮突起余量；孔位基准与有效区按实物；原图2.5H，螺钉实际啮合不顶底；天线不盖铝。 3mm框＋3mm隔柱后螺纹进入≤2mm（扣垫片实算），不顶底；PP框无金属天线遮挡。 黑PP2外框来自F15同一小板，不重复买。 | ../fabrication-v4.8/README.md
F17 | 外壳与料斗 | 可选PP防尘盖 | PP-H2，172×192，F04余料或独立板料 | 盖1片；可焊PP提手1；不穿豆路金属尖头 | 1 | 套 | 备选 | 首样尺寸，实配后定孔 |  | 待询价 | 可选项，不计作承力底。PP2 A3两张先按排版，废料练习不足时补小板。 | ../revision-v4.10/README.md
P19 | 电源与配电 | 原方案备选：外置主适配器 | MEAN WELL GST120A24-P1M | 24V/5A/120W；P1M 5.5外径×2.5内径×11mm，中心正 | 1 | 件 | 备选 | 原高预算路径；已有优先复用 |  | 历史备选待询价 | 满足原≥24V4A预算的具体候选，不是已购；必须配原厂图确认极性、插座DC额定。 | https://www.meanwell.com/Upload/PDF/GST120A/GST120A-SPEC.PDF
P20 | 电源与配电 | 原方案备选：固定5V降压 | Pololu D36V50F5，#4091 | 24V输入→5V；25.4×25.4×9.5mm；标称等级5.5A，实际按热曲线 | 1 | 件 | 备选 | 原高预算路径；已有优先复用 |  | 历史备选待询价 | 首样目标带载4A；5V输出公差4%仍需测板端压降/瞬态。不能照旧18元XL4015额度核价。 | https://www.pololu.com/product/4091
P21 | 电源与配电 | 原方案备选：固定6V舵机降压 | Pololu D36V50F6，#4092 | 24V输入→6V；25.4×25.4×9.5mm；输出公差4% | 1 | 件 | 备选 | 原高预算路径；已有优先复用 |  | 历史备选待询价 | 持续3A/短时5A是验收预算；与5V模块不能插错，高电流直焊粗线不经面包板。 | https://www.pololu.com/product/4092
P22 | 电源与配电 | 原方案备选：分线端子 | WAGO 221-415 五路弹簧端子 | 0.75mm²铜线适配；24V+/返回、5V+/返回、6V+/返回各一组 | 6 | 件 | 备选 | 原高预算路径；已有优先复用 |  | 历史备选待询价 | 6组分别标电压与返回，不短接5V和6V；大电流回路星形，端子固定座另配。 | https://www.wago.com/global/installation-terminal-blocks-and-connectors/compact-splicing-connector/p/221-415
P23 | 电源与配电 | 原方案备选：主低压开关 | NKK S1A，SPST ON-OFF | 原厂DC30V/20A等级；面板安装尺寸依原厂图 | 1 | 件 | 备选 | 原高预算路径；已有优先复用 |  | 历史备选待询价 | 只断24V低压正极；面板6mm需安装衬板/确认螺纹夹紧范围，不盲买开孔尺寸。 | https://www.nkkswitches.com/pdf/Toggles.pdf
P11 | 电源与配电 | 独立低压电源盒 | ABS接线盒200×150×80mm，外置/后置 | 可用内腔目标≥180×130×65；留通风、线夹、螺柱和盒盖间隙 | 1 | 件 | 主方案 | 标准规格询价；按到货件试配 |  | V4.9新增待询价 | 不是整机改外廓；原21mm后腔放不下低价双散热板。按到货尺寸复核。 TPS整板尺寸未冻结，盒内排布按到货件复核。
P12 | 电源与配电 | 电源盒安装板与绝缘固定 | FR-4/绝缘板170×120×2mm + M3尼龙支柱6mm | 按到货模块孔位打孔；约8支柱及紧固件起点 | 1 | 件 | 主方案 | 标准规格询价；按到货件试配 |  | V4.9新增待询价 | 盒内排布见图4，螺柱位置与线弯曲待实配。 TPS整板尺寸未冻结，盒内排布按到货件复核。
P13 | 电源与配电 | 温升不合格时加风扇 | 5V 4010直流风扇 + 防护网 | 40×40×10mm；约0.1–0.2A预算 | 1 | 件 | 备选 | 标准规格询价；按到货件试配 |  | V4.9新增待询价 | 计入5V总4A，风扇与通风口按实测；不能密封积热。 TPS整板尺寸未冻结，盒内排布按到货件复核。
P14 | 电源与配电 | 6V舵机接口 | XT30公母配对成品短线，0.75mm²起点 | 一对；6V正负清楚标记；C01并在舵机近端 | 1 | 件 | 主方案 | 标准规格询价；按到货件试配 |  | V4.9新增待询价 | 电源端方向按实物避免导体外露；颜色仅辅助，必须量正负。
P15 | 电源与配电 | 24V灯带独立接口 | 两芯可插拔接线端子5.08mm间距配对 | ≥30VDC/5A工况；一对，插座形式与6V接口不同 | 1 | 件 | 主方案 | 标准规格询价；按到货件试配 |  | V4.9新增待询价 | 确认端子整件额定和线径；只接灯带，贴24V标签。
P16 | 电源与配电 | TB-A专用桥条 | 与所购TB1506匹配的15A等级3位短接片 | 两段分别连接1–2–3和4–5–6；TB-B不装 | 2 | 段 | 主方案 | 标准规格询价；按到货件试配 |  | V4.9新增待询价 | 按端子配套尺寸/绝缘盖复核；不能买6位整桥把正负短路。
P17 | 电源与配电 | TB螺钉压接端头 | UT0.75-3叉形或OT0.75-3环形，按供货M3图 | 适配0.75mm²铜线和M3；约30只含备 | 1 | 包 | 主方案 | 标准规格询价；按到货件试配 |  | V4.9新增待询价 | 同一螺钉不堆多根线；降压笼式端子改用P08管形端头。
F18 | 外壳与料斗 | 单块五孔PP上座 | 可焊食品接触PP-H6mm，140×30×6mm CNC毛坯 | 五孔14×12，肋3；孔起点同G12，局部Y9；Z292.3–298.3；暂R1.5内角 | 1 | 件 | 主方案 | 标准规格询价；按到货件试配 |  | V4.9新增待询价 | 与PP2主斗、PP10下座/前侧封板配焊；上座140×30保留后焊筋承托面，冷却检查平整，不带闸片或PBT焊。 | ../revision-v4.10/README.md
P24 | 电源与配电 | 备选：5V独立可调降压模块 | XL4016E1 CC/CV 双散热整板（芯片型号，整板SKU按卖家） | 24V→5.00V；持续目标4A；输入电容50V；采购包络≤65×55×30mm | 1 | 件 | 备选 | 历史版本备选，不能与主方案重复采购 |  | 估价单块12–25，非卖家报价 | 整板端子/电感/二极管/散热要配合实测；不把8A/12A宣传视为连续保证。按整板说明先调输出与CC，断电再接设备。 | https://www.xlsemi.com/datasheet/XL4016-EN.pdf
P25 | 电源与配电 | 备选：6V独立可调降压模块 | XL4016E1 CC/CV 双散热整板（芯片型号，整板SKU按卖家） | 24V→6.00V；持续目标3A；输入电容50V；采购包络≤65×55×30mm；短峰5A另验 | 1 | 件 | 备选 | 历史版本备选，不能与主方案重复采购 |  | 估价单块12–25，非卖家报价 | 整板端子/电感/二极管/散热要配合实测；不把8A/12A宣传视为连续保证。按整板说明先调输出与CC，断电再接设备。 | https://www.xlsemi.com/datasheet/XL4016-EN.pdf
G22 | 滑闸加工件 | POM低摩擦下座：另一可拆槽盒备选 | 食品接触资料可核POM，140×18×10mm，加工5通孔 | 历史140×18×10孔板仅参照；采用时须重画前壁的螺接/密封结构 | 1 | 件 | 备选 | 历史版本备选，不能与主方案重复采购 |  | 待询价；不沿用旧打包额度 | POM不能直接焊进当前PP连续槽体。不是买来替换G12即装的通用件。 | https://www.ensingerplastics.com/-/media/Ensinger/Files/Document%20Teaser%20Files/Brochures/Shapes/Stock%20Shapes-catalog-en-2024 | ../revision-v4.10/README.md
F19 | 外壳与料斗 | 连续前封壁与侧封片 | PP-H2；F04余料 | 前片140×18.3×2共1；侧片32×15.3×2共2；前Y103–105，侧X38/180；侧片Z283–298.3避开光电头名义顶282，按实物复核 | 1 | 组 | 主方案 | 名义尺寸，样件试配后定孔 |  | V4.10加工/小件待询价；板料若由余料出不重复采购 | 固定焊到PP6/PP10与隔距框，只有后向闸片入口；不把铝片焊入。 | ../revision-v4.10/README.md | ../revision-v4.10/changed-cuts-v4.10.csv
B16 | 送料与刷排 | 斗底20mm高五槽分道片 | PP-H3；F05余料 | 4片YZ梯形：上深29.502/下深12/高20/X厚3，X起点83/100/117/134 | 4 | 片 | 主方案 | 名义尺寸，样件试配后定孔 |  | V4.10加工/小件待询价；板料若由余料出不重复采购 | 下端对准4根孔肋，前后端配斜斗内面，少量焊筋不挂豆；不改变原主斗外形。 | ../revision-v4.10/README.md | ../revision-v4.10/changed-cuts-v4.10.csv
B14 | 送料与刷排 | 可拆刷段载条/开窗压条与夹持件 | PP3载条110×10×2根；PP2压条110×8×2根 | 12块4×6×3 PP间隔垫；压条每根5个11×3出毛窗；M2×12/螺母/垫片16套（12用4备） | 1 | 组 | 主方案 | 名义尺寸，样件试配后定孔 |  | V4.10加工/小件待询价；板料若由余料出不重复采购 | 压条不夹毛根；每排6螺钉位X59/84.5/101.5/118.5/135.5/161。M2堆叠按样条实量。 | ../revision-v4.10/README.md | ../revision-v4.10/changed-cuts-v4.10.csv
B15 | 送料与刷排 | 外置可调刷托与防豆罩 | PP3小角托4只 + PP2背罩2只 + M3调节件 | 小托约20×12毛坯/3.5×7长孔候选；每排背罩包络约110×20×16；M3×12及螺母垫片8套 | 1 | 组 | 主方案 | 名义尺寸，样件试配后定孔 |  | V4.10加工/小件待询价；板料若由余料出不重复采购 | 按斜斗纸样配形，前后调±2mm；根部/毛槽围挡，后排刷盒与G20连杆全行程联合试配；不得把包络直接当净裁料。 | ../revision-v4.10/README.md | ../revision-v4.10/changed-cuts-v4.10.csv
