koffja/Beanlens/docs/hardware/v4.4/beanlens-box-bom-v4.4.csv

编号 | 类别 | 模块/组件 | 数量 | 单价元（来源见价格状态） | 采购阶段 | 已有/附带 | 可选 | 核对事项 | 价格状态
A01 | 主套件 | 正点原子K230D BOX＋32GB TF卡 | 1 | 257 | 用户报价 | 否 | 否 | 用户确认257元，含TF；普通附送相机不计入所选双摄方案。 | 用户报价
E01 | 已有 | ESP32-C6-LCD-1.47非Touch版 | 1 | 0 | 已有 | 是 | 否 | 侧面状态屏，复用现有板。 | 已有/计入套件
E02 | 套件附带 | BOX自带2.4英寸屏＋32GB TF | 1 | 0 | 计入A01 | 是 | 否 | 没有另买屏幕/TF；拆分列只是防止漏项和重复购买。 | 已有/计入套件
B01 | 双摄已选 | GC2093＋M12 90°无畸变镜头，两套 | 1 | 114.32 | 用户报价 | 否 | 否 | 两套合计114.32元；确认BOX两路兼容、IR-cut、近焦、90°定义。 | 用户报价
B02 | 排线 | BOX兼容MIPI排线，按实际路径 | 2 |  | 待询价 | 否 | 否 | 主板改为前贴后重新量长度；若相机价已包含合适排线，取消本行避免重复。 | 待询价
A03 | 驱动已选 | MG996R位置舵机＋舵盘 | 1 | 15.58 | 用户报价 | 否 | 否 | 6.0V独立供电；确认角度版，不要连续旋转改装版；原厂参数不代表廉价件。 | 用户报价
A04 | 经过提示 | 山大斯M12对射收发一组 | 1 |  | 待型号/报价 | 否 | 否 | 6–36V图示；本版24V，确认NPN遮光导通、完整型号和激光等级。 | 待询价
B03 | 称重ADC | NAU7802 I²C模块，3.3V兼容 | 1 | 20 | 规划额度 | 否 | 否 | 3.3V DVDD、约3.0V内部VDDA起试；确认模块原理图/激励/参考，上拉只到3.3V。 | 规划额度
B04 | 精密称重 | 1kg四线全桥、单点偏载补偿传感器 | 1 |  | 待参数/报价 | 否 | 否 | 允许170×180平台；按净0–500g、±0.1g目标询价；不能只凭C2/C3和显示位数。 | 待询价
B05 | 校准 | 100g/500g等可核查质量砝码 | 1 |  | 待资料/报价 | 否 | 否 | 支持0.1g判定，参考质量不确定度建议≤0.03g；无资料低价砝码不作证明。 | 待询价
B06 | 称台 | 轻平台＋刚性底座/支柱＋过载限位 | 1 | 18 | 规划额度 | 否 | 否 | 平台170×180，正常不触限位；盒和承重件目标≤250g。 | 规划额度
A05 | 照明已选 | 24V普瑞Ra98同批固定色温灯带 | 1 |  | 待功率/报价 | 否 | 否 | 初试4×100mm、总0.4m；≤20W/m预算，按切点改长度，本次两选一倾向6000K/Ra98，前提是参数可信和实拍通过。 | 待询价
A06 | 扩散散热 | 4条铝散热槽＋扩散片＋遮光边 | 1 | 12 | 规划额度 | 否 | 否 | 每条向豆帘斜照；不让LED直射镜头，木板不承担灯散热。 | 规划额度
A07 | 主电源 | 24V/4A成品稳压适配器 | 1 |  | 待型号/报价 | 否 | 否 | 推荐96W；24V3A需满足负载边界。GST90A24 90W可作原厂参考，非已核价。 | 待询价
A08 | 逻辑降压 | XL4015类24V→5.0V带散热模块 | 1 | 18 | 规划额度 | 否 | 否 | 板卡支路目标4A；带载温升实测，不凭标称5A；空载先调5.0V。 | 规划额度
A17 | 舵机降压 | 第二只24V→6.0V带散热模块 | 1 | 18 | 规划额度 | 否 | 否 | 持续3A/短时5A设计目标；验实际模块，不足改更大；与5V分开。 | 规划额度
A09 | 配电保护 | 24V DC开关、端子、保险座/保险、线材 | 1 | 25 | 规划额度 | 否 | 否 | DC额定≥24V4A；星形回路；主/舵机0.75mm²起试，保险按浪涌线径协调。 | 规划额度
A10 | 滤波 | 1000µF16V＋470µF10V＋100nF | 1 | 5 | 规划额度 | 否 | 否 | 分别在6V/5V端；符合模块输出电容/启动要求，注意极性。 | 规划额度
A11 | USB供电 | 双USB-A供电转接＋两根短A-to-C线 | 1 | 12 | 规划额度 | 否 | 否 | 5V支路到两个板电源口；按电流和板端压降核对，不与电脑反灌。 | 规划额度
B07 | 框架 | 2020银色型材4.40m＋角码/T螺母 | 1 | 85 | 规划额度 | 否 | 否 | 400×4、220×4、200×6、180×4；相机和料斗支架分别固定。 | 规划额度
B08 | 豆路 | 6mm海洋板支架＋0.5mm PP内衬/隔板 | 1 | 35 | 规划额度 | 否 | 否 | 四片梯形薄PP；3mm隔板/6mm边条另预切；接缝在外。 | 规划额度
B09 | 滑闸 | POM片＋导块/M3球头连杆＋MG996R金属支架 | 1 | 25 | 规划额度 | 否 | 否 | 0.8–1mm、110×45、行程15；后上方轴z315、闸z292，球头过渡23；实物检查视锥。 | 规划额度
B10 | 外壳与屏固定 | 6mm海洋板＋BOX内托架＋遮光隔舱/快拆 | 1 | 45 | 规划额度 | 否 | 否 | BOX前面板贴装、主板朝内；C6右侧；服务腔至少约35深，插头另留量。 | 规划额度
B11 | 可拆刷 | PBT软刷＋夹座 | 1 | 6 | 规划额度 | 否 | 否 | 先无刷对照；不脱毛、不偏留碎片才用。 | 规划额度
A13 | 控制接线 | 两限位＋PH2.0线/接头＋上拉 | 1 | 10 | 规划额度 | 否 | 否 | 开/关限位，UART只接TX/RX/GND，PH2.0的5V不连。 | 规划额度
B12 | 收豆 | 食品接触PP盒，外≤160×170×130 | 1 | 12 | 规划额度 | 否 | 否 | 容下实际500g，重量尽量轻；只压称台，不装承重滑轨。 | 规划额度
A14 | 颜色参考 | 哑光中性灰参考块 | 1 | 8 | 规划额度 | 否 | 否 | 检查重复性，不代替专业色度校准。 | 规划额度
B13 | 相机固定 | 两套L架＋载板/尼龙柱＋固定夹 | 1 | 20 | 规划额度 | 否 | 否 | PCB孔距按实物；独立型材梁，不靠排线支撑。 | 规划额度
A15 | 工业信号 | 24V NPN输入→3.3V开集电极光耦模块 | 1 | 10 | 规划额度 | 否 | 否 | 确认24V电阻/输入类型、泄漏/延迟；不能固定5V推挽。共地时不是完整隔离。 | 规划额度
B14 | 光电安装 | M12可调L支架＋双螺母/遮光帽 | 1 | 8 | 规划额度 | 否 | 否 | 按实物M12×1，留52.5机身和出线空间。 | 规划额度
A16 | 按键 | 16mm无灯金属自复位1NO1NC | 2 | 6 | 规划额度 | 否 | 否 | 开始NO、停止NC；面板6mm夹紧范围确认。 | 规划额度
O01 | 可选 | 5V供电AHCT单向PWM缓冲 | 1 | 6 | 必要时 | 否 | 是 | 仅当MG996R不能接受3.3V信号；不可用6V供电。 | 规划额度
O05 | 候选，不与B04同时买 | 欧路达Autoda 3kg裸传感器（型号待核） | 1 | 55 | 用户提供候选价 | 否 | 是 | 不保证数字输出或±0.1g；先核型号/线序/激励/数据表，模拟桥仍需ADC。 | 用户报价
O06 | 候选配套 | 欧路达配套铝支架增价 | 1 | 50 | 用户提供差价 | 否 | 是 | 55→105元差价；只在选O05且含匹配刚性底座/承载组件时考虑，不与B06重复采购。 | 用户报价
O04 | 可选 | 专用3.3V降压/低噪声后级 | 1 |  | 余量不足才加 | 否 | 是 | C6新增外设>35mA或称重噪声未达标再评估；不能和板载3.3V输出并联。 | 待询价
