koffja/Beanlens/docs/hardware/hackathon-h3/assembly-p4/bom-p4.csv

id | name | kind | spec | installed_qty | unit | procurement_basis_qty | included_in | notes | procurement_unit | unit_price_cny
H01 | 识别/显示/控制板 | 采购／复用 | 正点原子 K230D BOX；含内置2.4屏/用户按键，64.3×47.6×15.4外壳参考；TF按原套件 | 1 | 件 | 1 |  | Type-C1供5V；Type-C2不供电，不拆原壳。已有套件257报价不重计。 | 件
H02 | 水平相向双摄 | 采购／复用 | GC2093-M12-90度无畸变（用户型号）；GC2093-M12-90度无畸变，两只完整模组＋兼容BOX排线 | 2 | 件 | 2 |  | 前镜头(110,30,260)向后；后镜头(110,210,260)向前，各约90mm工作距起试。两CSI映射、近焦/像素密度与短曝光待实机核验。 | 件
H03 | 舵机 | 采购／复用 | MG996R 位置版；1只，独立6V；外形40.7×19.7×42.9参考，轴竖直 | 1 | 件 | 1 |  | 位置版，独立6V。机身固定，轴目标(170,180,331)；只推拉轻闸片，不能用标称扭矩证明不卡豆。 | 件
H04 | 主电源 | 采购／复用 | YU2405（用户指定）；机外24V/5A/120W；实际厂牌/插头/极性/AC线另核 | 1 | 件 | 1 |  |  | 件
H05 | 逻辑降压 | 采购／复用 | TPS5450成品板候选，整板SKU未定；24V→5.00V成品板；BOX双摄＋缓冲，3A连续预算待验 | 1 | 件 | 1 |  | 不是裸DDA芯片；先空载量5V再接BOX，不选未证实供电板。 | 件
H06 | 舵机降压 | 采购／复用 | HOBBYWING UBEC5A / 30607000 / 2–8S；设6.0V；原厂5A持续，本机3A持续/5A短峰预算 | 1 | 件 | 1 |  | 断电设跳帽，量6V后接舵机；不能给GPIO或主板。 | 件
H07 | 固定照明 | 采购／复用 | 复用原24V 6000K/Ra98灯带，完整SKU待核；4段各100mm有效长，合计0.4m；≤8W预算 | 4 | 段 | 4 |  | 两面各两条，侧向常亮；先核实际剪切点。100–200µs仅曝光试验起点，亮度是否够必须实拍。 4段在侧PP承板内侧；卡扣不穿LED线路。 | 段
H09 | 开/关限位 | 采购／复用 | OMRON SS-01GL 微负载金合金触点；每端1只，COM/NO，低电平有效；19.8×6.4壳体/9.5孔距参考 | 2 | 件 | 2 |  | 两只检测闸片尾部旗片，闭位/开位分别确认；装在豆路之外。座位、触发余量按实物调；不可只检测舵臂角度。 | 件
H11 | 舵臂 | 采购／复用 | MG996R匹配25T金属直臂，16mm孔半径；只用16mm孔；孔径优先M3，若现有goBILDAφ4加适配套 | 1 | 件 | 1 |  | 只有一只25T直臂，使用R16孔接连杆球头；不是双舵臂。中心螺钉用舵机原配，孔径M3优先；几何角度不等于PWM标定。 | 件
H12 | 闸片球头垫高件 | 采购／复用 | M3×8六角隔柱＋M3球头螺柱/垫片；1套；使闸片球心与舵臂球心同高，名义Z337.5 | 1 | 套 | 1 |  | 8mm隔柱是候选，须扣除实际球头中心高度后配垫。球心共面后再连接，禁止靠拧紧掰弯连杆。球头本体计H37，不重复买。 | 套
H21 | 普通收豆杯 | 采购／复用 | PP杯/盒，约100×100×80mm；固定底板上，覆盖出口下方；不装传感器 | 1 | 件 | 1 |  | 下斗直落同一普通杯，所有分类都进同一杯；无称重、无分选。杯位置可调，使中心落点(110,120)在杯内。 | 件
H23 | 缓冲IC与插座 | 采购／复用 | TI SN74AHCT125N + DIP14插座；VCC5V，TTL输入，使用通道1；闲置输入接地、/OE拉高 | 1 | 件 | 1 |  | H22构成件；5V不能反接BOX GPIO。 | 件
H24 | 使能三极管 | 采购／复用 | 2N3904 NPN TO-92；E→GND，C→/OE1，B经4.7k到GPIO22 | 1 | 件 | 1 |  | H22构成件，按所购厂家引脚图确认E/B/C。 | 件
H25 | 电阻包 | 采购／复用 | 金属膜1% 0.25W；10k×2，4.7k×1，100k×1，1k×3，220Ω×1；各备1 | 1 | 包 | 1 |  | 10k：/OE上拉5V、PWM输入下拉；1k：PWM输入串联及2限位串联；100k基极下拉。 | 包
H26 | 去耦与近端电容 | 采购／复用 | 100nF/50V X7R×1；1000µF/16V 105℃低ESR×1；100nF紧贴IC14/7；1000µF并舵机6V/GND | 1 | 包 | 1 |  | 核极性；不以电容替代足够的降压和线径。 | 包
H27 | 信号接线辅料 | 采购／复用 | 30×50洞洞板、端子、2.54插座、热缩/绝缘柱；缓冲板与J10短线，标注GPIO编号及针脚号 | 1 | 包 | 1 |  | J10只12个GPIO，没有地或电源；GND从原理图J6（PH2.0口1）的2脚GND引出，以实物1脚方向核针序；J6的1脚5V及3/4脚不接。 | 包
H28 | 配电/保险/开关包 | 采购／复用 | 绝缘低压分线端子；DC保险座；舵机支路电源开关；主4A、灯1A、5V输入1.5A、UBEC输入3A；6V开关DC≥12V/5A | 1 | 包 | 1 |  | 保险位在24V正输入；手动6V开关用于装配/排障，不称自动硬件急停。盒保留机外，不接裸交流。 机外盒单列H41，保险／开关包不重复计盒。 | 包
H29 | 电源线/接口 | 采购／复用 | 0.75mm²多股铜线、压接端子、5V USB-A→C成品短线；24V/6V电流不走杜邦；DC母座按YU2405实物匹配 | 1 | 包 | 1 |  | 5V接BOX Type-C1；USB调试时禁止另一路5V反灌/并联。信号地与UBEC参考地相连，舵机返回独立走线。 | 包
H36 | 单槽铝闸片 | 采购／复用 | 6061-T6 29.4×82×2mm；两面平整、倒钝去毛刺；球头孔中心距前缘76mm，横向居中 | 1 | 片 | 1 |  | 先裁毛坯试配；M3孔径按连接件，正式孔待球头确认。关闭前缘Y108，打开前缘127.749，行程19.749。不要带豆强关。 P4另有旗片孔，中心X120/Y184（原球头X110/Y184）。 | 片
H37 | 双球头短连杆 | 采购／复用 | RC模型M3球头连杆，球心距50mm，可调约±3mm；1根杆＋2颗球头；M3连接螺柱/孔；要求卖家注明球心距 | 1 | 套 | 1 |  | 淘宝搜索：M3 球头连杆 球心距50mm。不是50mm裸螺杆；不接受球心距不明的套件。无已验证专属SKU，收到量中心距后重算端点。 | 套
H08 | 灯带铝槽 | 采购／复用 | U形铝槽候选14×8×100；须配同槽型安装卡扣 | 4 | 件 | 4 |  | 槽与卡扣一起对实物；参考外形不作为未核SKU的保证。 | 件
LC01 | 铝槽配套卡扣 | 采购／复用 | H08同规格金属／耐温卡扣；8用＋2备 | 8 | 件 | 10 |  | 若槽套装已含足量，扣除；孔型以实物配侧PP承板。 | 件
H10 | 舵机加强角码 | 采购／复用 | 40×40×4、宽20；竖面两M5孔，水平两M3孔 | 1 | 件 | 1 |  | 只保留金属加强角码；旧MG996R金属机身支架由P21替代。 | 件
P27 | 舵机铝底板 | 采购／改孔 | 6061 60×60×3；6个φ3.4候选孔 | 1 | 件 | 1 |  | 左前下角153/159/280.2，保留P2孔图；与加强角码先实配。 | 件
H13 | 白PP板原料 | 原料采购／余料优先 | PP-H 2mm 300×300一片＋PP-H 3mm 300×300一片 | 1 | 组 | 1 |  | PP3供顶环、上下盖、68×80承托；PP2仅下短管与前U片。取消原上／下斗与相机PP载板，不与PETG热焊。 | 组
H14 | 黑色欧标2020库存 | 已有／裁切 | 已确认460×7根、400×2根；本版用460×4、200×4、180×5 | 13 | 段 | 0 |  | P28包含在13段中；无须新增型材。3mm锯缝排法见裁切表，余料合计453mm。 | 不另购
P28 | 新增后横梁 | 裁切子件 | 黑2020长180；X20/Y220/Z298 | 1 | 件 | 0 | H14 | 从第二根400库存切出，不另买一根180。 | 不另购
H15 | 2020两孔90°角码 | 采购／复用 | 16只框架＋2只后横梁＝18用，2备 | 18 | 件 | 20 |  | P29已包含；M5螺钉、T螺母见K总表，不把原套装附送件再买一遍。 | 件
P29 | 后横梁两角码 | 装配子件 | H15中取2只标准两孔角码 | 2 | 件 | 0 | H15 | 每只两个M5，端部支承上面298。 | 不另购
H16 | 6mm海洋板原料 | 原料采购／复用 | 176×196×6原料3片，可裁W01–W05共5件 | 5 | 成品 | 3 |  | 第三片裁88＋30＋30＋3道3mm切缝＝157，余39；已有合格木料则扣库存。 | 片原料
W01 | 底木板 | 裁切子件 | 176×196×6；底Z22；孔X60/160、Y30/210 | 1 | 件 | 0 | H16 | 定位孔见装配图／裁切表；不能用旧底板孔位。 | 不另购
W02 | 开孔工作木台 | 裁切子件 | 176×196×6；底Z180；中央60×60孔 | 1 | 件 | 0 | H16 | 定位孔见装配图／裁切表；不能用旧底板孔位。 | 不另购
W03 | BOX前承板 | 裁切子件 | 176×88×6；X22/Y20/Z334 | 1 | 件 | 0 | H16 | 定位孔见装配图／裁切表；不能用旧底板孔位。 | 不另购
W04 | 前相机木横条 | 裁切子件 | 176×30×6；X22/Y2/Z234 | 1 | 件 | 0 | H16 | 定位孔见装配图／裁切表；不能用旧底板孔位。 | 不另购
W05 | 后相机木横条 | 裁切子件 | 176×30×6；X22/Y208/Z234 | 1 | 件 | 0 | H16 | 定位孔见装配图／裁切表；不能用旧底板孔位。 | 不另购
H17 | 20×20×2角铝原料 | 原料采购／复用 | 6063/6061等边角铝长1000mm；4×宽40＋16×宽20 | 20 | 成品 | 1 |  | 工作台4只宽40，相机木条4、屏板4、侧遮光4、背景4均宽20；计20道3mm切缝需540mm，1m足够。裸角铝须按连接详图钻孔，不能默认成品角码孔型相同。 | 根（1m）
H39 | 20×2铝扁条原料 | 原料采购／复用 | 宽20厚2长500mm；8片40长＋4片12长 | 12 | 成品 | 1 |  | 顶环4、底板4平片40×20；BOX压片4为12×20。368净长＋12道3mm切缝＝404，余96；也可买孔距20的40×20平连接片8只，勿两套重复买。 | 根（500mm）
H19 | BOX四角固定组件 | 装配组 | 4铝压片12×20×2＋4通孔20mm隔柱＋4软垫 | 1 | 组 | 0 |  | 铝片已计H39；隔柱N01、软垫N02，M3×35计K。替代旧未定孔位的80×64压框示意；不夹屏幕、不钻PCB，原壳尺寸先核。 | 不另购
N01 | BOX绝缘通孔隔柱 | 采购／复用 | M3通孔、外径约7、长20mm；4用＋2备 | 4 | 件 | 6 |  | 不是M3×20螺钉；固定原壳角压片与木承板间距。 | 件
N02 | BOX软垫 | 采购／复用 | 约1mm硅胶／EPDM片，100×20候选 | 4 | 小片 | 1 |  | 裁4片，只垫外壳角边；不遮屏、按键、接口；轻紧不压弯原壳。 | 条（100×20）
H20 | 黑PP遮光及灯槽承板 | 原料采购／复用 | 黑PP2 300×300一片；2侧196×100＋2背景110×47 | 4 | 成品 | 1 |  | 侧片两端开木条避让槽；右侧后上去64×34，后背景右上去30×16。孔与灯槽卡扣先实配。图中透明仅为看装配。 | 片（300方）
H22 | PWM单向缓冲板组件 | 装配组 | SN74AHCT125N＋2N3904＋阻容与洞洞板 | 1 | 件 | 0 |  | 采购已分H23–H27，勿再买一套重复板。接线仍用H3，无GPIO改动。 | 不另购
H38 | 导向侧垫条原料 | 采购＋裁切 | PP2余料＋PET0.3片20×100；组合10×85×2.3，两条 | 1 | 组 | 1 |  | PP2已含H13，本行新增PET；导向条不打印、不焊死。 | 组
C01 | PP3顶环 | 裁切／焊接子件 | 176×196×3，80方孔，4斗孔＋4平片孔 | 1 | 件 | 0 | H13 | 按P4图加工；不保留原176×50大承托或上PP连接管。 | 不另购
C02 | PP3下导向盖 | 裁切／焊接子件 | 50×85×3；18×14孔与4螺栓孔 | 1 | 件 | 0 | H13 | 按P4图加工；不保留原176×50大承托或上PP连接管。 | 不另购
C03 | PP3上导向盖 | 裁切／焊接子件 | 50×85×3；孔与下盖重合 | 1 | 件 | 0 | H13 | 按P4图加工；不保留原176×50大承托或上PP连接管。 | 不另购
C06 | PP2下短管 | 裁切／焊接子件 | 外22×18、内18×14、长21，外焊下盖 | 1 | 件 | 0 | H13 | 按P4图加工；不保留原176×50大承托或上PP连接管。 | 不另购
C07 | PP2前U封片 | 裁切／焊接子件 | 前54×8.3×2，左右16×8.3×2，贴盖板外缘 | 1 | 件 | 0 | H13 | 按P4图加工；不保留原176×50大承托或上PP连接管。 | 不另购
P30 | PP3后承托片 | 裁切／焊接子件 | 68×80×3；20×30窗及8孔 | 1 | 件 | 0 | H13 | 按P4图加工；不保留原176×50大承托或上PP连接管。 | 不另购
P11 | 上漏斗斗身 | 3D打印 | Bambu PETG HF；打印包络104×104×100.5；任务01-upper-hopper | 1 | 件 | 0 |  | 原文件保持；对应P3已切片文件，先试配再打主件。 | 不另购
P12 | 上漏斗接座 | 3D打印 | Bambu PETG HF；打印包络50×85×16；任务02-adapter-and-cameras | 1 | 件 | 0 |  | 原文件保持；对应P3已切片文件，先试配再打主件。 | 不另购
P13 | 下接豆斗 | 3D打印 | Bambu PETG HF；打印包络90×90×60；任务03-lower-collector | 1 | 件 | 0 |  | 原文件保持；对应P3已切片文件，先试配再打主件。 | 不另购
P21 | MG996R打印固定架 | 3D打印 | Bambu PETG HF；打印包络56×68×35.8；任务04-servo-cradle | 1 | 件 | 0 |  | 原文件保持；对应P3已切片文件，先试配再打主件。 | 不另购
P22 | 前相机打印座 | 3D打印 | Bambu PETG HF；打印包络60×28×48；任务02-adapter-and-cameras | 1 | 件 | 0 |  | 原文件保持；对应P3已切片文件，先试配再打主件。 | 不另购
P23 | 后相机打印座 | 3D打印 | Bambu PETG HF；打印包络60×28×48；任务02-adapter-and-cameras | 1 | 件 | 0 |  | 原文件保持；对应P3已切片文件，先试配再打主件。 | 不另购
P24 | 关位开关打印座 | 3D打印 | Bambu PETG HF；打印包络16×34×29；任务05-limits-and-flag | 1 | 件 | 0 |  | 原文件保持；对应P3已切片文件，先试配再打主件。 | 不另购
P25 | 开位开关打印座 | 3D打印 | Bambu PETG HF；打印包络16×27×29；任务05-limits-and-flag | 1 | 件 | 0 |  | 原文件保持；对应P3已切片文件，先试配再打主件。 | 不另购
P26 | 闸片限位旗片 | 3D打印 | Bambu PETG HF；打印包络37×9×18；任务05-limits-and-flag | 1 | 件 | 0 |  | 原文件保持；对应P3已切片文件，先试配再打主件。 | 不另购
H41 | 机外低压电气盒 | 采购／复用 | 绝缘盒200×150×80候选，带盖与防拉脱线口 | 1 | 件 | 1 |  | 电源适配器在机外；24V分配／5V板／UBEC／缓冲固定在绝缘底板，孔距按实物。未纳入机架尺寸；不接裸交流。已有原低压盒则复用。 | 件
H42 | 防滑脚垫 | 可选采购 | 20×20×约3自粘硅胶垫 | 4 | 件 | 4 |  | 可贴四立柱底端；460为裸框高度，垫脚另计；图中不作承载保证。 | 件
K-M2x5 | M2×5螺钉 | 紧固件采购 | 304圆柱／盘头，按连接面选；长度为候选 | 8 | 件 | 10 |  | 按各连接图分配。下列数量为整机总需求，购买前扣除原套件内已有数量。M5先试槽不顶底；M2只适配实物孔。 | 件
K-M2x8 | M2×8螺钉 | 紧固件采购 | 304圆柱／盘头，按连接面选；长度为候选 | 8 | 件 | 10 |  | 按各连接图分配。下列数量为整机总需求，购买前扣除原套件内已有数量。M5先试槽不顶底；M2只适配实物孔。 | 件
K-M2x14 | M2×14螺钉 | 紧固件采购 | 304圆柱／盘头，按连接面选；长度为候选 | 4 | 件 | 6 |  | 按各连接图分配。下列数量为整机总需求，购买前扣除原套件内已有数量。M5先试槽不顶底；M2只适配实物孔。 | 件
K-M3x10 | M3×10螺钉 | 紧固件采购 | 304圆柱／盘头，按连接面选；长度为候选 | 21 | 件 | 25 |  | 按各连接图分配。下列数量为整机总需求，购买前扣除原套件内已有数量。M5先试槽不顶底；M2只适配实物孔。 | 件
K-M3x12 | M3×12螺钉 | 紧固件采购 | 304圆柱／盘头，按连接面选；长度为候选 | 14 | 件 | 17 |  | 按各连接图分配。下列数量为整机总需求，购买前扣除原套件内已有数量。M5先试槽不顶底；M2只适配实物孔。 | 件
K-M3x16 | M3×16螺钉 | 紧固件采购 | 304圆柱／盘头，按连接面选；长度为候选 | 36 | 件 | 42 |  | 按各连接图分配。下列数量为整机总需求，购买前扣除原套件内已有数量。M5先试槽不顶底；M2只适配实物孔。 | 件
K-M3x20 | M3×20螺钉 | 紧固件采购 | 304圆柱／盘头，按连接面选；长度为候选 | 2 | 件 | 4 |  | 按各连接图分配。下列数量为整机总需求，购买前扣除原套件内已有数量。M5先试槽不顶底；M2只适配实物孔。 | 件
K-M3x25 | M3×25螺钉 | 紧固件采购 | 304圆柱／盘头，按连接面选；长度为候选 | 2 | 件 | 4 |  | 按各连接图分配。下列数量为整机总需求，购买前扣除原套件内已有数量。M5先试槽不顶底；M2只适配实物孔。 | 件
K-M3x35 | M3×35螺钉 | 紧固件采购 | 304圆柱／盘头，按连接面选；长度为候选 | 4 | 件 | 6 |  | 按各连接图分配。下列数量为整机总需求，购买前扣除原套件内已有数量。M5先试槽不顶底；M2只适配实物孔。 | 件
K-M5x8 | M5×8螺钉 | 紧固件采购 | 低头内六角，配欧标槽6螺母 | 56 | 件 | 65 |  | 按各连接图分配。下列数量为整机总需求，购买前扣除原套件内已有数量。M5先试槽不顶底；M2只适配实物孔。 | 件
K-M5x10 | M5×10螺钉 | 紧固件采购 | 低头内六角，配欧标槽6螺母 | 4 | 件 | 6 |  | 按各连接图分配。下列数量为整机总需求，购买前扣除原套件内已有数量。M5先试槽不顶底；M2只适配实物孔。 | 件
K-M5-T | M5欧标槽内螺母 | 紧固件采购 | 欧标2020槽6兼容M5；56+4＝60用，10备 | 60 | 件 | 70 |  | 不能用国标槽型替代；按实际型材槽口确认。 | 件
K-M5-W | M5平垫 | 紧固件采购 | M5平垫约φ10；60用，10备 | 60 | 件 | 70 |  |  | 件
K-M3-N | M3防松螺母 | 紧固件采购 | 79用，建议备至100 | 79 | 件 | 100 |  | 球头套件与隔柱自带的螺母不重复计；绝缘隔柱用通孔款。 | 件
K-M3-W | M3大平垫 | 紧固件采购 | 内φ3.2／外φ9；两面各一，158用 | 158 | 件 | 180 |  | M3穿平片φ5.5孔时必须加大垫片，不能直接用小螺母压孔。 | 件
K-M2-N | M2螺母 | 紧固件采购 | SS-01GL 4用，6备 | 4 | 件 | 10 |  |  | 件
K-M2-W | M2平垫 | 紧固件采购 | 开关8＋相机16＝24用 | 24 | 件 | 40 |  |  | 件
P36 | 相机M2内内隔柱 | 采购／复用 | M2内内8mm，8用＋2备；PCB侧M2×5、背板侧M2×8候选 | 8 | 件 | 10 |  | 8mm是当前镜头位置候选；核实际PCB厚、元件突出及两侧螺纹不得顶碰。 | 件
