koffja/Beanlens/docs/hardware/hackathon-h3/printing-p1/BOM-delta.csv

编号 | 处理 | 物料 | 规格 | 数量 | 说明
P01 | 打印 | 上漏斗斗身 | PETG候选 最小法向壁厚2.4 外法兰104×104×4 | 1 | 替换上斗PP2斜壁与上部短颈；原PP3顶环保留
P02 | 打印 | 上漏斗可拆接座 | 平板50×85×3 插口23.2×19.2 总高16 | 1 | 叠加在原PP闸盒上盖上；不占闸片2.3mm导槽
P03 | 打印 | 下接豆斗 | 内顶64×64 内底30×30 高60 固定法兰90×90×4 | 1 | 替换下斗PP2壁板及外焊耳；工作台60×60孔保留
P04 | 新增 | 上斗顶环固定件 | M3×16＋平垫两侧＋防松螺母 | 4套 | 顶环3＋打印法兰4=7mm；长度按实物垫片核对
P05 | 替换 | 闸盒连接螺栓 | M3×20候选＋平垫及防松螺母 | 4套 | 替换原M3×16候选；新增接座后夹层合计11.3mm
P06 | 复用或补购 | 下斗工作台固定件 | M3×16＋平垫两侧＋防松螺母 | 4套 | 木台6＋打印法兰4=10mm；按实物啮合核长度
P07 | 保留 | 原闸盒与下短管 | PP盖板与垫条及内18×14下短管 | 1套 | 打印材料不与PP热风焊；原铝闸片和MG996R传动保留
P08 | 选打 | 公母配合试片 | fit-tests内两只STL | 各1 | 先确认0.2mm单侧名义间隙再打印完整上斗
