koffja/Beanlens/docs/hardware/revision-v4.11/changed-cuts-v4.11.csv

BOM | 材料 | 名义规格mm | 数量 | 用途/状态
F18 | PP-H | 140×30×6 | 1 | 上五孔座；同V4.9
G12 | PP-H | 140×24×10 | 1 | 下五孔座；局部孔Y9，后端全局Y129
F19-front | PP-H | 140×18.3×2 | 1 | 前封壁，固定片全高焊接
F19-side | PP-H | 32×15.3×2 | 2 | 两侧封片Z283–298.3，避开光电头名义顶Z282
G21 | PP-H | 10×24×2.3 | 2 | 隔距条名义厚度，按闸片实厚＋总游隙约0.3试配
B16 | PP-H3 | 上29.502 / 下12 / 高20 | 4 | 分道片YZ面梯形，X厚3，端面配斗壁
B14-carrier | PP-H | 110×10×3 | 2 | 刷排载条
B14-clamp | PP-H | 110×8×2 | 2 | 刷排压条
B11 | PP基条/PBT | 12×6×3基条 / 自由毛长14 | 10 | 厂家植毛封端；毛簇宽10、毛径0.10–0.15
F04-ports | PP2主斗壁 | 11×4斜面圆角槽 | 10 | 前后面各5；中心X76/93/110/127/144，Z310，按样刷修孔
