koffja/Beanlens/docs/hardware/hackathon-h3/printing-p2/BOM-delta.csv

编号 | 处理 | 元件或物料 | 规格 | 数量 | 说明
P21 | 打印 | MG996R固定架 | PETG候选56×68×35.8安装包络 | 1 | 耳孔先纸样核对；原铝底板和金属角码保留
P22 | 打印 | 前相机座 | 60×28×48候选24至34方孔距 | 1 | 按实际PCB孔距修配；不夹镜头筒
P23 | 打印 | 后相机座 | 60×28×48前后反向 | 1 | 沿用水平双摄Z260
P24 | 打印 | 关位限位座 | SS-01GL孔距9.5沿Y可调 | 1 | 杠杆朝后检测旗片前缘
P25 | 打印 | 开位限位座 | SS-01GL孔距9.5沿Y可调 | 1 | 杠杆朝前检测旗片后缘
P26 | 打印 | 加高限位旗片 | 37×9低脚及竖边总高18 | 1 | 替换旧旗片；闸片新增孔X120/Y184
P27 | 改安装 | 原6061铝底板 | 60×60×3及6个候选M3孔 | 1 | 左前下角X153/Y159/Z280.2；先对所购角码孔型
P28 | 新增裁切 | 后横梁 | 同槽型黑2020长180mm | 1 | 从原剩余400整根裁出留锯缝；不额外订型材
P29 | 复用备用或补购 | 后横梁角码 | 2020金属两孔角码及M5螺钉T螺母 | 2套 | 端部固定需要4套M5；顶槽承托再2套
P30 | 替换裁切 | 闸盒后承托片 | PP3厚68×80及20×30避让窗 | 1 | 替换原176×50；从余料裁；孔图见templates
P31 | 替换螺栓 | 闸盒后侧两根贯穿螺栓 | M3×25候选配原垫片防松螺母 | 2 | 新增承托厚3；前侧仍按P1的M3×20候选
P32 | 新增或复用 | 舵机架底脚紧固 | M3×12及两侧平垫防松螺母 | 4套 | 5mm打印脚加3mm铝板
P33 | 新增或复用 | 舵机安装耳紧固 | M3×16候选平垫防松螺母 | 4套 | 按实际舵机耳孔；6mm耳梁
P34 | 新增或复用 | 铝板到金属角码 | M3×12候选平垫防松螺母 | 2套 | 铝板3加角码4
P35 | 新增或复用 | 相机座底脚紧固 | M3×16平垫防松螺母 | 4套 | 打印脚4加木条6
P36 | 复用或补购 | PCB固定隔柱 | M2隔柱8mm候选及匹配螺钉垫片 | 8套 | 按PCB厚及镜头突出量实配
P37 | 新增或复用 | 限位座底脚紧固 | M3×12平垫防松螺母 | 4套 | 打印脚4加PP3
P38 | 新增或复用 | SS-01GL开关紧固 | M2×14或16候选平垫螺母 | 4套 | 安装孔不可硬塞M2.5；按实际堆叠核螺长
P39 | 新增 | 小旗片固定 | M3×10候选平垫防松螺母 | 1套 | 打印脚3加闸片2；全行程核螺母净空
