koffja/Beanlens/docs/hardware/hackathon-h2/cut-list-h2.csv

BOM | 材料 | 尺寸mm | 数量 | 装配说明
H14 | 黑欧标2020 | 460×4 / 180×4 / 200×4 | 12段 | 沿用H1；已有460×7+400×2足够，不新订型材
H16 | 海洋板6 | 176×196 | 3片 | 仅工作板改孔70×110；孔相对53/33，全局75/55
H13 | PP3底座 | 100×130；开48×105 | 1片 | 孔相对26/10，全局86/60
H13 | PP3侧支承梯形 | 水平62.419；前高88.707；后高45 | 2片 | 底Z189；上边跟35°玻璃斜面，另有14高挡边
H32 | PP3托条 | 3×76.2（沿板面） | 2条 | 压在玻璃下侧外缘；中央通光约19.8宽
H32 | PP3可拆压扣 | 12×8毛坯 | 4只 | 外侧M2夹持，不压弯玻璃；孔按实物
H31 | 成品玻璃载玻片 | 25.4×76.2×1.0–1.2 | 1用2备 | 不自行裁切，不PP焊，不用盖玻片
H13 | PP3导豆口底板 | 板面长32.449；前宽45/后宽25.8 | 1片 | 梯形；Y35到玻璃上沿Y61.58，纸样配缝后裁
H13 | PP3导豆口侧片 | 按两端14高+底面35°纸样展开 | 2片 | 外扩侧壁为斜平面，不能直接用矩形硬拉焊
H13 | PP3后接豆底板 | 46×63.285 | 1片 | 水平33，落差54；不是长度33的斜板
H13 | PP3后接豆挡边 | 63.285×18 | 2片 | 沿斜面两边焊；豆路焊筋修平
H20 | PP2镜头防撞挡板 | 60×55 | 1片 | X80–140/Y145/Z110–165，先实豆验证不反弹
H34 | PP3下相机载板 | 60×40；中央孔/孔距实配 | 1片 | X80/Y96.5/Z111.5候选；非放行孔位图
H13 | PP3挡片/旗片 | 46×18 / 30×16 | 各1 | 沿用轻侧摆；旗片不能遮挡上摄ROI
H07/H08 | 灯带/铝槽 | 100有效长 | 4段 | 切点、底灯摆角、散热实配
