koffja/Beanlens/docs/hardware/hackathon-h3/cut-list-h3.xlsx

id | part | material | size_mm | qty | note
H14 | 立柱 | 黑2020 | 460 | 4 | 7根460中的4根不切
H14 | 宽梁 | 黑2020 | 180 | 4 | 3根460各取200+180；1根400取200+180，留锯缝
H14 | 深梁 | 黑2020 | 200 | 4 | 另一根400整根备用；无需新订型材
H16 | 底/工作台 | 海洋板6 | 176×196 | 2 | 工作台开60×60孔，相对板左前角58/68
H16 | BOX前承板 | 海洋板6 | 176×88 | 1 | 第三片176×196裁出；竖装，不深入料斗
H16 | 相机横条 | 海洋板6 | 176×30 | 2 | 与88板从第三片裁，三道3mm锯缝计157<196
H13/H39 | 顶环 | PP3 | 176×196 | 1 | 孔80×80，相对左前角48/58；底Z440
H13 | 闸盒后承托片 | PP3 | 176×50 | 1 | 全局X22/Y165/Z318，后立柱两端角片承托；前15mm托住闸盒后段
H13 | 导向盖 | PP3 | 50×85 | 2 | 孔18×14，相对左前角16/18；上下孔重合
H13/H38 | 间隔条 | PP2+PET0.3 | 10×85 | 2 | 组合厚2.3；PP/PET不焊
H36 | 铝闸片 | 6061-T6 2 | 29.4×82 | 1 | 球头孔中心：横中14.7，距前缘76；去毛刺
H13 | 上斗侧壁毛坯 | PP2 | 100×100 | 4 | 内表面理论前后梯形80/18/斜高95.86，左右80/14/95.19；毛坯须纸样补角缝，不能按理论线直接裁终件
H13 | 下斗侧壁毛坯 | PP2 | 75×70 | 4 | 内表面理论梯形64/30/斜高62.36；留外焊与包边修配余量
H13 | 短管/前封板/固定耳 | PP2余料 | 按剖面实配 | 1 | 18×14内孔；上管Z329.3–350，下管Z300–321；外封前壁Y93–95
H18/H34 | 相机载板毛坯 | PP3 | 60×60 | 2 | 镜头/PCB开孔按模组，不能用占位40方推孔距
