koffja/Beanlens/docs/hardware/assembly-v4.12/cut-list-v4.12.csv

零件号 | BOM | 材料 | 尺寸mm | 数量 | 状态
T01 | F01 | 黑色欧标2020 | 20×20×460 | 1 | 保留V4.8骨架
T02 | F01 | 黑色欧标2020 | 20×20×460 | 1 | 保留V4.8骨架
T03 | F01 | 黑色欧标2020 | 20×20×460 | 1 | 保留V4.8骨架
T04 | F01 | 黑色欧标2020 | 20×20×460 | 1 | 保留V4.8骨架
T05 | F01 | 黑色欧标2020 | 20×20×180 | 1 | 保留V4.8骨架
T06 | F01 | 黑色欧标2020 | 20×20×180 | 1 | 保留V4.8骨架
T07 | F01 | 黑色欧标2020 | 20×20×200 | 1 | 保留V4.8骨架
T08 | F01 | 黑色欧标2020 | 20×20×200 | 1 | 保留V4.8骨架
T09 | F01 | 黑色欧标2020 | 20×20×180 | 1 | 保留V4.8骨架
T10 | F01 | 黑色欧标2020 | 20×20×180 | 1 | 保留V4.8骨架
T11 | F01 | 黑色欧标2020 | 20×20×200 | 1 | 保留V4.8骨架
T12 | F01 | 黑色欧标2020 | 20×20×200 | 1 | 保留V4.8骨架
T13 | F01 | 黑色欧标2020 | 20×20×200 | 1 | 保留V4.8骨架
T14 | F01 | 黑色欧标2020 | 20×20×200 | 1 | 保留V4.8骨架
T15 | F01 | 黑色欧标2020 | 20×20×180 | 1 | 保留V4.8骨架
T16 | F01 | 黑色欧标2020 | 20×20×180 | 1 | 保留V4.8骨架
T17 | F01 | 黑色欧标2020 | 20×20×180 | 1 | 保留V4.8骨架
T18 | F01 | 黑色欧标2020 | 20×20×180 | 1 | 保留V4.8骨架
P05 | F03 | 6mm海洋板 | 196×280×6 | 1 | 保留外壳净尺寸；孔位先实配
P03 | F03 | 6mm海洋板 | 196×112×6 | 1 | 保留外壳净尺寸；孔位先实配
P06 | F03 | 6mm海洋板 | 196×280×6 | 1 | 保留外壳净尺寸；孔位先实配
P04 | F03 | 6mm海洋板 | 196×112×6 | 1 | 保留外壳净尺寸；孔位先实配
P08 | F03 | 6mm海洋板 | 176×197×6 | 1 | 保留外壳净尺寸；孔位先实配
P02 | F03 | 6mm海洋板 | 176×112×6 | 1 | 保留外壳净尺寸；孔位先实配
P07 | F03 | 6mm海洋板 | 176×58×6 | 1 | 保留外壳净尺寸；孔位先实配
P01 | F03 | 6mm海洋板 | 176×112×6 | 1 | 保留外壳净尺寸；孔位先实配
P09 | F03 | 6mm海洋板 | 176×58×6 | 1 | 保留外壳净尺寸；孔位先实配
