koffja/Beanlens/docs/hardware/hackathon-h1/realistic/preview-parts.png

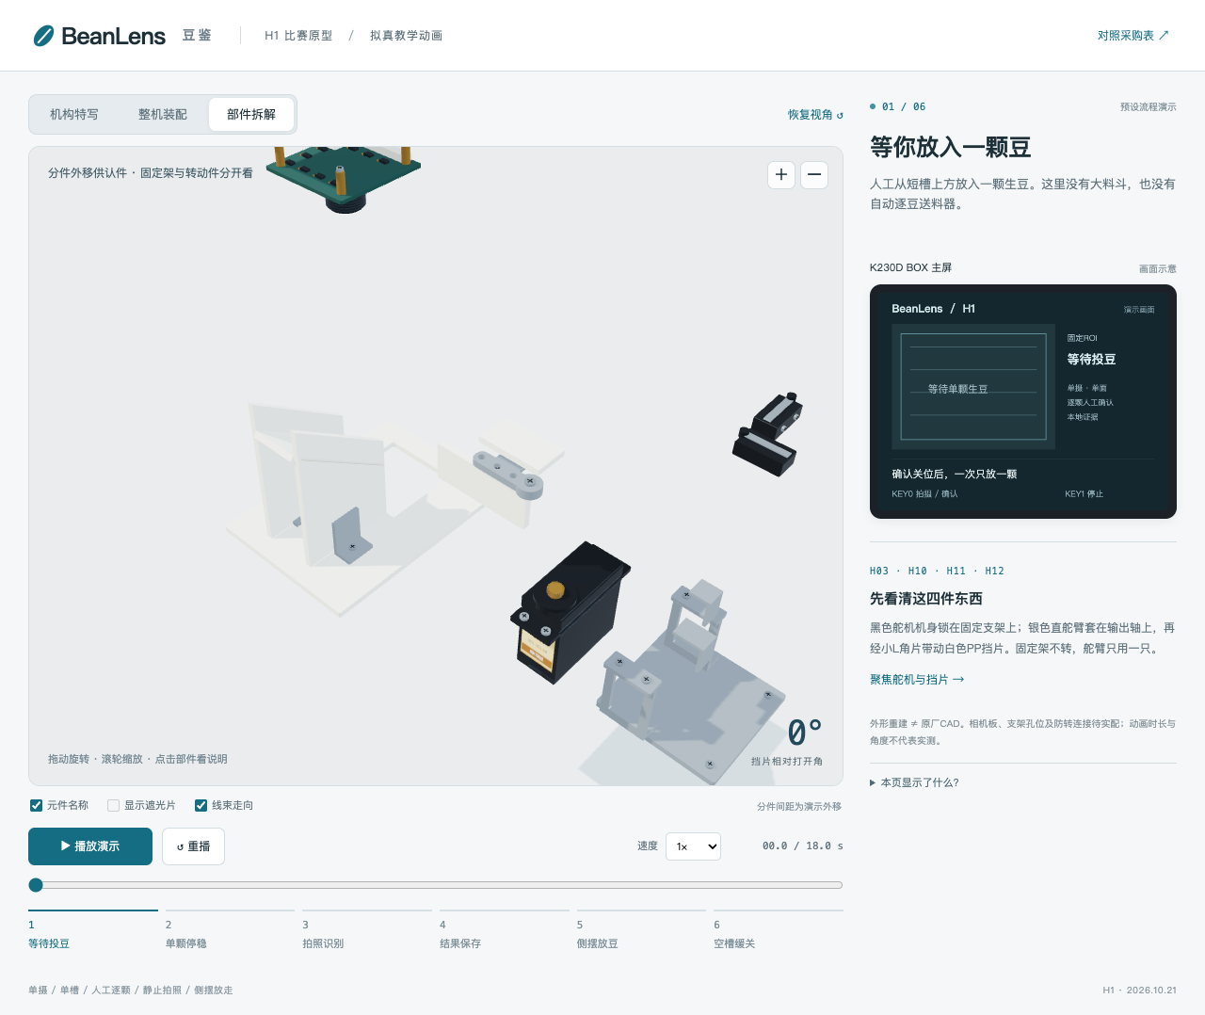
docs/hardware/hackathon-h1/realistic/preview-parts.png
