koffja/Beanlens/docs/hardware/hackathon-h2/realistic/preview-parts.png

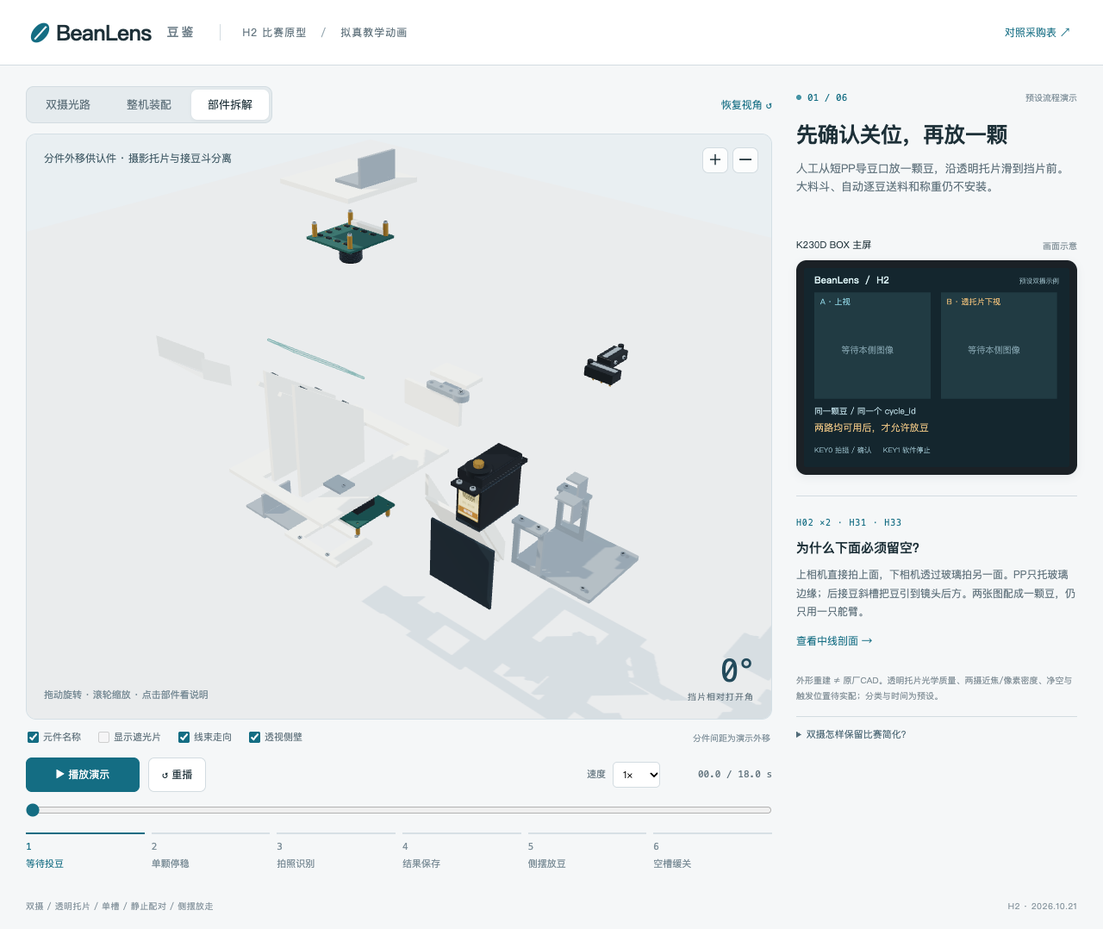
docs/hardware/hackathon-h2/realistic/preview-parts.png
