koffja/Beanlens/docs/hardware/hackathon-h3/realistic/preview-parts.png

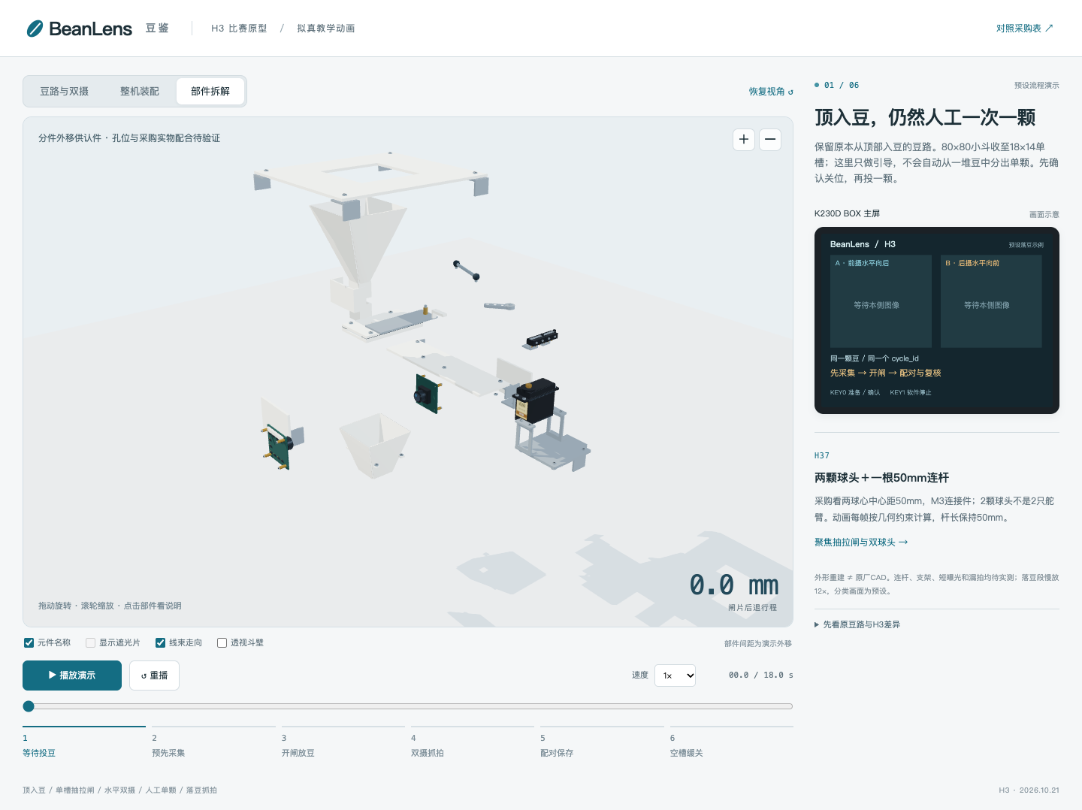
docs/hardware/hackathon-h3/realistic/preview-parts.png
