koffja/Beanlens/docs/hardware/hackathon-h3/assembly-p4/assembly-p4-reference-NOT-FOR-PRINT.step

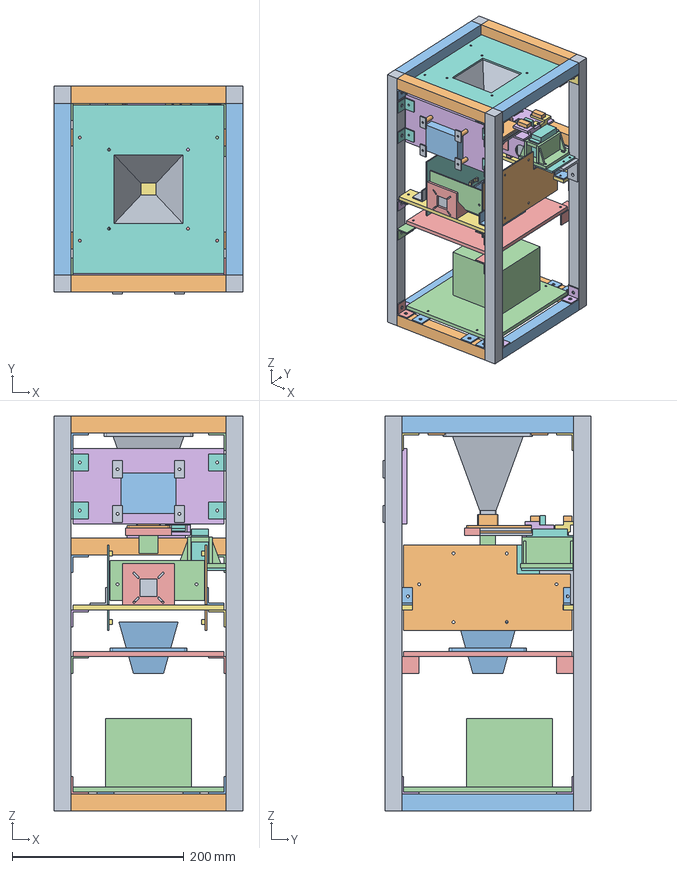
[picture p61: CAD file, 2026-10-23]
docs/hardware/hackathon-h3/assembly-p4/assembly-p4-reference-NOT-FOR-PRINT.step
220.0 x 242.0 x 460.0 mm
P11
P12
P13
P21
P22
P23
P24
P25
P26
T01
T02
T03
T04
T05
T06
T07
T08
T09
T10
T11
T12
P28
W01
W02
W03
W04
W05
C01
C02
C03
C04
C04_PET
C05
C05_PET
C06
C07
P30
H36
P27
H10
F01
F02
F03
F04
F05
F06
F07
F08
A01
A02
A03
A04
A05
A06
A07
A08
A09
A10
A11
A12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
