koffja/Beanlens/docs/hardware/hackathon-h3/printing-p1/assembly-reference-only.step

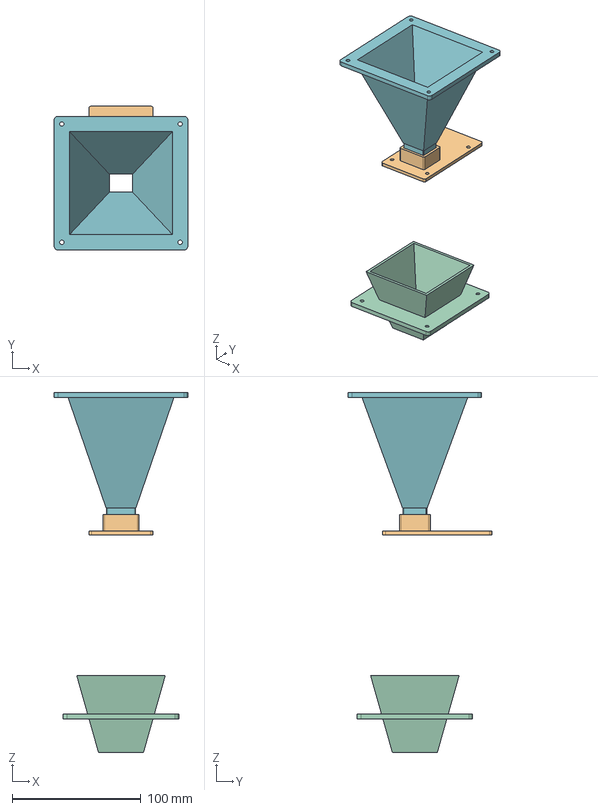
[picture p62: CAD file, 2026-10-23]
docs/hardware/hackathon-h3/printing-p1/assembly-reference-only.step
104.0 x 112.0 x 280.0 mm
upper-hopper-mm
upper-adapter-mm
lower-collector-mm
