koffja/Beanlens/docs/hardware/hackathon-h3/printing-p2/assembly-reference-only.step

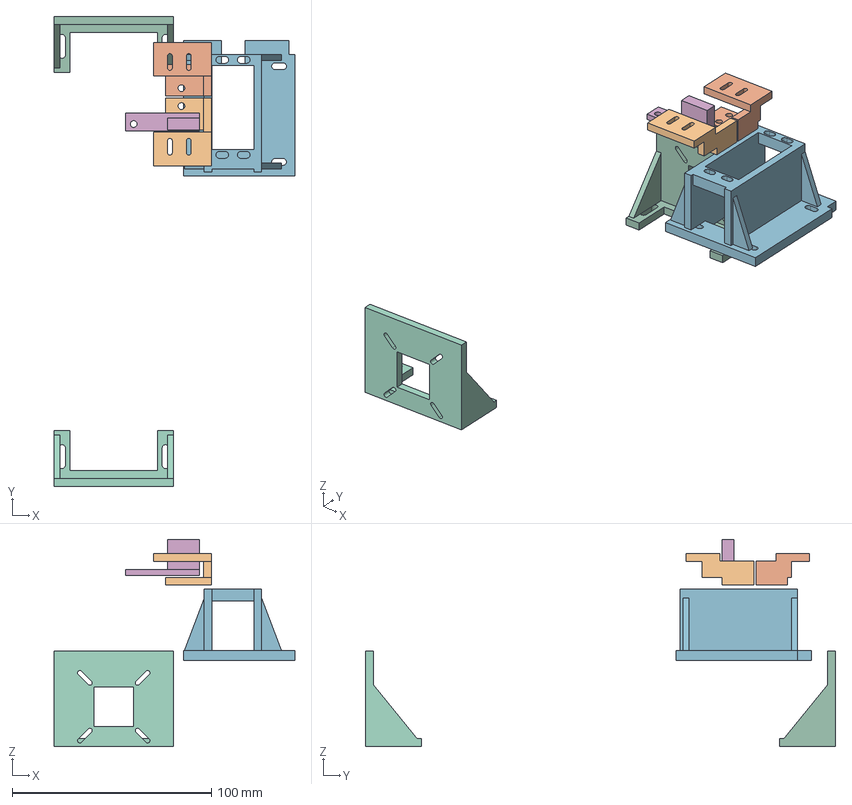
[picture p63: CAD file, 2026-10-23]
docs/hardware/hackathon-h3/printing-p2/assembly-reference-only.step
121.0 x 236.0 x 104.0 mm
servo-cradle-mm
camera-front-mm
camera-rear-mm
limit-closed-seat-mm
limit-open-seat-mm
gate-limit-flag-mm
