koffja/Beanlens/docs/hardware/hackathon-h3/printing-p2/assembly-with-references-NOT-FOR-PRINT.step

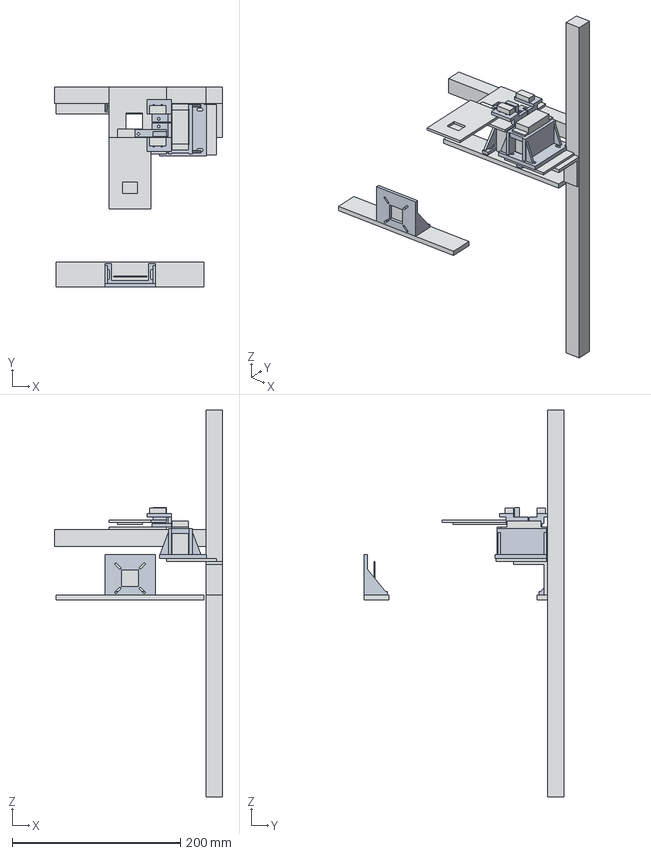
[picture p64: CAD file, 2026-10-23]
docs/hardware/hackathon-h3/printing-p2/assembly-with-references-NOT-FOR-PRINT.step
200.0 x 238.0 x 460.0 mm
servo-cradle-mm
camera-front-mm
camera-rear-mm
limit-closed-seat-mm
limit-open-seat-mm
gate-limit-flag-mm
servo-case-reference
aluminum-base-reference
metal-angle-reference
rear-crossbeam-reference
carrier-PP3-reference
rear-right-upright-reference
front-wood-reference
rear-wood-reference
gate-guide-reference
gate-reference
camera-A-PCB-reference
camera-B-PCB-reference
limit-closed-case-reference
limit-open-case-reference
