koffja/Beanlens/docs/hardware/fabrication-v4.8/TA1.stl

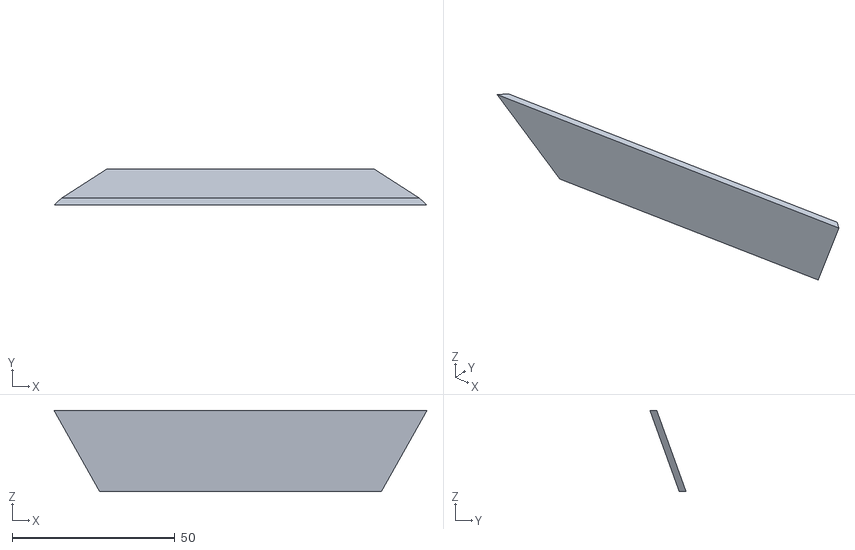
[picture p65: CAD file, 2026-10-17]
docs/hardware/fabrication-v4.8/TA1.stl
114.6 x 11.1 x 24.9
