koffja/Beanlens/docs/hardware/hackathon-h3/printing-bambu-p3/jobs/A1/03-lower-collector.gcode.3mf

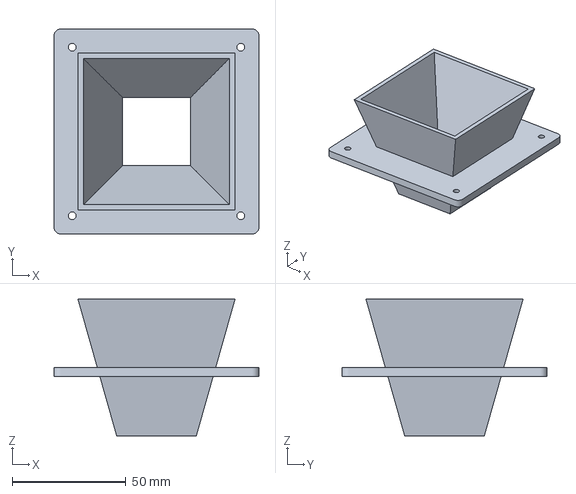
[picture p66: CAD file, 2026-10-23]
docs/hardware/hackathon-h3/printing-bambu-p3/jobs/A1/03-lower-collector.gcode.3mf
90.0 x 90.0 x 60.0 mm
