koffja/Beanlens/docs/hardware/hackathon-h3/printing-bambu-p3/jobs/P2S/01-upper-hopper.gcode.3mf

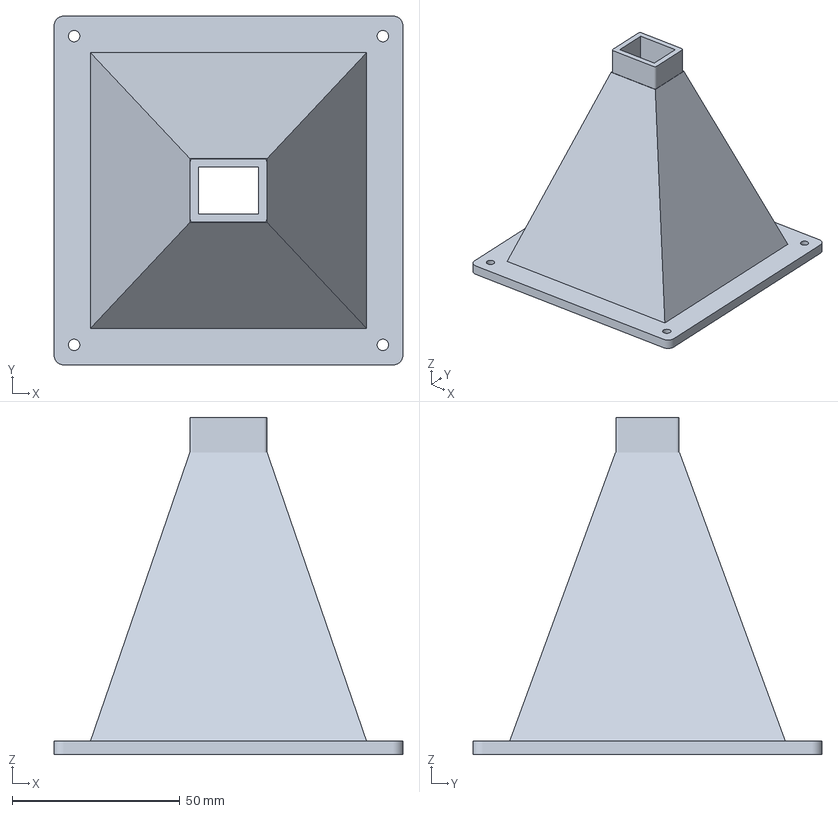
[picture p67: CAD file, 2026-10-23]
docs/hardware/hackathon-h3/printing-bambu-p3/jobs/P2S/01-upper-hopper.gcode.3mf
104.0 x 104.0 x 100.5 mm
