koffja/Beanlens/docs/hardware/hackathon-h3/printing-bambu-p3/jobs/X2D/00-fit-tests.gcode.3mf

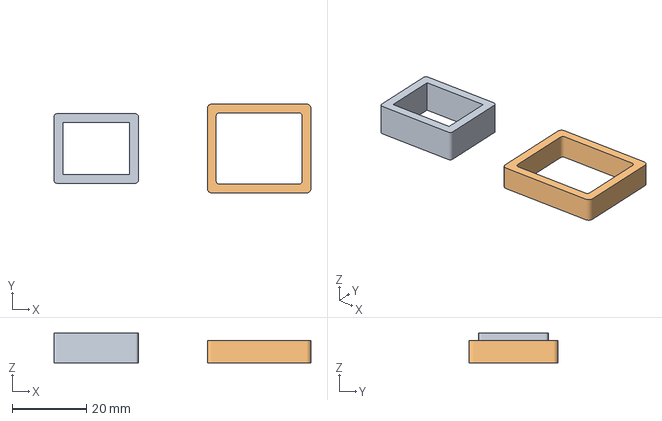
[picture p68: CAD file, 2026-10-23]
docs/hardware/hackathon-h3/printing-bambu-p3/jobs/X2D/00-fit-tests.gcode.3mf
69.4 x 24.0 x 8.00 mm
test-male-mm.stl
test-socket-mm.stl
