koffja/Beanlens/docs/hardware/hackathon-h3/printing-bambu-p3/models/00-fit-tests/test-male-mm.stl

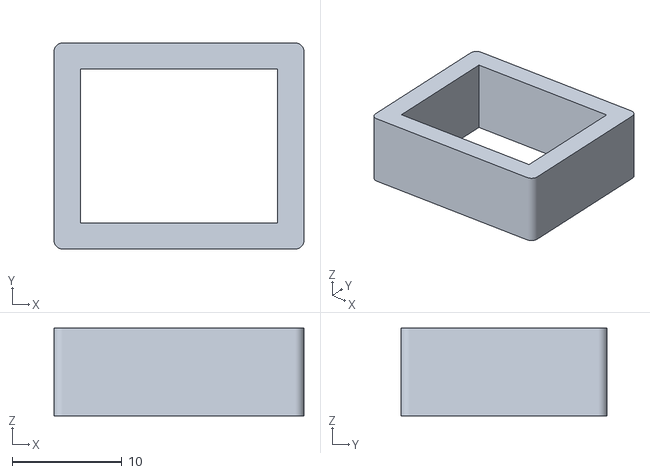
[picture p69: CAD file, 2026-10-23]
docs/hardware/hackathon-h3/printing-bambu-p3/models/00-fit-tests/test-male-mm.stl
22.8 x 18.8 x 8.00
