koffja/Beanlens/docs/hardware/hackathon-h3/printing-bambu-p3/models/02-adapter-and-cameras/camera-rear-mm.stl

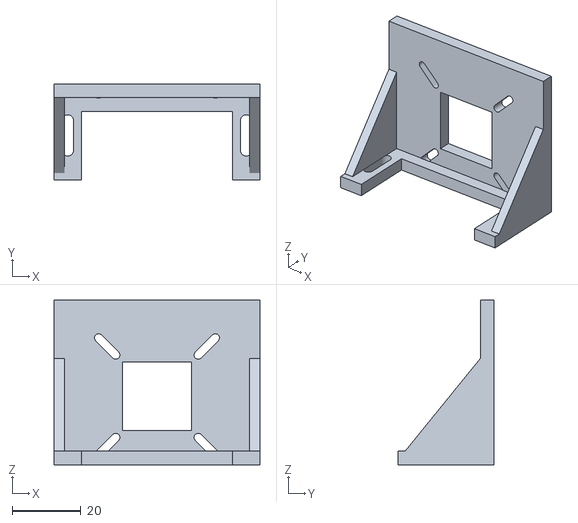
[picture p70: CAD file, 2026-10-23]
docs/hardware/hackathon-h3/printing-bambu-p3/models/02-adapter-and-cameras/camera-rear-mm.stl
60.0 x 28.0 x 48.0
