koffja/Beanlens/docs/hardware/hackathon-h3/printing-bambu-p3/models/04-servo-cradle/servo-cradle-mm.stl

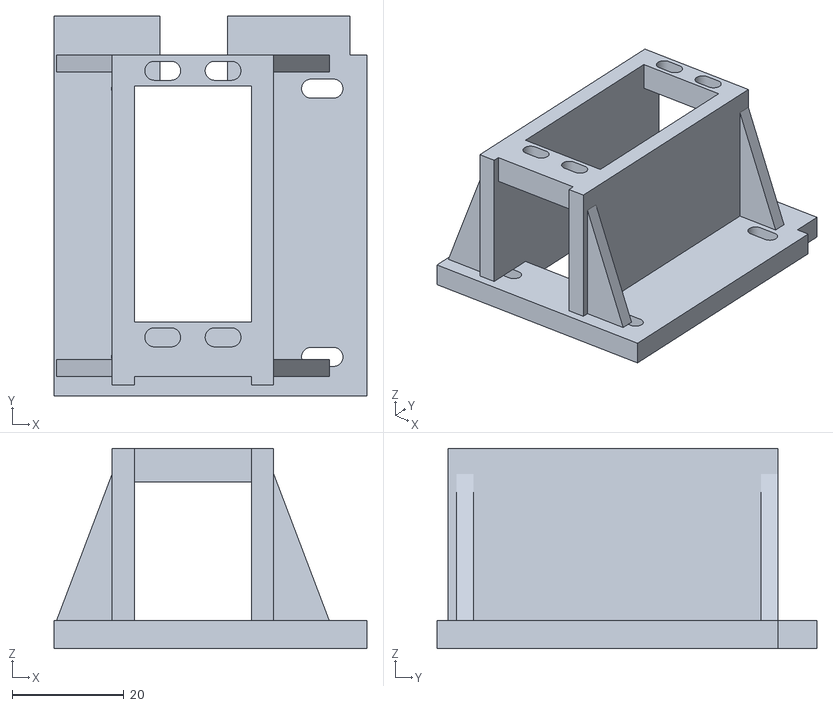
[picture p71: CAD file, 2026-10-23]
docs/hardware/hackathon-h3/printing-bambu-p3/models/04-servo-cradle/servo-cradle-mm.stl
56.0 x 68.0 x 35.8
