koffja/Beanlens/docs/hardware/hackathon-h3/printing-bambu-p3/models/05-limits-and-flag/limit-closed-seat-mm.stl

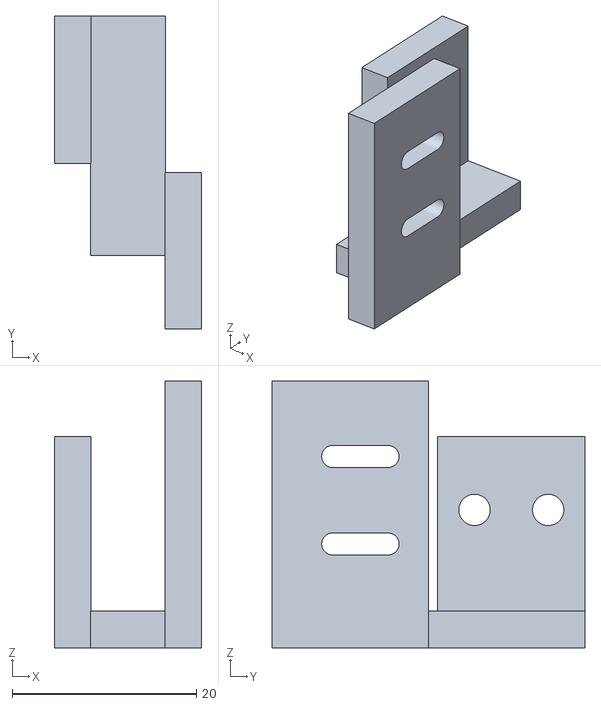
[picture p72: CAD file, 2026-10-23]
docs/hardware/hackathon-h3/printing-bambu-p3/models/05-limits-and-flag/limit-closed-seat-mm.stl
16.0 x 34.0 x 29.0
