koffja/Beanlens/docs/hardware/hackathon-h3/printing-p1/BeanLens-H3-P1/fit-tests/test-socket-mm.step

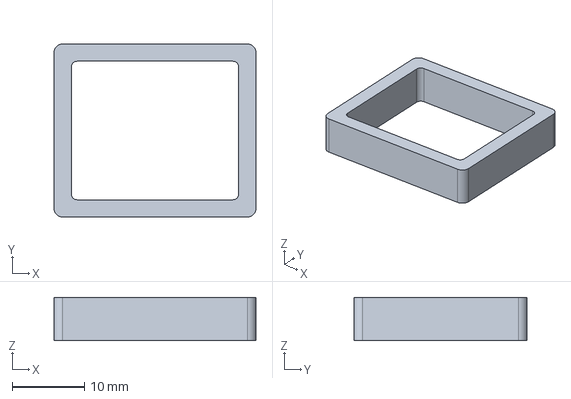
[picture p73: CAD file, 2026-10-23]
docs/hardware/hackathon-h3/printing-p1/BeanLens-H3-P1/fit-tests/test-socket-mm.step
28.0 x 24.0 x 6.00 mm
