koffja/Beanlens/docs/hardware/hackathon-h3/printing-p1/parts/upper-adapter-mm.step

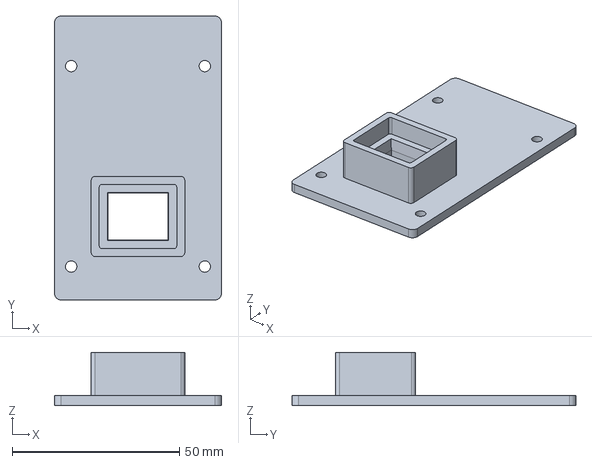
[picture p74: CAD file, 2026-10-23]
docs/hardware/hackathon-h3/printing-p1/parts/upper-adapter-mm.step
50.0 x 85.0 x 16.0 mm
