koffja/Beanlens/docs/hardware/fabrication-v4.8/MA1.stl

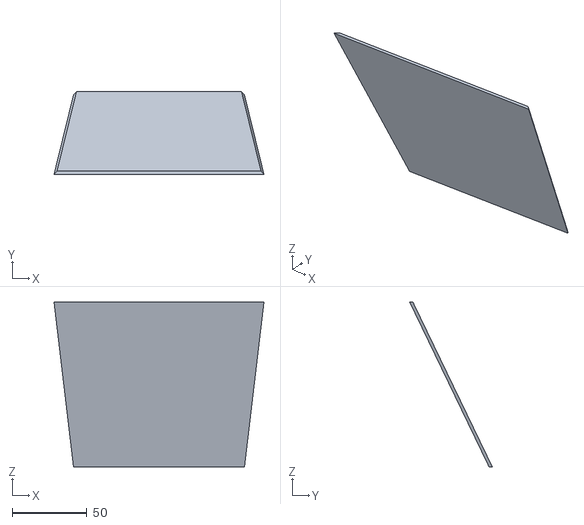
[picture p75: CAD file, 2026-10-17]
docs/hardware/fabrication-v4.8/MA1.stl
140.0 x 55.2 x 110.0
