koffja/Beanlens/docs/hardware/hackathon-h3/printing-bambu-p3/jobs/P2S/05-limits-and-flag.gcode.3mf

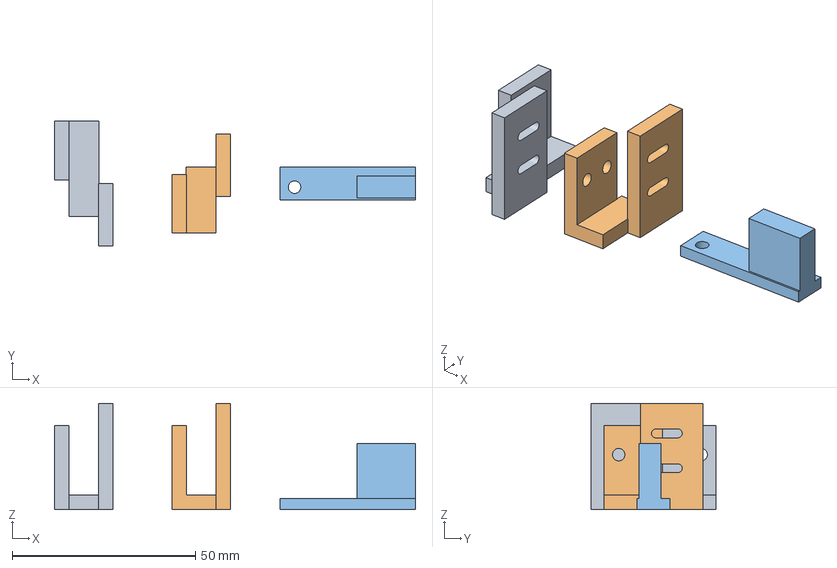
[picture p76: CAD file, 2026-10-23]
docs/hardware/hackathon-h3/printing-bambu-p3/jobs/P2S/05-limits-and-flag.gcode.3mf
98.5 x 34.0 x 29.0 mm
limit-closed-seat-mm.stl
limit-open-seat-mm.stl
gate-limit-flag-mm.stl
