koffja/Beanlens/docs/hardware/hackathon-h3/printing-bambu-p3/jobs/X1C/02-adapter-and-cameras.gcode.3mf

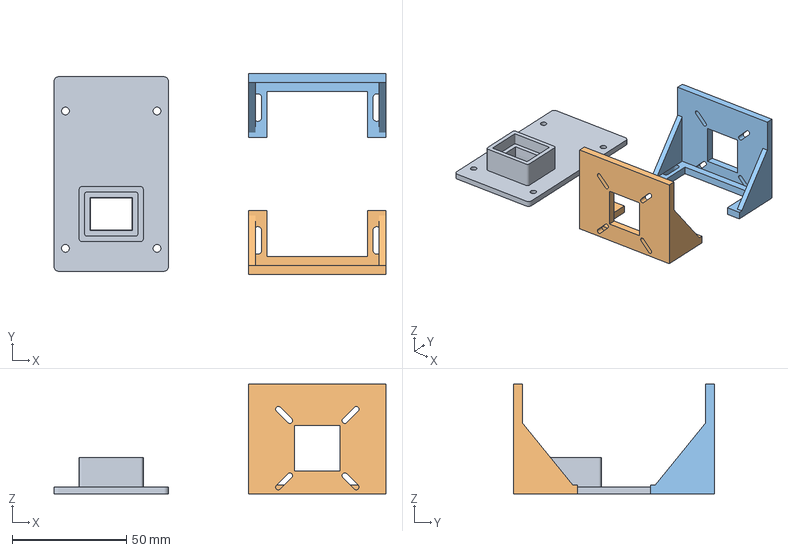
[picture p77: CAD file, 2026-10-23]
docs/hardware/hackathon-h3/printing-bambu-p3/jobs/X1C/02-adapter-and-cameras.gcode.3mf
145.0 x 88.0 x 48.0 mm
upper-adapter-mm.stl
camera-front-mm.stl
camera-rear-mm.stl
