koffja/Beanlens/docs/hardware/hackathon-h3/printing-bambu-p3/models/05-limits-and-flag/limit-open-seat-mm.stl

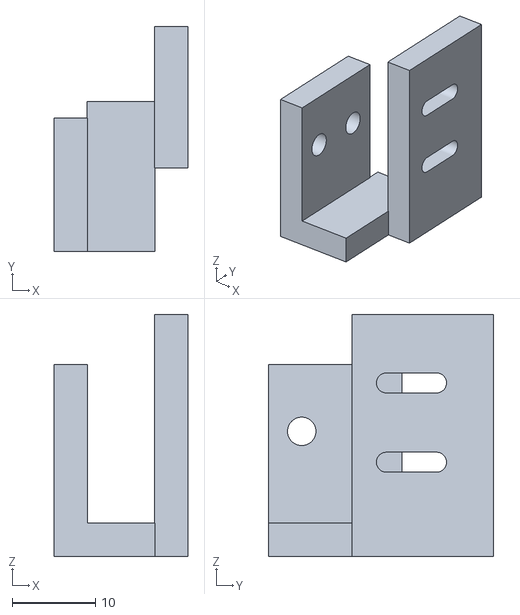
[picture p78: CAD file, 2026-10-23]
docs/hardware/hackathon-h3/printing-bambu-p3/models/05-limits-and-flag/limit-open-seat-mm.stl
16.0 x 27.0 x 29.0
