koffja/Beanlens/docs/hardware/fabrication-v4.8/TB2.stl

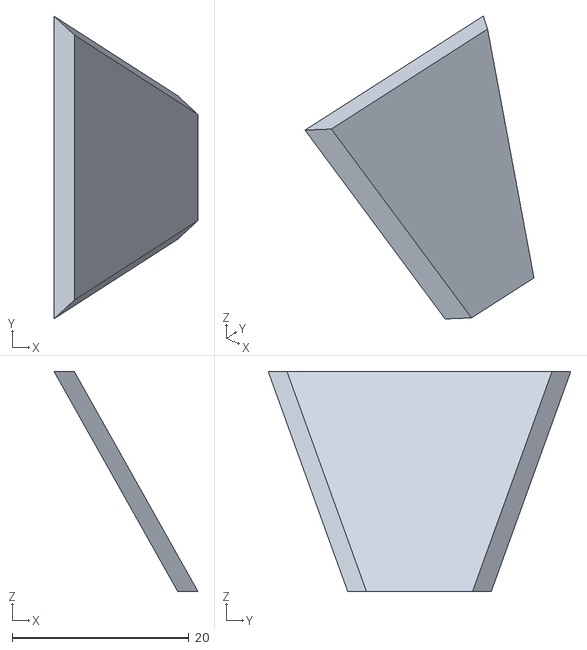
[picture p79: CAD file, 2026-10-17]
docs/hardware/fabrication-v4.8/TB2.stl
16.3 x 34.3 x 24.9
