koffja/Beanlens/docs/hardware/hackathon-h3/printing-bambu-p3/models/05-limits-and-flag/gate-limit-flag-mm.stl

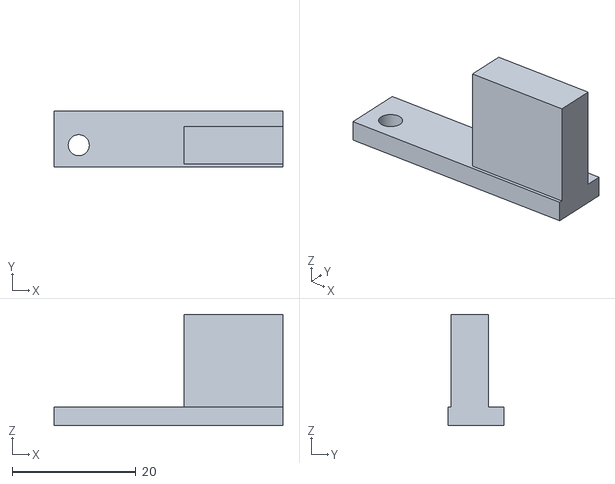
[picture p80: CAD file, 2026-10-23]
docs/hardware/hackathon-h3/printing-bambu-p3/models/05-limits-and-flag/gate-limit-flag-mm.stl
37.0 x 9.00 x 18.0
