koffja/Beanlens/docs/hardware/fabrication-v4.8/MB2.stl

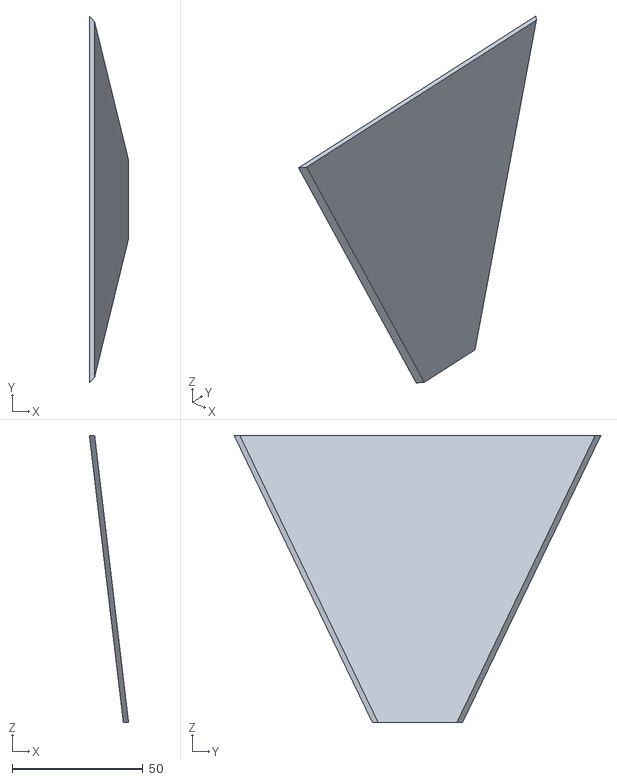
[picture p81: CAD file, 2026-10-17]
docs/hardware/fabrication-v4.8/MB2.stl
15.0 x 140.4 x 110.0
