koffja/Beanlens/(list of files, cad)

Other CAD files:
docs/hardware/hackathon-h3/printing-bambu-p3/jobs/H2D/03-lower-collector.gcode.3mf
docs/hardware/hackathon-h3/printing-bambu-p3/jobs/X1C/01-upper-hopper.gcode.3mf
docs/hardware/hackathon-h3/printing-bambu-p3/models/01-upper-hopper/upper-hopper-mm.stl
docs/hardware/hackathon-h3/printing-bambu-p3/models/03-lower-collector/lower-collector-mm.stl
docs/hardware/hackathon-h3/printing-p1/BeanLens-H3-P1/parts/lower-collector-mm.step
docs/hardware/hackathon-h3/printing-p1/fit-tests/test-male-mm.step
docs/hardware/hackathon-h3/printing-p2/parts/servo-cradle-mm.step
docs/hardware/hackathon-h3/printing-bambu-p3/jobs/A1/04-servo-cradle.gcode.3mf
docs/hardware/hackathon-h3/printing-bambu-p3/jobs/H2D/04-servo-cradle.gcode.3mf
docs/hardware/hackathon-h3/printing-bambu-p3/jobs/X2D/02-adapter-and-cameras.gcode.3mf
docs/hardware/hackathon-h3/printing-bambu-p3/models/00-fit-tests/test-socket-mm.stl
docs/hardware/hackathon-h3/printing-bambu-p3/models/02-adapter-and-cameras/camera-front-mm.stl
docs/hardware/hackathon-h3/printing-p1/BeanLens-H3-P1/fit-tests/test-male-mm.step
docs/hardware/hackathon-h3/printing-p1/parts/lower-collector-mm.step
docs/hardware/hackathon-h3/printing-p2/parts/camera-front-mm.step
docs/hardware/hackathon-h3/printing-bambu-p3/jobs/A1/01-upper-hopper.gcode.3mf
docs/hardware/hackathon-h3/printing-bambu-p3/jobs/H2D/00-fit-tests.gcode.3mf
docs/hardware/hackathon-h3/printing-bambu-p3/jobs/P2S/00-fit-tests.gcode.3mf
docs/hardware/hackathon-h3/printing-bambu-p3/jobs/X1C/05-limits-and-flag.gcode.3mf
docs/hardware/hackathon-h3/printing-bambu-p3/jobs/X2D/05-limits-and-flag.gcode.3mf
docs/hardware/hackathon-h3/printing-bambu-p3/models/02-adapter-and-cameras/upper-adapter-mm.stl
docs/hardware/hackathon-h3/printing-p1/BeanLens-H3-P1/parts/upper-hopper-mm.step
docs/hardware/hackathon-h3/printing-p1/parts/upper-hopper-mm.step
docs/hardware/hackathon-h3/printing-p2/parts/camera-rear-mm.step
docs/hardware/fabrication-v4.8/MA2.stl
docs/hardware/hackathon-h3/printing-bambu-p3/jobs/A1/02-adapter-and-cameras.gcode.3mf
docs/hardware/hackathon-h3/printing-bambu-p3/jobs/H2D/05-limits-and-flag.gcode.3mf
docs/hardware/hackathon-h3/printing-bambu-p3/jobs/P2S/02-adapter-and-cameras.gcode.3mf
docs/hardware/hackathon-h3/printing-bambu-p3/jobs/X1C/04-servo-cradle.gcode.3mf
docs/hardware/hackathon-h3/printing-bambu-p3/jobs/X2D/01-upper-hopper.gcode.3mf
docs/hardware/hackathon-h3/printing-p2/parts/limit-closed-seat-mm.step
docs/hardware/fabrication-v4.8/TA2.stl
docs/hardware/hackathon-h3/printing-bambu-p3/jobs/A1/05-limits-and-flag.gcode.3mf
docs/hardware/hackathon-h3/printing-bambu-p3/jobs/H2D/02-adapter-and-cameras.gcode.3mf
docs/hardware/hackathon-h3/printing-bambu-p3/jobs/P2S/03-lower-collector.gcode.3mf
docs/hardware/hackathon-h3/printing-bambu-p3/jobs/X1C/00-fit-tests.gcode.3mf
docs/hardware/hackathon-h3/printing-bambu-p3/jobs/X2D/03-lower-collector.gcode.3mf
docs/hardware/hackathon-h3/printing-p2/parts/limit-open-seat-mm.step
docs/hardware/hackathon-h3/printing-bambu-p3/jobs/A1/00-fit-tests.gcode.3mf
docs/hardware/hackathon-h3/printing-bambu-p3/jobs/H2D/01-upper-hopper.gcode.3mf
docs/hardware/hackathon-h3/printing-bambu-p3/jobs/P2S/04-servo-cradle.gcode.3mf
docs/hardware/hackathon-h3/printing-bambu-p3/jobs/X1C/03-lower-collector.gcode.3mf
docs/hardware/hackathon-h3/printing-bambu-p3/jobs/X2D/04-servo-cradle.gcode.3mf
docs/hardware/hackathon-h3/printing-p2/parts/gate-limit-flag-mm.step
docs/hardware/fabrication-v4.8/TB1.stl
docs/hardware/fabrication-v4.8/MB1.stl
docs/hardware/hackathon-h3/printing-p1/BeanLens-H3-P1/fit-tests/test-male-mm.3mf
docs/hardware/hackathon-h3/printing-p1/BeanLens-H3-P1/fit-tests/test-male-mm.stl
docs/hardware/hackathon-h3/printing-p1/BeanLens-H3-P1/fit-tests/test-socket-mm.3mf
docs/hardware/hackathon-h3/printing-p1/BeanLens-H3-P1/fit-tests/test-socket-mm.stl
docs/hardware/hackathon-h3/printing-p1/BeanLens-H3-P1/parts/lower-collector-mm.3mf
docs/hardware/hackathon-h3/printing-p1/BeanLens-H3-P1/parts/lower-collector-mm.stl
docs/hardware/hackathon-h3/printing-p1/BeanLens-H3-P1/parts/upper-adapter-mm.3mf
docs/hardware/hackathon-h3/printing-p1/BeanLens-H3-P1/parts/upper-adapter-mm.stl
docs/hardware/hackathon-h3/printing-p1/BeanLens-H3-P1/parts/upper-hopper-mm.3mf
docs/hardware/hackathon-h3/printing-p1/BeanLens-H3-P1/parts/upper-hopper-mm.stl
docs/hardware/hackathon-h3/printing-p1/fit-tests/test-male-mm.3mf
docs/hardware/hackathon-h3/printing-p1/fit-tests/test-male-mm.stl
docs/hardware/hackathon-h3/printing-p1/fit-tests/test-socket-mm.3mf
docs/hardware/hackathon-h3/printing-p1/fit-tests/test-socket-mm.stl
docs/hardware/hackathon-h3/printing-p1/parts/lower-collector-mm.3mf
docs/hardware/hackathon-h3/printing-p1/parts/lower-collector-mm.stl
docs/hardware/hackathon-h3/printing-p1/parts/upper-adapter-mm.3mf
docs/hardware/hackathon-h3/printing-p1/parts/upper-adapter-mm.stl
docs/hardware/hackathon-h3/printing-p1/parts/upper-hopper-mm.3mf
docs/hardware/hackathon-h3/printing-p1/parts/upper-hopper-mm.stl
docs/hardware/hackathon-h3/printing-p2/parts/camera-front-mm.3mf
docs/hardware/hackathon-h3/printing-p2/parts/camera-front-mm.stl
docs/hardware/hackathon-h3/printing-p2/parts/camera-rear-mm.3mf
docs/hardware/hackathon-h3/printing-p2/parts/camera-rear-mm.stl
docs/hardware/hackathon-h3/printing-p2/parts/gate-limit-flag-mm.3mf
docs/hardware/hackathon-h3/printing-p2/parts/gate-limit-flag-mm.stl
docs/hardware/hackathon-h3/printing-p2/parts/limit-closed-seat-mm.3mf
docs/hardware/hackathon-h3/printing-p2/parts/limit-closed-seat-mm.stl
docs/hardware/hackathon-h3/printing-p2/parts/limit-open-seat-mm.3mf
docs/hardware/hackathon-h3/printing-p2/parts/limit-open-seat-mm.stl
docs/hardware/hackathon-h3/printing-p2/parts/servo-cradle-mm.3mf
docs/hardware/hackathon-h3/printing-p2/parts/servo-cradle-mm.stl
