koffja/Beanlens/docs/hardware/hackathon-h3/assembly-p4/README.md

# H3-P4：9件打印件整合后的整机装配

2026-10-22。用户要求把P1漏斗、P2支架整合进最新整机组装／爆炸图，并同步BOM，看清打印件、铝板、海洋板与黑2020具体怎么连接。

**当前机械装配以本P4为准。**旧H3 PP焊接版、P1/P2原CAD和P3已切片文件均保留。**9件打印几何没有改变，无须因为P4重打或重新切片。**电气、候选GPIO与单颗落豆抓拍流程沿用H3，未修改固件或上板程序。

- [整机组装／爆炸／14处连接特写](beanlens-assembly-p4.html)
- [10页A3横向图册PDF](assembly-guide-p4.pdf)／[图册HTML](assembly-guide-p4.html)
- [完整78行BOM](bom-p4.html)／[全表CSV](bom-p4.csv)／[采购基准CSV](procurement-p4.csv)
- [紧固件总表](fasteners-p4.csv)／[裁切表](cut-list-p4.csv)／[孔位坐标CSV](hole-patterns-p4.csv)
- [机械装配STEP，仅供参考，不能整机打印](assembly-p4-reference-NOT-FOR-PRINT.step)
- [P3拓竹打印总览](../printing-bambu-p3/index.html)／[P3原打印ZIP](../printing-bambu-p3/BeanLens-H3-Bambu-P3-20261022.zip)

这是**比赛H3单槽机架**，5件海洋板为底板、工作台、屏承板及前后相机木横条；不是完整版带三面整高木壳的外观版。所有打印件、木板、型材在图中使用同一比例；爆炸时只按方向外移，不缩放。透明遮光片只是方便观察，实物为黑PP。

## 怎样看图

1. 先看“整机组装”：青色为9件打印件，木色为海洋板，黑色槽形件为2020，银色为铝板／角码，浅色为PP，金色为紧固件。
2. 点“整机爆炸”认件。右侧选J01–J14的一处连接，就会只保留相关零件，显示螺丝规格和穿过顺序。
3. 拖“拆开程度”查看贴合面；点击部件查编号与BOM。材质复选框可暂时隐藏木板、型材或遮光片；隐藏是看内部，不表示取消安装。
4. 纸样在`templates/`。按实际尺寸100%打印，量50mm标尺并贴合实物，再钻孔。侧片纸样建议A4横向；A3图册本身不是1:1模板。

## 本次必须同步采用的固定结构

| 部位 | P4安装方式 | 相对旧图的修订 |
| --- | --- | --- |
| 顶部PP环 | 4只40×20×2平片，一孔M5向上锁顶部深梁底槽，一孔M3穿PP环 | 不继续画无法贴合梁底的朝下角铝；顶环底仍Z440 |
| 底木板 | 4平片在底梁顶面，M5锁槽、M3穿板 | 避开框角角码，板底抬至Z22；孔改X60/160、Y30/210；杯底Z28 |
| 工作木台 | 4只20×20×2、宽40角铝；竖边锁立柱，横边穿木板 | 宽度40跨过内缩2mm的板角；底Z180不变 |
| 两相机木条 | 各2只20宽角铝托条，M5锁柱、M3穿板 | 顶面Z240不变，支架底脚与遮光角铝独立钻孔 |
| BOX承板 | 前面Y20，4只20宽侧角铝连前立柱 | 后移3mm避免角铝穿木板；4压片＋20mm绝缘通孔隔柱固定原壳 |
| 舵机 | P21架→P27铝板→40×40×4加强角码→右后柱前槽 | 沿用P2避让与轴高；不恢复旧MG金属机身架 |
| 闸盒后承托 | PP3 68×80、20×30窗，锁新增180后梁顶槽 | 沿用P2，不恢复旧176×50大承托片 |
| PP固定豆路 | 仅下短管与前U片；接座在上PP盖上 | 不装旧上PP连接管；前U片只贴盖外缘，侧翼不穿入打印接座 |
| 遮光及灯槽 | 侧黑PP片→角铝→木横条；灯槽用配套卡扣固定侧片 | 两端开木条避让槽；右侧、后背景分别给舵机留缺口 |

以上改变的是非打印支承件、板材孔位与安装位置。打印件P11/P12/P13来自P1，P21–P26来自P2，P3打印配置仍可继续用。若木板已按旧孔钻好，先对纸样评估新孔与旧孔剩余边距；边距不足则换板，不把孔强拉到位。

## 逐处装配

| 图号 | 承重或连接路径 | 螺丝与操作要点 |
| --- | --- | --- |
| J01 | 黑2020→两孔角码→黑2020 | 每框角2只，共16；每角码2颗M5×8候选；T螺母匹配欧标槽6，先松装找方 |
| J02 | 底木板6→平片2→底梁顶槽 | M3×16四套、M5×8四套；板底22，平片避开框角，不用旧底板孔 |
| J03 | 工作台6→40宽角铝→立柱 | M3×16四套、M5×8四套；角铝支承上面Z180，孔周不拧裂木板 |
| J04 | 相机木条6→20宽角铝→立柱 | M3×16四套、M5×8四套；前条Y2后条208，顶240 |
| J05 | PP顶环3→平片2→顶深梁底槽 | 环到片M3×12四套；片到梁M5×8四套。M3穿φ5.5孔须两侧φ9大平垫 |
| J06 | 打印上斗法兰4→PP环3 | M3×16四套，孔距92；法兰贴环下方。颈插接座，0.2轴向余隙；PETG不与PP热焊 |
| J07 | 后横梁180→角码→后立柱；承托片3→横梁顶槽 | 两只角码从H15备用中取；4颗M5×8，承托2颗M5×10；20×30窗口给移动螺母让位 |
| J08 | 接座3→上盖3→侧条2.3→下盖3→后承托3 | 前M3×20两套夹11.3，后M3×25两套夹14.3。螺钉在侧条中，不穿2mm铝闸片；先手推 |
| J09 | 舵机耳→打印架→3mm铝板→4mm加强角码→立柱 | 耳M3×16×4，底脚M3×12×4，铝板M3×12×2，柱M5×10×2；轴目标170/180/331 |
| J10 | PCB→8mm内内隔柱→4mm打印背板；4mm底脚→6mm木条 | 隔柱双摄8只；PCB侧M2×5，背板侧M2×8候选，各8只；底脚M3×16四套。不是一根长螺钉通穿隔柱 |
| J11 | SS-01GL→打印限位座→PP承托；旗片→铝闸片 | 座M3×12四套、开关M2×14四套、旗片M3×10一套。开关孔距9.5，不能硬塞M2.5；旗片装后手试不能绕螺钉转 |
| J12 | 打印下斗法兰4→工作木台6 | M3×16四套；四孔74距，法兰底Z186，内通道不留螺杆或支撑碎屑 |
| J13 | 原壳角压片2→20mm隔柱→木板6→侧角铝→柱槽 | 压片M3×35四套；板角M3×16四套；柱M5×8四套。螺钉在原壳外侧，不穿PCB；原壳边、KEY和接口先核 |
| J14 | 灯槽→配套卡扣→黑PP侧片→角铝→木横条 | 卡扣M3×10八套；侧片4角铝用M3×16四、M3×10四；背景4角铝用M3×10八。卡扣孔型按实物，不钻LED线路 |

**M5×8／×10均是当前2／3／4mm连接层的候选**，不能保证所有商家的T螺母通用。先用一只实际槽母试装，确认有足够螺纹啮合、螺钉不顶槽底、角码确实夹紧，再批量装。标准成品角码若比2mm厚，按实际厚度重新选长，不硬用图中的螺长。原厂型材／连接件的尺寸与适用螺钉也须成套匹配，可参考[米思米框架连接资料](https://uk.misumi-ec.com/files/images/products/docs/framingsupport.pdf)，不能把不同系列槽型当同一零件。

## PP、铝片与海洋板怎样加工

- PP3一片300×300可排顶环176×196、两盖50×85、后承托68×80；保留3mm切缝。PP2余料只做内18×14下短管与前U封口。先拆铝片和PET垫条，再外焊固定件，冷却修平后装导槽；不能焊死可拆盖板。
- 前U封口前片54×8.3×2，侧翼各16×8.3×2；侧翼放盖板两外侧X83/135，不放在盖板内部。前壁封闭不表示内侧一张薄板能无缝穿过闸缝；内焊筋、毛边与台阶仍要实豆核对。
- 角铝买20×20×2、1m候选原料。切4只宽40、16只宽20，共480净长＋约60锯缝，余约460。每类孔轴不同：穿木板的孔与锁柱的孔分别钻在两翼，不把水平孔图转错面。
- 平片可从20×2铝扁条500mm裁8只40长，另4只12长作BOX压片；总净长368，计12道3mm锯缝404，余96。成品40×20平连接片若孔距20、两φ5.5可替代8片，不与原料方案重复购买。
- 海洋板176×196×6原料共3片：2片作底／工作台；第3片裁88、30、30，三道3mm锯缝计157，余39。板边打磨，先按纸样核孔，不用螺钉把翘曲板强拉平。
- 黑PP2一片300×300可排两片196×100与两片110×47（背景片旋转摆右侧）。侧片两端木条槽10.5×6.4；右片后上去64×34；后背景右上去30×16。按模板先试套，再定灯槽卡扣孔。

## 型材与紧固件怎样下单

**不需新增型材。**4根460整根作柱；另外3根460各切200＋180；第一根400也切200＋180；第二根400切180作P28。按每刀3mm计算，余74×3、14×1、217×1，共453。旧H3是12段，本版是13段，新增后梁已含在180×5中。

BOM的“采购基准”是总需求／备件上限，不是要求重新买一套。套件已带的M5、T螺母、卡扣与隔柱先扣库存；`included_in`表示计入母项／原料，子件不重复下单。价格未知留空。

本版装机M3螺钉79颗、M5共60颗；M3大平垫158、防松螺母79；M5平垫与T螺母各60。相机另有M2×5／×8各8与8只隔柱，SS-01GL为M2×14四套。备件建议见紧固件CSV。球头杆套件、自带舵臂紧固螺钉与隔柱螺柱另按原H11/H12/H37，不能重复计算为两根连杆或两只舵臂。

## 验收顺序与边界

先按P3打印00试配片；相机PCB、MG996R耳孔先对P2纸样。空框找方 → 板材／承重片 → 打印斗／导向 → 舵机／连杆／限位 → 相机／照明／BOX → 机外电气。舵机6V断开时手推全行程约19.75，检查铝片、螺母、旗片与线束；只关开关／只开开关／中间都不触发需万用表实测。卡住先拆检，不持续加力；软件停止不称硬急停。

本轮检查覆盖固定实体互不重叠、9打印实体与原CAD一致、21个行程采样、移动紧固件窗口、两条中心光轴、BOM数量与浏览器交互。**未证明全视场、实物孔精度、真实限位触发、灯槽卡扣兼容、舵机承载、热变形或连续寿命。**所有购件外形、开关拨片、螺纹与线束仍是参考，接线沿用H3；GPIO、短曝光、双CSI和模型部署仍待实机验收。

STEP含打印件与固定结构，器件用包络参考；详细舵臂、连杆、灯槽外形在HTML中重建。不要把整机STEP或爆炸状态拿去打印。`assembly-data.json`为本版坐标源，`build_assembly.py`为集成CAD源，`build_bom.py`与`build_templates.py`同步资料；独立基线为`config/hardware-hackathon-h3-p4.json`。旧文件哈希见`previous-preserved.json`，未改训练`.venv`、固件、用户Excel或既有P3切片。
