koffja/Beanlens/docs/hardware/assembly-v4.12/beanlens-assembly-v4.12.html

BEANLENS / DIMENSIONED ASSEMBLY / 2026-10-17 · V4.12整机集成

# V4.12：整机装配、双屏与MVP接线

骨架220×240×460；料斗底Z298.3、顶Z440、高141.7。先用下方模型看装配关系，再看十二张尺寸图。点击零件或列表，读取BOM编号、规格和安装注意事项。

这是尺寸化装配提案，不是已验收加工图。实线标准件/板料按标注核对；元件占位与未定孔位明确标记。所有螺孔先按实物纸样确认。

## 先核对成品、裸框与料斗高度

相同投影与缩放的黑色2020成品/裸框，料斗高141.7

顶框承托法兰底440，主斗底298.3；斗高141.7到440；顶框440→460。虚线是连续料斗包络。

组装状态爆炸状态分解程度 0%显示 显示外壳面板显示接线净空显示机外配电只看双屏装配

选择一个部件

编号与BOM在此显示

模型用于看安装关系；切换外壳或部件分组时比例不变，真实螺孔按实物。

零件目录

前方是取豆方向，背面是低压电控检修区。组装模型使用简化包络；例如称重虚框不是HJ-AZ4实际外形。

当前内容V4.12整机集成与PP焊接；本版独立保存V4.12文件。V4.12共享设计数据，料斗高141.7、顶框悬挂、中框顶Z324；型材和木板裁切/BOM同步。无采购、加工、实物承载或电气验收。
