koffja/Beanlens/docs/hardware/assembly-v4.12/beanlens-operation-v4.12.html

BEANLENS / V4.12 / 2026-10-17

# 从开闸送料，到留下图像与批次记录

左侧看豆路和两块板的协作，右侧看闸片怎样由舵机带动。可逐步查看，也可播放完整批次。所有豆数、质量和时间均为教学示例，尚未连接硬件。

播放整批流程上一步下一步重新开始进度 0.0s播放速度 显示外壳位置

## 豆路、双摄与两板协作

窄屏可在图内左右滑动；示意图不按加工比例。

示意采用正面剖视；前后相机在图中展开到两边，真实装配见爆炸图。

正常候选疑似可见瑕疵拒判／需复核

上电，闸门不自动打开1 / 10

## 舵机 → 双球头连杆 → 整片前后滑动

正面主屏 · BOX（示例）

侧面状态屏 · C6（示例）

缓关由逐步改变舵机目标位置实现；速度慢不能保证不夹豆，也不能代替限位与动作超时。

异常演示 演示异常

## 始终分开：24V、5V、6V与3.3V信号

本图只表达供电分工；保险、端子和返回线按第11页接线图。SEN0503供5V，信号拟10k上拉C6的3.3V、串1k至GPIO20，接板前实测遮挡／无遮挡电压和极性。

设计依据：V4.11物料与连续PP槽体、两板协议v0.1草案。动画未执行任何GPIO、串口、网络上传或真实识别。模拟24颗豆、总质量4.8g，仅用于讲解；示例时长不用于固件超时。停止是软件停止；停电不保证闸门自闭。疑似和拒判豆仍落在同一盒，复核依赖图像证据。
