koffja/Beanlens/docs/hardware/hackathon-h3/assembly-p4/beanlens-assembly-p4.html

BEANLENS ／ H3-P4 ／ 2026.10.22

# 打印件怎样装到这台机器上

9件原版打印件 · 黑色2020 · 5件海洋板 · 每处连接可查BOM

整机组装整机爆炸连接特写正视侧视恢复立体视角

裸框 220×240×460 mm
爆炸外移只为看安装关系

拖动旋转 · 滚轮缩放 · 点击部件查BOM

拆开程度 0%

闸片开合 关闭 / 0mm

显示打印件编号 遮光片透明查看（实物为黑PP）

先看整机，再在右侧选一处连接。连接特写只保留该处相关零件；拖“拆开程度”能看贴合面。木板、打印件和型材的显示比例相同。螺纹、垫片厚度和器件外形为参考，实际孔距须先对实物。

## 看一处连接

放大这处连接

## 选中的部件

点击三维部件，查看编号、材质和连接位置。

BOM快速找件

P4装配修订

原9件及P3切片文件继续用。底板Z22；屏承板前面Y20；顶环／底板用平片。右侧遮光片、后背景片及木条穿越位置已留缺口。

机外电源、降压与缓冲板保留；接线总图／电源详图。不装C6、称重、IR或第二屏。

CAD检查不是实打或承载验收。先纸样、空载与限位手推，再单豆。

原P1/P2实体CAD用于打印件；相机、舵机、BOX、球头、灯槽和开关为识别外形参考，不是厂商CAD。19.75mm行程仅几何，舵机PWM端点与限位触发尚待上板／实物标定。
