koffja/Beanlens/docs/hardware/hackathon-h3/printing-bambu-p3/index.html

BEANLENS ／ H3-BAMBU-P3 ／ 2026.10.22

# 选对机器，再按盘打印。

0.4mm标准喷嘴 · 拓竹PETG HF · 纹理PEI板 · 已实际切片

整套9件主零件＋1对试片。每种机型都有6盘可选，不要把五套全部打印。

打印与装配说明排产CSV检查记录完整打印包ZIP

赶比赛：四台并行

P2S：试片／上斗 · X1 Carbon：试片／接座与相机座
X2D：下斗 · A1：舵机架／限位与旗片 · H2D备用

上斗与接座跨机时，两台分别先打00并交叉试插。约4小时量级的打印预算，不含烘料、冷却、拆撑和装配。只开两台的排法见说明。

主机切片检查通过，尚未实打。先核实机型和料盘，打印00试片；设备／板材／喷嘴不同则重新切片。

## 选择要使用的机器

P2SA1X1 CarbonX2DH2D

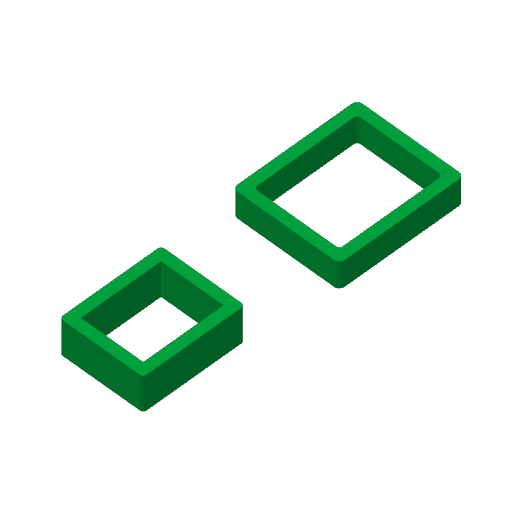
[picture p83: docs/hardware/hackathon-h3/printing-bambu-p3/thumbnails/00-fit-tests.png]
先打公／母试配片的实际切片模型缩略图


00-fit-tests

## 先打公／母试配片

2只小试片，先确认插接；跨机器时交叉试配。

下载对应机型打印文件 ↗

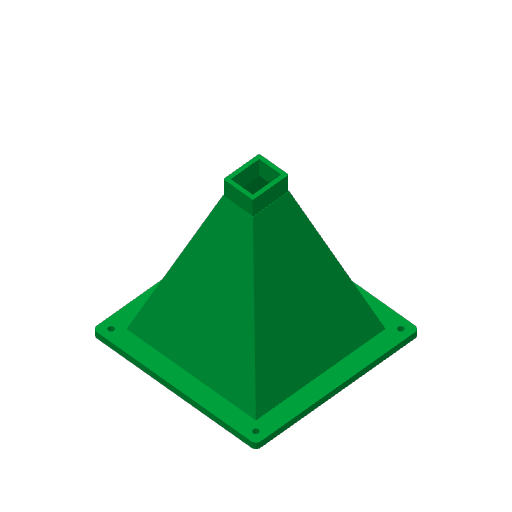
[picture p84: docs/hardware/hackathon-h3/printing-bambu-p3/thumbnails/01-upper-hopper.png]
上漏斗斗身的实际切片模型缩略图


01-upper-hopper

## 上漏斗斗身

1件，大口法兰贴床，无支撑。

下载对应机型打印文件 ↗

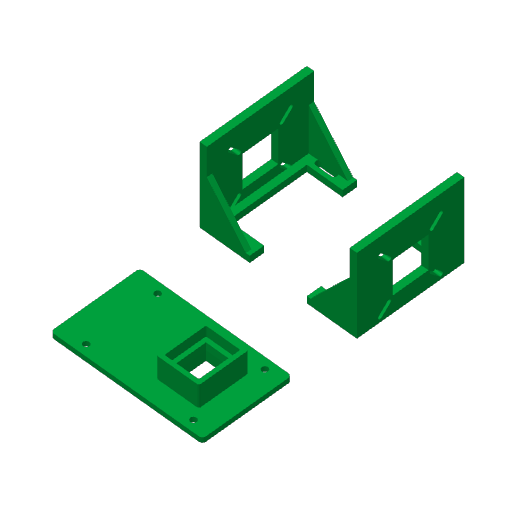
[picture p85: docs/hardware/hackathon-h3/printing-bambu-p3/thumbnails/02-adapter-and-cameras.png]
上接座＋前后相机座的实际切片模型缩略图


02-adapter-and-cameras

## 上接座＋前后相机座

3件，底面贴床，无支撑；实物孔距先核纸样。

下载对应机型打印文件 ↗

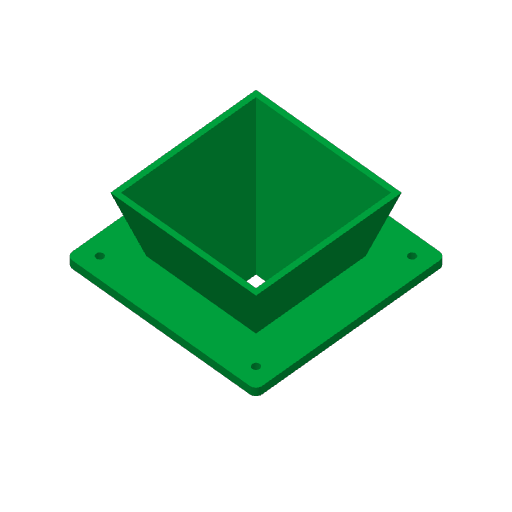
[picture p86: docs/hardware/hackathon-h3/printing-bambu-p3/thumbnails/03-lower-collector.png]
下接豆斗的实际切片模型缩略图


03-lower-collector

## 下接豆斗

1件，小口贴床；支撑仅位于豆路外侧。

下载对应机型打印文件 ↗

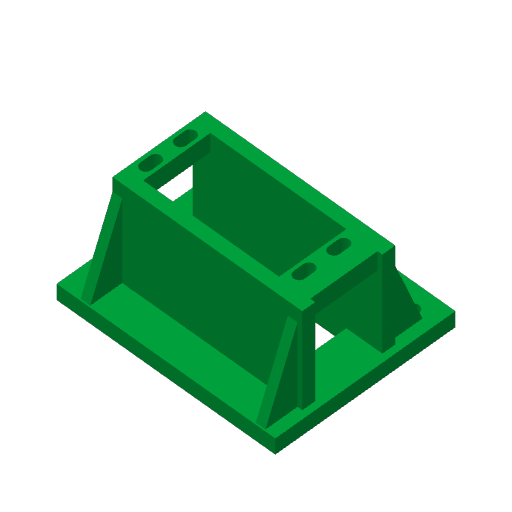
[picture p87: docs/hardware/hackathon-h3/printing-bambu-p3/thumbnails/04-servo-cradle.png]
MG996R舵机架的实际切片模型缩略图


04-servo-cradle

## MG996R舵机架

1件，6道墙／40%填充，清掉安装耳承梁下支撑。

下载对应机型打印文件 ↗

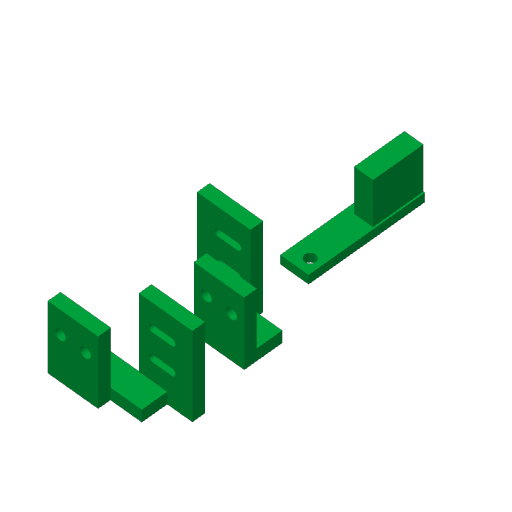
[picture p88: docs/hardware/hackathon-h3/printing-bambu-p3/thumbnails/05-limits-and-flag.png]
两限位座＋闸片旗片的实际切片模型缩略图


05-limits-and-flag

## 两限位座＋闸片旗片

3件，限位座侧放，无支撑。

下载对应机型打印文件 ↗

时长与用料为Bambu Studio 02.08.02.61估算。缩略图来自实际导出的切片文件，颜色仅作显示；发送时映射实装PETG HF。未修改原P1／P2装配尺寸；P2铝板、承托片及后横梁修订仍需实施。
