koffja/Beanlens/docs/hardware/hackathon-h3/printing-p1/preview.html

# BeanLens H3-P1 · 上下漏斗打印文件

3件主零件 · 毫米 · CAD实体导出的实际网格 · 2026.10.22

安装与切片说明 ↗

安装位置拆开看接口单件打印方向恢复视角

拖动旋转 · 滚轮缩放；灰色PP件与木台为保留件，不在打印清单中。

显示原PP顶环、闸盒、下短管和木台参考

上斗104×104固定法兰在原顶环下方；接座加在原上盖之上，保留闸片滑缝；下斗固定法兰落在工作台60mm方孔上。

## 打印这三件

01 上漏斗斗身 ×1

02 上漏斗接座 ×1

03 下接豆斗 ×1

打印包络 | 104×104×100.5mm
打印方向 | 大口法兰贴床，小口朝上
平台 | 220×220mm或更大
壁厚 | 最小设计法向厚2.4mm

下载STL下载3MF下载STEP

## 插口先试配

先打小试片，再打大件

公头22.8×18.8，母座23.2×19.2；每侧名义间隙0.2。整体固定后轴向留0.2，不能用螺栓把上斗压紧到闸盒。

公头试片母座试片

## 不缩放模型

全部按mm、100%导入。下斗法兰底面需要外侧支撑；豆路内部排除支撑。

STL/3MF已按打印方向放好。装配STEP仅供位置核对，不是整机打印文件。未上机打印、未做承载或食品接触验收。

装配STEP（仅参考）

蓝线为水平双摄光轴Z260；三个打印件不进入Z235–285观察带。灰色参考件不代表完整机架。原PP焊接版与固件保持原样。
