koffja/Beanlens/docs/hardware/hackathon-h3/printing-p2/preview.html

# BeanLens H3-P2 · 舵机／相机／限位支架

5件支架＋1只小旗片 · 实体CAD网格 · 毫米 · 2026.10.22

安装、板材修配与打印说明 ↗

安装参考拆开看单件打印方向舵机组特写恢复视角

拖动旋转 · 滚轮缩放 · 灰色为保留件参考，不在打印清单中

显示舵机、PCB、铝板、后横梁及承托片参考

手动查看闸片行程：0.00mm / 关位仅运动示意。两个限位座从前后夹住新旗片的运动范围；触发位置仍需实物调节，不以本页模拟代替万用表检查。

## 打印件选择

56 × 68 × 35.8 mm

STL3MFSTEP

全部100%尺寸、毫米导入

舵机架底面贴床；相机座底面贴床；限位座已侧放；小旗片底脚贴床。支撑细节看说明。

## 采用P2时的配套修改

铝底板60×60保留，安装位置前移避开立柱。原大承托片改68×80，后侧新增一根180mm黑2020横梁，可从余下400mm型材裁出。

铝板1:1孔图承托片1:1图

原H3和漏斗P1文件保留；按此包装配时不能继续照旧示意放置铝板和承托片。

## 先核实实物孔距

相机座孔槽候选覆盖24–34mm方形孔距；不是所有GC2093模组通用。舵机耳孔、相机PCB及限位触发量均未实配。

相机1:1对孔图参数源

CAD与网格检查通过不代表已打印或承载合格。保留金属舵臂、连杆、铝闸片和机架角码。

两个镜头保持水平相向、光轴Z260。舵机轴心仍为(170,180,331)。运动演示与参考器件外形不是原厂CAD或实机试验。
