koffja/Beanlens/docs/hardware/hackathon-h3/printing-bambu-p3/print-jobs.csv

machine | job | parts | file | estimated_seconds | estimated_g | support
P2S | 00-fit-tests | 2 | jobs/P2S/00-fit-tests.gcode.3mf | 1107 | 3.27 | False
P2S | 01-upper-hopper | 1 | jobs/P2S/01-upper-hopper.gcode.3mf | 12352 | 71.64 | False
P2S | 02-adapter-and-cameras | 3 | jobs/P2S/02-adapter-and-cameras.gcode.3mf | 9534 | 49.09 | False
P2S | 03-lower-collector | 1 | jobs/P2S/03-lower-collector.gcode.3mf | 13936 | 77.9 | True
P2S | 04-servo-cradle | 1 | jobs/P2S/04-servo-cradle.gcode.3mf | 7135 | 37.14 | True
P2S | 05-limits-and-flag | 3 | jobs/P2S/05-limits-and-flag.gcode.3mf | 3142 | 12.0 | False
A1 | 00-fit-tests | 2 | jobs/A1/00-fit-tests.gcode.3mf | 1154 | 3.31 | False
A1 | 01-upper-hopper | 1 | jobs/A1/01-upper-hopper.gcode.3mf | 13147 | 70.97 | False
A1 | 02-adapter-and-cameras | 3 | jobs/A1/02-adapter-and-cameras.gcode.3mf | 10074 | 48.66 | False
A1 | 03-lower-collector | 1 | jobs/A1/03-lower-collector.gcode.3mf | 14855 | 77.15 | True
A1 | 04-servo-cradle | 1 | jobs/A1/04-servo-cradle.gcode.3mf | 7772 | 36.82 | True
A1 | 05-limits-and-flag | 3 | jobs/A1/05-limits-and-flag.gcode.3mf | 3325 | 11.94 | False
X1C | 00-fit-tests | 2 | jobs/X1C/00-fit-tests.gcode.3mf | 1175 | 3.61 | False
X1C | 01-upper-hopper | 1 | jobs/X1C/01-upper-hopper.gcode.3mf | 12295 | 71.98 | False
X1C | 02-adapter-and-cameras | 3 | jobs/X1C/02-adapter-and-cameras.gcode.3mf | 9528 | 49.43 | False
X1C | 03-lower-collector | 1 | jobs/X1C/03-lower-collector.gcode.3mf | 13932 | 78.24 | True
X1C | 04-servo-cradle | 1 | jobs/X1C/04-servo-cradle.gcode.3mf | 7154 | 37.48 | True
X1C | 05-limits-and-flag | 3 | jobs/X1C/05-limits-and-flag.gcode.3mf | 3183 | 12.34 | False
X2D | 00-fit-tests | 2 | jobs/X2D/00-fit-tests.gcode.3mf | 993 | 3.27 | False
X2D | 01-upper-hopper | 1 | jobs/X2D/01-upper-hopper.gcode.3mf | 12226 | 71.64 | False
X2D | 02-adapter-and-cameras | 3 | jobs/X2D/02-adapter-and-cameras.gcode.3mf | 9411 | 49.09 | False
X2D | 03-lower-collector | 1 | jobs/X2D/03-lower-collector.gcode.3mf | 13814 | 77.9 | True
X2D | 04-servo-cradle | 1 | jobs/X2D/04-servo-cradle.gcode.3mf | 7013 | 37.14 | True
X2D | 05-limits-and-flag | 3 | jobs/X2D/05-limits-and-flag.gcode.3mf | 3029 | 12.0 | False
H2D | 00-fit-tests | 2 | jobs/H2D/00-fit-tests.gcode.3mf | 1018 | 3.31 | False
H2D | 01-upper-hopper | 1 | jobs/H2D/01-upper-hopper.gcode.3mf | 12253 | 71.67 | False
H2D | 02-adapter-and-cameras | 3 | jobs/H2D/02-adapter-and-cameras.gcode.3mf | 9452 | 49.12 | False
H2D | 03-lower-collector | 1 | jobs/H2D/03-lower-collector.gcode.3mf | 13838 | 77.93 | True
H2D | 04-servo-cradle | 1 | jobs/H2D/04-servo-cradle.gcode.3mf | 7045 | 37.17 | True
H2D | 05-limits-and-flag | 3 | jobs/H2D/05-limits-and-flag.gcode.3mf | 3054 | 12.03 | False
