koffja/Beanlens/docs/hardware/hackathon-h1/assembly-h1.html

BEANLENS / HACKATHON H1 / 2026-10-19

# 单摄、单槽、停豆拍照后开闸

一块K230D BOX完成识别、显示和MG996R控制。人工逐颗投豆；轻挡片侧摆，不再做长滑闸。完整版V4.12独立保留。

所有孔位、镜头近焦、舵机端点与限位高度仍需实物。图中0/90为相对几何演示，不能直接换算成未经标定的PWM。未写入或烧录产品固件。

组装爆炸分解 遮光片机外配电部件编号

## 点击部件查看

图号对应采购H01–H30

点击可查看尺寸与待核项目。切换遮光与分组不会改变比例。

文档与动画检查不代表实物通过；普通收豆杯不称重，单面可见瑕疵不等于完整品质鉴定。
