koffja/Beanlens/docs/hardware/hackathon-h1/operation-h1.html

BEANLENS / HACKATHON H1 / 2026-10-19

# 豆停住时拍照，识别后才放走

单摄、单槽、单K230D BOX。人工放一颗、移开双手、按KEY0；轻挡片侧摆放豆，空槽确认后才关。

播放一次完整示例暂停① 放一颗豆② KEY0 拍摄／拒判确认KEY1 停止重新开始示例 速度

## 俯视：固定槽，侧摆挡片

绿色槽底不动；灰色挡片由舵机带动，向侧后方摆开。窄屏可在图内横向滑动。

## 侧视：豆靠挡片停住，相机朝下拍

等待人工放一颗豆

演示故障

真实固件应让忙时按键幂等、设置动作超时。低信度拒判仍保留原标签与证据，不能计为正常。

这是离线教学动画：不连接相机、GPIO、KPU或TF卡。示例类别、耗时、角度与限位状态均为模拟；没有板端部署或动作验收结论。一次闸门动作本身不是逐豆计数依据，人工单颗确认与图像证据共同定义有效样本。本版只有当前可见面，疑似/拒判均落同一杯。
