koffja/Beanlens/output/pdf/beanlens-assembly-v4.5-20261013.pdf

## 01 整机组装图与部件爆炸图

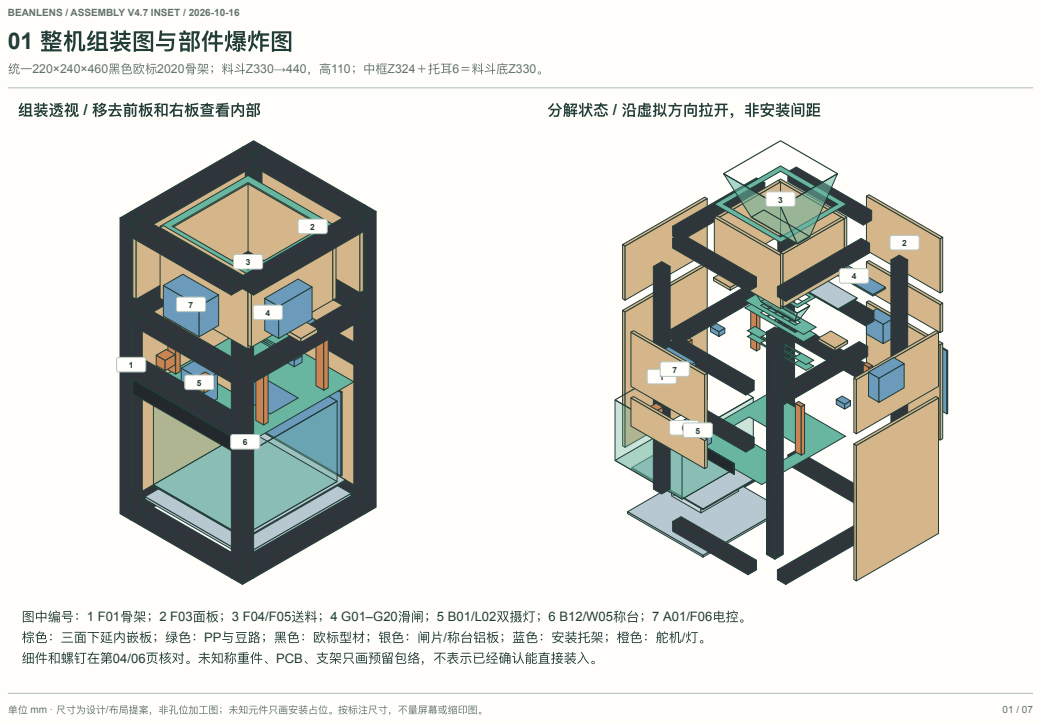
[picture p106: page 1]
统一220×240×460黑色欧标2020骨架；料斗Z330→440，高110；中框Z324＋托耳6＝料斗底Z330。; 组装透视 / 移去前板和右板查看内部; 单位 mm · 尺寸为设计/布局提案，非孔位加工图；未知元件只画安装占位。按标注尺寸，不量屏幕或缩印图。

BEANLENS / ASSEMBLY V4.7 INSET / 2026-10-16

分解状态 / 沿虚拟方向拉开，非安装间距

图中编号：1 F01骨架；2 F03面板；3 F04/F05送料；4 G01–G20滑闸；5 B01/L02双摄灯；6 B12/W05称台；7 A01/F06电控。
棕色：三面下延内嵌板；绿色：PP与豆路；黑色：欧标型材；银色：闸片/称台铝板；蓝色：安装托架；橙色：舵机/灯。
细件和螺钉在第04/06页核对。未知称重件、PCB、支架只画预留包络，不表示已经确认能直接装入。

## 02 铝型材骨架尺寸与逐根定位

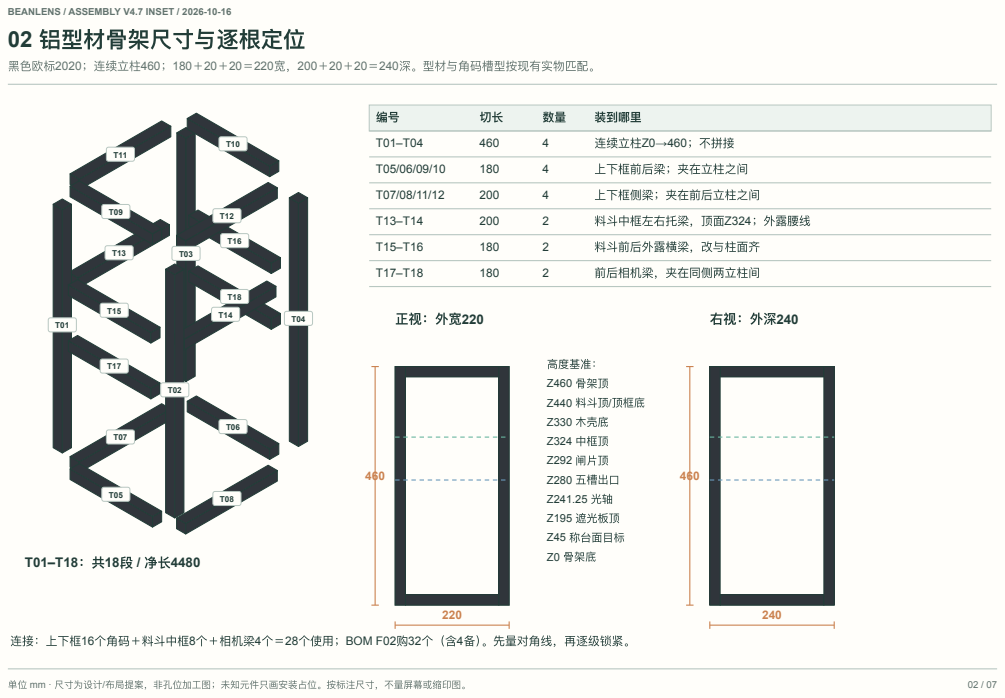
[picture p107: page 2]
黑色欧标2020；连续立柱460；180＋20＋20＝220宽，200＋20＋20＝240深。型材与角码槽型按现有实物匹配。; 装到哪里; 连续立柱Z0→460；不拼接; 上下框前后梁；夹在立柱之间; 上下框侧梁；夹在前后立柱之间; 料斗中框左右托梁，顶面Z324；外露腰线; 料斗前后外露横梁，改与柱面齐; 前后相机梁，夹在同侧两立柱间; 高度基准： Z460 骨架顶; Z440 料斗顶/顶框底; Z330 木壳底; Z324 中框顶; Z292 闸片顶; Z280 五槽出口; Z195 遮光板顶; Z45 称台面目标; Z0 骨架底

连接：上下框16个角码＋料斗中框8个＋相机梁4个＝28个使用；BOM F02购32个（含4备）。先量对角线，再逐级锁紧。

## 03 内嵌木板、三面下延与裁切排版

木板不在外角互相拼缝，四角交给黑色立柱；15片木料以P/H编号对照CSV。

## F03：800×600×6一张 / 9块外板＋6块料斗/托耳

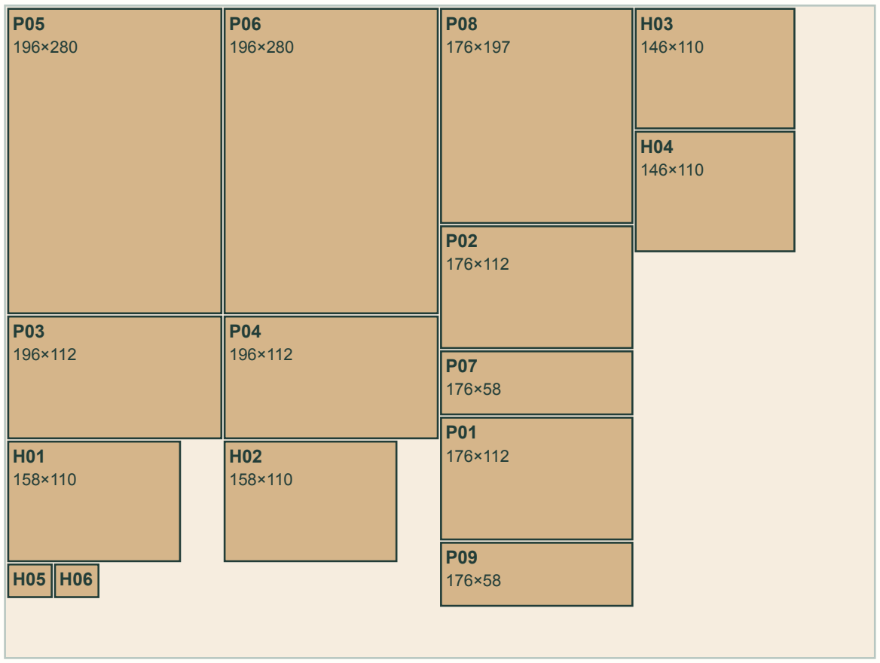
[picture p108: figure]

800

板号 | 净裁切mm / 数量 | 安装位置
P01/P02 | 176×112×6，各1 | 前/后上板 Z326→438
P03/P04 | 196×112×6，各1 | 左/右上板 Z326→438
P05/P06 | 196×280×6，各1 | 左/右下板 Z22→302
P08 | 176×197×6，1 | 后下板 Z22→219
P07/P09 | 176×58×6，各1 | 后/前中板 Z244→302
H01/H02 | 158×110×6，各1 | 料斗前/后板
H03/H04 | 146×110×6，各1 | 料斗左/右板
H05/H06 | 40×30×6，各1 | 托耳；不改变Z330底面

外廓回到220×240，木板不包住柱面；边缝约2。

板面内凹约1：6mm板＋隔距＋内侧角片背托。

上板跨中横梁会相撞，所以以外露腰线分块。

后相机梁也外露，后板分三段；正面留取盒口。
若已买600方：改用两张600×600，不重复买800板。

板边/锯缝按3mm排，最终螺孔先做一只板角样件。

F11：先做“型材＋角片＋隔距＋板”角样

长板各4点，58高短板各2点，共32木板固定点。

另2点固定前黑PP遮光条，购40套含备用。

M3×25沉头；隔距示意11，按角片实物调。

板只封边/遮光，不顶称台或借豆盒承重。

本页是保守可切排版；两张600方替代排版另见V4.7制作页。屏幕/按钮孔按实物，按钮中心下移Z273。

## 04 送料与槽内滑闸爆炸图

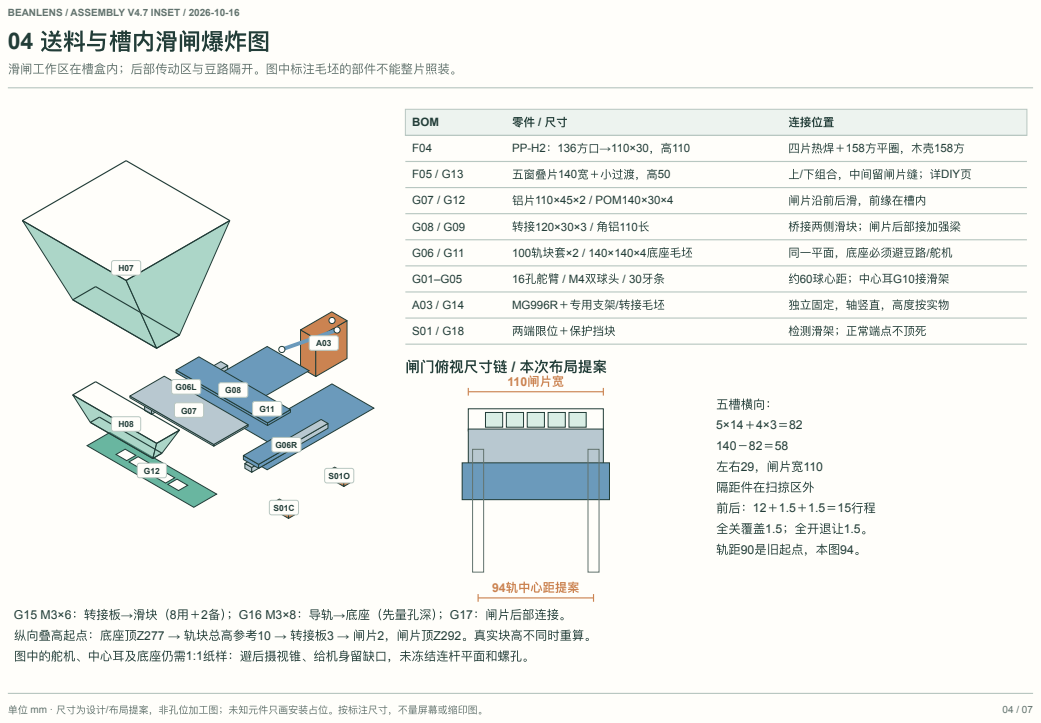
[picture p109: page 4]
BOM; 连接位置; 四片热焊＋158方平圈，木壳158方; 五窗叠片140宽＋小过渡，高50; 上/下组合，中间留闸片缝；详DIY页; 铝片110×45×2 / POM140×30×4; 闸片沿前后滑，前缘在槽内; 桥接两侧滑块；闸片后部接加强梁; 100轨块套×2 / 140×140×4底座毛坯; 同一平面，底座必须避豆路/舵机; 16孔舵臂 / M4双球头 / 30牙条; 约60球心距；中心耳G10接滑架; MG996R＋专用支架/转接毛坯; 独立固定，轴竖直，高度按实物; 两端限位＋保护挡块; 检测滑架；正常端点不顶死; 闸门俯视尺寸链 / 本次布局提案 110闸片宽; 94轨中心距提案; 五槽横向： 5×14＋4×3＝82 140－82＝58; 左右29，闸片宽110; 隔距件在扫掠区外 前后：12＋1.5＋1.5＝15行程; 全关覆盖1.5；全开退让1.5。; 轨距90是旧起点，本图94。

滑闸工作区在槽盒内；后部传动区与豆路隔开。图中标注毛坯的部件不能整片照装。

G15 M3×6：转接板→滑块（8用＋2备）；G16 M3×8：导轨→底座（先量孔深）；G17：闸片后部连接。
纵向叠高起点：底座顶Z277 → 轨块总高参考10 → 转接板3 → 闸片2，闸片顶Z292。真实块高不同时重算。
图中的舵机、中心耳及底座仍需1:1纸样：避后摄视锥、给机身留缺口，未冻结连杆平面和螺孔。

## 05 相机、灯、称台与电控安装剖面

相机与灯固定在机架，收豆盒只压独立称台。图中的称重虚框不是HJ-AZ4实际外形。

侧剖面 / 前← Y →后；X方向看全部五槽

75起试 75起试

料斗口Z330

闸片顶Z292
槽口Z280

光轴Z241.25

遮光顶Z195

台面Z45目标

底板孔130×50；盒口≤Z175，净间距需计板厚。

BOM | 安装方法 / 对照尺寸
B01 / B13 | 前后相机各一套，固定独立T17/T18梁
B13 | L角铝30×30×2、长40＋40方载板毛坯
A05 / L02 | 四条竖灯100有效长；前后各两条，斜照
PH01 / PH04 | 收发头两侧，光束中心约Z277
F07 | 遮光底板180×200×1，开130×50通口
W06 | 固定底板180×190×4，先核角码净空
W01 | HJ-AZ4外形与接口未知；收到图后定孔
W05 | 活动台170×180×2，只连接称重活动端
B12 | 盒≤160×170×130，不接墙/承重滑轨
F06 | BOX、C6、后电控三片托板由200方铝板排

称重力路：豆＋盒 → W05 → 传感器 → W06 → 机架。
后电控移下部Y207，板Z50→180；模块朝后≤21厚起试。 BOX夹持板80×60×2，C6夹持板60×35×2均为毛坯。 BOX壳64.3×47.6×15.4；箱内服务深度约35起试。

24V适配器在机外；后板内只布置低压配电。

豆盒向前移5，后留约7；高模块须重排，不挤碰盒/称台。

当前未解决：HJ-AZ4组件高度/孔距；GC2093实际PCB/镜头长度；

MG996R支架共面高度与扫掠；灯条切点与散热槽；后视锥净空。

称台Z45与前后75均是目标起点，未核实前不钻最终孔。

## 06 按BOM组装的顺序与连接件核对

先机架与手推机械，再空载动作与成像，最后称重/面板。图纸检查不代替实机联调。

步骤 | 装配对象 / BOM | 操作与检查
1 | F01 / F02：T01–T12主框架 | 连续立柱与上下框松装；量外宽220/深240/高460与两面对角线，先轻锁。
2 | T13–T16中框＋H05/H06托耳 | 中框顶Z324；前后横梁移外露柱面；托耳到330，试放158方木壳。
3 | H01–H04木壳 / F04内衬 / F05槽盒 | 前后包侧板；PP2四片先纸样/试焊。136口到110×30，底下五窗贯通。
4 | G06 / G11 / G12 / G07–G10滑架 | 先装导轨、转接、支承与闸片；不接舵机，手推15mm不偏摆不卡滞。
5 | A03 / G01–G05 / G14 / S01 | 装支架与短杆，核花键/孔深/摆角；独立6V空载标定限位，启动不自动开闸。
6 | T17/T18 / B13 / B01 / L02 / PH04 | 相机固定独立梁；75起试，标尺检120视宽；灯与光电开关对照图像。
7 | W06 / W01 / W05 / B12 | 组件资料确认后装；盒、活动台、线缆不得碰外壳；称稳定再报重。
8 | F06电控 / A08 / A17 / P05 / P06 | 先不接负载量5V/6V；信号与舵机电流分开走；留排线应力释放。
9 | P01–P09 / F11 / F07 | 板块内嵌，三面下延；前按钮中心273；检查后板/固定托板与豆盒不相碰。
10 | 单槽 → 五槽联调 | 从少量豆开始；观察夹豆/飞豆/残流/偏转；卡豆停机排障，不持续硬关。

连接件清点 / 本次BOM补充

BOM | 使用数量 | 购买/核对事项
F02 | 角码28用；配套M5/T螺母各56用 | 购32角码、64螺钉/64 T螺母；只计骨架，另留F08面板固定。
F11 | 木板32点＋前遮光条2点 | 40套内角片/M5/T螺母/M3×25/隔距；角样先核1mm内凹和2mm边缝。
F08 | 料斗木壳8小角片＋托耳外侧2小角片 | 15×15×约1.5小角片10；M3×12/螺母/垫片各28含备，内侧头平齐并隔离豆路。
B13 / G15–G18 | 相机支架/滑块/导轨/限位各自独立 | 按各行数量；安装M5件随B13套件核对。不能把相机孔距、限位孔距混用。
未逐件画出 | 电阻、电容、线缆、保险备件、砝码等 | 完整采购仍以V4.5表为准；互斥工业光电/称重备选没有同时画入整机。

## 07 三种常见连接的放大装配图

螺钉长度按真实板厚、垫片和螺纹深度核对；图示只说明方向及层次，不代替零件厂家尺寸图。

### A / 两根型材怎样用角码连接


角码两只脚各一枚配套M5螺钉，旋入各自槽内的T螺母。

先把T螺母滑入/转入槽内，再轻锁角码；校方后锁紧。

图是连接方向剖示，不是角码实际外形；槽型按同一供应商。

### B / 板在框内，角码与隔距从背面托住

板厚6

面内凹1

缝约2

隔距示意11

M3沉头朝外

M5锁型材

木板不覆盖立柱/横梁

立柱内侧角片背托：示意10mm柱＋1mm调垫。

按角片实物量距；先做一个板角，别一次钻全套。
F11：32个木板点＋2个遮光条点，购40套。

6mm木板浅沉孔，不把螺钉头拉穿；螺纹在内侧。

左、右、后三面下延，板块以外露黑腰线分开。

C / 滑架厚度与螺钉方向：螺钉只锁滑块，不向下顶住导轨

G08 转接板3

MGN9H轨块总高参考10

G11 底座厚4

G15：M3×6穿3mm转接板，余下约3mm进入滑块（未计垫片）。收到后量有效牙深，避免顶底或啮合不足。
