koffja/Beanlens/docs/hardware/fabrication-v4.8/flat-stock-v4.8.csv

板料 | 部件 | 排版X | 排版Y | 矩形包络宽 | 矩形包络高 | 说明
PP2-A | A1 | 3 | 3 | 140.02783702182452 | 122.10241602851272 | 净轮廓矩形包络；实际梯形/开孔看原尺寸模板，余料练习
PP2-A | A2 | 151.02783702182452 | 3 | 140.02783702182452 | 122.10241602851272 | 净轮廓矩形包络；实际梯形/开孔看原尺寸模板，余料练习
PP2-A | B1 | 3 | 133.10241602851272 | 140.44008785558228 | 110.76551810017412 | 净轮廓矩形包络；实际梯形/开孔看原尺寸模板，余料练习
PP2-A | B2 | 151.44008785558228 | 133.10241602851272 | 140.44008785558228 | 110.76551810017412 | 净轮廓矩形包络；实际梯形/开孔看原尺寸模板，余料练习
PP2-A | C1 | 300 | 3 | 114.58889779094709 | 26.476593436467613 | 净轮廓矩形包络；实际梯形/开孔看原尺寸模板，余料练习
PP2-A | C2 | 300 | 37.477 | 114.58889779094709 | 26.476593436467613 | 净轮廓矩形包络；实际梯形/开孔看原尺寸模板，余料练习
PP2-A | D1 | 300 | 72 | 34.25326802192251 | 28.565888748645648 | 净轮廓矩形包络；实际梯形/开孔看原尺寸模板，余料练习
PP2-A | D2 | 342.254 | 72 | 34.25326802192251 | 28.565888748645648 | 净轮廓矩形包络；实际梯形/开孔看原尺寸模板，余料练习
PP2-B | LID optional | 3 | 3 | 172 | 192 | 净轮廓矩形包络；实际梯形/开孔看原尺寸模板，余料练习
PP3 | RIM | 3 | 3 | 176 | 196 | 净轮廓矩形包络；实际梯形/开孔看原尺寸模板，余料练习
PP3 | U1 | 3 | 207 | 140 | 30 | 净轮廓矩形包络；实际梯形/开孔看原尺寸模板，余料练习
PP3 | U2 | 151 | 207 | 140 | 30 | 净轮廓矩形包络；实际梯形/开孔看原尺寸模板，余料练习
PP3 | L1 | 3 | 245 | 140 | 18 | 净轮廓矩形包络；实际梯形/开孔看原尺寸模板，余料练习
PP3 | L2 | 151 | 245 | 140 | 18 | 净轮廓矩形包络；实际梯形/开孔看原尺寸模板，余料练习
PP3 | FLANGE1 | 3 | 271 | 146 | 66 | 净轮廓矩形包络；实际梯形/开孔看原尺寸模板，余料练习
PP3 | FLANGE2 | 157 | 271 | 146 | 66 | 净轮廓矩形包络；实际梯形/开孔看原尺寸模板，余料练习
PP3 | C6 REAR | 187 | 3 | 56 | 38 | 净轮廓矩形包络；实际梯形/开孔看原尺寸模板，余料练习
BLACK PP2 | BOX FRONT | 3 | 3 | 80 | 64 | 净轮廓矩形包络；实际梯形/开孔看原尺寸模板，余料练习
BLACK PP2 | C6 FRONT | 91 | 3 | 56 | 38 | 净轮廓矩形包络；实际梯形/开孔看原尺寸模板，余料练习
