koffja/Beanlens/docs/hardware/fabrication-v4.8/pp-cuts-v4.8.csv

组 | 片型 | 数量 | 法向厚mm | 外面上宽mm | 外面下宽mm | 外面斜高mm | 内面上宽mm | 内面下宽mm | 侧边离直切倒角度 | 上下端离直切倒角度 | 条件
main | 前后 | 2 | 2 | 140.02783702182452 | 114.02783702182451 | 122.10241602851272 | 136 | 110 | 43.53993883992698 | 25.72561264336567 | 最终名义外线；角部对称斜接，顶底端面水平；粗坯额外余量不计入成品
main | 左右 | 2 | 2 | 140.44008785558228 | 34.44008785558228 | 110.76551810017412 | 136 | 30 | 43.53993883992698 | 6.7400560979469475 | 最终名义外线；角部对称斜接，顶底端面水平；粗坯额外余量不计入成品
transition | 前后 | 2 | 2 | 114.58889779094709 | 86.58889779094709 | 26.476593436467613 | 110 | 82 | 40.20506219252224 | 19.8721758192439 | 最终名义外线；角部对称斜接，顶底端面水平；粗坯额外余量不计入成品
transition | 左右 | 2 | 2 | 34.25326802192251 | 16.25326802192251 | 28.565888748645648 | 30 | 12 | 40.20506219252224 | 29.346827574290398 | 最终名义外线；角部对称斜接，顶底端面水平；粗坯额外余量不计入成品
