koffja/Beanlens/docs/hardware/assembly-v4.5/beanlens-assembly-v4.5.html

最新整机装配与运作演示：V4.12。 整机组装／爆炸及12页接线图 · 整个运作流程动画。本页保留历史参考，旧小过渡斗、双法兰和叠片不用于当前装配。

历史版本：当前设计已升级V4.8。取消木斗壳、重算PP板厚/斜接并拆清双屏。打开V4.8组装与双屏净空；旧模板不作当前下料。

当前内容：V4.7内嵌木板/焊接PP。本页、七页PDF和裁切CSV已更新为V4.7：三面内嵌板下延、框架外露、PP2热焊主斗及上下五窗叠层；文件路径保留V4.5名称兼容旧链接。同尺寸成品/裸框对照与现有料配料。中框顶324＋托耳6＋主斗110＝440；口圈顶442，框顶460。PP制作另见详细指南。旧400柱/220梁切单不再使用。

BEANLENS / DIMENSIONED ASSEMBLY / 2026-10-16 · V4.7内嵌木板

# 三面木板下延、框架外露：V4.7组装与爆炸图

骨架220×240×460；料斗底Z330、顶Z440、高110。先用下方模型看装配关系，再看七张尺寸图。点击零件或列表，读取BOM编号、规格和安装注意事项。

这是尺寸化装配提案，不是已验收加工图。实线标准件/板料按标注核对；元件占位与未定孔位明确标记。所有螺孔先按实物纸样确认。

## 先核对成品、裸框与料斗高度

相同投影与缩放的黑色2020成品/裸框，料斗高110

中框顶324＋托耳6＝斗底330；斗高110到440；顶框440→460。虚线是料斗包络。

组装状态爆炸状态分解程度 0%显示 显示外壳面板

选择一个部件

编号与BOM在此显示

模型用于看安装关系；切换外壳或部件分组时比例不变，真实螺孔按实物。

零件目录

前方是取豆方向，背面是低压电控检修区。组装模型使用简化包络；例如称重虚框不是HJ-AZ4实际外形。

当前内容V4.7内嵌木板与PP焊接；路径保留V4.5名称以兼容旧链接。共享V4.6机架数据，料斗高110、支承6、中框顶Z324；型材和木板裁切/BOM同步。无采购、加工、实物承载或电气验收。
