koffja/Beanlens/docs/hardware/assembly-v4.8/beanlens-assembly-v4.8.html

最新整机装配与运作演示：V4.12。 整机组装／爆炸及12页接线图 · 整个运作流程动画。本页保留历史参考，旧小过渡斗、双法兰和叠片不用于当前装配。当前送料/电源修订为V4.10。 打开连续前壁、固定与PBT刷盒图 · 114项新版BOM。6V舵机采用UBEC5A/6V；TPS5450只评估5V逻辑路。V4.9主斗外形、V4.8机架/木板/双屏保留，旧分离POM座和刷排表述已被替换。V4.9 已替换本页电源/料斗/五窗叠片方案。 打开四页新接线与连续PP料斗图 · 107项新版BOM。本页V4.8机架、9片木板与双屏可继续参考，旧PP模板不能混用。

当前内容：V4.8内嵌木板/焊接PP。本页、十页PDF和裁切CSV已更新为V4.8：三面内嵌板下延、框架外露、无木壳PP2主斗、双屏独立夹框、可拆双法兰与上下五窗叠层；文件路径保留V4.5名称兼容旧链接。同尺寸成品/裸框对照与现有料配料。顶法兰440/443；主斗330→440；口圈顶442，框顶460。PP制作另见详细指南。旧400柱/220梁切单不再使用。

BEANLENS / DIMENSIONED ASSEMBLY / 2026-10-16 · V4.8内嵌木板

# V4.8：双屏净空与无木壳PP料斗

骨架220×240×460；料斗底Z330、顶Z440、高110。先用下方模型看装配关系，再看十张尺寸图。点击零件或列表，读取BOM编号、规格和安装注意事项。

这是尺寸化装配提案，不是已验收加工图。实线标准件/板料按标注核对；元件占位与未定孔位明确标记。所有螺孔先按实物纸样确认。

## 先核对成品、裸框与料斗高度

相同投影与缩放的黑色2020成品/裸框，料斗高110

顶框承托法兰底440，主斗底330；斗高110到440；顶框440→460。虚线是料斗包络。

组装状态爆炸状态分解程度 0%显示 显示外壳面板显示接线净空只看双屏装配

选择一个部件

编号与BOM在此显示

模型用于看安装关系；切换外壳或部件分组时比例不变，真实螺孔按实物。

零件目录

前方是取豆方向，背面是低压电控检修区。组装模型使用简化包络；例如称重虚框不是HJ-AZ4实际外形。

当前内容V4.8内嵌木板与PP焊接；本版独立保存V4.8文件。V4.8共享设计数据，料斗高110、顶框悬挂、中框顶Z324；型材和木板裁切/BOM同步。无采购、加工、实物承载或电气验收。
