koffja/Beanlens/docs/hardware/assembly-v4.12/01-overall.png

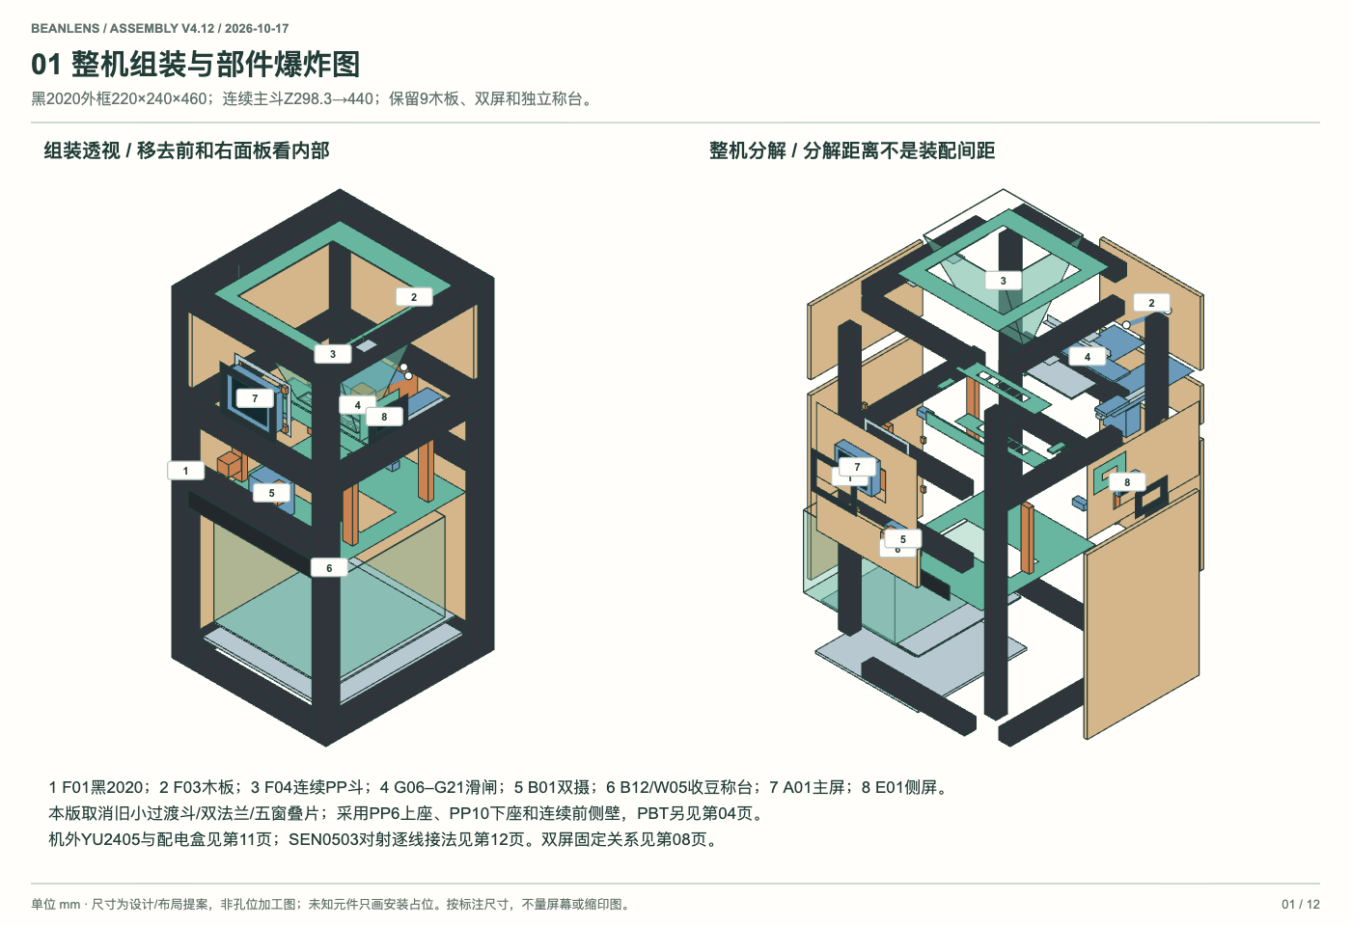
docs/hardware/assembly-v4.12/01-overall.png
