koffja/Beanlens/docs/hardware/assembly-v4.12/02-frame.png

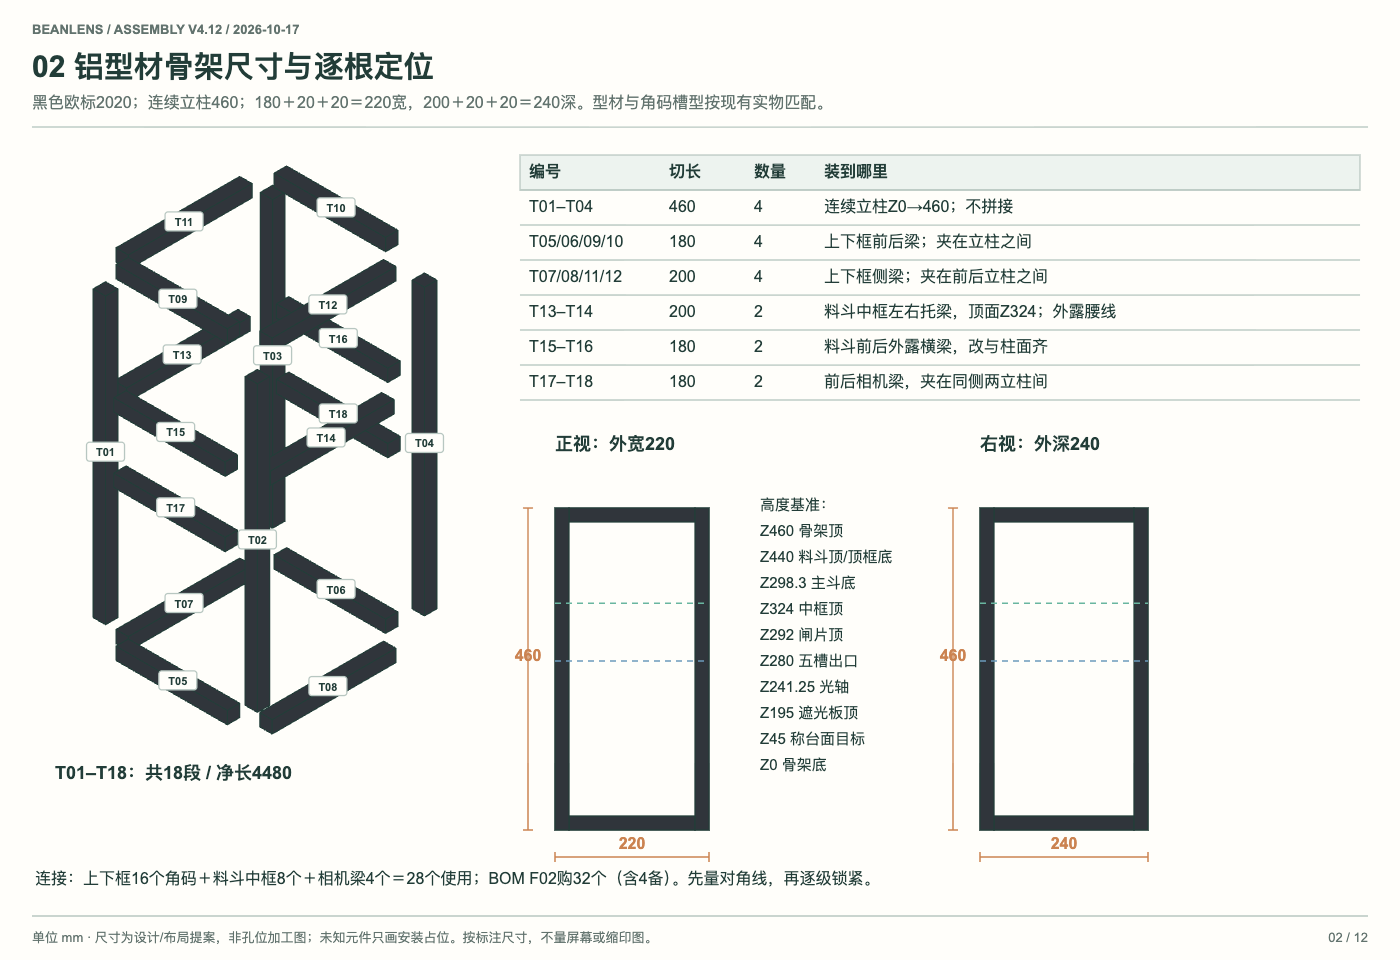
docs/hardware/assembly-v4.12/02-frame.png
