koffja/Beanlens/docs/hardware/assembly-v4.12/03-plywood.png

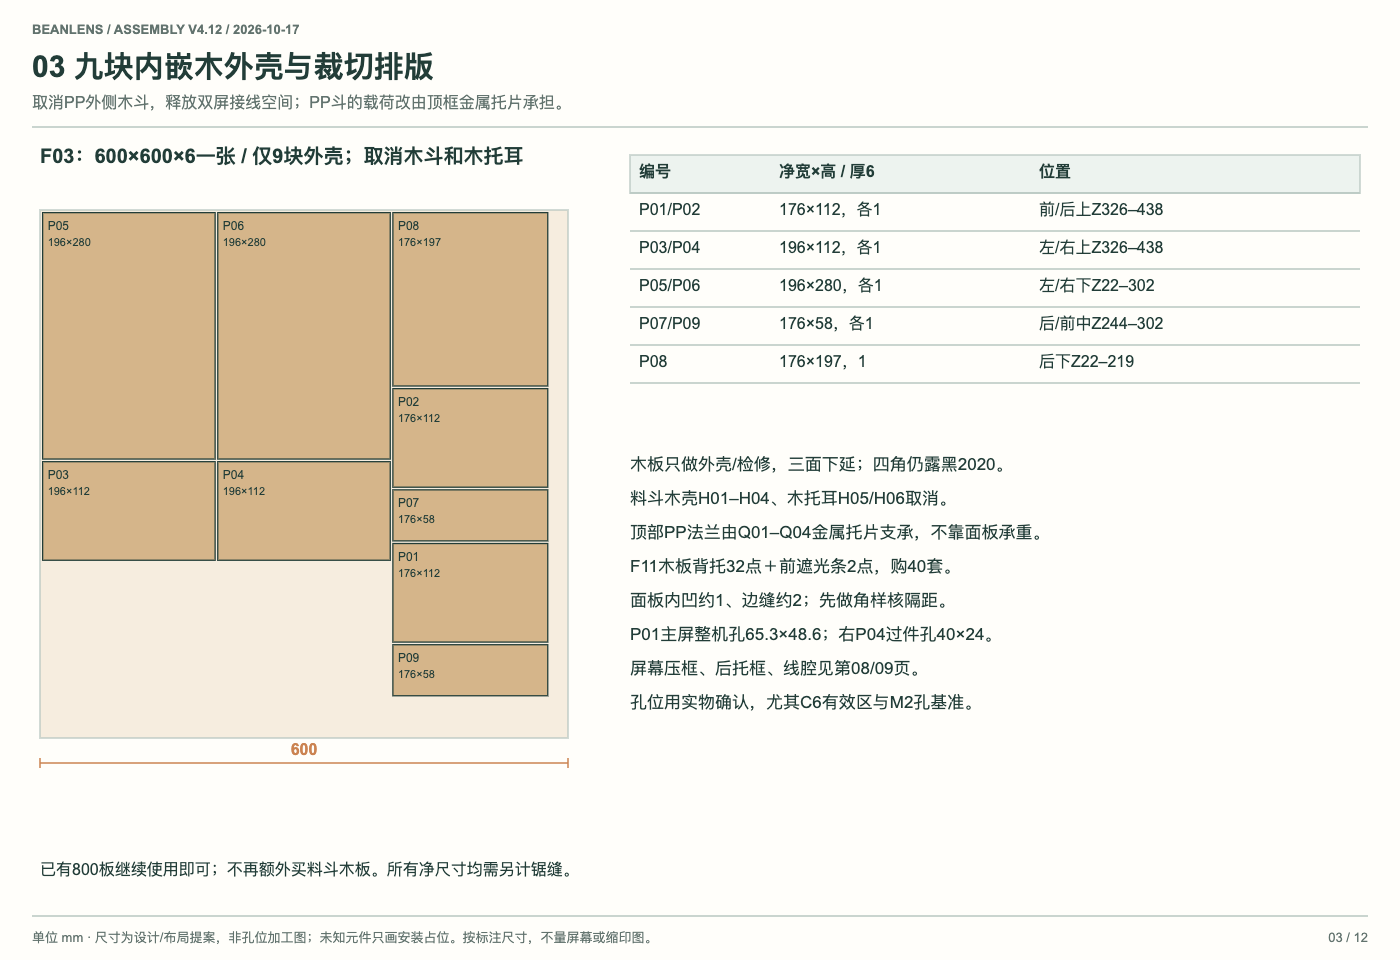
docs/hardware/assembly-v4.12/03-plywood.png
