koffja/Beanlens/docs/hardware/assembly-v4.12/04-feed-gate.png

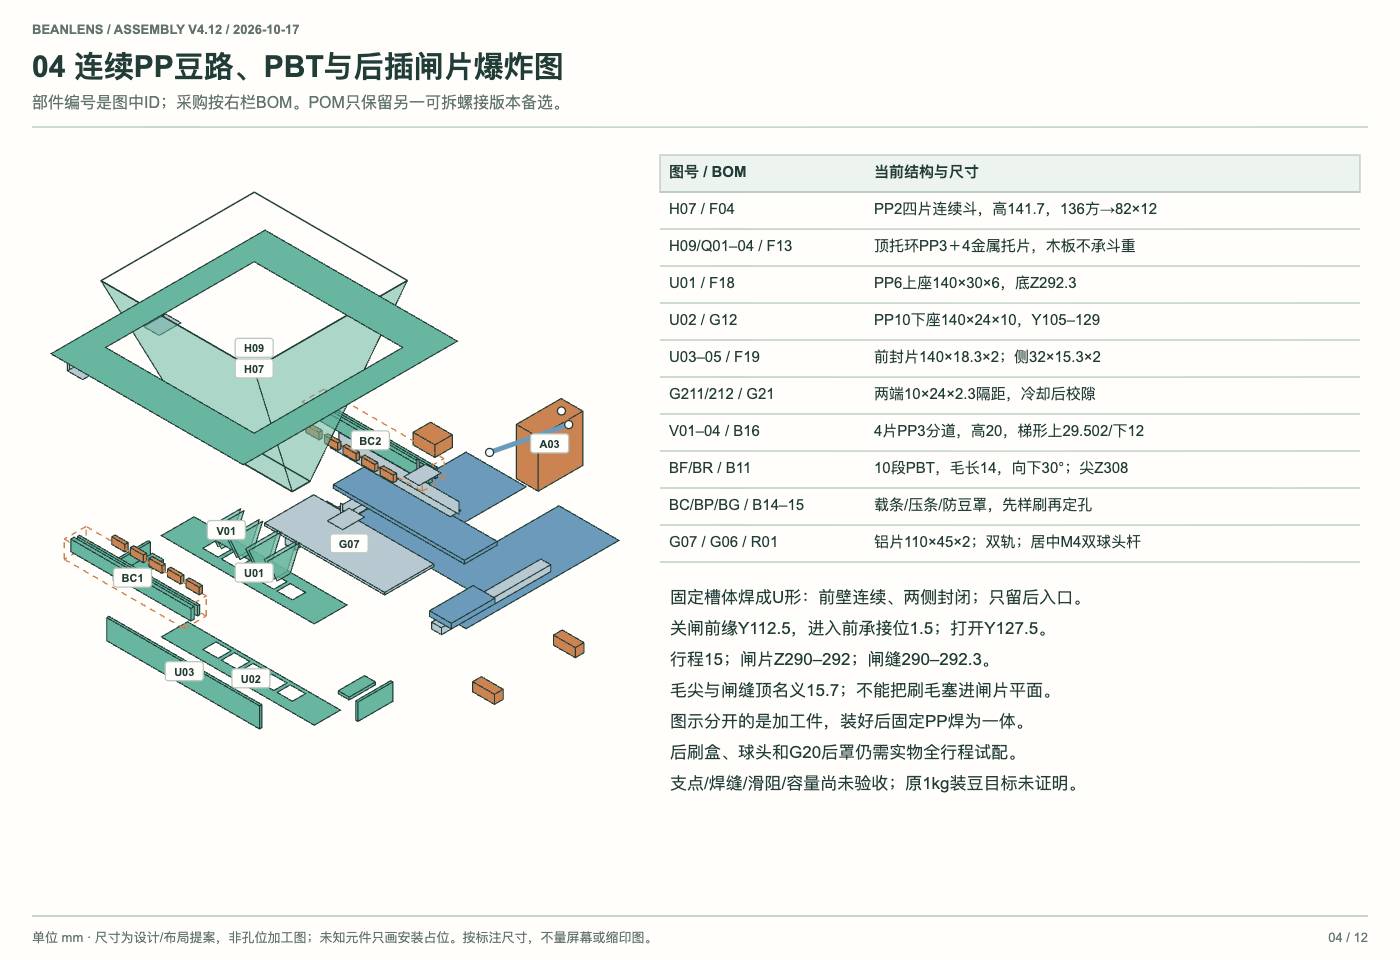
docs/hardware/assembly-v4.12/04-feed-gate.png
