koffja/Beanlens/docs/hardware/assembly-v4.12/06-assembly-order.png

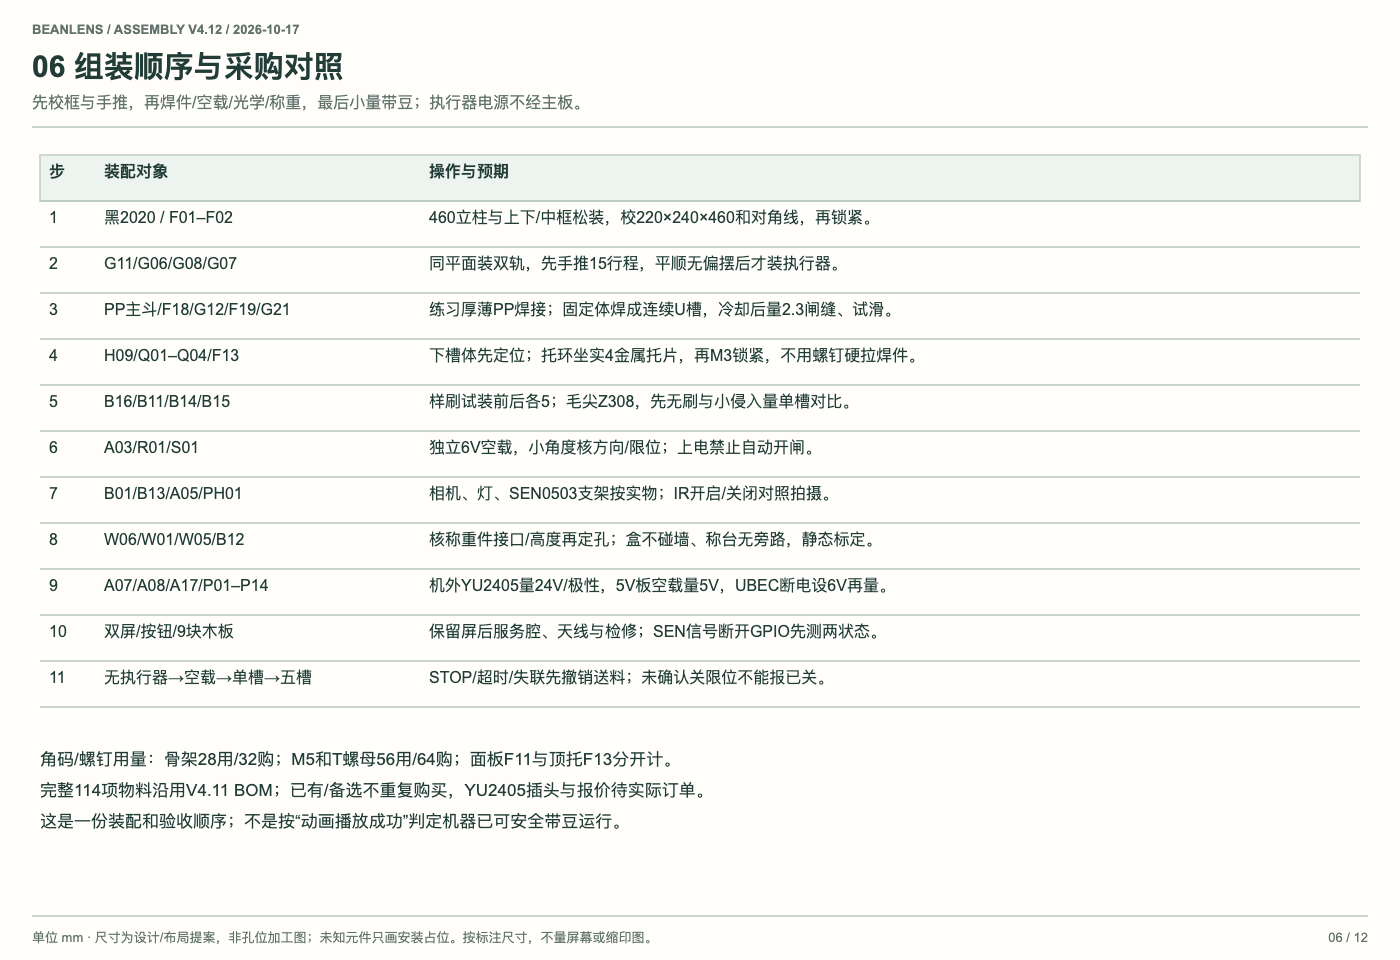
docs/hardware/assembly-v4.12/06-assembly-order.png
