koffja/Beanlens/docs/hardware/assembly-v4.12/07-connections.png

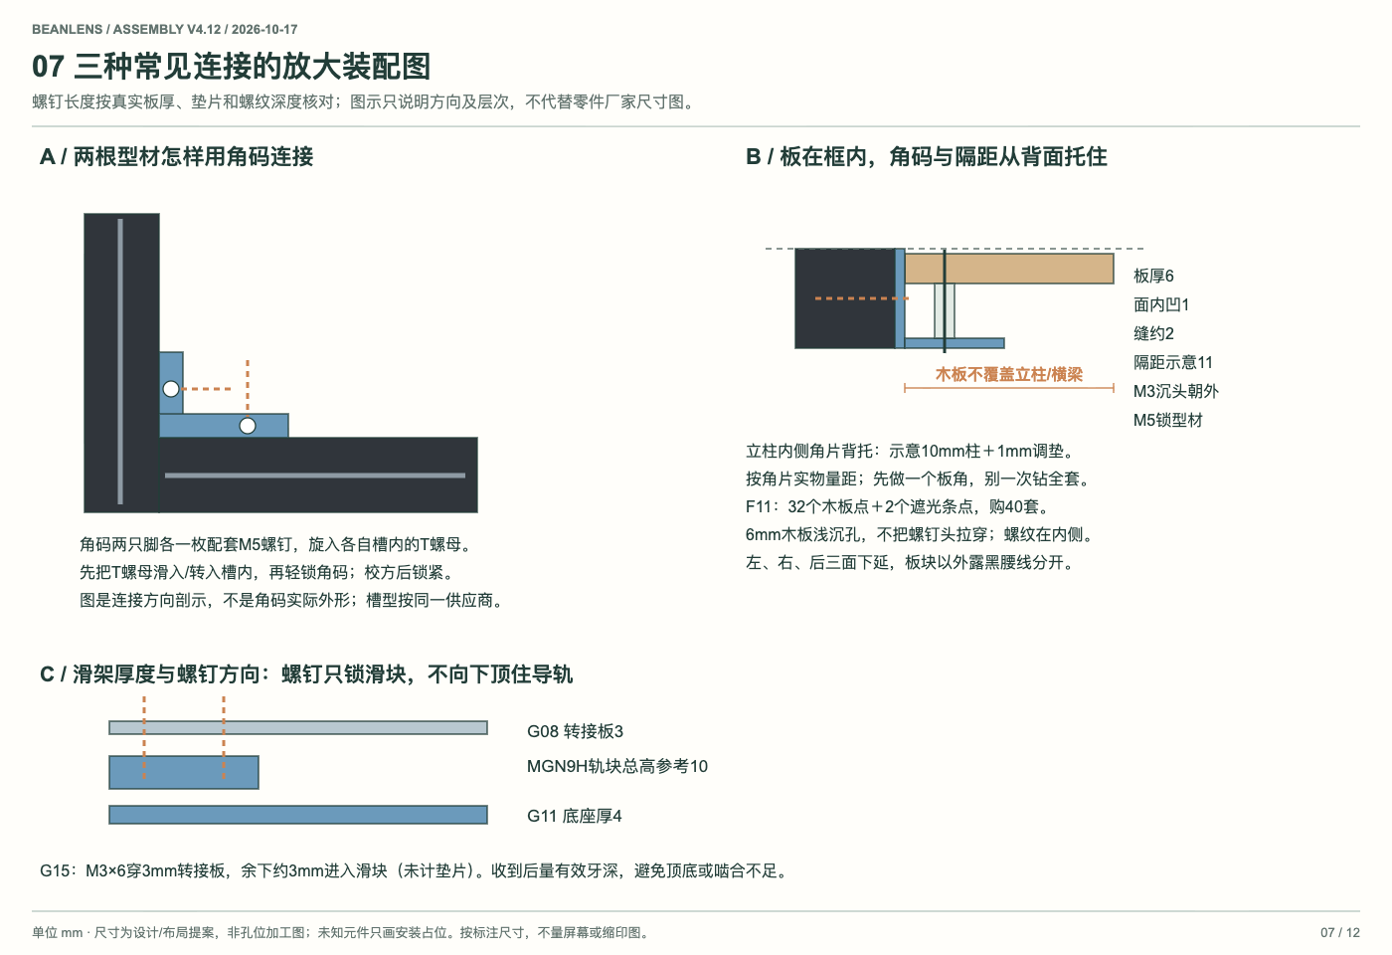
docs/hardware/assembly-v4.12/07-connections.png
