koffja/Beanlens/docs/hardware/assembly-v4.12/09-clearance.png

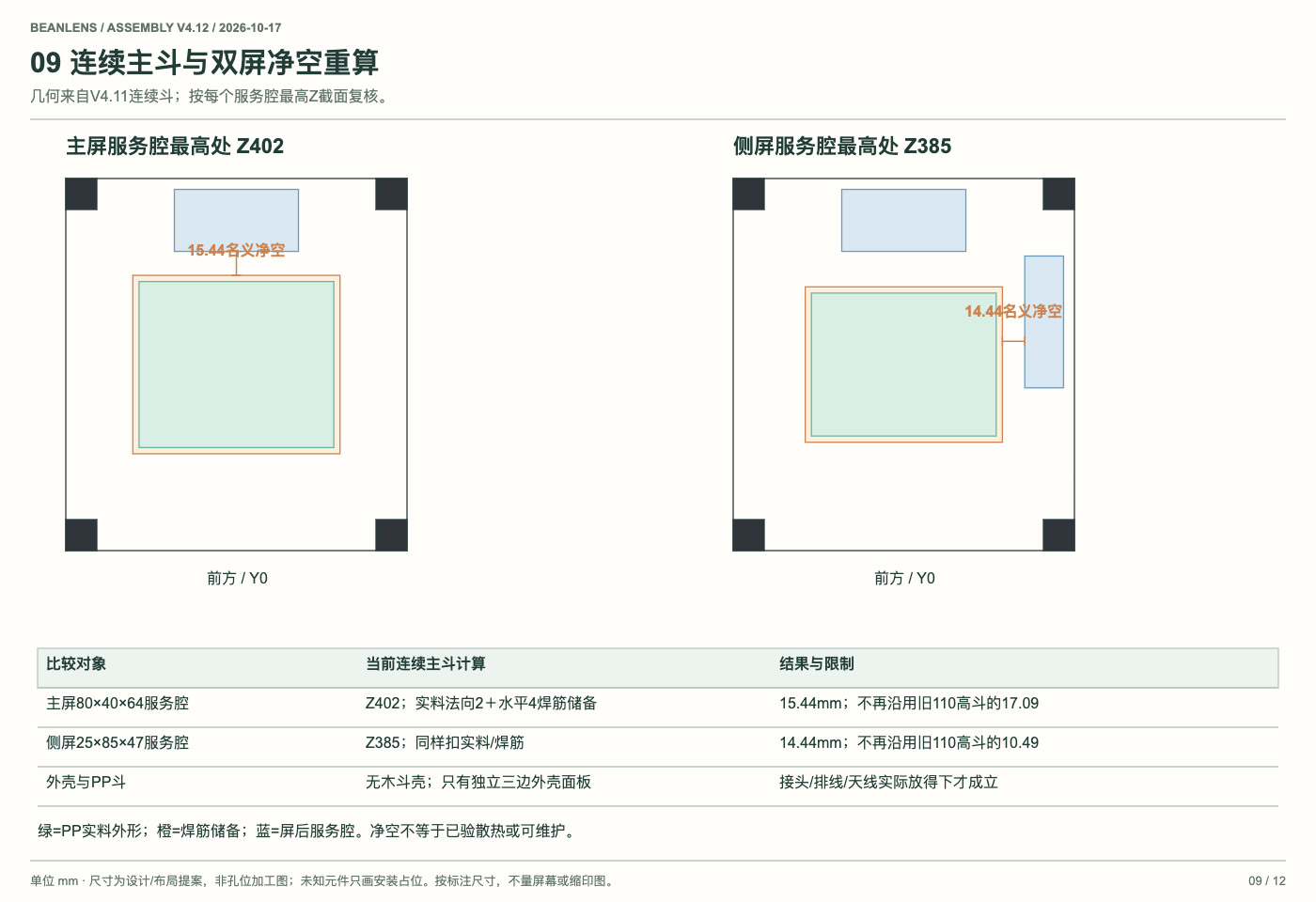
docs/hardware/assembly-v4.12/09-clearance.png
