koffja/Beanlens/docs/hardware/assembly-v4.12/10-interface-audit.png

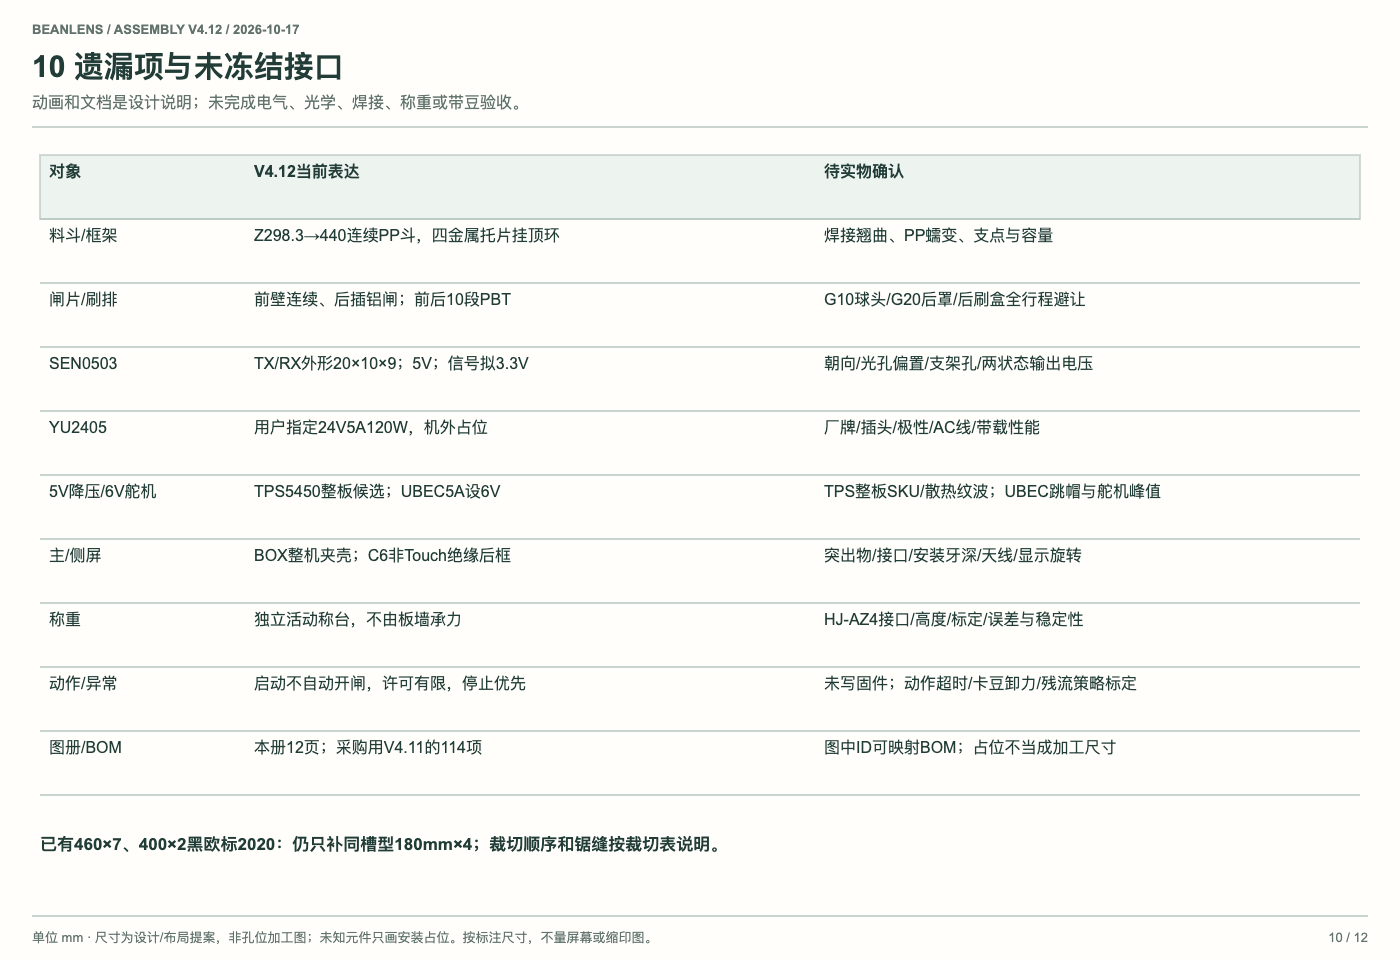
docs/hardware/assembly-v4.12/10-interface-audit.png
