koffja/Beanlens/docs/hardware/assembly-v4.12/11-power-wiring.png

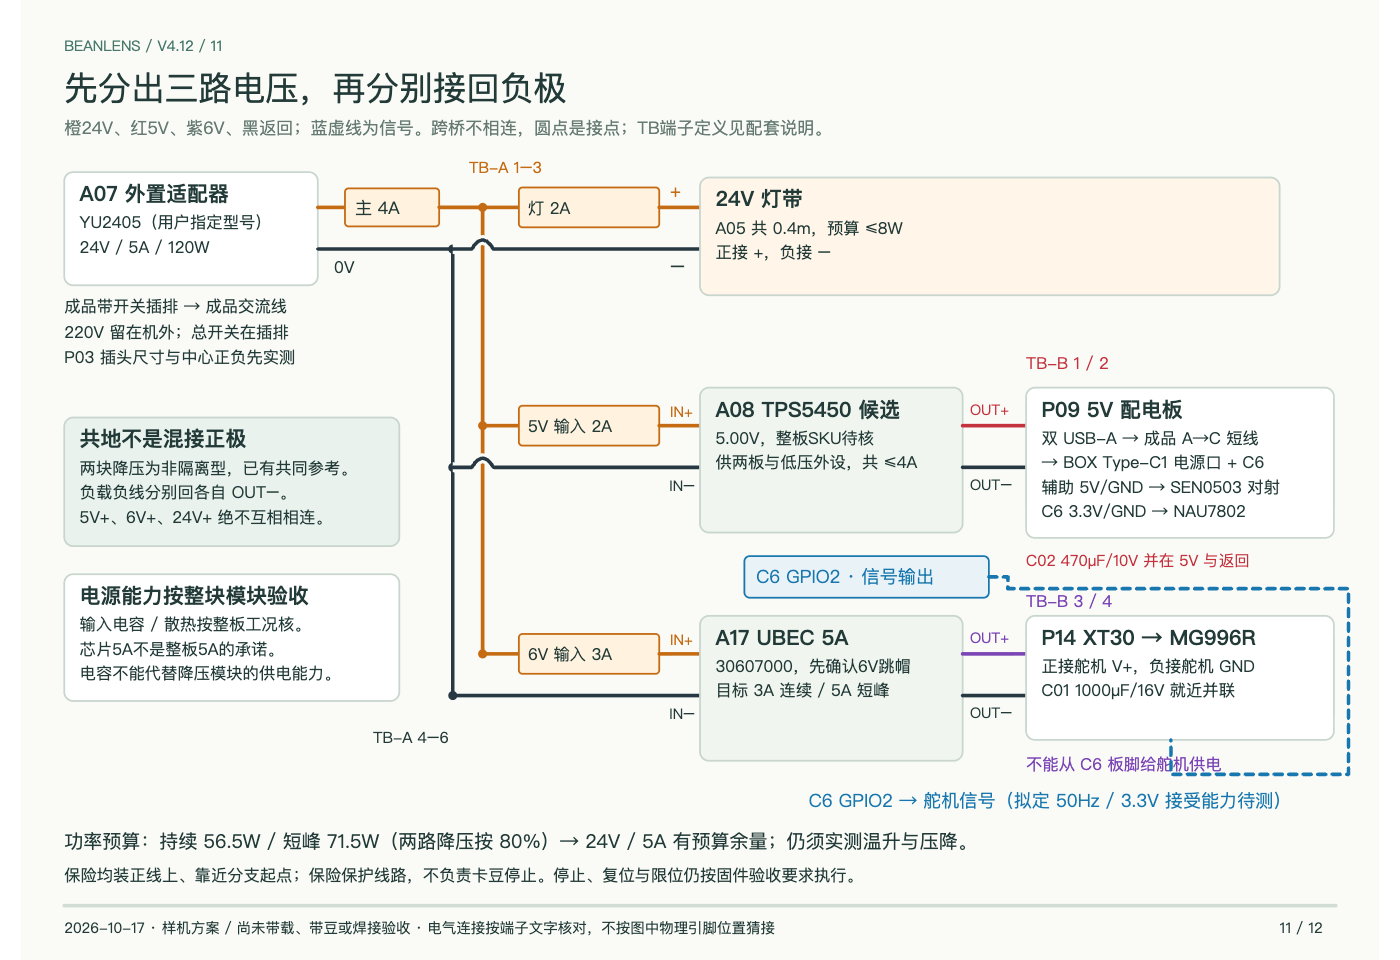
docs/hardware/assembly-v4.12/11-power-wiring.png
