koffja/Beanlens/docs/hardware/assembly-v4.12/12-sensor-wiring.png

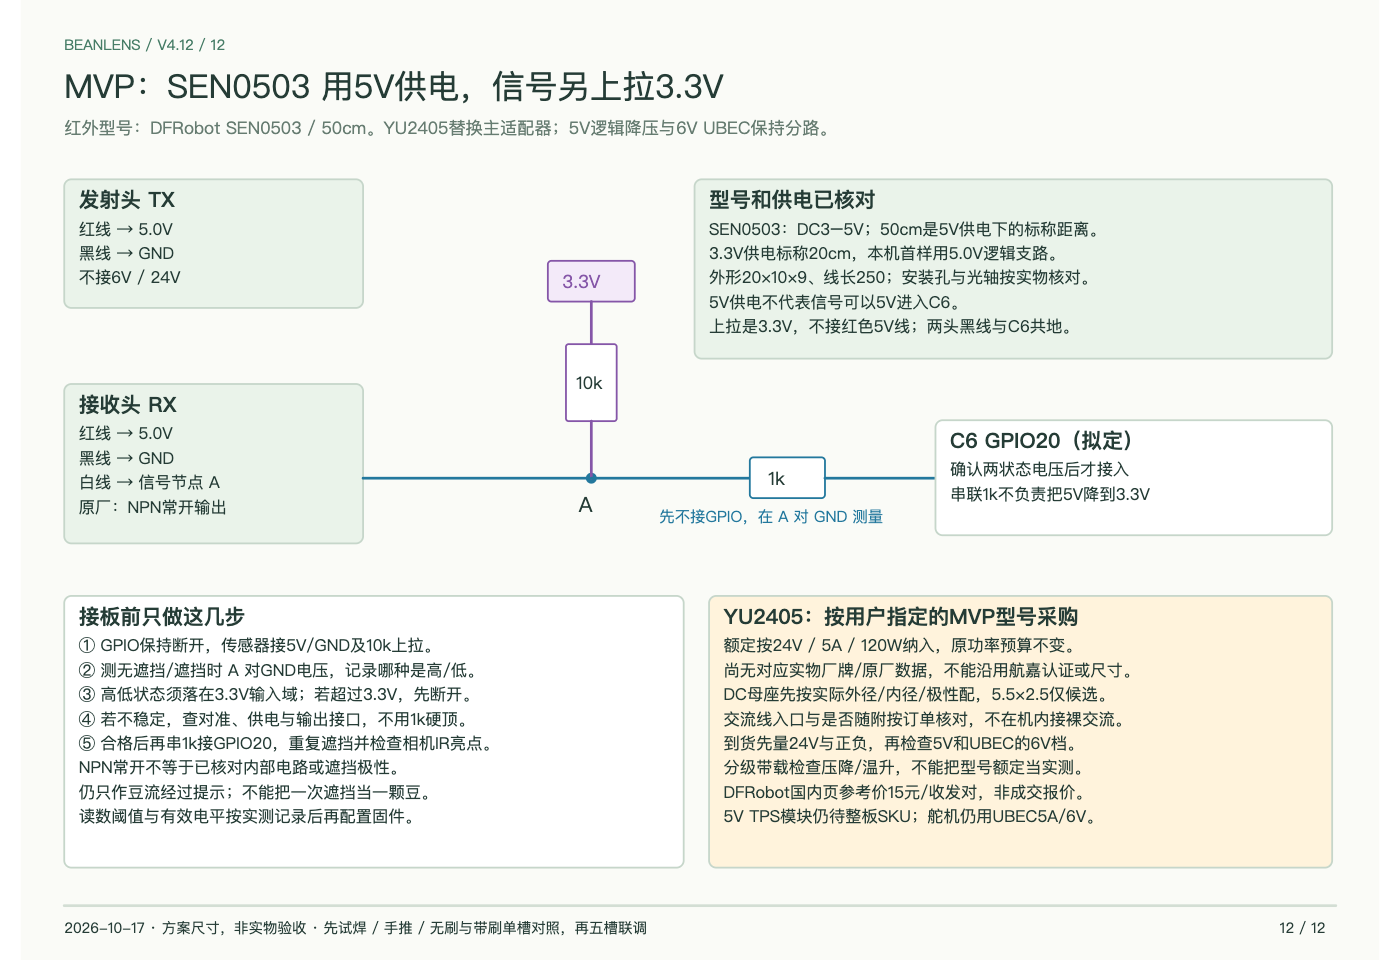
docs/hardware/assembly-v4.12/12-sensor-wiring.png
