koffja/Beanlens/docs/hardware/assembly-v4.12/operation-mobile.png

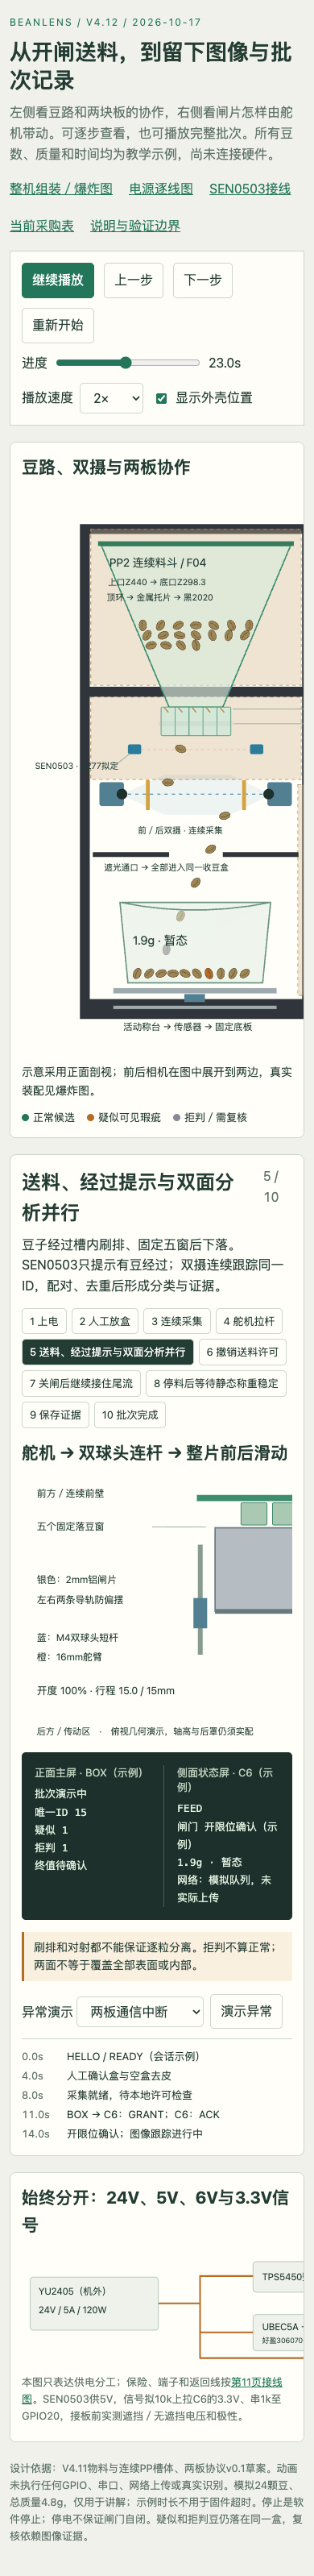
docs/hardware/assembly-v4.12/operation-mobile.png
