koffja/Beanlens/docs/hardware/assembly-v4.12/operation-running-desktop.png

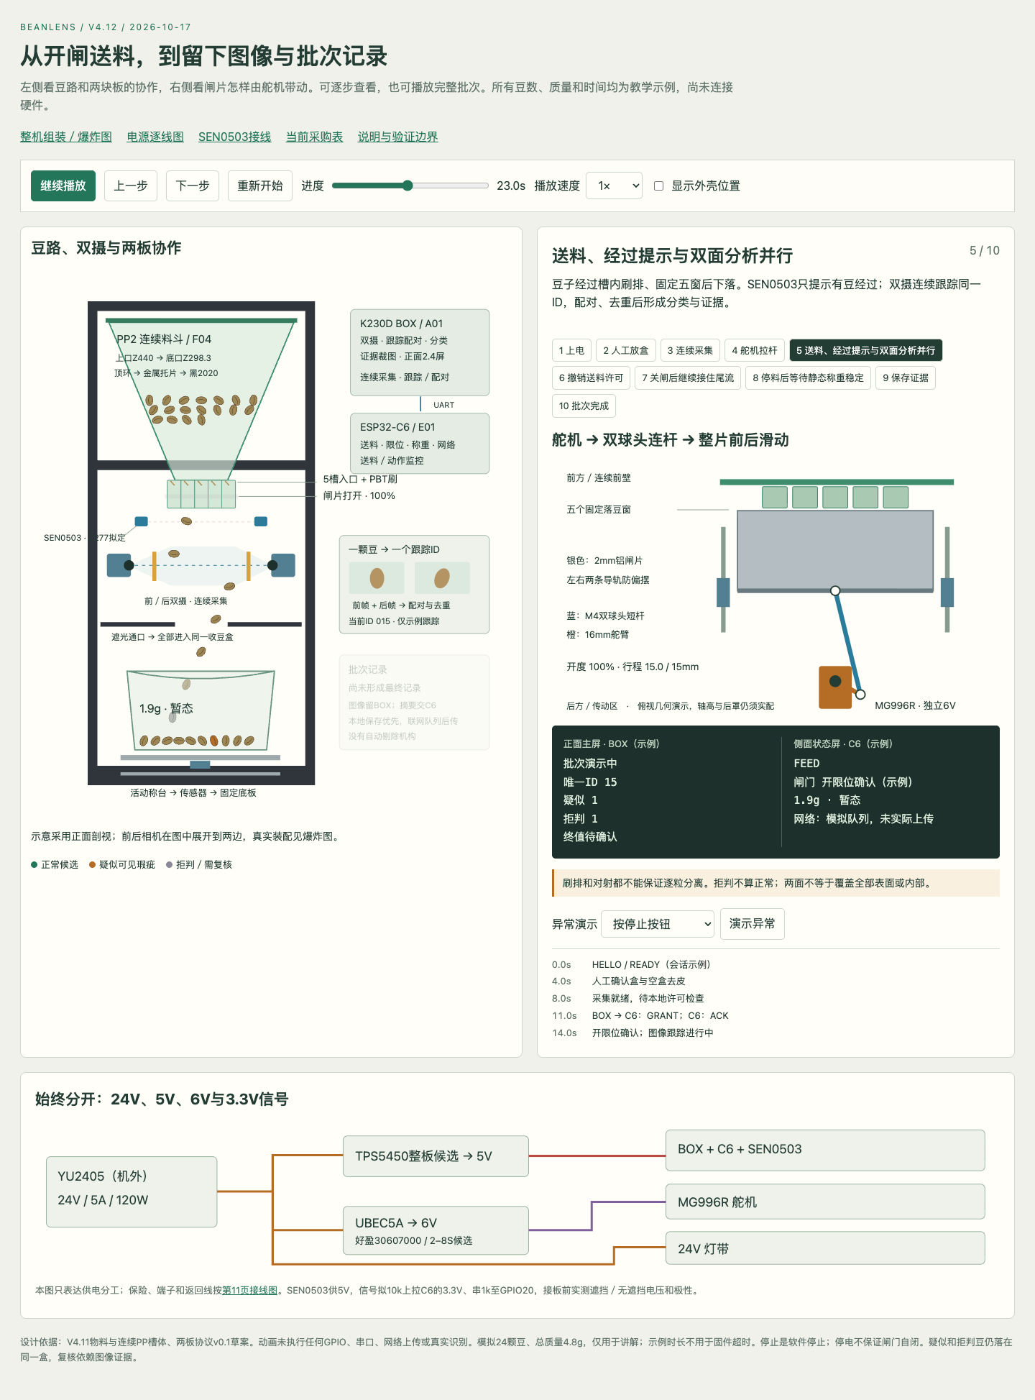
docs/hardware/assembly-v4.12/operation-running-desktop.png
