koffja/Beanlens/docs/hardware/fabrication-v4.8/flat-stock-v4.8.png

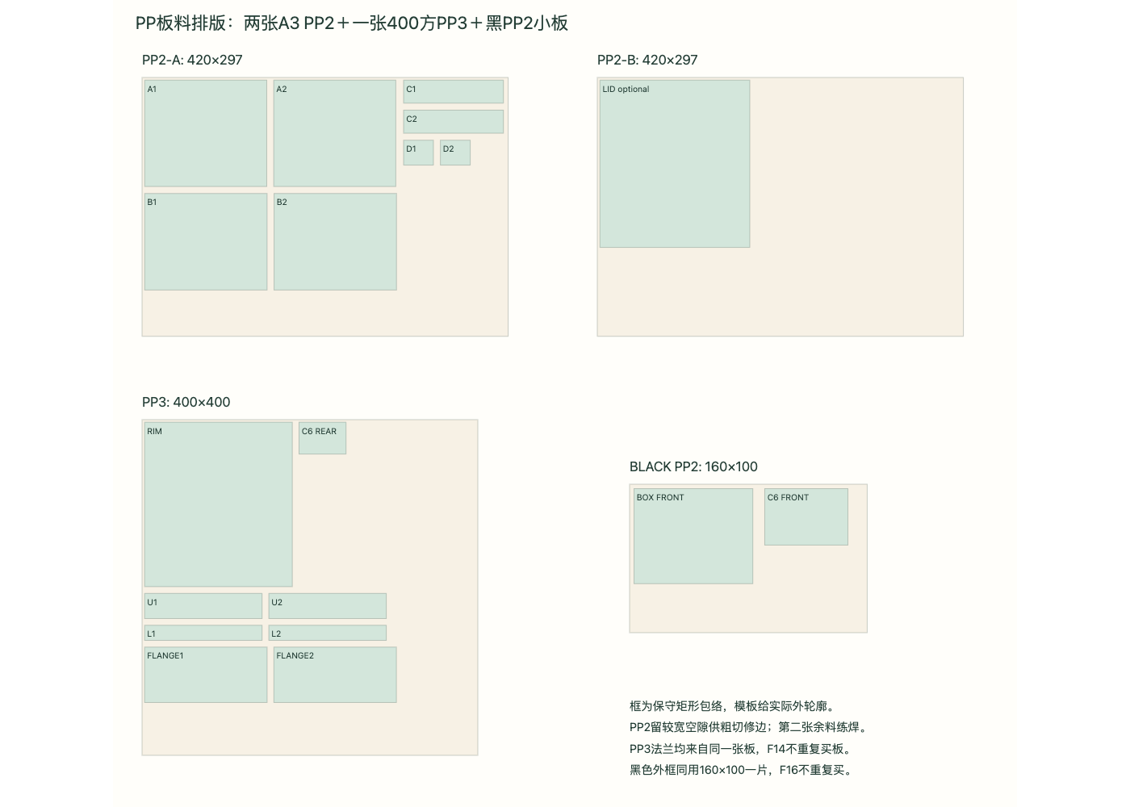
docs/hardware/fabrication-v4.8/flat-stock-v4.8.png
