koffja/Beanlens/docs/hardware/fabrication-v4.8/joint-detail-v4.8.png

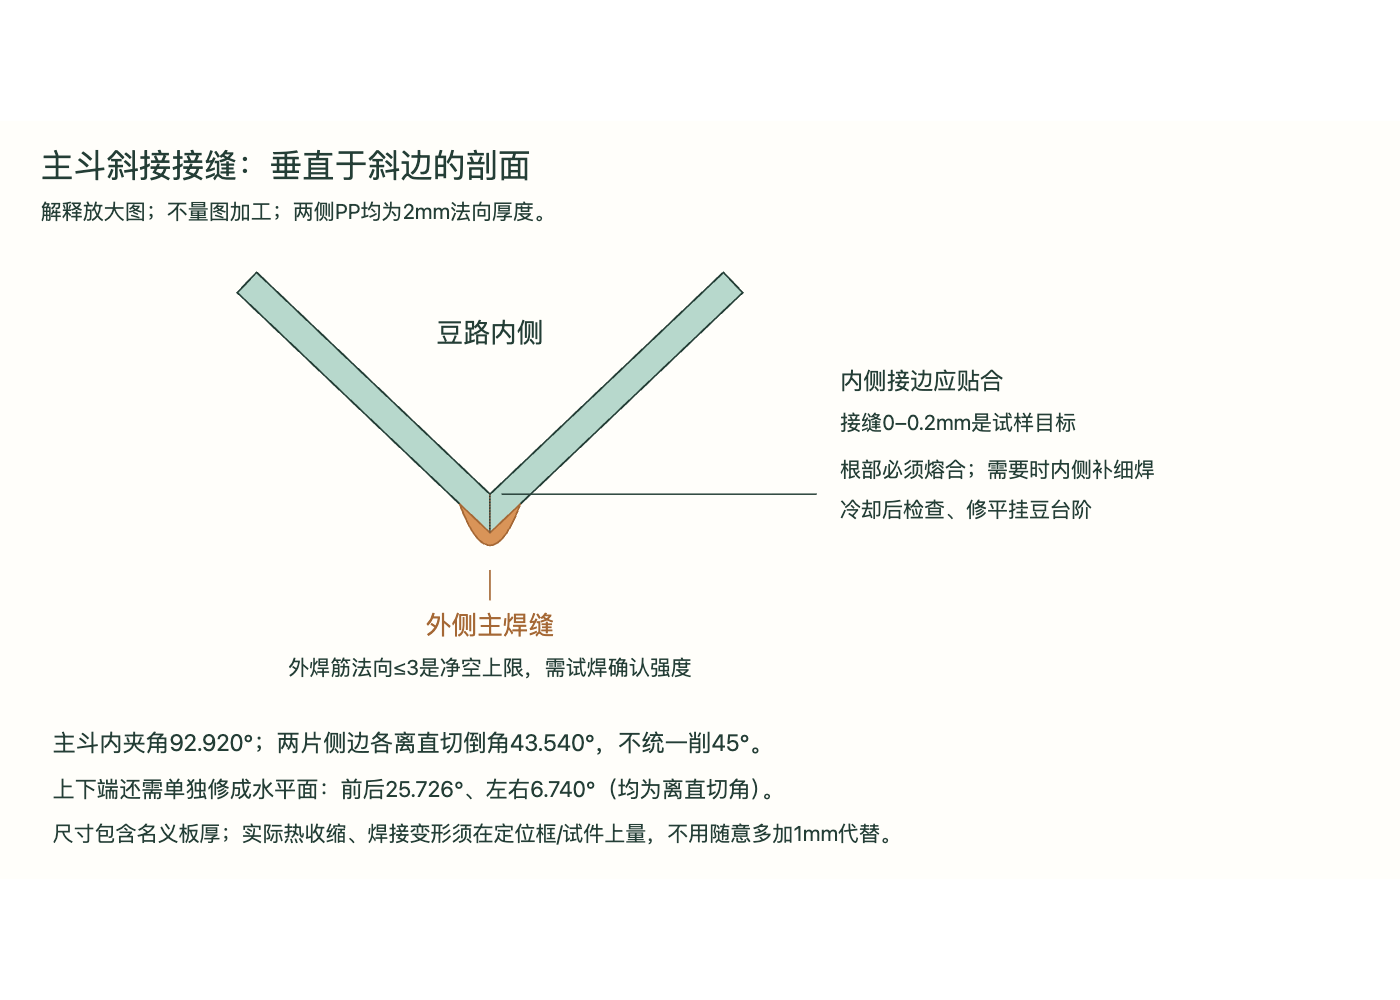
docs/hardware/fabrication-v4.8/joint-detail-v4.8.png
