koffja/Beanlens/docs/hardware/fabrication-v4.8/template-02.png

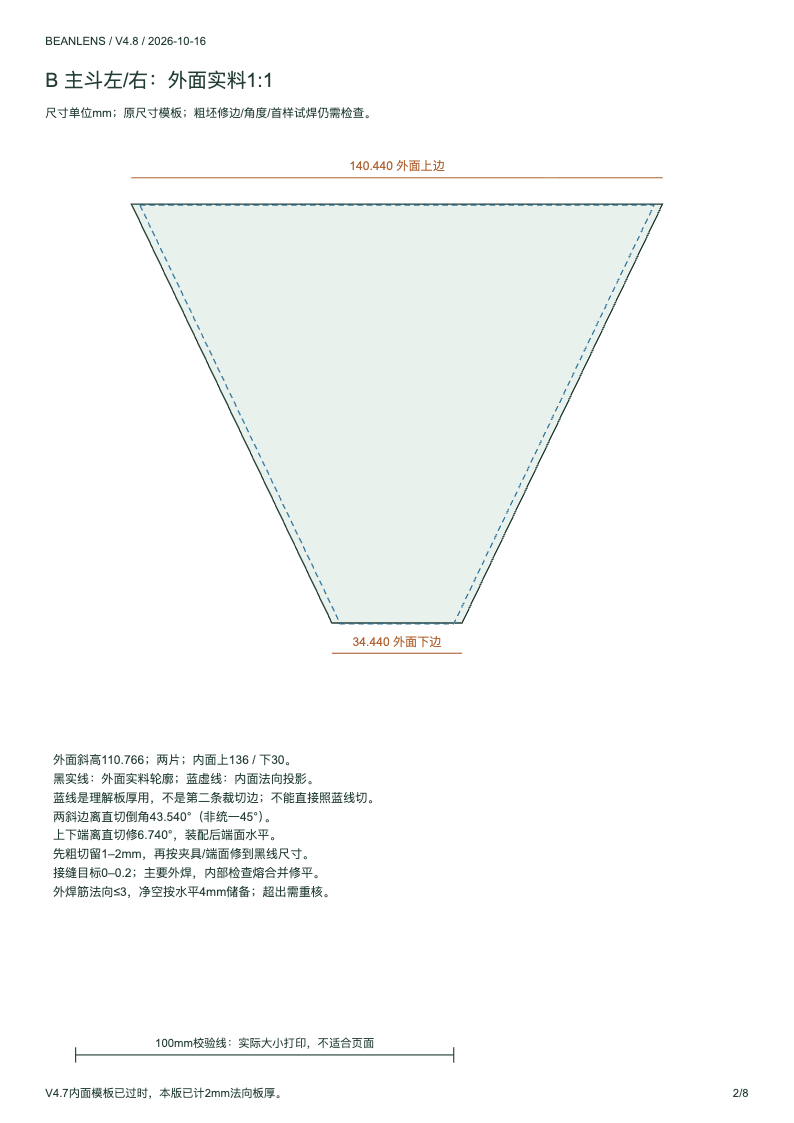
docs/hardware/fabrication-v4.8/template-02.png
