koffja/Beanlens/docs/hardware/fabrication-v4.8/template-03.png

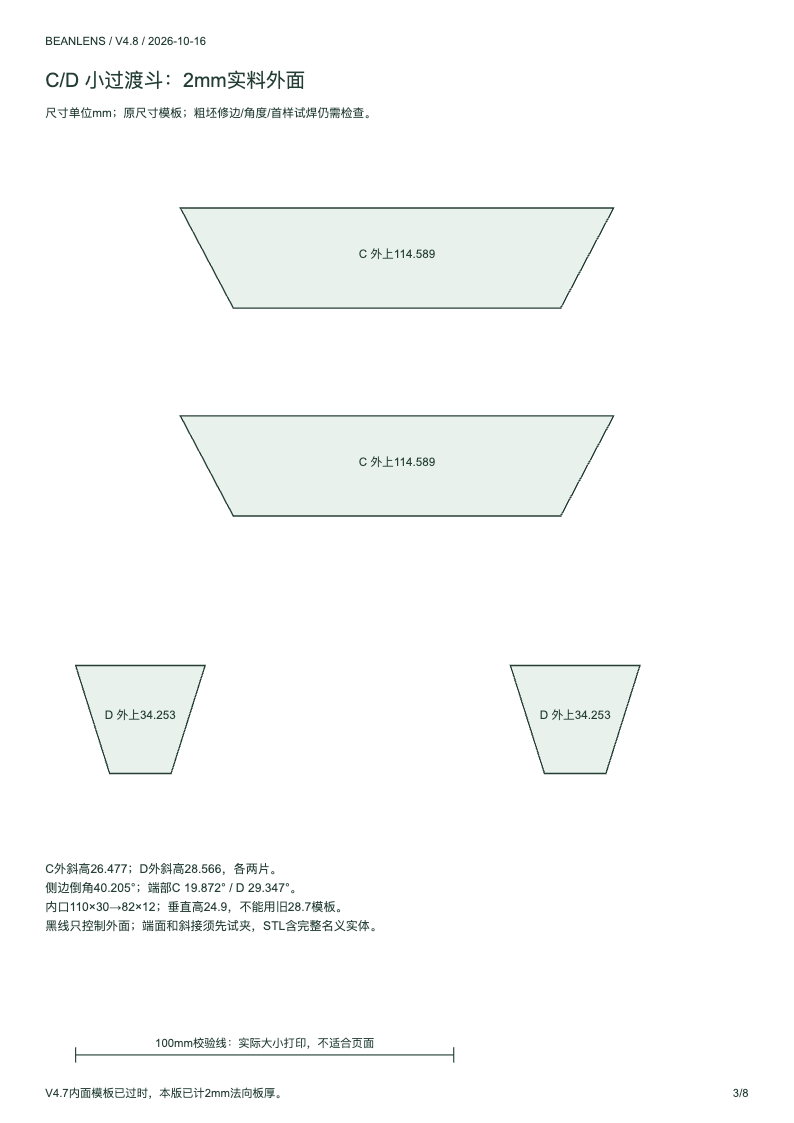
docs/hardware/fabrication-v4.8/template-03.png
