koffja/Beanlens/docs/hardware/fabrication-v4.8/template-04.png

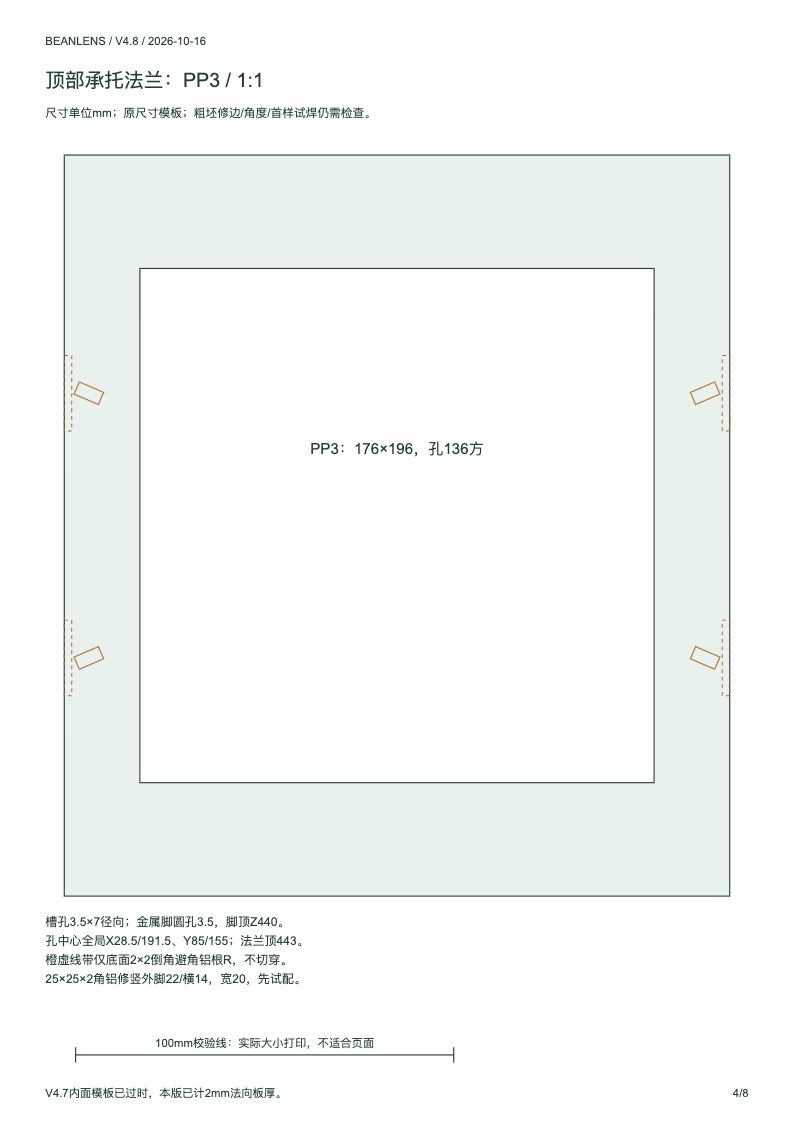
docs/hardware/fabrication-v4.8/template-04.png
