koffja/Beanlens/docs/hardware/fabrication-v4.8/template-05.png

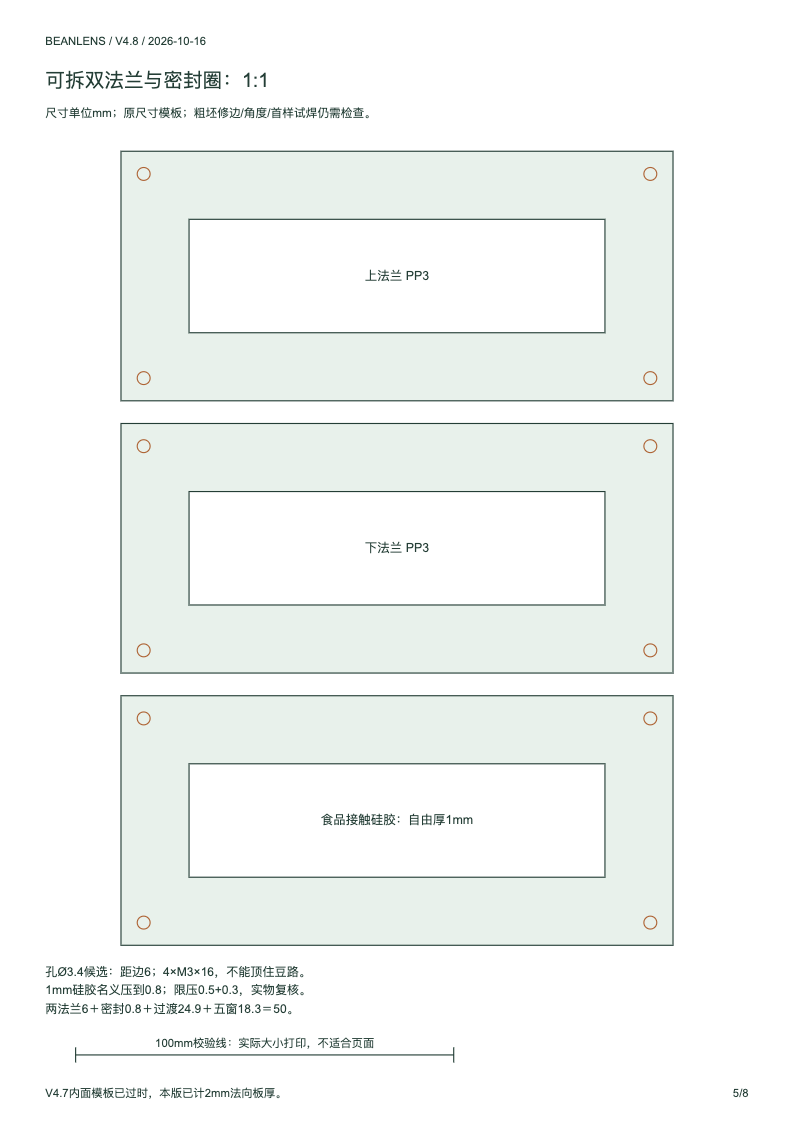
docs/hardware/fabrication-v4.8/template-05.png
