koffja/Beanlens/docs/hardware/fabrication-v4.8/template-06.png

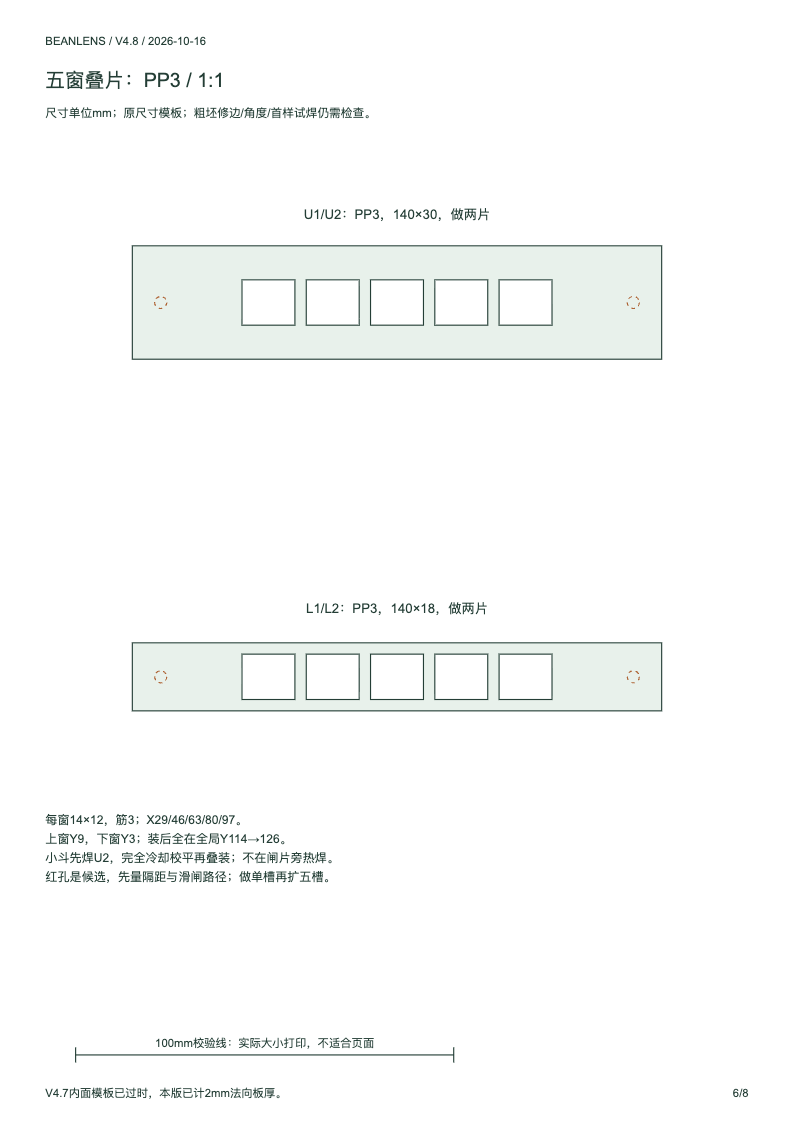
docs/hardware/fabrication-v4.8/template-06.png
