koffja/Beanlens/docs/hardware/fabrication-v4.8/template-07.png

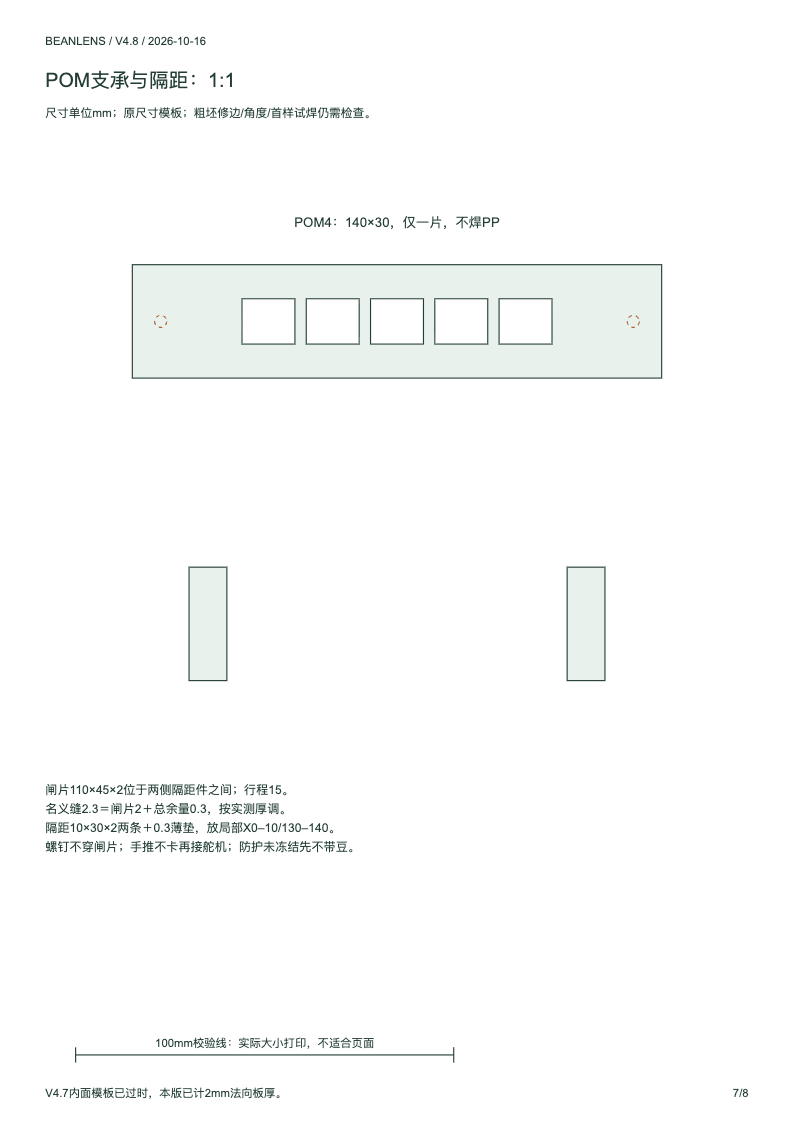
docs/hardware/fabrication-v4.8/template-07.png
