koffja/Beanlens/docs/hardware/fabrication-v4.8/template-08.png

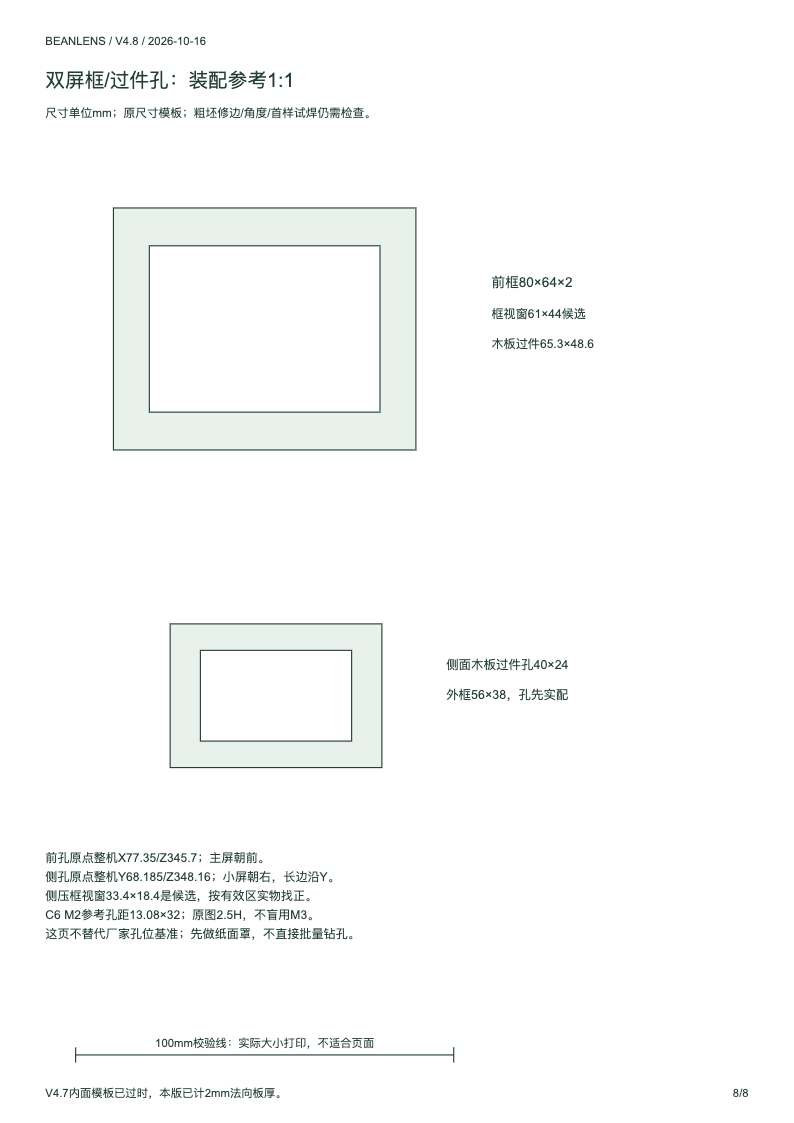
docs/hardware/fabrication-v4.8/template-08.png
