koffja/Beanlens/docs/hardware/hackathon-h1/operation-desktop.png

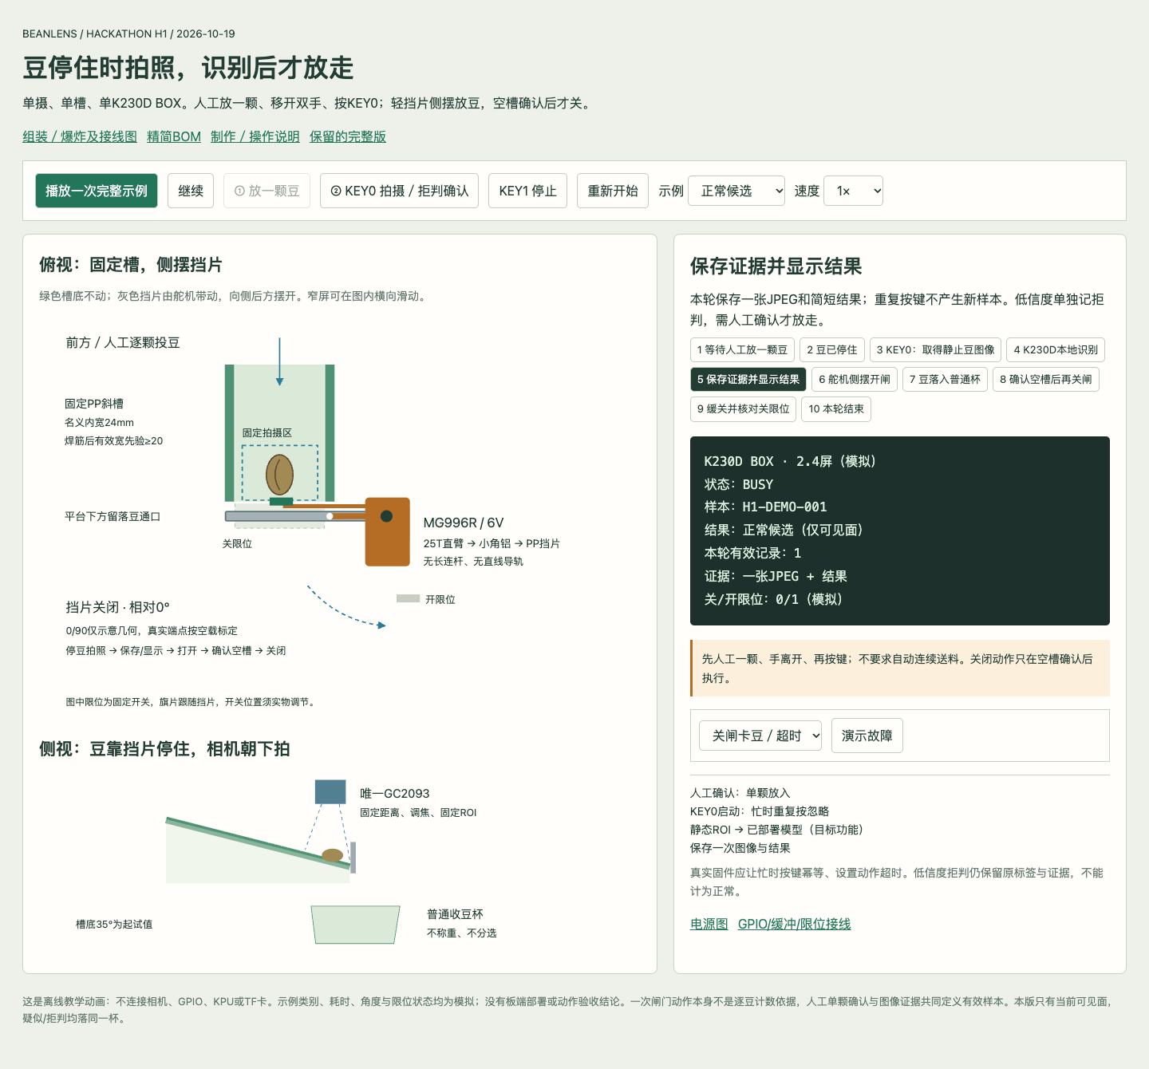
docs/hardware/hackathon-h1/operation-desktop.png
