koffja/Beanlens/docs/hardware/hackathon-h1/operation-mobile.png

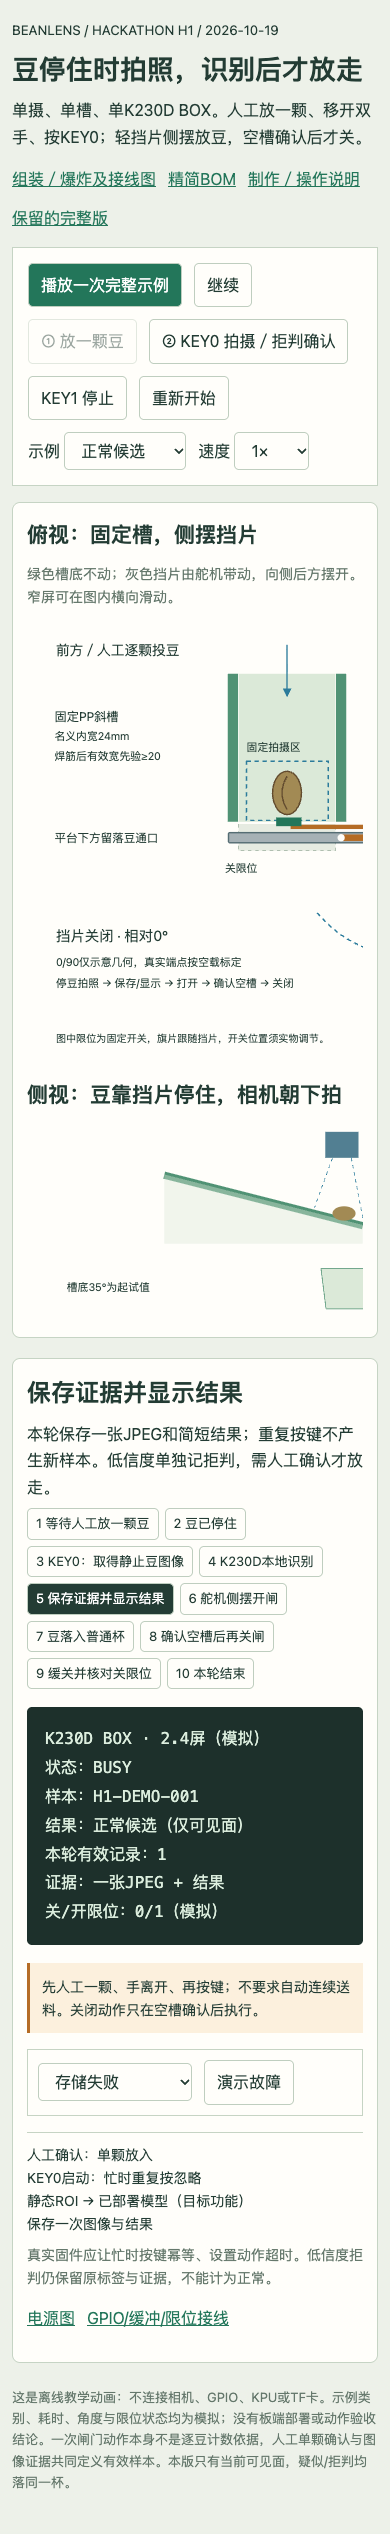
docs/hardware/hackathon-h1/operation-mobile.png
