koffja/Beanlens/docs/hardware/hackathon-h3/assembly-p4/preview-mobile.png

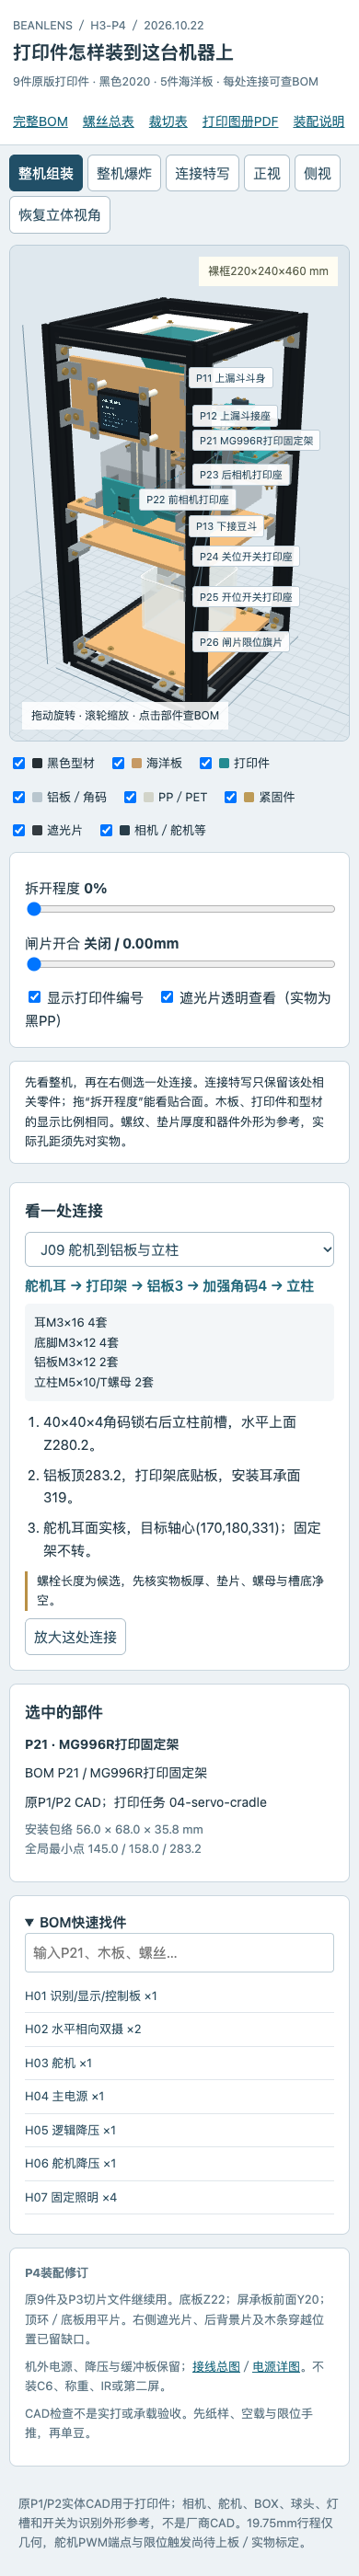
docs/hardware/hackathon-h3/assembly-p4/preview-mobile.png
