koffja/Beanlens/docs/hardware/hackathon-h3/assembly-p4/preview-servo.png

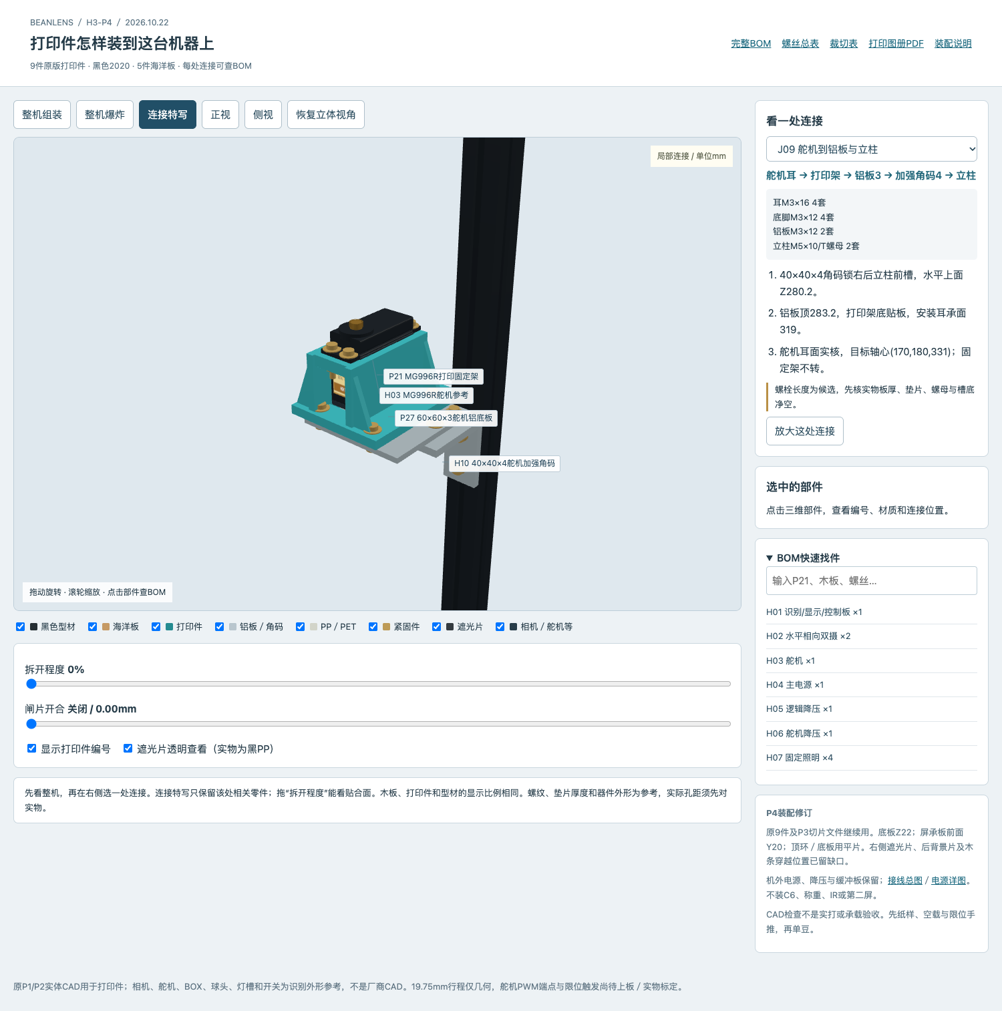
docs/hardware/hackathon-h3/assembly-p4/preview-servo.png
