koffja/Beanlens/docs/hardware/hackathon-h3/assembly-p4/preview-whole.png

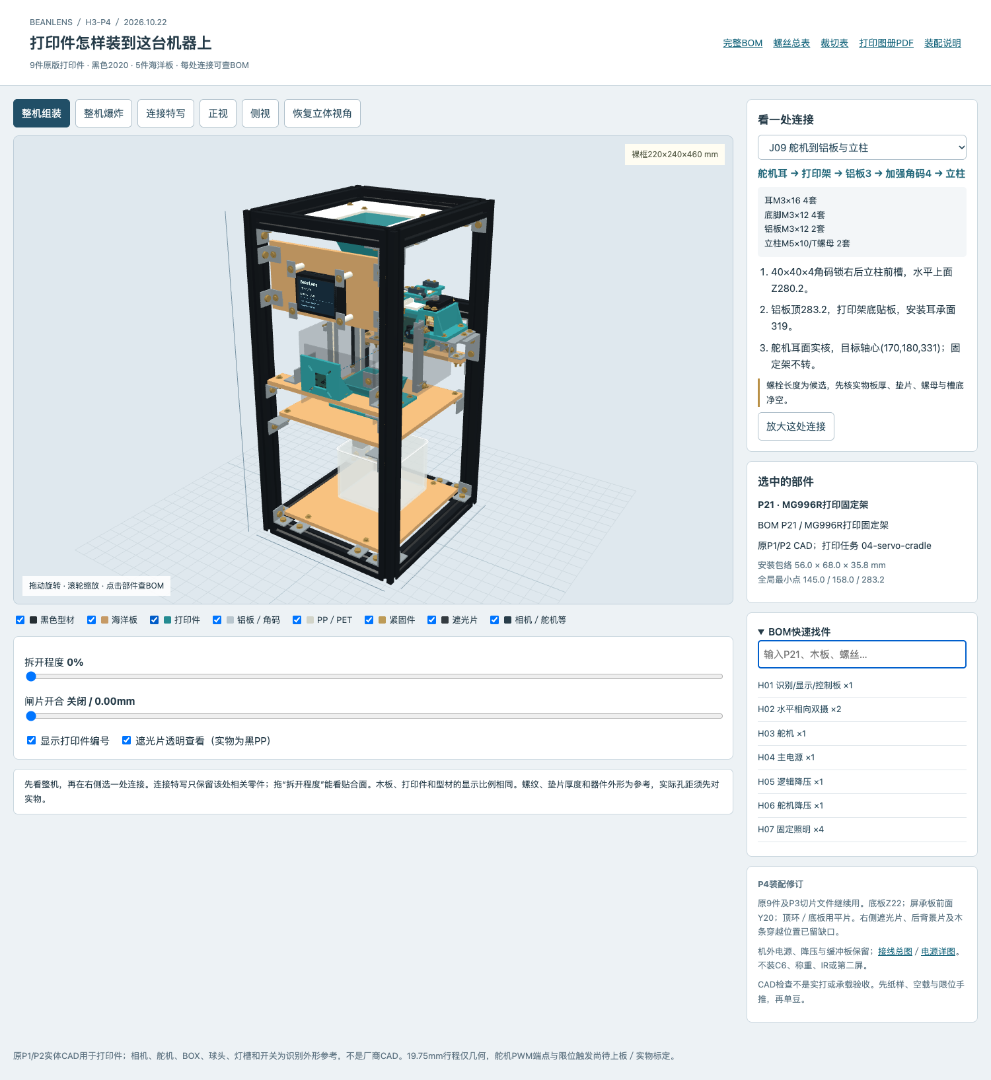
docs/hardware/hackathon-h3/assembly-p4/preview-whole.png
