koffja/Beanlens/docs/hardware/hackathon-h3/assembly-p4/shots/front.png

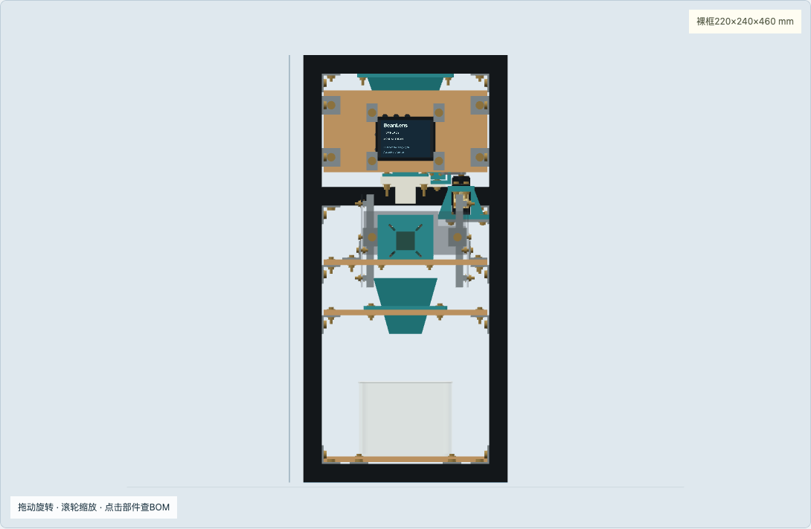
docs/hardware/hackathon-h3/assembly-p4/shots/front.png
