koffja/Beanlens/docs/hardware/hackathon-h3/assembly-p4/shots/J02-assembled.png

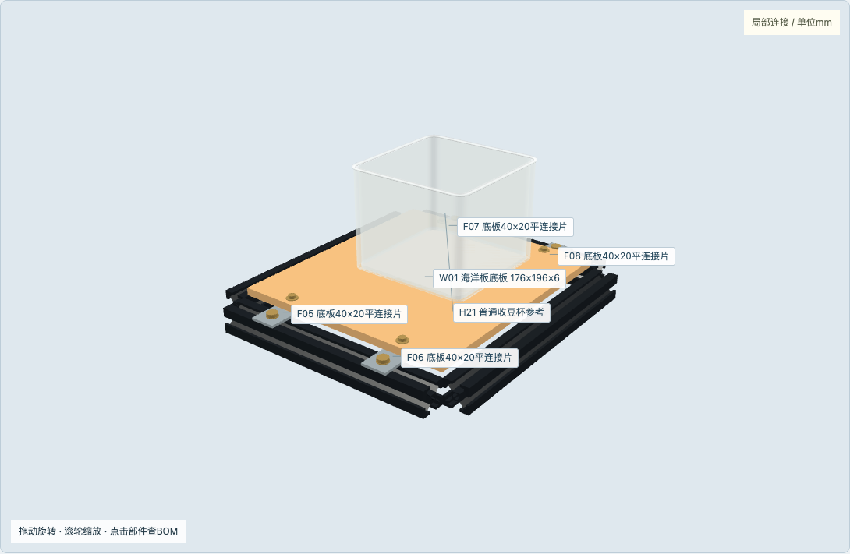
docs/hardware/hackathon-h3/assembly-p4/shots/J02-assembled.png
