koffja/Beanlens/docs/hardware/hackathon-h3/assembly-p4/shots/J03-exploded.png

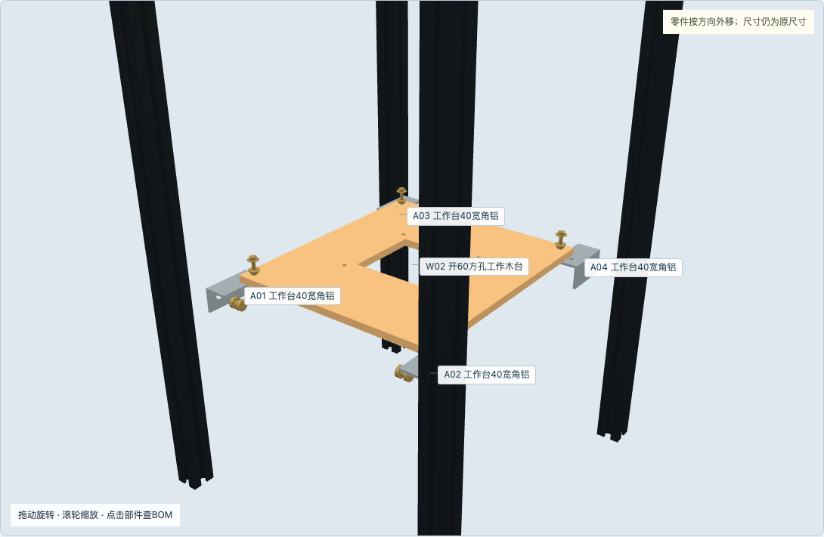
docs/hardware/hackathon-h3/assembly-p4/shots/J03-exploded.png
