koffja/Beanlens/docs/hardware/hackathon-h3/assembly-p4/shots/J04-exploded.png

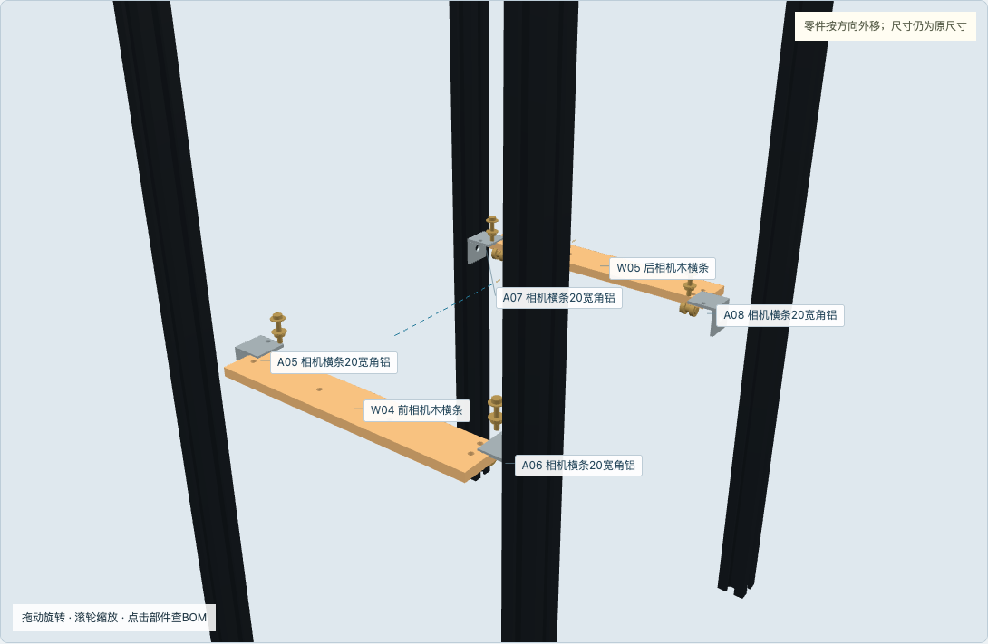
docs/hardware/hackathon-h3/assembly-p4/shots/J04-exploded.png
