koffja/Beanlens/docs/hardware/hackathon-h3/assembly-p4/shots/J05-exploded.png

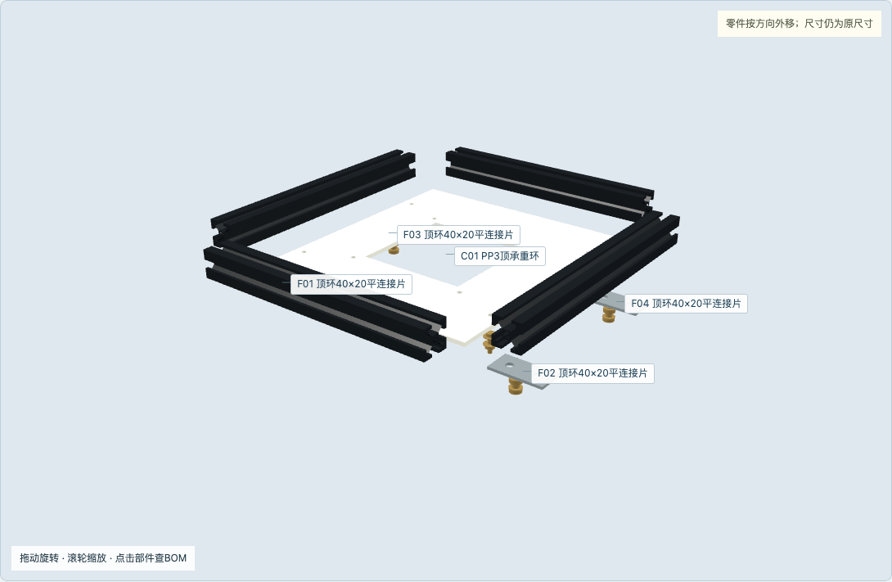
docs/hardware/hackathon-h3/assembly-p4/shots/J05-exploded.png
