koffja/Beanlens/docs/hardware/hackathon-h3/assembly-p4/shots/J11-exploded.png

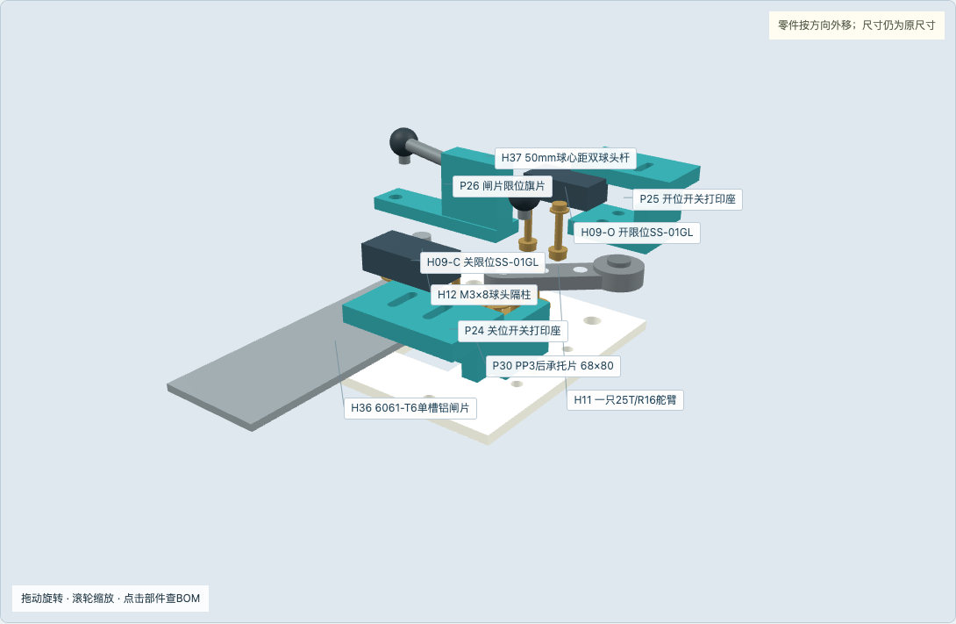
docs/hardware/hackathon-h3/assembly-p4/shots/J11-exploded.png
