koffja/Beanlens/docs/hardware/hackathon-h3/printing-bambu-p3/dashboard-desktop.png

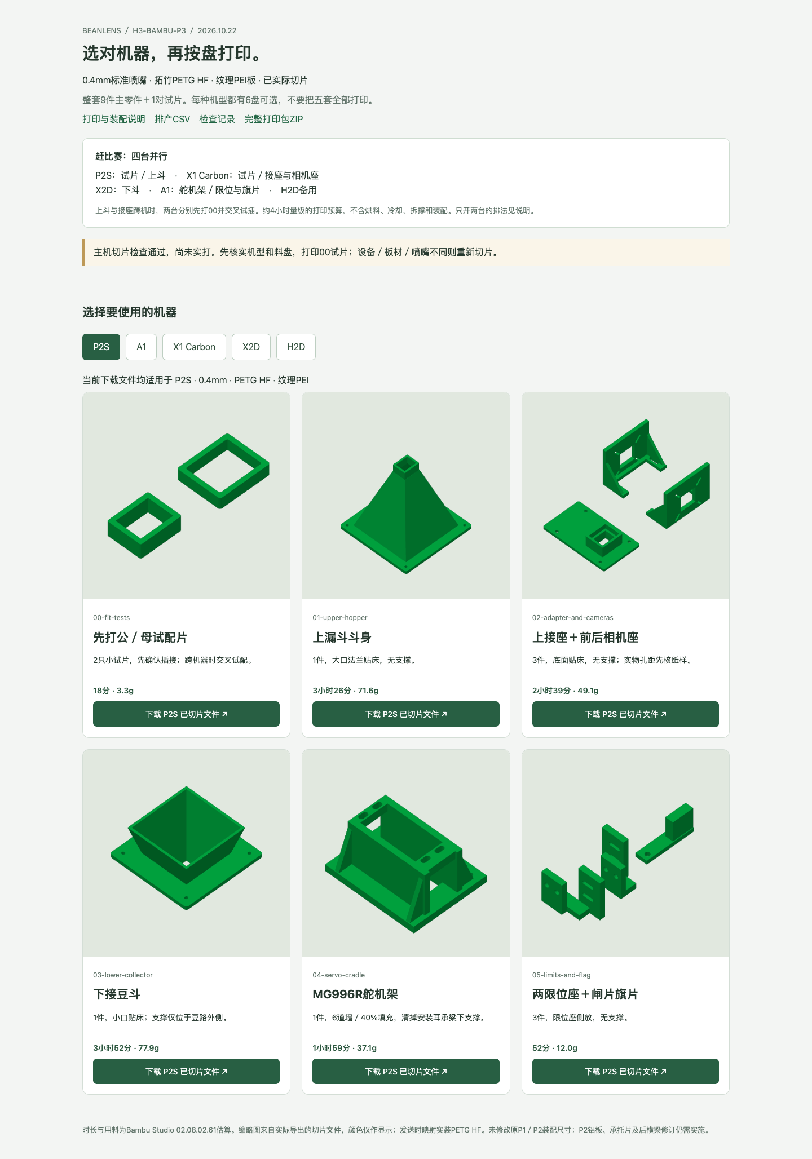
docs/hardware/hackathon-h3/printing-bambu-p3/dashboard-desktop.png
