koffja/Beanlens/docs/hardware/hackathon-h3/printing-bambu-p3/dashboard-mobile.png

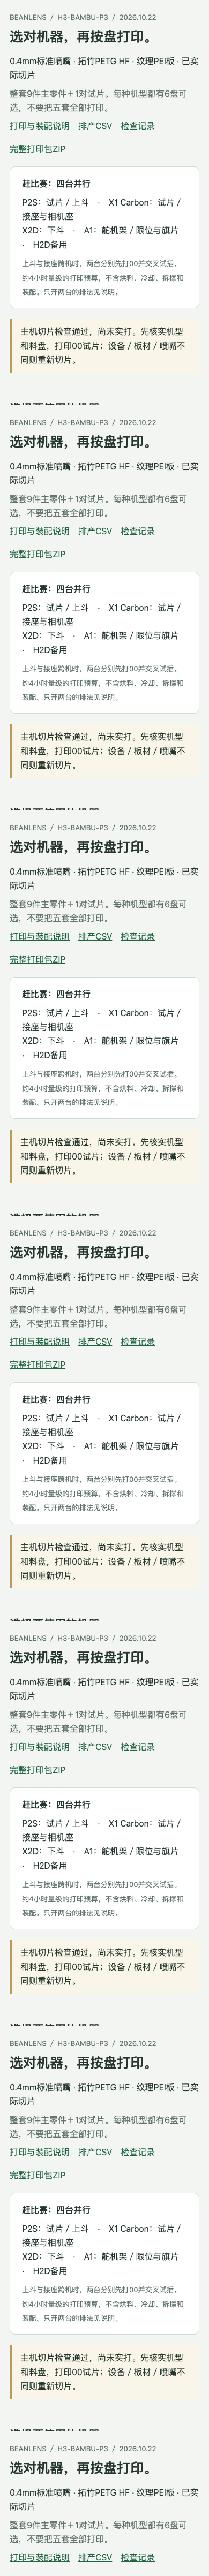
docs/hardware/hackathon-h3/printing-bambu-p3/dashboard-mobile.png
