koffja/Beanlens/docs/hardware/hackathon-h3/printing-p1/BeanLens-H3-P1/preview-lower-collector-mm.png

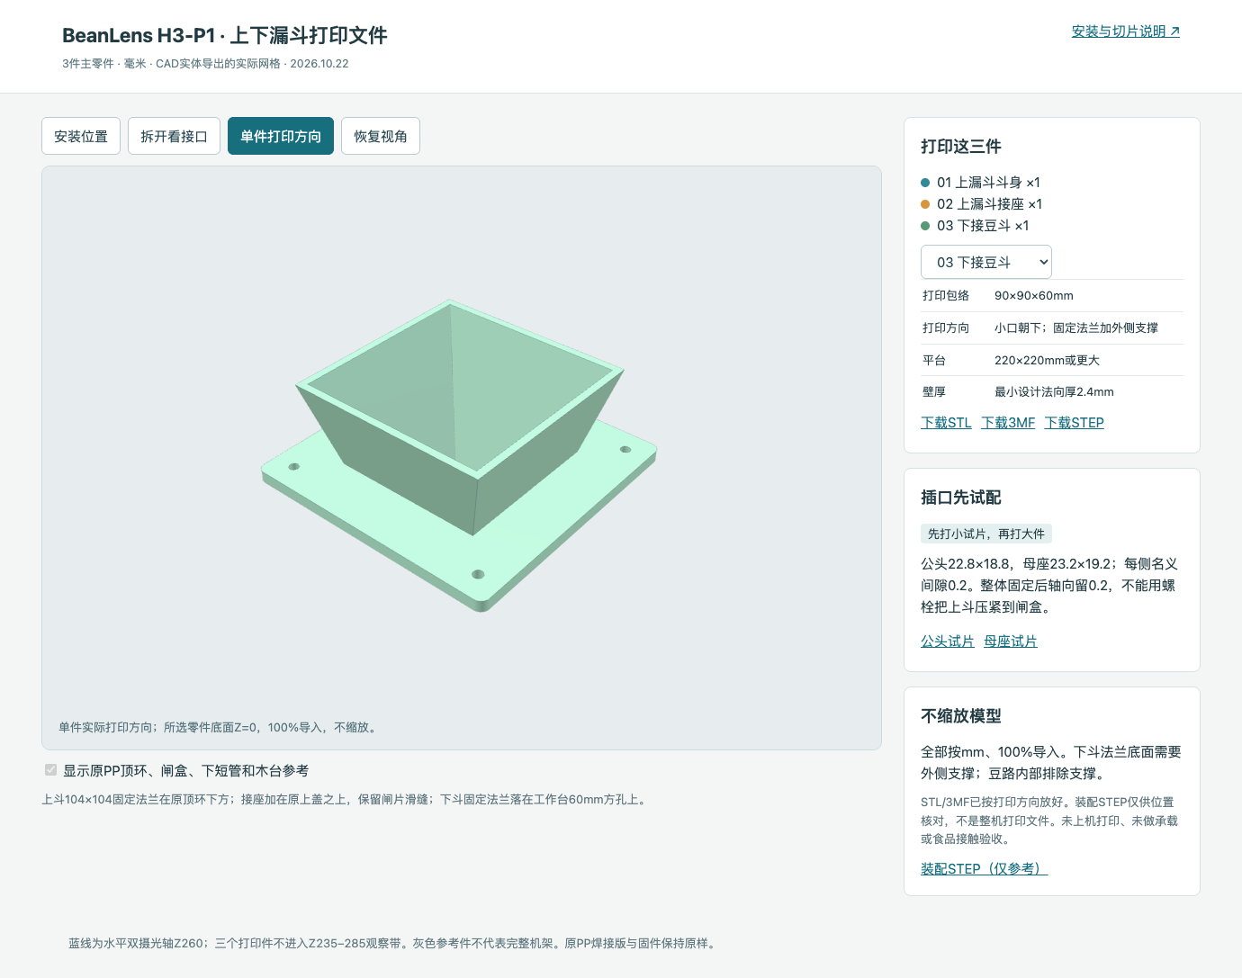
docs/hardware/hackathon-h3/printing-p1/BeanLens-H3-P1/preview-lower-collector-mm.png
