koffja/Beanlens/docs/hardware/hackathon-h3/printing-p1/BeanLens-H3-P1/preview-mobile.png

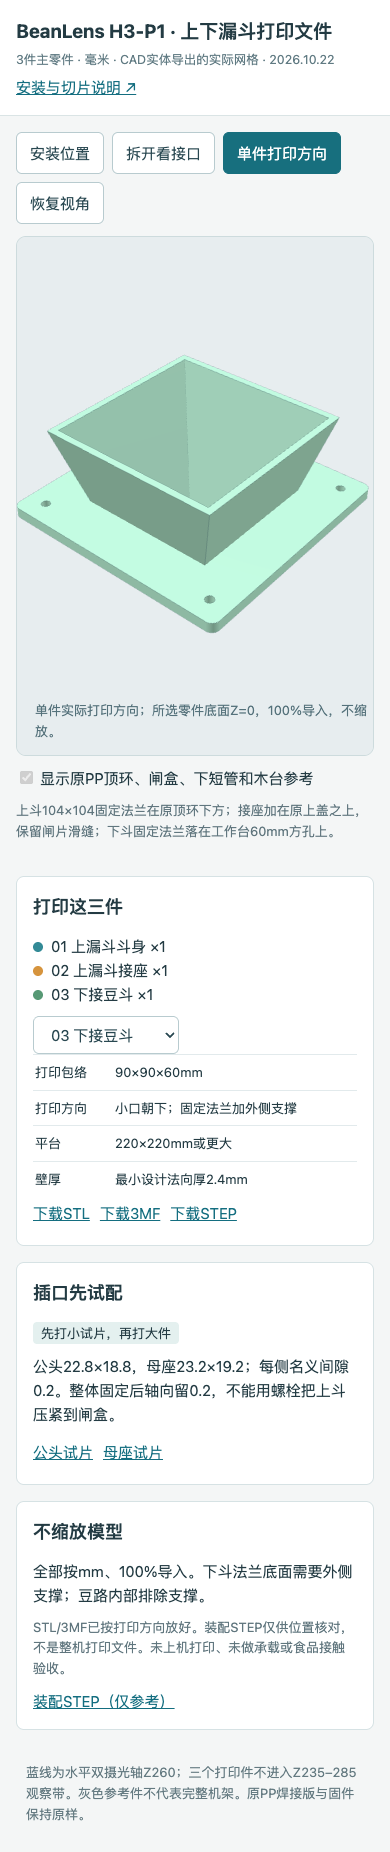
docs/hardware/hackathon-h3/printing-p1/BeanLens-H3-P1/preview-mobile.png
