koffja/Beanlens/docs/hardware/hackathon-h3/printing-p1/BeanLens-H3-P1/preview-upper-adapter-mm.png

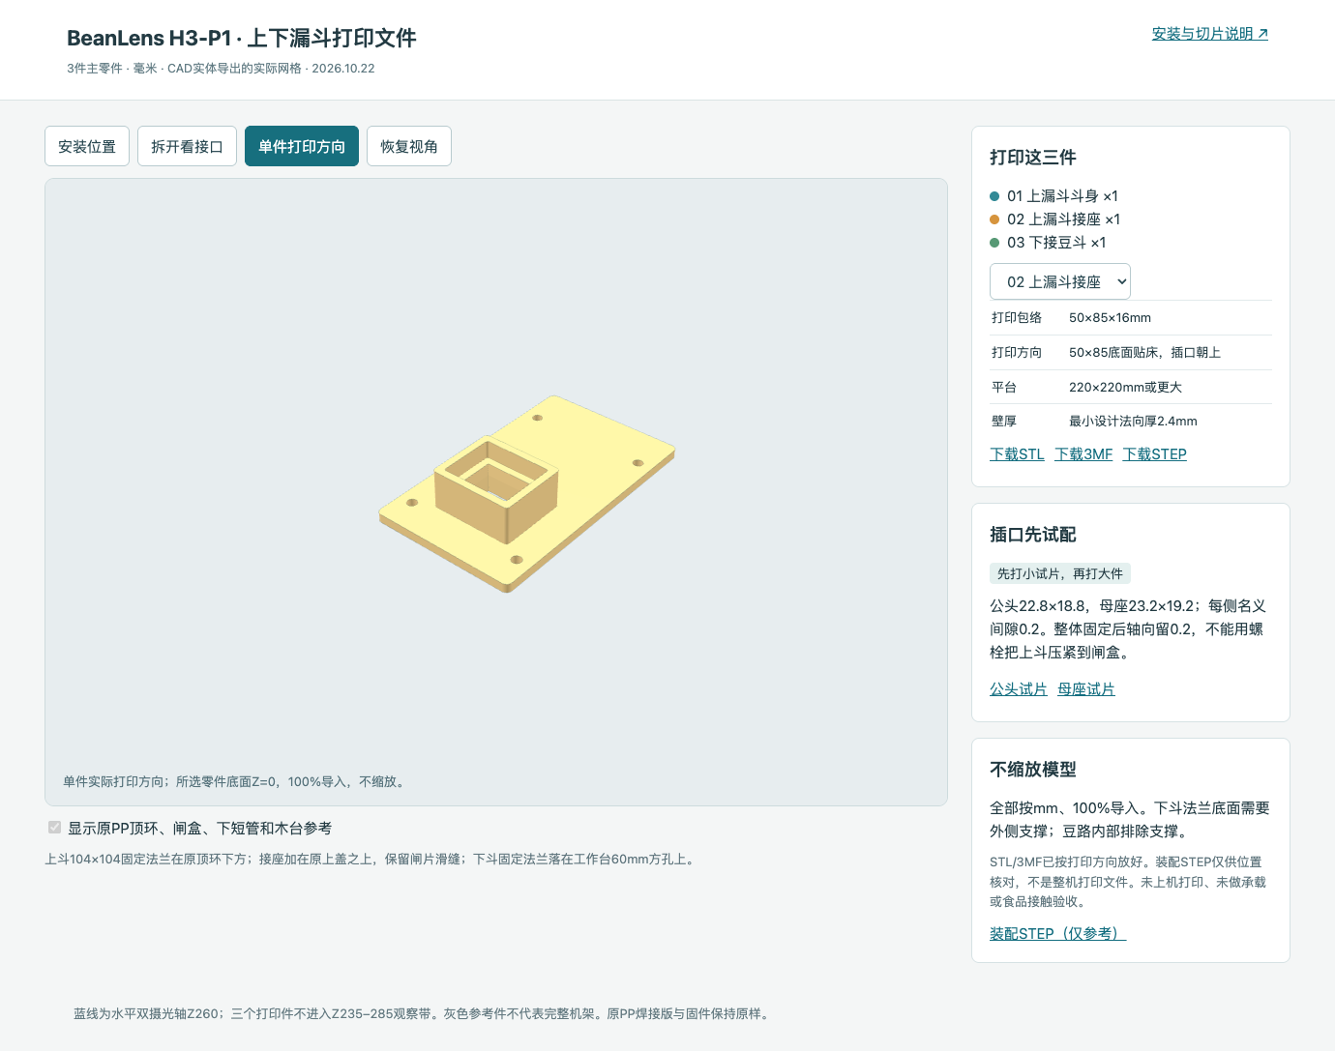
docs/hardware/hackathon-h3/printing-p1/BeanLens-H3-P1/preview-upper-adapter-mm.png
