koffja/Beanlens/docs/hardware/hackathon-h3/printing-p2/preview-assembly.png

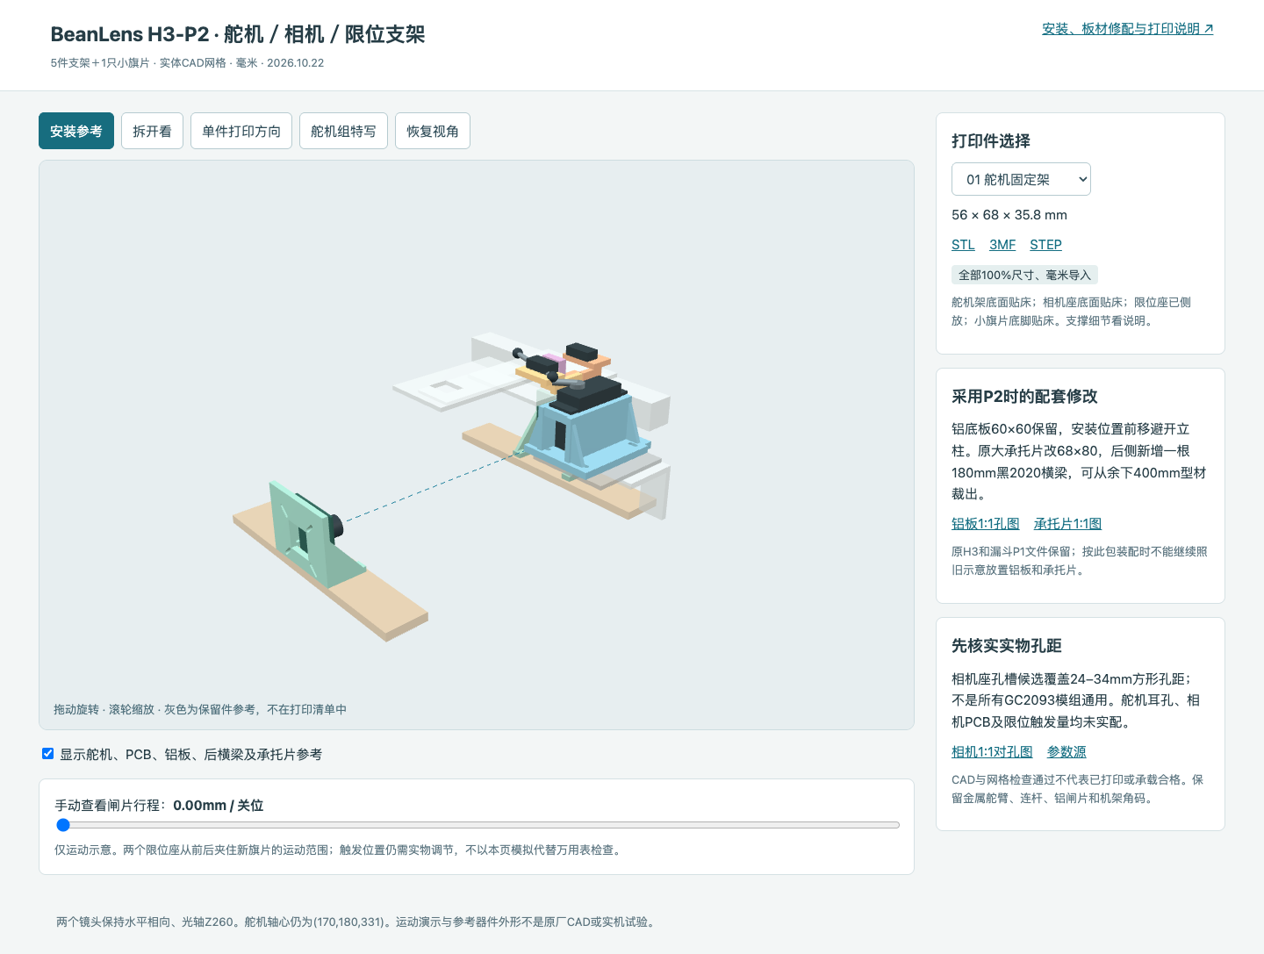
docs/hardware/hackathon-h3/printing-p2/preview-assembly.png
