koffja/Beanlens/docs/hardware/hackathon-h3/printing-p2/preview-camera-front-mm.png

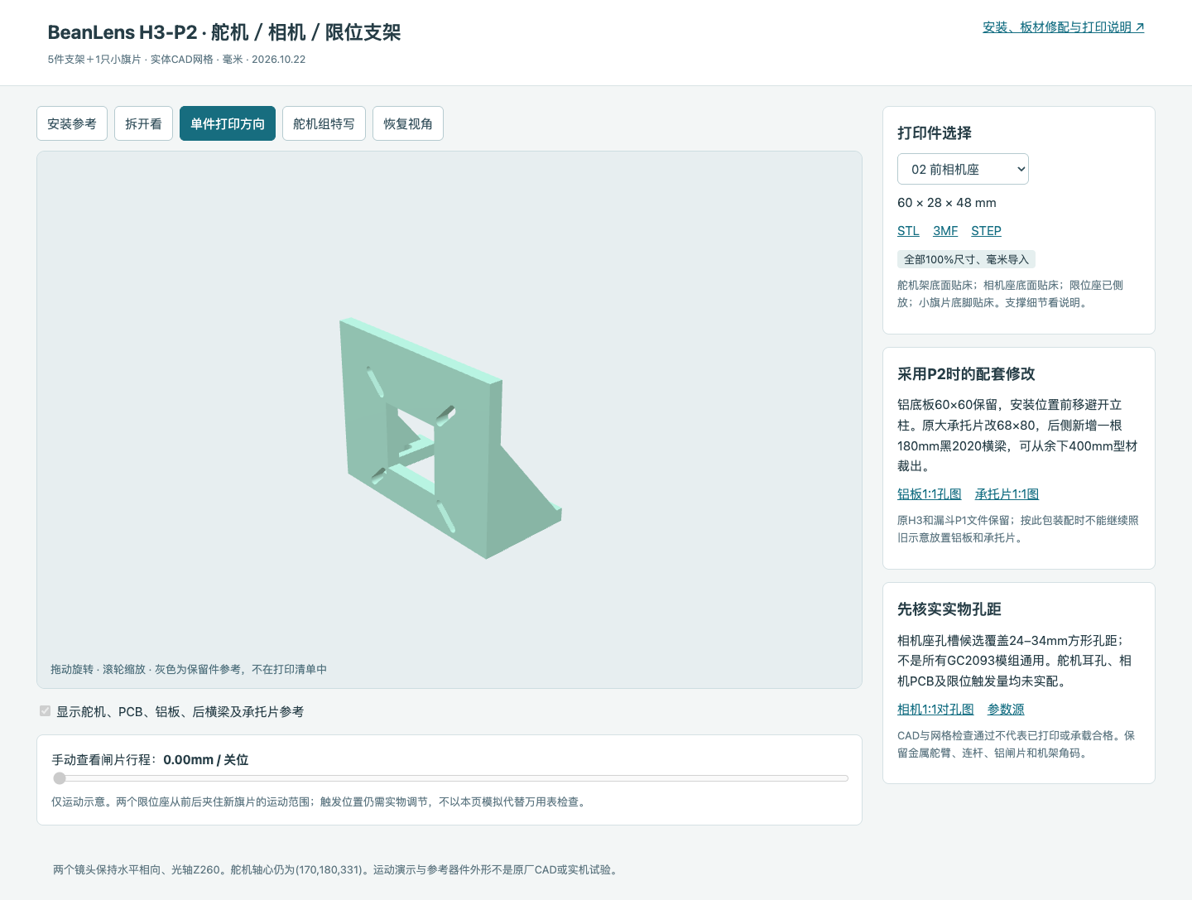
docs/hardware/hackathon-h3/printing-p2/preview-camera-front-mm.png
