koffja/Beanlens/docs/hardware/hackathon-h3/printing-p2/preview-camera-rear-mm.png

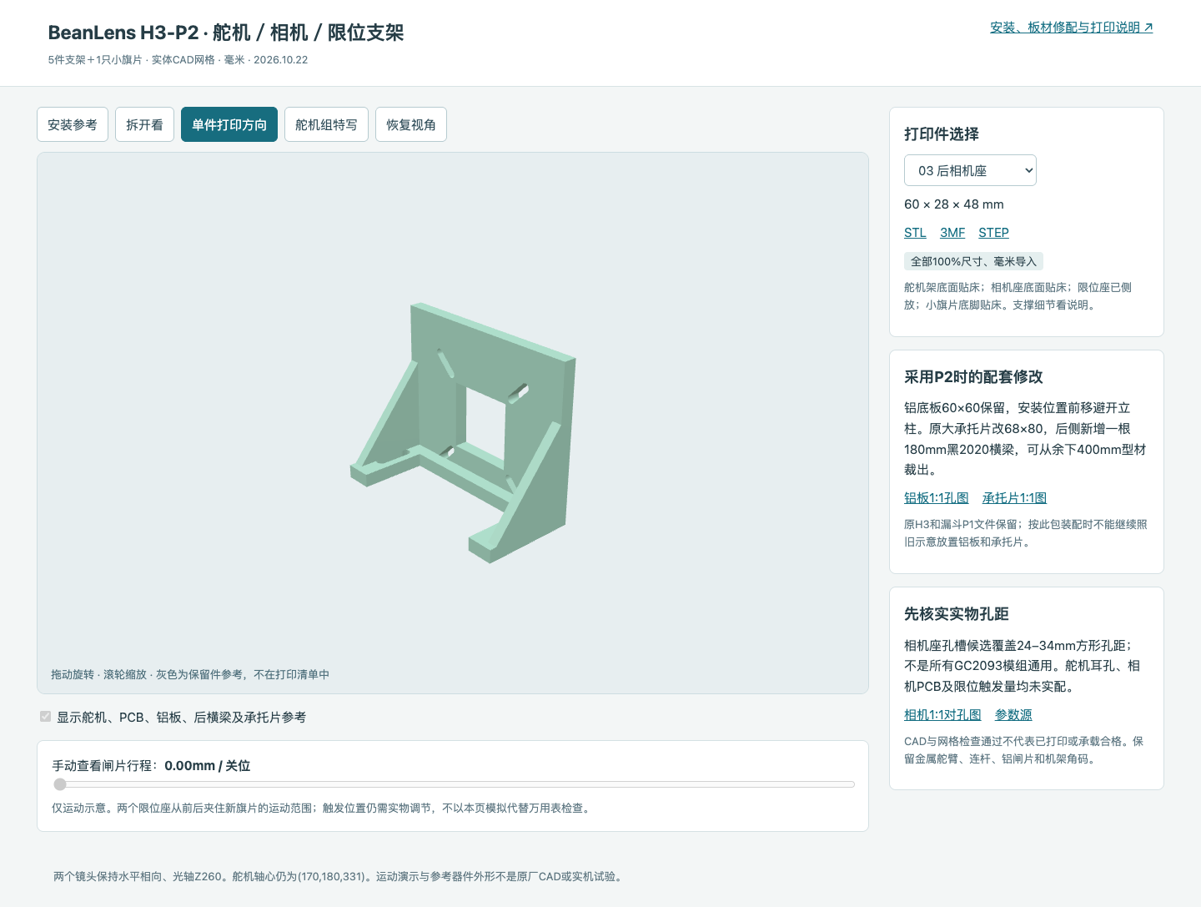
docs/hardware/hackathon-h3/printing-p2/preview-camera-rear-mm.png
