koffja/Beanlens/docs/hardware/hackathon-h3/printing-p2/preview-exploded.png

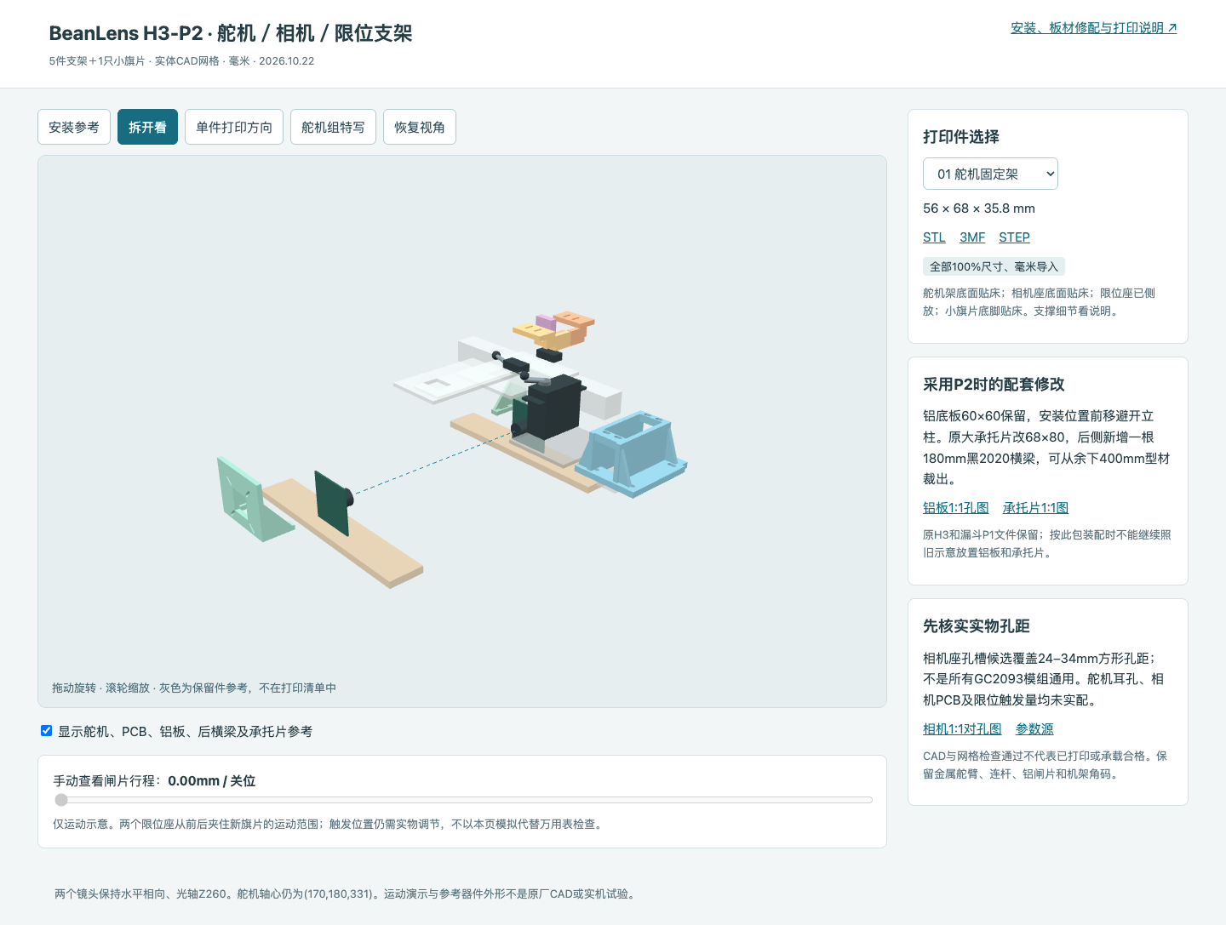
docs/hardware/hackathon-h3/printing-p2/preview-exploded.png
