koffja/Beanlens/docs/hardware/hackathon-h3/printing-p2/preview-mobile.png

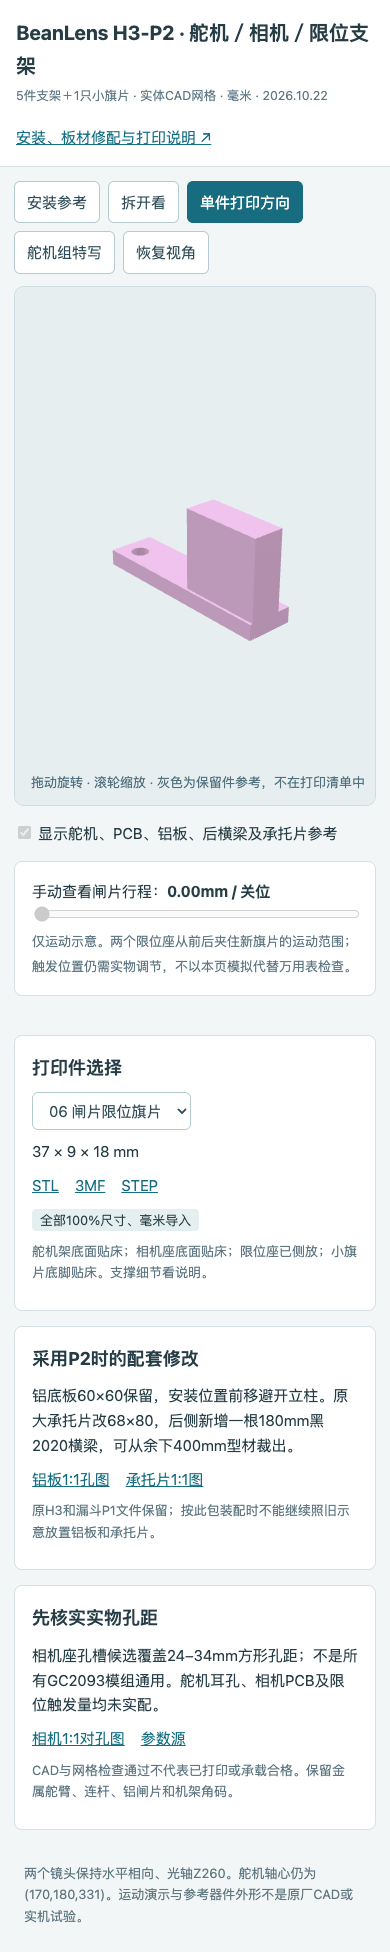
docs/hardware/hackathon-h3/printing-p2/preview-mobile.png
