koffja/Beanlens/docs/hardware/hackathon-h3/printing-p2/preview-servo-closed.png

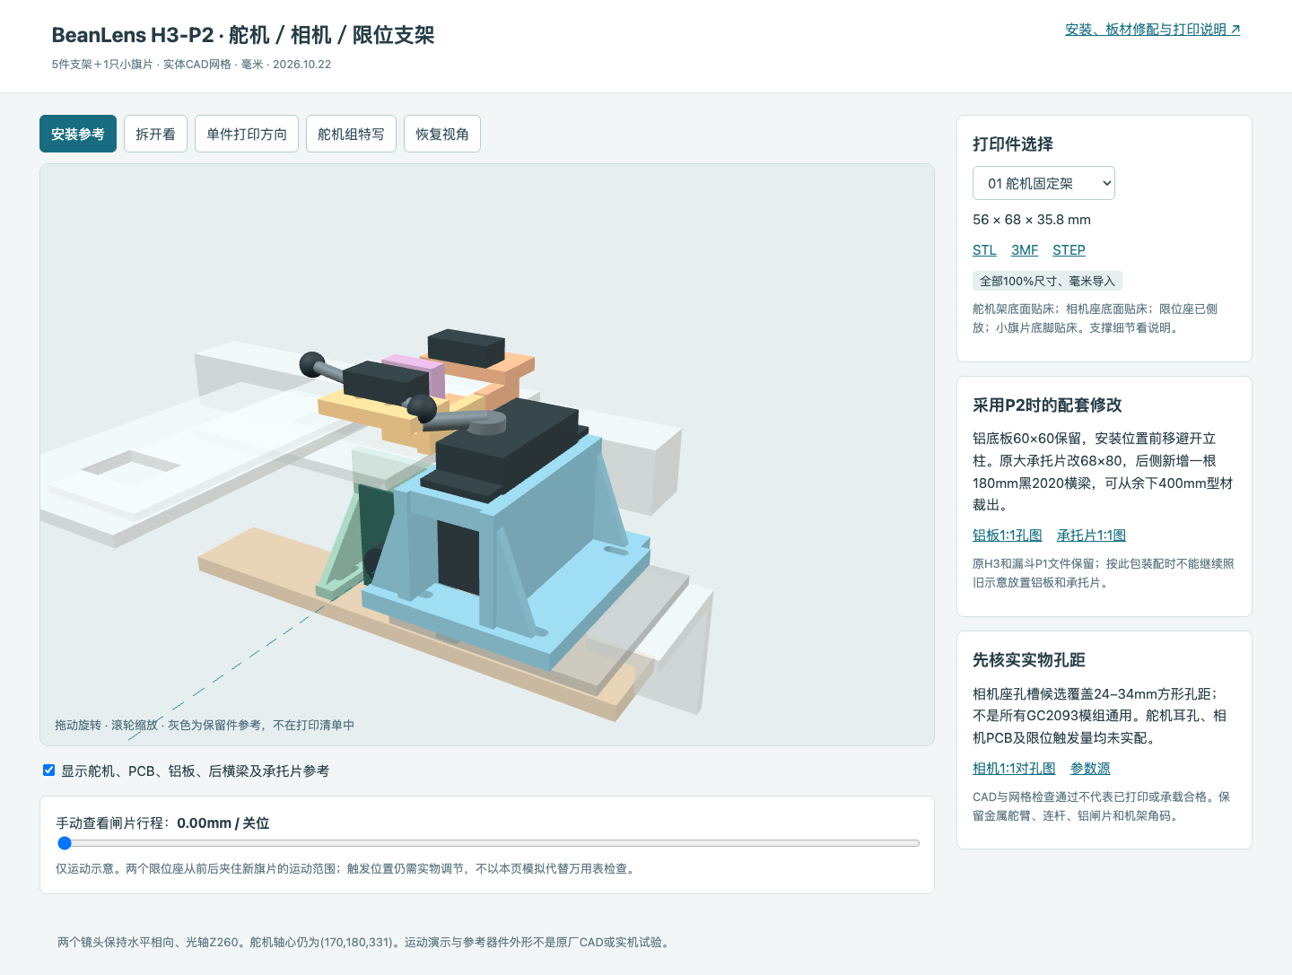
docs/hardware/hackathon-h3/printing-p2/preview-servo-closed.png
