koffja/Beanlens/docs/hardware/hackathon-h3/printing-p2/template-aluminum-base.png

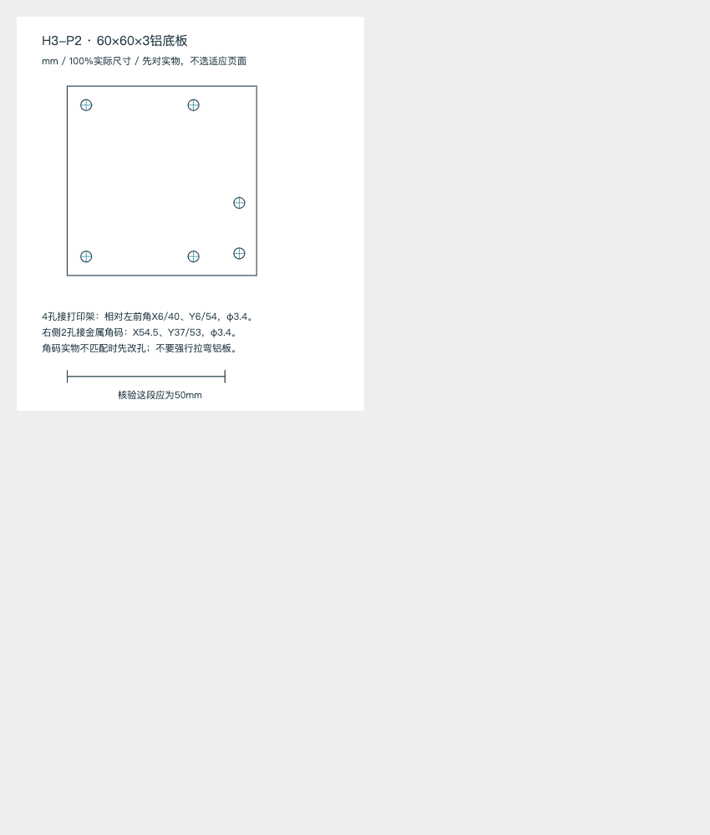
docs/hardware/hackathon-h3/printing-p2/template-aluminum-base.png
