koffja/Beanlens/docs/hardware/hackathon-h3/printing-p2/template-camera-hole-check.png

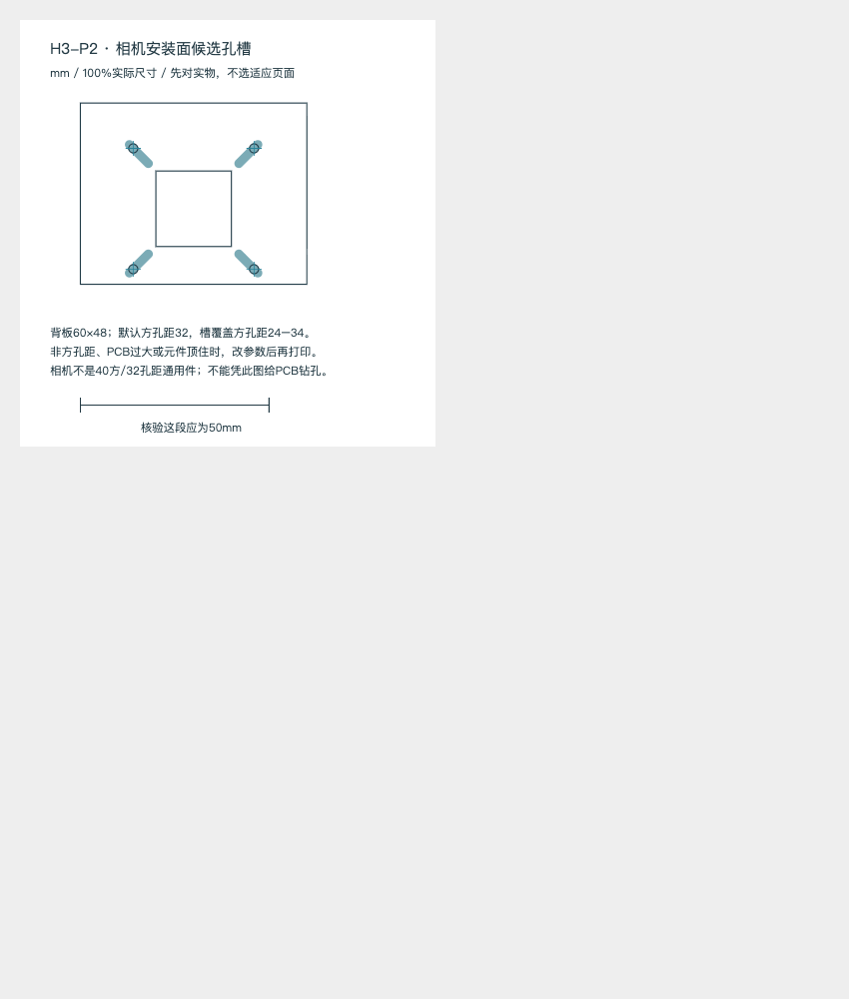
docs/hardware/hackathon-h3/printing-p2/template-camera-hole-check.png
