koffja/Beanlens/docs/hardware/hackathon-h3/printing-p2/template-servo-ear-check.png

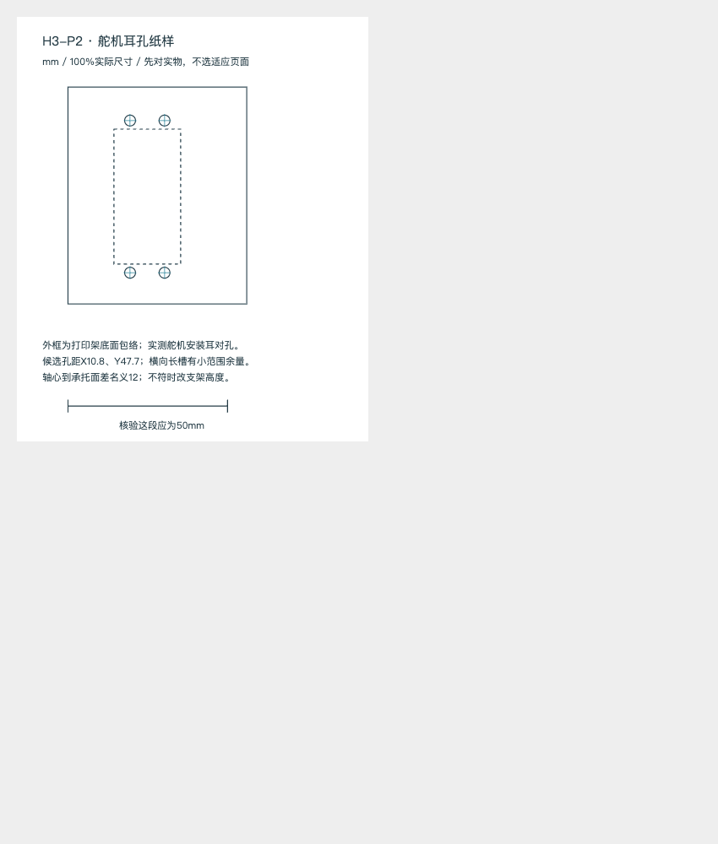
docs/hardware/hackathon-h3/printing-p2/template-servo-ear-check.png
