koffja/Beanlens/docs/firmware/BRINGUP.md

> **H3最新用户方向（2026-10-21）**：按[H3说明与验收](../hardware/hackathon-h3/README.md)及[独立H3基线](../../config/hardware-hackathon-h3.json)，顶入豆、单槽小抽拉闸、前后水平双摄。先台面核实已装BOX固件的短曝光和双CSI，再验证连续采集先准备、落豆清楚帧与配对，最后空载/单槽动作。漏图、糊图或配对不明须记录待复核并暂停下一颗；不是H1/H2静止取图后再释放。无C6/称重/对射，本轮未实现固件、未改用户bringup目录。下文H1/H2与完整版路线保留作对应方案参考。

> **比赛H1入口（2026-10-19）**：H1历史单摄方案按[H1验收步骤](../hardware/hackathon-h1/README.md)与[独立H1基线](../../config/hardware-hackathon-h1.json)，单BOX/单摄/单槽，人工逐颗停豆。下文继续保留完整版双板验收路线；H1不执行C6、称重、双摄/五槽联调，不套C6引脚。

# 双板固件准备与分阶段验收

> **H2双摄设计入口（2026-10-21）**：[H2说明](../hardware/hackathon-h2/README.md)与[独立基线](../../config/hardware-hackathon-h2.json)另存，不覆盖H1/完整版。选用H2时先台面验证玻璃透拍与近焦，再两CSI低分辨率预览/口编号，继而原分辨率ROI与内存检查、同一静止豆A/B配对、真实模型/证据，最后空载与实豆动作；任何一路不可用须拒判，不按正常放行。当前未实现H2固件，原用户bringup目录不改。

状态：2026-10-12，开发入口与规则已配置；以下实机步骤尚未完成。每次验收记录日期、板型、固件/SDK、接线、输入、预期、实际结果和证据路径，禁止只填“通过”。

## 阶段 0：确定版本，不先接执行器

1. 对照 `config/hardware-baseline.json` 与实物，确认 BOX、C6 非 Touch、相机线序和电源口。
2. 记录 BOX 当前运行的 CanMV/nncase 版本、TF 内容和可恢复镜像。资料盘里已有 v1.2/v1.3、nncase 2.9.0 文件，不代表已烧录。
3. 取得 C6 官方例程，核对其 ESP-IDF、LCD 驱动和 LVGL 版本；再记录 SDK 基线和建立最小构建工程。
4. 训练 `.venv` 保持不变。若转换模型需要不同 Python/nncase，新建独立转换环境。
5. MVP外置YU2405先量24V/极性；逻辑降压空载核5.0V，舵机UBEC5A断电设6V档再实测并标识。工业信号通过已核对电平接口。首次只给板卡供电。

完成证据：版本记录、镜像校验值、上电电压记录、引脚复核表。此阶段不要求料斗或生豆。

## 阶段 1：两块板分别显示与通信

- BOX 使用匹配官方例程验证主屏与 UART1；C6 验证小屏与计划 UART 引脚。
- 先不接舵机，用模拟限位与 STOP 输入验证状态。两板 3.3V UART 交叉 TX/RX，共地，不连接 PH2.0 的 5V线。
- 按协议草案测试分包、粘包、超长行、坏消息、重复序号、旧会话、断线和重启。主机测试与真实串口测试分开记录。

完成证据：双方收发日志，任何失败都不会产生开闸许可；日志不能混入协议串口。

## 阶段 2：控制端与空载闸门

- 先手推闸片顺畅，再用独立 6V 接空载 MG996R，小角度确认方向与限位。
- 标定开/关终点和动作时限，确认 STOP、失联、超时及限位矛盾会撤销送料，故障不持续顶住。
- 用户要求槽内关闸与缓关，见[机械与轨迹补充](../hardware/GATE-ENCLOSED-SLOW-CLOSE-20261012.md)。空载先验证逐步目标轨迹；带豆2–4秒仅作实验起点，关闭超时/授权时限/尾流收尾重新标定。低速不等于限力，两端限位不能识别全部中间卡豆，需另验检测与卸力。
- 记录供电峰值、主板是否复位与温升。无复位不等于瞬态完全合格。
- 盒到位尚无自动传感器；首版仍要求人工确认收豆盒已放回。

完成证据：空载动作和异常测试，随后才允许小量单槽生豆。没有硬件急停与失电自闭的证据，不使用这些宣传表述。

### 光电台架核验

MVP选用DFRobot SEN0503（50cm）：5V供电，接收白OUT拟10kΩ上拉3.3V、经1kΩ接GPIO20。先不连GPIO测遮挡/无遮挡两状态电压；原厂NPN常开不能代替内部输出图或遮挡极性测量，当前基线active_level=null。确认3.3V域与有效电平后再配置固件和接GPIO；若出现5V先停止，1k不是降压器。重复遮挡并与相机比较IR亮点和多槽合并。B3F-20C1仍为待核备选。光电只作经过提示，不能独立计数或判空。[接线说明](../hardware/BEAM-SENSOR-20261012.md)。

## 阶段 3：成像与模型

- 单摄先用静态标尺、灰参考和生豆调焦，验证视宽、两端清晰度、短曝光与固定白平衡。
- 6000K/Ra98 为两选一的工程优先方案，实际灯型号、剪切间距和功率仍待确认。
- 接双摄记录实际同时帧率、时间戳、裁图与内存；不把“两路接口”当作硬同步。
- 从已有训练 run 选择权重，记录标签映射与预处理；导出 ONNX、转换 kmodel 后，用同一组完整豆体图分别比较主机与 KPU 输出。
  - 主机侧：`modal run scripts/modal_train.py::convert --run <run>` 生成 `output/kmodel/<run>/`（kmodel、labels、manifest、`board_test/`），流程与结果见 `docs/ml/TRAINING-BASELINE.md`。
  - 板端：把 `best.kmodel`、`labels.txt`、`manifest.json`、`board_test/` 拷到板端 `/sdcard/beanlens/model/`（按原理图与厂商说明，`/sdcard` 应为板载 SD NAND 上 CanMV 盘的 sdcard 目录，不是 TF 卡；待实机确认），在 CanMV IDE 运行 `firmware/k230d/bringup/kmodel_static_check.py`。通过标准：`board_vs_sim_top1` 接近 1.0；同时记录推理耗时中位数和 `os.uname()`。
  - 2026-10-21 上板结果（CanMV `v1.3-8dd764f`，`k230d_canmv_atk_dnk230d`；kmodel `54db37ce…`，int16/int16）：`board_vs_sim_top1=1.0`、`board_vs_onnx_top1=1.0`、`max_abs_diff_vs_sim=0.0051`（20 个样本），说明板端运行时与 nncase 2.9.0 配套、输入排列正确。但单次推理中位数 16308139 µs（约 16.3 s），远超可用范围；怀疑 int16 量化导致算子未在 KPU 上执行，待用 uint8 等变体实测确认。结果文件 `/sdcard/beanlens/model/board_check_3686580.json`。
  - 同日对照：同一权重的 u8w16 变体（激活 uint8、权重 int16，kmodel `4899e348…`，3.4MB）`board_vs_sim_top1=1.0`、`max_abs_diff_vs_sim=0.0000`、`board_vs_onnx_top1=0.9`，单次推理中位数 7683 µs（约 7.7 ms），比 int16/int16 快约 2100 倍。确认慢速来自 int16 激活，而非算子回退或 nncase-kpu/target 配置。结果文件 `/sdcard/beanlens/model-u8w16/board_check_6204533.json`。u8w8 变体未上板。
  - 实时链路（`kmodel_live_classify.py`，u8w16，`gc2093_csi2` 1280×960，中心裁 480）：约 40–44 fps，Ai2d 裁剪缩放＋KPU＋后处理中位数 12.3–12.8 ms（14860 帧与 2472 帧两次）。镜头为 M12 手动对焦，初次画面明显失焦；取景框清晰度（G 通道平均梯度，仅同场景相对比较）约 0.9–2.3。分类在 floater/full_sour/parchment 间跳变，失焦和公开数据集域差下不代表准确率。结果 `/sdcard/beanlens/model-u8w16/live_run_6740180.json`、`live_run_6897776.json`。
  - 文件传输：`/sdcard` 为板载 SD NAND。经 USB 串口 raw REPL 批量写文件（mpremote 与 `firmware/k230d/tools/push_files.py`）多次使板卡失去响应，原因未查明；6.2MB kmodel 改用 CanMV IDE 上传成功并核对 SHA-256。
  - 静态对照通过后，再运行 `firmware/k230d/bringup/kmodel_live_classify.py`：单摄连续采集、中心正方形裁剪（`CROP_SIDE`）后分类，LCD 显示 top-3、帧率与耗时，低于 `MIN_CONF` 显示“未判定”；停止时写 `live_run_<ticks>.json`（耗时统计，不存图）。只证明端上实时链路可运行，不代表端侧准确率。尚未上板实测。
- 量化校准须包含实际装置的正常与异常样本；公开图集上的结果不能直接当成设备表现。当前默认 int16 PTQ（uint8 损失过大，见训练基线）。

完成证据：静态和落豆图片、双摄吞吐/内存、转换日志与模型校验值、主机/KPU差异。若转换失败先处理兼容性，不直接换框架或升级全部环境。

## 阶段 4：称重独立验收

具体机械、电气与0.1g验收方法见 V4.4 手册第05A章和第12图，不在此重复。

先确定传感器实际型号、激励与接口。1kg方案仍是目标；用户HJ-AZ4-3kg/103元候选未证明数字接口、包含支架或±0.1g；旧L6J1推荐5–10V与当前3V激励不匹配，见[采购纠错](../hardware/PROCUREMENT-AUDIT-20261012.md)。称重不合格不阻断单独验证视觉，但不得伪装成自动质量结果。

## 阶段 5：单槽到五槽、离线到联网

- 单槽测试满斗/半斗/尾料、架桥、贴连、碎片残留和拒判；随后扩展三槽、五槽。
- 每批比较人工已知颗数、可靠分类数、拒判数、重复数与缺失数。断线、过载、相机或存储异常必须生成未完成记录。
- 先本地完成批次和证据，再联调 C6 有界网络队列；重试不能制造重复批次。
- 参赛演示先做到有图、有据、能复核，不把杯测、完整SCA分级或工业色选能力加入未验证承诺。

## 当前明确未完成

未配置 ESP-IDF 产品构建；未烧录本项目应用；未确认实机 CanMV；未验双摄、kmodel、送料、称重与电源满载。本次移交只验证资料完整性与配置一致性。
