koffja/Beanlens/docs/hardware/illustrations/beanlens-gate-motion-20261012-validation.md

# 槽内滑闸动画：浏览器检查

日期：2026-10-12。对象：`beanlens-gate-motion-20261012.html`。通过本地HTTP在Playwright浏览器检查；交付文件自包含，可离线打开。检查范围仅为网页、几何与交互，不是产品固件或实机验收。

- 启动保持半开暂停，不自动播放；没有硬件连接。
- 采样1001个开度：A/B球心距相对60mm最大浮点误差约4.41×10⁻¹³mm；B位置单调，端点差15mm；关闭开口0mm，全开净深12mm。
- 五个SVG槽在同一开度的开口高度完全一致；闸片直线前缘没有旋转。
- 半开到全开、全开3秒缓关、暂停/继续、运行中反向、手动25%开度、部件高亮可操作。3秒缓关测试插入约250ms暂停，约3.405秒后检查已全关，保留了暂停位置；该时刻是检查时刻，不作为精确浏览器或硬件动作延迟。
- 人工注入卡豆信号后不再推进，动作按钮与拖动禁用；清除信号保持当时开度，不自动续动。没有假装MG996R具备夹豆反馈。
- 1440px桌面、390px和320px窄屏检查无整页横向溢出。窄屏SVG保留500px可读画布，图内允许横向滑动并提示。
- 浅色截图检查部件与标注位置；深色媒体模式配色生效，无整页横向溢出；减少动态效果模式下不自动播放。
- 浏览器控制台检查为0错误、0警告；本地文档链接目标存在；硬件基线JSON有效，并保持力限制/实际位置/夹豆反馈未验证状态。

截图位于项目`.playwright-mcp/`中的`gate-animation-desktop.png`、`gate-animation-mobile.png`及`gate-animation-dark.png`，仅作本地网页检查证据，不代表加工图。

未验证：真实舵机花键、PWM兼容与端点、低速跟随、实际孔位与封闭槽盒尺寸、负载、卡豆/破损/飞豆、清洁、尾流、温升、上电动作和故障卸力。详见[槽内缓关设计说明](../GATE-ENCLOSED-SLOW-CLOSE-20261012.md)。
