koffja/Beanlens/docs/hardware/hackathon-h1/06-bringup.png

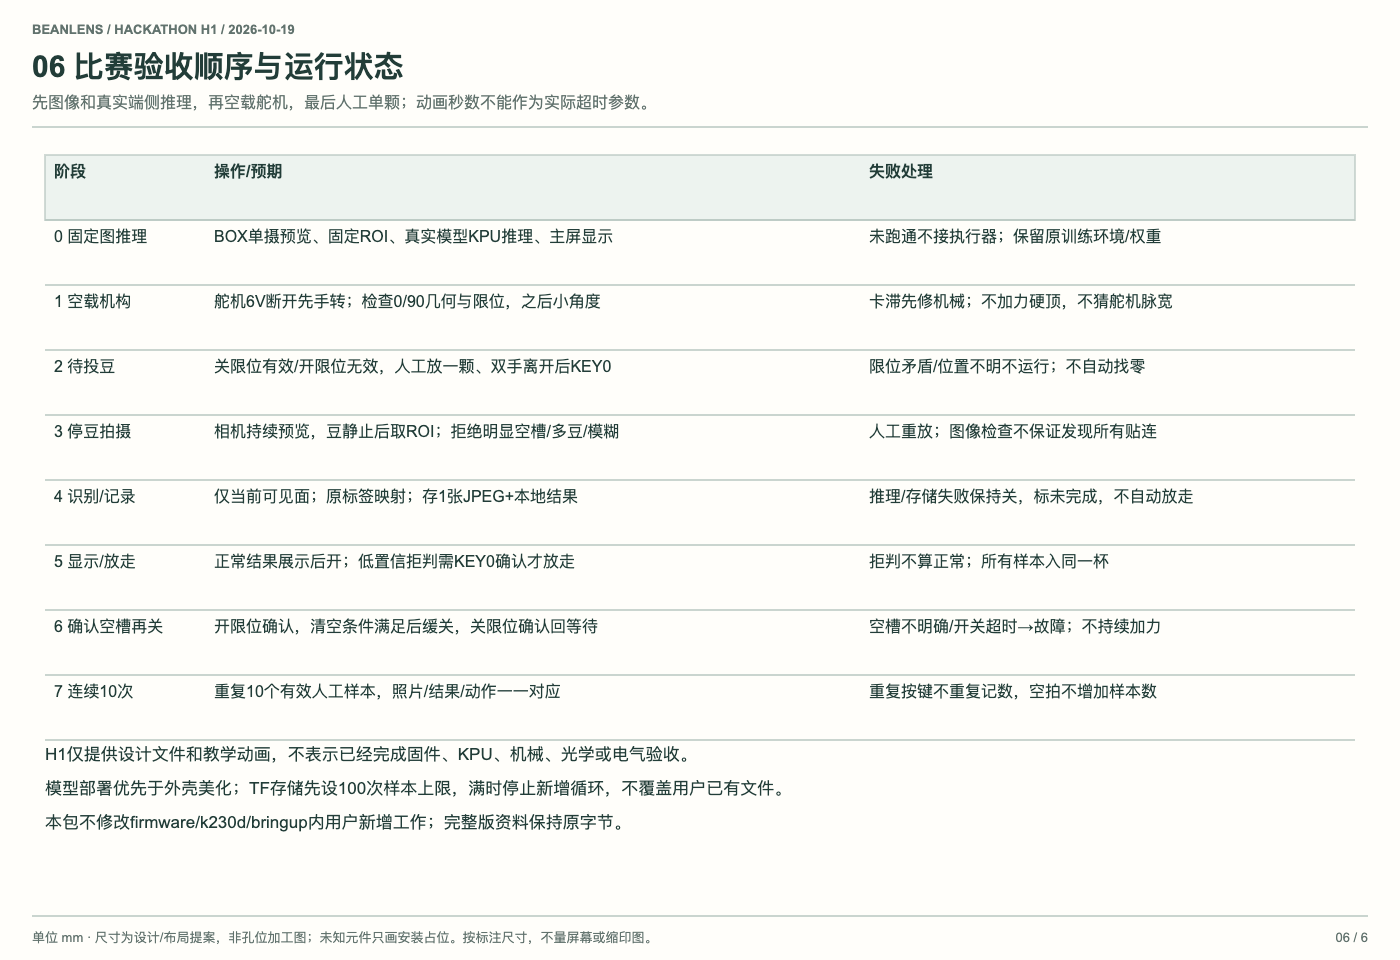
docs/hardware/hackathon-h1/06-bringup.png
