koffja/Beanlens/output/pdf/beanlens-hopper-gate-v4.10-20261016.pdf

# 料斗靠“顶托环 + 四只金属托片”挂在黑色 2020 上

### 装配顺序

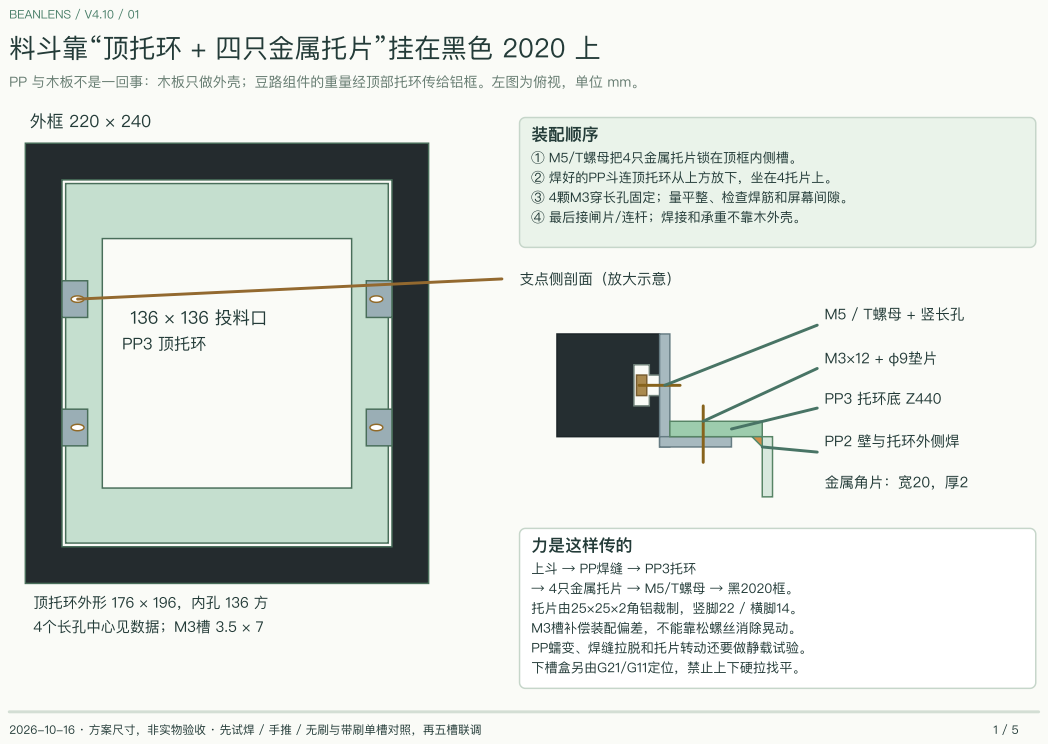
[picture p213: page 1]
BEANLENS / V4.10 / 01; 136 × 136 投料口; PP3 顶托环; 顶托环外形 176 × 196，内孔 136 方; 4个长孔中心见数据；M3槽 3.5 × 7; 支点侧剖面（放大示意）; M5 / T螺母 + 竖长孔; PP3 托环底 Z440; PP2 壁与托环外侧焊; 金属角片：宽20，厚2; 力是这样传的; 上斗 → PP焊缝 → PP3托环 → 4只金属托片 → M5/T螺母 → 黑2020框。 托片由25×25×2角铝裁制，竖脚22 / 横脚14。; M3槽补偿装配偏差，不能靠松螺丝消除晃动。; PP蠕变、焊缝拉脱和托片转动还要做静载试验。; 下槽盒另由G21/G11定位，禁止上下硬拉找平。; 2026-10-16 · 方案尺寸，非实物验收 · 先试焊 / 手推 / 无刷与带刷单槽对照，再五槽联调

PP 与木板不是一回事：木板只做外壳；豆路组件的重量经顶部托环传给铝框。左图为俯视，单位 mm。

① M5/T螺母把4只金属托片锁在顶框内侧槽。
② 焊好的PP斗连顶托环从上方放下，坐在4托片上。
③ 4颗M3穿长孔固定；量平整、检查焊筋和屏幕间隙。
④ 最后接闸片/连杆；焊接和承重不靠木外壳。

# 前壁连续：关闸藏入前承接槽，开闸只向后退

### 这次修正了什么

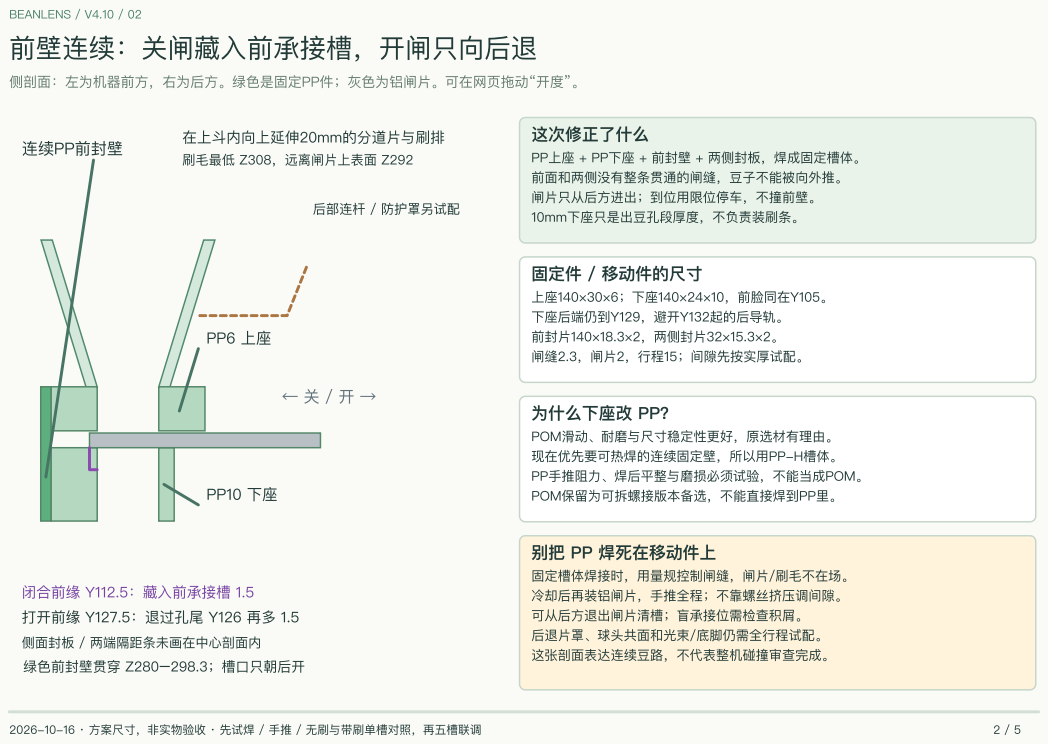
[picture p214: page 2]
侧面封板 / 两端隔距条未画在中心剖面内; 绿色前封壁贯穿 Z280–298.3；槽口只朝后开; 连续PP前封壁; 在上斗内向上延伸20mm的分道片与刷排; 刷毛最低 Z308，远离闸片上表面 Z292; 后部连杆 / 防护罩另试配; 固定件 / 移动件的尺寸; 上座140×30×6；下座140×24×10，前脸同在Y105。; 下座后端仍到Y129，避开Y132起的后导轨。 前封片140×18.3×2，两侧封片32×15.3×2。; 闸缝2.3，闸片2，行程15；间隙先按实厚试配。; 为什么下座改 PP？

侧剖面：左为机器前方，右为后方。绿色是固定PP件；灰色为铝闸片。可在网页拖动“开度”。

PP上座 + PP下座 + 前封壁 + 两侧封板，焊成固定槽体。
前面和两侧没有整条贯通的闸缝，豆子不能被向外推。
闸片只从后方进出；到位用限位停车，不撞前壁。
10mm下座只是出豆孔段厚度，不负责装刷条。

POM滑动、耐磨与尺寸稳定性更好，原选材有理由。
现在优先要可热焊的连续固定壁，所以用PP-H槽体。
PP手推阻力、焊后平整与磨损必须试验，不能当成POM。
POM保留为可拆螺接版本备选，不能直接焊到PP里。

别把 PP 焊死在移动件上

固定槽体焊接时，用量规控制闸缝，闸片/刷毛不在场。
冷却后再装铝闸片，手推全程；不靠螺丝挤压调间隙。
可从后方退出闸片清槽；盲承接位需检查积屑。
后退片罩、球头共面和光束/底脚仍需全行程试配。
这张剖面表达连续豆路，不代表整机碰撞审查完成。

闭合前缘 Y112.5：藏入前承接槽 1.5
打开前缘 Y127.5：退过孔尾 Y126 再多 1.5

# PBT刷在五槽入口，夹在可拆刷盒里，不塞进10mm下座

### 这里能放得下的原因

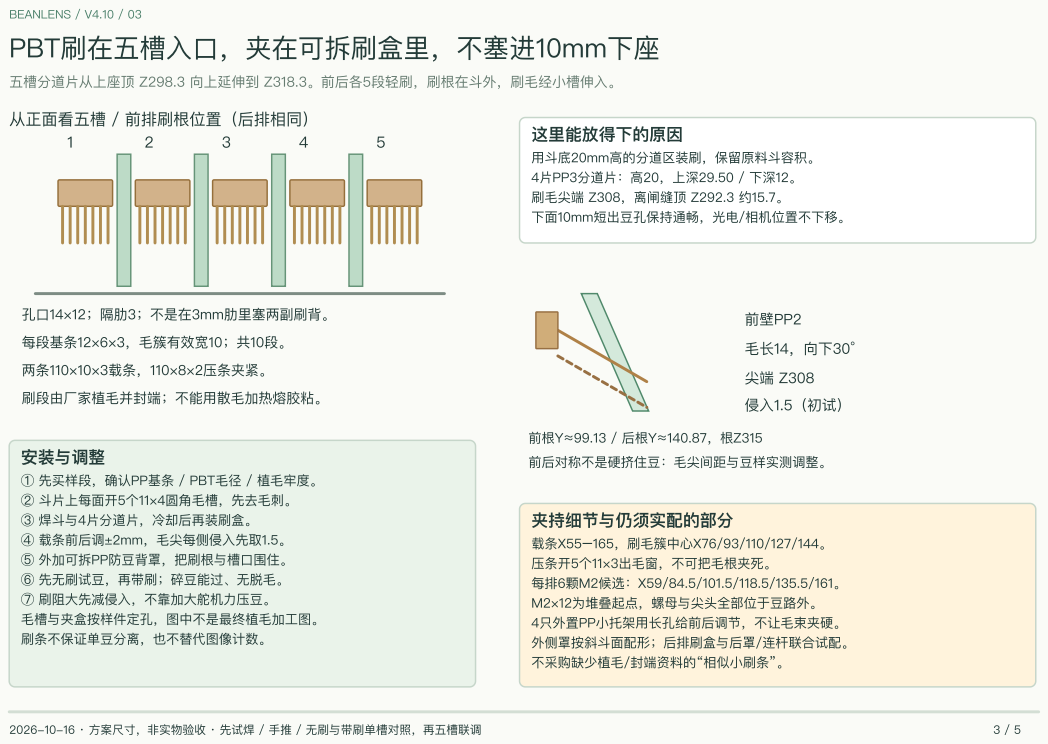
[picture p215: page 3]
孔口14×12；隔肋3；不是在3mm肋里塞两副刷背。; 每段基条12×6×3，毛簇有效宽10；共10段。; 两条110×10×3载条，110×8×2压条夹紧。; 刷段由厂家植毛并封端；不能用散毛加热熔胶粘。; 安装与调整; 前壁PP2; 前根Y≈99.13 / 后根Y≈140.87，根Z315; 前后对称不是硬挤住豆：毛尖间距与豆样实测调整。; 用斗底20mm高的分道区装刷，保留原料斗容积。 4片PP3分道片：高20，上深29.50 / 下深12。 刷毛尖端 Z308，离闸缝顶 Z292.3 约15.7。; 下面10mm短出豆孔保持通畅，光电/相机位置不下移。; 夹持细节与仍须实配的部分; 载条X55–165，刷毛簇中心X76/93/110/127/144。; 压条开5个11×3出毛窗，不可把毛根夹死。 每排6颗M2候选：X59/84.5/101.5/118.5/135.5/161。; M2×12为堆叠起点，螺母与尖头全部位于豆路外。; 4只外置PP小托架用长孔给前后调节，不让毛束夹硬。; 外侧罩按斜斗面配形；后排刷盒与后罩/连杆联合试配。; 不采购缺少植毛/封端资料的“相似小刷条”。

五槽分道片从上座顶 Z298.3 向上延伸到 Z318.3。前后各5段轻刷，刷根在斗外，刷毛经小槽伸入。

从正面看五槽 / 前排刷根位置（后排相同）

① 先买样段，确认PP基条 / PBT毛径 / 植毛牢度。
② 斗片上每面开5个11×4圆角毛槽，先去毛刺。
③ 焊斗与4片分道片，冷却后再装刷盒。
④ 载条前后调±2mm，毛尖每侧侵入先取1.5。
⑤ 外加可拆PP防豆背罩，把刷根与槽口围住。
⑥ 先无刷试豆，再带刷；碎豆能过、无脱毛。
⑦ 刷阻大先减侵入，不靠加大舵机力压豆。
毛槽与夹盒按样件定孔，图中不是最终植毛加工图。
刷条不保证单豆分离，也不替代图像计数。

# TPS5450值得优先考虑，但先选整板，再谈性能和安全

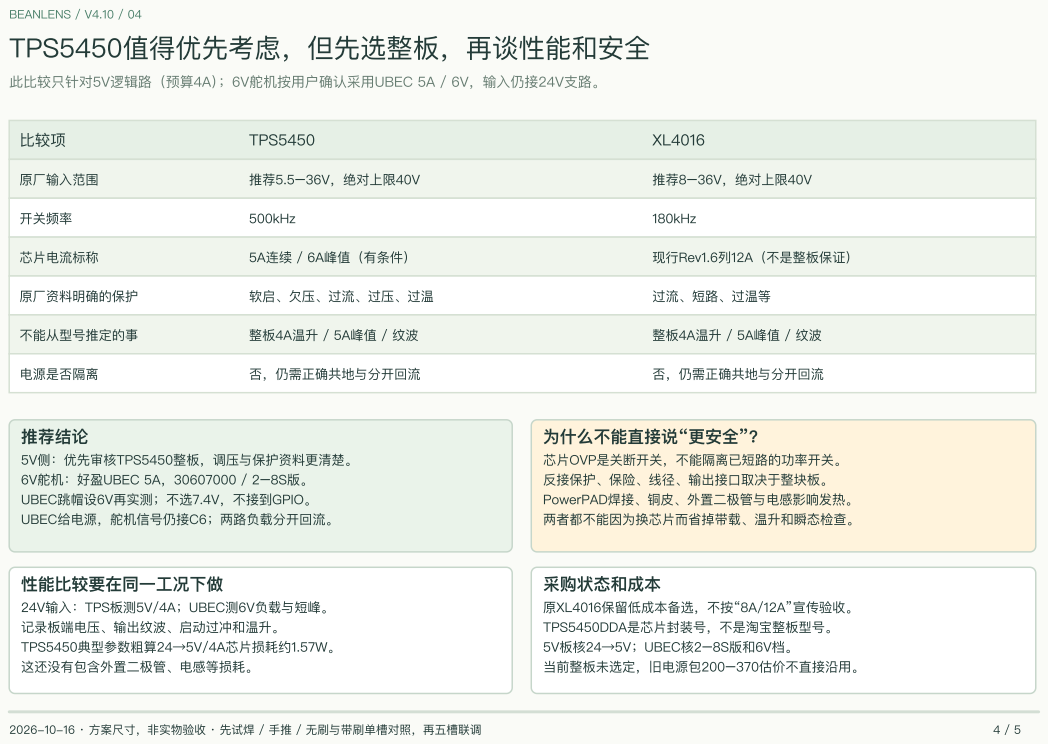
[picture p216: page 4]
此比较只针对5V逻辑路（预算4A）；6V舵机按用户确认采用UBEC 5A / 6V，输入仍接24V支路。; 比较项; TPS5450; 原厂输入范围; 推荐5.5–36V，绝对上限40V; 推荐8–36V，绝对上限40V; 开关频率; 500kHz; 180kHz; 芯片电流标称; 5A连续 / 6A峰值（有条件）; 现行Rev1.6列12A（不是整板保证）; 原厂资料明确的保护; 过流、短路、过温等; 不能从型号推定的事; 整板4A温升 / 5A峰值 / 纹波; 电源是否隔离; 否，仍需正确共地与分开回流; 推荐结论; 5V侧：优先审核TPS5450整板，调压与保护资料更清楚。 6V舵机：好盈UBEC 5A，30607000 / 2–8S版。 UBEC跳帽设6V再实测；不选7.4V，不接到GPIO。; UBEC给电源，舵机信号仍接C6；两路负载分开回流。; 为什么不能直接说“更安全”？; 性能比较要在同一工况下做; 24V输入：TPS板测5V/4A；UBEC测6V负载与短峰。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

芯片OVP是关断开关，不能隔离已短路的功率开关。
反接保护、保险、线径、输出接口取决于整块板。
PowerPAD焊接、铜皮、外置二极管与电感影响发热。
两者都不能因为换芯片而省掉带载、温升和瞬态检查。

# 先分出三路电压，再分别接回负极

### A07 航嘉外置适配器

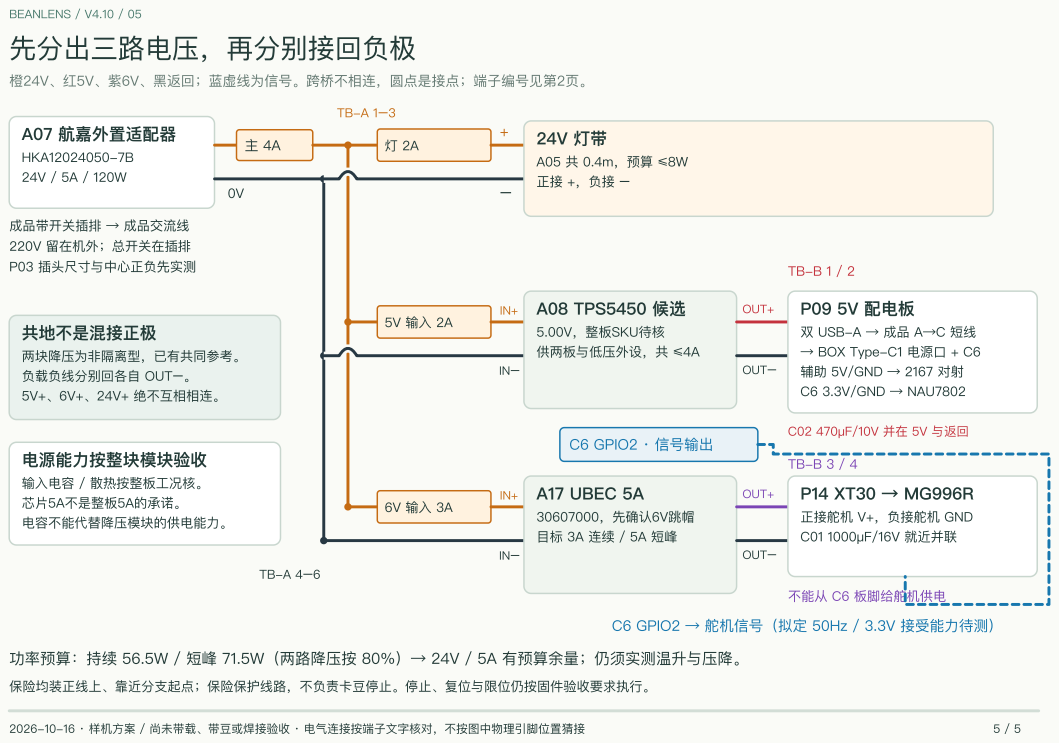
[picture p217: page 5]
HKA12024050-7B 24V / 5A / 120W; 成品带开关插排 → 成品交流线; 220V 留在机外；总开关在插排; P03 插头尺寸与中心正负先实测; A08 TPS5450 候选; 5.00V，整板SKU待核; 供两板与低压外设，共 ≤4A; OUT+; OUT−; C02 470µF/10V 并在 5V 与返回; A17 UBEC 5A; 30607000，先确认6V跳帽; 不能从 C6 板脚给舵机供电; 共地不是混接正极; 两块降压为非隔离型，已有共同参考。; 负载负线分别回各自 OUT−。 5V+、6V+、24V+ 绝不互相相连。; 电源能力按整块模块验收; 输入电容 / 散热按整板工况核。; 芯片5A不是整板5A的承诺。; 电容不能代替降压模块的供电能力。; C6 GPIO2 · 信号输出; 2026-10-16 · 样机方案 / 尚未带载、带豆或焊接验收 · 电气连接按端子文字核对，不按图中物理引脚位置猜接

橙24V、红5V、紫6V、黑返回；蓝虚线为信号。跨桥不相连，圆点是接点；端子编号见第2页。

P09 5V 配电板
双 USB-A → 成品 A→C 短线
→ BOX Type-C1 电源口 + C6
辅助 5V/GND → 2167 对射
C6 3.3V/GND → NAU7802

正接舵机 V+，负接舵机 GND
C01 1000µF/16V 就近并联

C6 GPIO2 → 舵机信号（拟定 50Hz / 3.3V 接受能力待测）

功率预算：持续 56.5W / 短峰 71.5W（两路降压按 80%）→ 24V / 5A 有预算余量；仍须实测温升与压降。

保险均装正线上、靠近分支起点；保险保护线路，不负责卡豆停止。停止、复位与限位仍按固件验收要求执行。
