koffja/Beanlens/(commit log)

2026-10-12 初始化 BeanLens 仓库：文档基线与数据/训练脚本
    - docs/：V4.4 硬件手册与交付快照、闸片方案设计稿、固件文档
    - scripts/：公开数据集裁框转换(prepare_coffee_defect)与自拍数据管线(build_mydata)
    - config/hardware-baseline.json、shared/protocol 等基线文件
    - 数据集、训练产物、权重、虚拟环境、厂商资料盘按 .gitignore 排除
    [beanlens-box-bom-v4.4.csv]
2026-10-13 docs(hardware): add V4.5 gate, BOM and assembly documentation
    Document the enclosed servo-driven gate and slow-close behavior, audit
    component selection and purchasing details, and add dimensioned assembly
    sheets with a printable A3 PDF.
    Synchronize the hardware baseline, handbook, bring-up notes and handoff;
    record public patent screening and document-only validation boundaries.
    [beanlens-bom-v4.5.csv, cut-list-v4.5.csv]
2026-10-17 docs(hardware): integrate MVP assembly and operation design
    Consolidate V4.6-V4.12 frame, continuous PP hopper, rear-entry gate, PBT brush, dual-display and wiring documentation with BOMs, cutting lists, generators and printable drawings.
    Adopt SEN0503 and YU2405 for the MVP while retaining the independent UBEC 6V servo supply. Add the complete operation animation and fault demonstrations, synchronize the hardware baseline and bring-up guidance, and include the existing workbook and open-source publication plan.
    Validation: 21 V4.12 and 33 V4.11 document consistency checks; browser interaction and PDF rendering records included. Physical and electrical verification remain pending.
    [MA1.stl, MA2.stl, MB1.stl, MB2.stl, TA1.stl, TA2.stl, TB1.stl, TB2.stl]
2026-10-19 feat(k230d): add dual-camera bring-up scripts and record test results
    - dual_camera_preview.py: GC2093 x2 side-by-side preview on BOX screen/IDE
    - dual_camera_capture.py: timed dual capture to TF as append streams + index.csv
    - tools/rgb565_to_png.py: PC-side converter for raw RGB565 streams
    - hardware-baseline.json: installed CanMV firmware and capture tests 1-11
    (preview 34.9 fps; JPEG encode hangs on ATK v1.3; raw 10 Hz dual capture
    limited by ~1.1 MB/s TF write; /sdcard is on-board storage, not the TF card)
2026-10-21 feat(k230d): find a working dual-camera JPEG path and add board tools
    - board_diagnose.py: board system info plus file checks (autorun main.py,
    module shadowing, incomplete capNNN dirs, write probe); found a
    regenerated /sdcard/main.py that caused the preview hang
    - clean_beanlens.py: remove /sdcard/beanlens/capNNN dirs (DRY_RUN flag)
    - jpeg_probe.py: step-by-step JPEG probe based on ATK example 15
    - dual_camera_capture.py v3: dual 1280x960@90 sensors, cam1 chn0 bound to
    LAYER_VIDEO1, chn1 RGB565 1280x960 snapshot + compressed(); step log,
    incremental index.csv, done.txt marker
    - rgb565_to_png.py: skip half-written index lines from interrupted runs
    - hardware-baseline.json: capture_t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
    [board_diagnose.py, clean_beanlens.py, dual_camera_capture.py, jpeg_probe.py, rgb565_to_png.py]
2026-10-21 feat(ml): add Modal train -> ONNX -> K230 kmodel pipeline
    - scripts/modal_train.py: GPU training on Modal, ONNX export, nncase 2.9.0
    compile in a separate Linux/.NET 7 image, results synced from the
    beanlens-runs volume to runs/modal/ and output/kmodel/
    - scripts/convert_kmodel.py: fix non-contiguous input passed to nncase
    (calibration and simulator saw HWC data), default to int16 PTQ,
    configurable quant types, --check-dir and board_test/ sample export
    - firmware/k230d/bringup/kmodel_static_check.py: on-board KPU vs host
    reference check (not yet run on hardware)
    - README: Modal account/CLI setup and usage; training baseline and
    bringup docs record results and verification status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
    [kmodel_static_check.py]
2026-10-21 feat(k230d): on-board KPU check, live classify and u8w16 kmodel variant
    - firmware/k230d/bringup/kmodel_live_classify.py: camera -> center crop ->
    Ai2d resize -> KPU, LCD top-3 / undecided below MIN_CONF / fps, focus
    sharpness overlay for manual M12 focusing, timing summary JSON on exit
    - kmodel_static_check.py: SAMPLE_DIR / REFERENCE options so quant variants
    of the same run reuse the uploaded board_test samples
    - scripts/modal_train.py convert --tag: compile a quant variant of an
    existing run into kmodel/<run>-<tag> without overwriting
    - firmware/k230d/tools/push_files.py: chunked raw-REPL upload with SHA-256
    verify; NOT reliable on this board (bulk writes wedged it), kept for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
2026-10-23 docs: H1/H2/H3 hackathon baselines, P4 assembly and bringup gates
    - AGENTS.md: H3-P4 integrated print assembly direction, P1/P2/P3 print
    alternatives, H3/H2/H1 scoping rules (C6 pins never drive BOX etc.)
    - BRINGUP.md / HANDOFF: capture-line progress and next-step gates
    - gitignore: agent workspace, unzipped duplicate of the P4 kit
2026-10-23 feat(k230d): drop-triggered dual-camera capture line with auto YOLO boxes
    - drop_capture_dual.py: IDLE/ARM/FIRE/COOL trigger state machine on cam1
    chn0 ROI; both cams snap chn1 back-to-back then encode/write together
    (snapshot gap measured in us, reported in done.txt); multi-threshold
    auto box -> YOLO sidecar; stdev sharpness proxy -> blur.txt
    - trigger_exposure_probe.py: calibrates TRIG_DELTA (empty-scene frame
    diff), TRIG_STAT (drop-event peak sampling) and EXPOSURE_US ladder
    - capture_on_key.py / probes / factory image hashes: manual capture line
    from earlier sessions now under version control
    - host-side only (py_compile); none of this has run on the board yet
    [01-version-probe.py, 02-camera-preview.py, capture_on_key.py, drop_capture_dual.py, trigger_exposure_probe.py]
2026-10-23 feat(scripts): board crop builder and drop-capture review tool
    - build_board_crops.py: capture_on_key output -> 224x224 crops, split by
    physical bean so front/back never straddle train/val/test
    - review_drops.py: drop_NNN review sheets (cam pair side by side, auto
    box drawn, flags no_box/tiny/huge/edge/blur/missing_cam/unreadable ->
    summary.csv); tested on synthetic data only
2026-10-23 docs(hardware): H1/H2/H3 hackathon design packages and PDF exports
    - H3-P4 integrated print assembly (README, BOM, A3 sheets, paper
    templates), H3 printing jobs P1/P2/P3(Bambu five machines, sliced
    gcode + logs), H2 dual-cam concept, H1 single-cam baseline
    - config/hardware-hackathon-*.json: per-variant electrical baselines
    (candidates pending on-board verification, follow hardware-baseline)
    - output/pdf: assembly/hopper/gate/power PDF exports through 20261022
    Unzipped duplicate of the P4 kit directory is ignored (zip kept).
    [00-fit-tests.gcode.3mf, 01-upper-hopper.gcode.3mf, 02-adapter-and-cameras.gcode.3mf, 03-lower-collector.gcode.3mf, 04-servo-cradle.gcode.3mf, 04-servo-cradle.json, 05-limits-and-flag.gcode.3mf, BOM-delta.csv]
2026-10-24 增加豆子掉落抓取脚本并且更新测试结果到baseline文件
